IlyaBOT/LunarView3/Dumper-Lite/README.md

# Lunar Dumper

Отдельный минимальный проект **только для чтения NM27C512Q, 64 КиБ × 8, DIP-28**. Один лист A3 с обязательной обвязкой. Все цепи питаются от USB +5 В. Высокого напряжения и цепей программирования EPROM нет.

Откройте `NM27C512_Dumper_Lite.kicad_pro`, затем `NM27C512_Dumper_Lite.kicad_sch` или `NM27C512_Dumper_Lite.kicad_pcb`. Предпросмотр схемы — `NM27C512_Dumper_Lite.pdf`. Текущая сохранённая плата пользователя содержит 645 сегментов дорожек и 212 переходов. Проверка 12.10.2026 обнаруживает 2 неразведённые связи и 16 прежних предупреждений; переименование не изменило медные слои или геометрию. Подробный отчёт — `../validation/lunar-products-2026-10-12/dumper-drc.json`. Недостающие 3D-модели подключены непосредственно к основной плате. В 3D установлен квадратный SMD RGB 5050, альтернативный выводной RGB скрыт. [Предпросмотр](validation/Lite_With_3D.png). Для открытия проекта исходные файлы Stage 2 не нужны: локальные библиотеки и таблицы библиотек находятся в этой папке.

Новые материалы: [адаптер КР573РФ5](../Adapter-KR573RF5/README.md), [изготовление фоторезистом](../docs/PCB_Photoresist_RU.md), [источники 3D-моделей](../docs/3D_Models_RU.md). После пользовательских изменений актуальные диаметры и координаты переходов следует брать из текущей платы; перед домашним изготовлением проверяйте технологический образец. Координаты переходов и двухсторонних сквозных соединений — `validation/vias_for_hand_assembly.csv` и `validation/pth_two_sided_connections.csv`.

## Состав

| Обозначения | Назначение |
|---|---|
| U1 | ATmega328P-AU, TQFP-32 7×7 мм, шаг 0,8 мм |
| U2, U3 | Два 74HC595D, SOIC-16; адрес A0–A15 |
| U4 | CH340C, SOIC-16, внутренний генератор |
| U5 | Сокет NM27C512Q, DIP-28 600 mil, удлинённые площадки |
| J1 | MicroUSB-B, Molex 105017-0001 |
| J2 | AVR ISP, 2×3, шаг 2,54 мм |
| Y1, C11, C12 | Кварц 16 МГц, CL около 18 пФ; два конденсатора 22 пФ |
| R1, SW1, C13, D4 | RESET: 10 кОм, кнопка, 100 нФ от DTR#, BAT54WS ограничивает положительный выброс |
| R2, R3, R4 | 10 кОм: подтяжки CE#/OE# вверх и LATCH вниз |
| D1, R5–R7 | RGB: квадратный SMD KAAF-5050RGBS-13 или четырёхвыводной WP154A4SEJ3VBDZGW/CA; устанавливать один; по 1 кОм на цвет |
| D2, D3, Q1, Q2, R8–R11 | RX синий / TX оранжевый, буферы MMBT3906; база 10 кОм, LED 1 кОм |
| C1 | 10 мкФ / 10 В на USB +5 В |
| C2–C10 | По 100 нФ: CH340C VCC/V3, оба VCC и AVCC ATmega, AREF, два 595, EPROM |

Полный список с корпусами — `BOM.csv`. Резисторы и малые конденсаторы — 0603; C1 — 0805. USB VBUS подключён к +5 В напрямую, без отдельного предохранителя. Экран USB подключён к GND.

## GPIO ATmega328P-AU

| Сигнал | GPIO | Физический вывод TQFP-32 |
|---|---|---|
| ROM_D0…D5, только входы | PC0…PC5 | 23, 24, 25, 26, 27, 28 |
| ROM_D6 / D7, только входы | PD4 / PD5 | 2 / 9 |
| ROM_CE# / ROM_OE# | PD6 / PD7 | 10 / 11 |
| ADDR_LATCH | PB2 | 14 |
| ADDR_SER / MOSI | PB3 | 15 |
| ADDR_SCK / SCK | PB5 | 17 |
| ISP_MISO | PB4 | 16; используется только ISP |
| RGB: красный / зелёный / синий | PB0 / PB1 / PD2 | 12 / 13 / 32 |
| UART_RX / UART_TX | PD0 / PD1 | 30 / 31 |
| XTAL1 / XTAL2 | PB6 / PB7 | 7 / 8 |
| RESET | PC6 | 29 |
| VCC / AVCC | — | 4, 6 / 18; +5 В |
| GND / AREF | — | 3, 5, 21 / 20; AREF через C10 на GND |
| Не используются | PD3, ADC6, ADC7 | 1, 19, 22; явные NC |

## Адрес и данные

PB3 передаёт данные в SER U2; Q7S U2 подключён к SER U3. SRCLK обоих регистров подключён к PB5, RCLK — к PB2. SRCLR# подключён к +5 В, OE# — к GND. U2 Q0–Q7 формируют A0–A7; U3 Q0–Q7 — A8–A15. Сначала отправляется старший адресный байт U3, затем младший U2, в обоих случаях MSB first. После двух байтов нужен импульс LATCH.

RGB подключён к свободным выводам MCU, поэтому ему не нужен третий 595 и его состояние не зависит от обновления адреса. LOW включает цвет, HIGH выключает; при RESET выводы MCU высокоимпедансные, индикатор выключен. Предлагаемые значения для будущей прошивки: зелёный — чтение, жёлтый — ожидание, синий — ошибка. D1: логическая площадка 1 = R, 2 = общий анод +5 В, 3 = G, 4 = B. Комбинированный footprint содержит SMD 5050 и THT 5 мм места; **устанавливать только одно**. Физическая нумерация производителей отличается; подробности в [RGB_Mounting.md](../docs/RGB_Mounting.md).

RX/TX показывают фактические LOW-биты соответствующих UART-линий; при HIGH idle они выключены. Эмиттеры Q1/Q2 подключены к +5 В, базы — к UART через 10 кОм, коллекторы питают LED через 1 кОм. MMBT3906: B1/E2/C3. CH340C TXD, pin 2, подключён к MCU RX; CH340C RXD, pin 3, — к MCU TX.

Данные D0–D7 подключены к MCU напрямую, без буфера. Эта схема рассчитана на точный NM27C512: его даташит задаёт VOH не менее 3,5 В в режиме чтения. Для других 27xx нужно отдельно проверить распиновку, питание и логические уровни; совместимость по одному обозначению «27C512» не предполагается.

| DIP-28 | Сигнал | DIP-28 | Сигнал |
|---|---|---|---|
| 1 | A15 | 15 | D3 |
| 2 | A12 | 16 | D4 |
| 3 | A7 | 17 | D5 |
| 4 | A6 | 18 | D6 |
| 5 | A5 | 19 | D7 |
| 6 | A4 | 20 | CE/PGM# → ROM_CE# |
| 7 | A3 | 21 | A10 |
| 8 | A2 | 22 | OE/VPP → ROM_OE#, только логический OE |
| 9 | A1 | 23 | A11 |
| 10 | A0 | 24 | A9 |
| 11 | D0 | 25 | A8 |
| 12 | D1 | 26 | A13 |
| 13 | D2 | 27 | A14 |
| 14 | GND | 28 | +5 В |

CE# и OE# подтянуты к +5 В, поэтому в RESET/ISP EPROM не управляет шиной данных. LATCH подтянут к GND, чтобы тактирование SPI во время ISP не защёлкивало случайный адрес. При чтении прошивка должна держать D0–D7 входами, сначала выставить адрес, затем активировать CE#/OE#, дождаться доступа, считать байт и вернуть управляющие сигналы HIGH.

## ISP, RESET и питание

J2: **1 MISO / 2 +5 В / 3 SCK / 4 MOSI / 5 RESET / 6 GND**. Не подключайте два конкурирующих источника питания через USB и ISP. Для смены EPROM отключайте питание.

RESET подтянут к +5 В через 10 кОм, кнопка замыкает его на GND. CH340C DTR#, вывод 13, подключён через C13 100 нФ. D4: катод, площадка 1, на +5 В; анод, площадка 2, на RESET. AVCC обязательно подключён к +5 В, хотя ADC здесь не используется. CH340C не требует кварца 12 МГц; V3 подключён только к C3 100 нФ на GND.

Локальный символ `ProjectSymbols:CH340C_WCH` сохраняет подтверждённую нумерацию CH340C и исправляет обозначение функции pin 8 относительно установленной библиотеки KiCad. Pin 8 и другие неиспользуемые handshake-пины имеют NC. RGB D1 использует локальные символ `ProjectSymbols:RGB_CA_DualMount` и footprint `ProjectFootprints:RGB_CA_5050_or_THT5`; остальные посадочные места — из установленного KiCad.

## Проверка и воспроизводимость

KiCad **10.0.6**: ERC — **0 ошибок, 0 предупреждений**. Проверка экспортированного нетлиста и корпусов — **504 проверки пройдены**; всем 39 компонентам назначены существующие посадочные места с соответствующими номерами площадок. Одностраничный PDF просмотрен после окончательного экспорта.

Результаты ERC и проверки экспортированного нетлиста находятся в `validation/`. Команда `./validate.ps1` из этой папки автоматически находит установленный KiCad, выполняет ERC без пользовательских подавлений, экспортирует XML/PDF и проверяет соединения и соответствие выводов площадкам корпусов. Для повторной генерации из корня рабочего каталога: `python tools/generate_lite.py`; это перезапишет генерируемые файлы `Dumper-Lite/`, включая ручные правки схемы. Для текущей замены RGB регенерация не использовалась: остальные объекты сохранены.

Схема не испытывалась на собранной плате; чтение реального EPROM не проверялось. Для Lite теперь создана отдельная прошивка [firmware/lite](../firmware/lite/README.md), 115200 бод, `READ:<размер>`, и [WinForms-программа](../app-win_forms/README.md). Прежние файлы в корне `firmware/` относятся к Stage 2 и не подходят для Lite. Чтение реальной EPROM пока не проверено.

Первичные источники: [NM27C512 National, TL/D/10834](https://deramp.com/downloads/mfe_archive/050-Component%20Specifications/National%20Semiconductor/Memory%20Components/National%20NM27C512.pdf), [ATmega328P](https://ww1.microchip.com/downloads/aemDocuments/documents/MCU08/ProductDocuments/DataSheets/Atmel-7810-Automotive-Microcontrollers-ATmega328P_Datasheet.pdf), [CH340 WCH](https://cdn.sparkfun.com/assets/5/0/a/8/5/CH340DS1.PDF), [74HC595 Nexperia](https://assets.nexperia.com/documents/data-sheet/74HC_HCT595.pdf). Источники и монтаж двух новых RGB-корпусов: [RGB_Mounting.md](../docs/RGB_Mounting.md). Полная запись проверки источников сохранена в `../docs/sources.md`.

История размещения, 06.10.2026: на плате `NM27C512_Dumper_Lite.kicad_pcb` было выполнено размещение по предоставленному примеру: USB/CH340C и RX/TX слева, ATmega в центре, регистры перед сокетом справа, кварц/RESET и RGB снизу. Добавлены контур 90×60 мм со скруглением 2,5 мм и четыре отверстия 3,2 мм под M3. Все 39 электрических компонентов и идентификаторы/сети их площадок сохранены; добавлены только четыре механических footprint-объекта. У D1 по-прежнему два монтажных места с пометкой `ONE ONLY`. Пользователь затем изменил размещение и развёл плату.

Исторический DRC размещения: 0 нарушений / 0 расхождений и 134 неразведённые связи. [Вид размещения](validation/Placement_Top.png), [отчёт размещения](validation/PLACEMENT.md), `validation/drc_placement.json` и `validation/placement_audit.json`. Резервная копия платы перед размещением — в `validation/placement_backup/`; более ранние копии перед заменой RGB — в `../validation/rgb_upgrade_backup/`.

Текущая проверка 07.10.2026: **0 неразведённых связей**, 2 исключённых предупреждения (C3 отличается от библиотечной посадки, высота текста RGB) и 3 предупреждения сравнения со схемой из-за двух графических посадок без reference. Результат — `validation/drc_routed_2026-10-07.json`. После добавления 3D непосредственно к основной плате результаты DRC и геометрия сохранены; `../validation/3d_update_2026-10-07.json` подтверждает изменение только узлов моделей. Промежуточная копия до добавления моделей удалена при очистке 12.10.2026; две последние автоматические ZIP-копии KiCad сохранены. Собранное устройство не испытывалось.

Обновление 12.10.2026: текущая плата по проверке содержит 645 сегментов и 212 переходов, внешний габарит Edge.Cuts около 77,30×48,05 мм. Актуальные файлы для ЧПУ, расчёт K4-3W и координаты переходов — [docs/cnc-k4](../docs/cnc-k4/README.md). Числа выше с датой 07.10 относятся к предыдущему снимку.

DRC 12.10.2026: 2 незамкнутые связи между участками GND-полигона, 16 предупреждений; перед изготовлением нужна проверка этих участков. Отчёт `../validation/lite-software-2026-10-12/drc.json`. Исходный PCB при создании ПО/файлов ЧПУ не изменялся.
