IlyaBOT/LunarView3/docs/3D_Models_RU.md

# 3D-модели дампера — 07.10.2026

Добавлены модели недостающих физических деталей полной версии и Lite. В Lite остальные модели уже встроены в PCB как `kicad-embed://…`; их данные сохранены. Голые тестовые площадки, монтажные отверстия и графические логотипы не являются отдельными корпусными деталями и не требуют 3D-компонентов.

| Деталь | Файл | Источник / точность |
|---|---|---|
| MicroUSB Molex 105017-0001, J1 | `USB_Micro-B_Molex-105017-0001.step` | Модель именно этого номера из вклада lukh в [KiCad packages3D MR 566](https://gitlab.com/kicad/libraries/kicad-packages3D/-/merge_requests/566), commit `f7ff353b07291f4a78f9badf29abc5a1531e9952`. Вклад закрыт без включения в выпущенную библиотеку: модель не представляется штатной моделью текущего KiCad. Масштаб 1:1, исходное смещение/поворот нулевые; совмещение с площадками просмотрено. |
| Квадратный RGB 5050, Lite D1 / Stage 2 D2 | `LED_RGB_5050-6.step` | Модель шестиконтактного 5050 из установленного KiCad 10. Поворот модели 180° соответствует физическому расположению pin 1 у локальной посадки. Это типовой визуальный корпус, не точная заводская CAD-модель Kingbright KAAF. У модели ряд контактов ±1,7 мм, у выбранных производителем земель ±1,6 мм; модель не используется для проверки медных площадок. |
| Альтернативный RGB 5 мм, четыре вывода | `LED_D5.0mm-4_RGB.step` | KiCad 10, типовой выводной RGB. Смещение X = 6,595 мм совмещает первую ножку модели с первой физической THT-площадкой локального footprint. Модель отключена в текущем 3D-виде; монтажное место и его электрические соединения сохранены. |
| F1 в полной Stage 2 версии | `PPTC_1812_approx.wrl` | Созданный условный габаритный образ 1812, 4,5×3,2 мм, высота около 1,1 мм. Точная марка предохранителя в проекте не задана; высоту и другие механические размеры надо сверить после выбора детали. Не заводская модель. В Lite предохранителя нет. |

Новые файлы располагаются в `3DModels/` соответствующего проекта и подключены через `${KIPRJMOD}`, поэтому не зависят от отсутствовавшего USB-файла в системной библиотеке. Модели RGB и USB перенесены без изменения их исходной геометрии. Лицензия ветки-источника USB и стандартных моделей KiCad — **CC BY-SA 4.0 с исключением KiCad Libraries для электронных проектов**, текст сохранён рядом как `KiCad-LIBRARY-LICENSE.txt`. Для условных моделей указана их отдельная природа; они создаются локальными скриптами проекта.

## Переключение RGB

В 3D сейчас установлен **квадратный SMD 5050**, как выбрал пользователь. Чтобы посмотреть выводной вариант, откройте свойства D1 (Lite) или D2 (полная версия) → **3D Models**: выключите показ `LED_RGB_5050-6.step`, включите `LED_D5.0mm-4_RGB.step`. Установить на реальную плату нужно один LED из двух. Модели отображают сборку; электрическая нумерация и маркировка производителя описаны в `RGB_Mounting.md` каждого проекта.

## Сохранность платы

Изменения выполняются только в узлах `(model …)` сохранённых плат и локальной RGB-посадки. Дорожки, переходы, площадки, координаты компонентов, контур и пользовательская графика сравниваются как дерево KiCad до/после удаления узлов моделей. Отчёт — `validation/3d_update_2026-10-07.json`; промежуточные резервные копии до добавления моделей удалены при очистке 12.10.2026. В проектах оставлены две последние автоматические ZIP-копии KiCad.

Основной Lite обновлён после закрытия редактора: изменены только ссылки и параметры моделей, пользовательская разводка сохранена. [Предпросмотр Lite](../Dumper-Lite/validation/Lite_With_3D.png). Для продолжения работы используйте исходный проект в `Dumper-Lite/`.

Для адаптера RF5 стандартные DIP-24/TSSOP/0603 модели берутся из установленного KiCad. Его нижние круглые штыри показаны отдельной созданной габаритной моделью; размеры и конкретные контакты описаны в README адаптера.
