IlyaBOT/LunarView3/docs/RGB_Mounting.md

# RGB: два варианта монтажа на одной плате

В Stage 2 это узел **D2**, в `Dumper-Lite/` — **D1**. Один комбинированный footprint `ProjectFootprints:RGB_CA_5050_or_THT5` содержит оба набора площадок. **Устанавливать ровно один светодиод: SMD или выводной.**

| Вариант | Точный компонент | Корпус | Физическая распиновка производителя |
|---|---|---|---|
| SMD | Kingbright KAAF-5050RGBS-13 | Квадратный аналоговый RGB 5×5 мм, 6 площадок | 1=R катод, 2=G катод, 3=B катод; 4/5/6=аноды, все подключены к +5 В |
| Выводной | Kingbright WP154A4SEJ3VBDZGW/CA | RGB 5 мм, 4 вывода, общий анод | 1=R катод, 2=общий анод, 3=B катод, 4=G катод |

SMD выбран по [даташиту KAAF-5050RGBS-13, Rev.3B](https://www.kingbright.com/attachments/file/psearch/000/00/20160808bak/KAAF-5050RGBS-13%28Ver.3B%29.pdf): распиновка на стр.1, рекомендуемые площадки на стр.7. Выводной вариант проверен по [WP154A4SEJ3VBDZGW/CA, Rev.7A](https://www.kingbrightusa.com/images/catalog/SPEC/WP154A4SEJ3VBDZGW-CA.pdf), стр.1. Схемы соединений на этих страницах подтверждают полярность; порядок G/B у выводного компонента учтён отдельно.

## Как устроено посадочное место

Логические номера площадок KiCad сохраняют прежнюю распиновку RGB-узла: **1=R, 2=+5 В, 3=G, 4=B**. Номера физических ножек двух корпусов отличаются от этих логических номеров. На `F.Fab` нанесены метки `S1…S6` и `T1…T4` — это номера из даташитов. Точка на шелкографии отмечает SMD S1 справа внизу; скошенный угол самого SMD-корпуса должен быть слева внизу, у S6. Прямоугольная THT-площадка — T1, красный катод.

| Физическая площадка | Логическая площадка KiCad | Сеть |
|---|---|---|
| SMD S1 / THT T1 | 1 | RGB_R_K |
| SMD S2 / THT T4 | 3 | RGB_G_K |
| SMD S3 / THT T3 | 4 | RGB_B_K |
| SMD S4/S5/S6 / THT T2 | 2 | +5V |

SMD-площадки имеют размер 2,2×1,1 мм, межрядный шаг 1,6 мм и внутренний горизонтальный зазор 2,6 мм, по рекомендованному рисунку производителя. Для выводного варианта сделаны четыре отверстия 0,9 мм с шагом 1,27 мм. THT-площадки — 1,11×1,8 мм: минимальное кольцо меди 0,105 мм, зазор между соседними площадками 0,16 мм. Для этих четырёх площадок установлен локальный clearance 0,15 мм; изготовитель должен поддерживать такой зазор и кольцо. Размер сверления не уменьшался. Центры двух мест разнесены на 8,5 мм; площадки не перекрываются. На шелкографии указаны `SMD 5050`, `THT 5mm`, цвета выводов и `ONE ONLY`.

Общие резисторы по 1 кОм сохранены: Stage 2 R20–R22, Lite R5–R7. Аноды подключены к +5 В, LOW включает цвет. Выводы MCU, цепочка регистров, RGB-биты и прошивка управления цветами не меняются.

Нужно использовать именно аналоговые RGB с указанной полярностью и распиновкой. Светодиоды со встроенным контроллером, например WS2812/SK6812, к этим цепям не относятся. Суффикс **/CA** у выводного Kingbright важен: это выбранный вариант с общим анодом.

## Платы и проверка

При первоначальной замене RGB оба существующих файла `.kicad_pcb` были обновлены: D2/D1 заменён на комбинированное место, остальные footprints и их позиции сохранены. Более крупный RGB-узел смещён в ближайшее свободное место. Копии того этапа находятся в `../validation/rgb_upgrade_backup/`; отчёт `rgb_mount_audit.json` относится к состоянию до размещения Lite.

Затем на Lite выполнено размещение всех компонентов, добавлены контур 90×60 мм и четыре отверстия M3. Расположение полной платы Stage 2 сохранено. В обоих проектах исправлена ширина THT-площадок RGB и размер их шелкографических надписей. Проверка основной платы Lite: 0 нарушений DRC / 0 расхождений со схемой, 134 неразведённые связи. [Отчёт размещения](../Dumper-Lite/validation/PLACEMENT.md); копии до этих изменений — в `../Dumper-Lite/validation/placement_backup/`.

Платы до этого изменения не имели дорожек или контура, и полной разводки в этой задаче не выполнялось. **При разводке нужно физически подключить оба набора площадок ко всем четырём сетям, включая три SMD-анода +5 В.** Совпадающие логические номера площадок не заменяют медные дорожки между альтернативными местами. Соединения назначены всем десяти площадкам в обоих файлах платы.

KiCad 10.0.6 загрузил новую библиотеку и платы; ERC обеих схем — 0 ошибок / 0 предупреждений. Отдельная проверка `tools/audit_rgb_dual_mount.py` сверяет геометрию, полярность, сети площадок и сохранность всех остальных схемных/платных объектов. Проверки нетлистов и корпусов сохранены в соответствующих папках `validation/`.

Проектный символ `ProjectSymbols:RGB_CA_DualMount` использует тот же рисунок RGB и те же четыре логических вывода, что прежний индикатор. Сам footprint хранится в `ProjectFootprints.pretty/` каждого проекта и подключён через его `fp-lib-table`; глобальные библиотеки KiCad не изменялись.
