IlyaBOT/LunarView3/docs/cnc-k4/README.md

# Carverall K4-3W: подготовка Dumper Lite

Проверено 12.10.2026. Это расчёт и набор файлов для **пробной фотозасветки**, а не подтверждённый режим изготовления. Станок не подключался, фоторезист на 455 нм не испытывался.

## Характеристики и пределы достоверности

Пользователь указал K4-3W и 455 нм, [карточка Ozon](https://www.ozon.ru/product/carverall-k4-3w-mini-lazernyy-graver-dlya-dereva-kozhi-bumagi-tkan-dlya-podarkov-i-diy-3559348654/). Карточку станка получить не удалось: сайт возвращает цикл перенаправлений. Поэтому её параметры не выданы за проверенные.

В [официальной таблице Carverall](https://www.carverall.com/pages/machine-comparison) для K4Pro указаны диод 3 Вт / 450 нм, рабочее поле 80×80 мм и скорость 40 мм/с (2400 мм/мин). Официальная [страница продукта](https://www.carverall.com/products/carverall-k4pro-mini-laser-engraver) использует названия K4 и K4Pro. Это справочные данные близкой модели: точное совпадение ревизии с K4-3W из вашей покупки не доказано. Не переносите на неё автоматически максимальную скорость и параметры контроллера.

Для K4 производитель предлагает [CutLabX](https://www.carverall.com/pages/software). Размер оптического пятна, минимальная регулируемая мощность, частота/разрядность PWM, ускорение и прошивка именно вашего экземпляра не установлены. Рекламная «точность» не равна размеру пятна или воспроизводимому зазору после травления. Пятно надо измерять на проявленном пробнике в двух направлениях.

МФП-ВЩ негативный. [«Диазоний»](https://www.diazoniy.ru/fotorezist/) указывает для справочного материала МПФ-ВЩ диапазон 320–420 нм и энергию 150–180 мДж/см². **455 нм вне этого диапазона.** Энергия ниже рассчитана как падающая на поверхность, без неизвестного коэффициента фотохимической эффективности на 455 нм. Ни одна строка расчёта не доказывает отверждение вашего резиста. Сначала нужен успешный пробник после проявления и травления.

## Файлы именно текущей платы

Снимок `Dumper-Lite/NM27C512_Dumper_Lite.kicad_pcb`: SHA256 `1147f42970dd9abc639e3f89a14d58c3dbc842d9de7f9c65819ef65f327bd571`. Размер по внешней границе Edge.Cuts с учётом толщины линии: **77,30×48,05 мм**; 645 сегментов дорожек, 212 переходов. Минимальная дорожка 0,20 мм; 203 перехода имеют отверстие 0,30 мм и площадку 0,60 мм. Плата изменена пользователем после предыдущей проверки от 07.10, поэтому старые количества и координаты переходов применять нельзя.

- `Lite_F_Cu.svg`: верхний слой, чёрное = будущая медь.
- `Lite_B_Cu_mirrored.svg`: нижний слой, **уже отражён по горизонтали** для взгляда снизу после переворота вокруг вертикальной оси рисунка. Повторно отражать его не надо.
- `Lite_F_Cu_2540dpi.png` и `Lite_B_Cu_mirrored_2540dpi.png`: двуцветные растры 7730×4805 пикселей. Полотно обоих файлов одинаковое, 77,30×48,05 мм; 100 пикселей/мм. Все 255 проверенных центров электрических площадок на соответствующих слоях попали в чёрную медь. Это геометрическая проверка экспорта, не испытание станка.
- `Calibration_25x25.svg` / `Calibration_25x25_2540dpi.png`: пробник 25×25 мм. Сверху вниз четыре группы линий и зазоров: 0,20 / 0,25 / 0,30 / 0,40 мм. Слева горизонтальные, рядом вертикальные, справа площадка 0,60 мм и сплошной квадрат. Снизу ряд площадок с шагом 0,80 мм и ещё площадки 0,60 мм. Белый фон должен смыться, чёрные фигуры — остаться.
- `vias_for_hand_assembly.csv` и `pth_two_sided_connections.csv`: обновлённые координаты для этого снимка платы. Они абсолютные, как в KiCad, а не относительно угла PNG. Список контактов обеих сторон основан на концах дорожек и не заменяет проверку полигонов/доступа паяльником.
- `Preview_Top.png`: только просмотр, **не файл для записи рисунка**.

В SVG есть линии со stroke-width, которые некоторые CAM-программы превращают в тонкие осевые линии. Для заполнения через такую программу используйте готовые бинарные PNG. Не записывайте только контуры SVG: это не защитит площадь дорожек и полигонов.

В поле 80×80 мм рисунок 77,30×48,05 мм помещается с очень небольшим запасом по длинной стороне. Если реальное поле 80×75 мм, он тоже помещается в исходной ориентации. Для установки платы и фиксирующих штифтов проверьте физический доступ отдельно. Не уменьшайте изображение ради поля. При подтверждённом поле 80×80 мм можно повернуть **оба слоя одинаково на 90°**, чтобы растровые проходы шли вдоль короткой стороны и было больше места для разгона/выбега.

## DRC перед изготовлением

Проверка сохранённой платы 12.10.2026: **2 ошибки незамкнутого соединения между участками одного GND-полигона**, 16 предупреждений (15 изолированных заливок и один свободный конец GND-дорожки у X=71,425 / Y=84,750 мм). Соединений, отмеченных как незавершённые сигнальные дорожки, в этом отчёте нет. Полный результат: `validation/lite-software-2026-10-12/drc.json`.

Экспорт передаёт существующую геометрию, включая эти островки, и **не является утверждением «плата прошла DRC»**. До записи целой платы проверьте, какие островки должны соединяться с GND: соедините необходимые или исключите ненужные из заливки, выполните заполнение и DRC, затем заново экспортируйте слои. Наличие всей меди в PNG не доказывает связность. В этой задаче исходный PCB не изменён (контроль SHA256 совпал); файлы здесь — снимок для анализа и калибровки. Не используйте их после изменения разводки без повторного экспорта.

## Расчёт падающей энергии

Для равномерного заполнения с шагом строк `h`, скоростью `v` и средней оптической мощностью `P`:

`D [мДж/см²] ≈ 100 × P [мВт] / (v [мм/с] × h [мм])`.

Мощность условно считается линейной: `P = 3000 × процент / 100` мВт. Это допущение, пока мощность не измерена. На малом проценте лазер может вообще не включаться либо давать нелинейные импульсы. Поглощённая резистом энергия отличается от падающей.

При шаге **0,05 мм**, одном проходе:

| Скорость | Установленная мощность | Условная средняя мощность | Падающая доза |
|---|---:|---:|---:|
| 1000 мм/мин (16,67 мм/с) | 0,10% | 3 мВт | 360 мДж/см² |
| 1000 мм/мин | 0,25% | 7,5 мВт | 900 мДж/см² |
| 1000 мм/мин | 0,50% | 15 мВт | 1800 мДж/см² |
| 1000 мм/мин | 1,00% | 30 мВт | 3600 мДж/см² |
| 600 мм/мин (10 мм/с) | 0,10% | 3 мВт | 600 мДж/см² |
| 600 мм/мин | 0,25% | 7,5 мВт | 1500 мДж/см² |
| 600 мм/мин | 0,50% | 15 мВт | 3000 мДж/см² |
| 600 мм/мин | 1,00% | 30 мВт | 6000 мДж/см² |

Это **матрица эксперимента**, не восемь заведомо подходящих режимов. Для сопоставления: при 1000 мм/мин / 0,05 мм справочная УФ-доза 150–180 мДж/см² соответствовала бы всего 0,042–0,050% от 3 Вт. На 455 нм эти числа не являются рецептом. Полная мощность дала бы около 360 Дж/см², то есть в тысячи раз больше справочной УФ-дозы. Начинать с 100% и замедлять станок не следует.

Если контроллер имеет только 8-битный PWM, один ненулевой шаг — около 0,392%: строки 0,10% и 0,25% тогда могут быть недоступны. Изменение шкалы `S` или `$30` не добавляет аппаратных уровней. Не считайте показатель «1%» измерением света.

Калькулятор: `python docs/cnc-k4/laser_dose.py --power-w 3 --percent 0.1 --feed 1000 --pitch 0.05`. Он вычисляет только номинальную падающую дозу. При нескольких проходах энергия суммируется, но фотохимический результат и тепловые повреждения не обязаны меняться линейно.

## Порядок калибровки

1. Сначала подтвердите нанесение и проявление материала контрольным купоном через шаблон под прожектором 395 нм. Незасвеченный купон должен полностью очиститься. Без этих контролей нельзя понять причину неудачи лазера.
2. Проверьте поле/масштаб на безопасном тестовом материале с выключенным рабочим лазером при позиционировании. Для лазерной обработки меди нужен закрытый тракт: поверхность даёт опасные отражения. Подберите защиту по 455 нм и мощности; очки из комплекта без подтверждённых характеристик не считайте достаточными.
3. Нанесите резист на маленькие одинаковые купоны. Импортируйте пробник в масштабе **25×25 мм**, режим чёрно-белого заполнения: чёрное включает лазер, белое выключает. Без дизеринга, градаций серого, резки/обвода и второго автоматического прохода.
4. Начните с 1000 мм/мин, шага строк 0,05 мм и самого малого **реально регулируемого** уровня света. Строки 0,10 / 0,25 / 0,50 / 1,00% предназначены для разных купонов, если драйвер умеет их воспроизводить. Остановитесь при размягчении, пузырях, запахе разложения или прожоге. Вторая серия при 600 мм/мин нужна только если первая не повредила материал и недостаточная доза остаётся правдоподобной причиной.
5. Снимите верхний носитель, проявите по основной инструкции и протравите. Для принятия режима нужны сохранность линий 0,20 мм, открытые зазоры, сцепление с медью и отсутствие отверстий в рисунке. Изменение цвета без этих проверок не считается результатом.
6. Если минимальная аппаратная мощность уже повреждает плёнку либо ни один неповреждающий режим не закрепляет рисунок, **режим для этой пары лазер/резист не найден**. Не переходите к целой плате. Практический выход — источник подходящего спектра или материал с документированной чувствительностью на 455 нм; простое увеличение мощности не заменяет эту совместимость.

В CutLabX не переводите неизвестный ползунок «глубина» в мм/мин по догадке. Если программа не показывает физическую скорость и шаг строк, воспроизводимый расчёт по ней пока невозможен: нужны документация её режима или измерение параметров. Версия контроллера вашей покупки не подтверждена. Для **подтверждённого GRBL 1.1** режим `$32=1`, динамическая мощность `M4`, выключение `M5` и отсутствие света на холостом ходе описаны в [официальном руководстве GRBL](https://github.com/gnea/grbl/wiki/Grbl-v1.1-Laser-Mode). Эти команды не отправлялись вашему станку; для другой прошивки они могут не подойти.

## Перенос принятого режима на плату

Импортируйте PNG слоя как **77,30×48,05 мм**. Не принимайте автоматически размер «один пиксель = одна строка»: 2540 dpi описывает исходное изображение; выбранный шаг записи 0,05 мм соответствует 20 строкам/мм (508 dpi). Размер пятна и шаг записи проверяются отдельно от плотности исходного файла.

Будущая медь чёрная, включая всю площадь GND. Экспонируйте её заполнением, оставляйте белые промежутки незасвеченными. Отверстия в электрических площадках специально не вырезаны в рисунке, чтобы сохранить площадки при сверлении. Контур платы не включён как отдельная медная дорожка.

Оба слоя имеют одинаковое полотно и положение платы. Нижний уже отражён: переворачивайте заготовку вокруг оси, соответствующей вертикали исходных изображений. Для совмещения сделайте жёсткий упор и две технологические точки, проверьте на бумаге/пробнике контакты DIP и монтажные отверстия. При одинаковом повороте обоих файлов на 90° соответственно поверните и ось переворота в приспособлении. Во время обработки одной стороны закройте другую от случайного света. Не досвечивайте непроявленный рисунок целиком прожектором.

Поле плотно заполнено полигонами. При 1000 мм/мин и шаге 0,05 мм непрерывный растр всего прямоугольника требует примерно **74,3 минуты на сторону** без разгона, выбега и перемещений; фактически дольше. Эквивалентное время включённого лазера по чёрной площади составляет около 56,1 минуты сверху и 58,3 снизу. Это оценка геометрии, а не измеренная длительность задания. Выбег с каждой стороны должен быть не меньше `v²/(2a)` при ускорении `a`; без значения ускорения нельзя назначить его точный размер. Не используйте уменьшение масштаба для решения нехватки места.

После изготовления переходы требуют пайки с обеих сторон. Актуальные 212 переходов делают домашнюю сборку заметно трудоёмкой. Основная инструкция: [PCB_Photoresist_RU.md](../PCB_Photoresist_RU.md). Плата, адаптер, станок и прошивка на реальном комплекте ещё не испытаны.
