IlyaBOT/LunarView3/validation/lite-update-2026-10-12/REPORT.md

# Обновление Lite, 12.10.2026

## Результат

Пример ACE удалён из исходного и опубликованного каталога. Добавлены NM27C256 32768 байт и NM27C128 16384 байт; их VPP/PGM учитываются новым режимом PINS, объём не используется для неявного изменения адреса. В каталоге четыре записи. Документация изготовителей и ограничения: [rom_compatibility_lite.md](../../docs/rom_compatibility_lite.md).

Окно 1160×690, отступы 8 пикселей, внутренний заголовок и запрошенные лишние подписи удалены. HEX/ASCII сохраняются; во время чтения управление блокируется. Статус подключения, идентификатор устройства и ход операции показываются отдельно. [preview.png](../../app-win_forms/preview.png) — изображение реальной формы с явно обозначенными демонстрационными данными.

CON:START возвращает идентификатор и возможности Lite 2. При штатном отключении CON:STOP подтверждается до закрытия порта; при закрытии во время чтения отправляется STOP без ожидания ответа. Прошивка обрабатывает STOP во время HEX/CRC-передачи, отключает CE#/OE# и ждёт нового соединения. Неполный дамп не получает CRC. Если чтение ROM уже закончено и STOP приходит во время CRC, завершённая CRC-строка может предшествовать подтверждению STOP.

RGB: красный после RESET и STOP; янтарный в подключённом ожидании; чтение — зелёный 500 мс включён / 500 мс выключен. Для вопроса о цвете после STOP выбран красный, согласно состоянию «не подключено». Полный Stage 2 использует ту же логику: READ/VERIFY зелёный, WRITE фиолетовый. Изменения защёлки RGB выполняются с неактивными CE/OE/PGM и выключенным VPP; программирование и аппаратные защиты не включались. Полный протокол Stage 2 57600 сохранён, Windows Forms работает с Lite 2.

## Сборки и проверки

- dotnet Release и публикация приложения: успешно, без ошибок/предупреждений при сборке.
- MSBuild из Visual Studio 2022: EpromDumper.sln Release собран успешно.
- C# Core: 41 проверка — фрагментация CON/INFO, возврат полученного идентификатора, STOP, PINS, каталоги, ACK/HEX/CRC и имитированное чтение 1/2048/32768/65536 байт.
- UI: шесть элементов управления блокируются на операции; таблица доступна, неподтверждённый дамп сохранять нельзя.
- Нативный C: общий код размера, CRC, масок выводов и RGB, включая границы 499/500/999/1000 мс и переполнение счётчика времени.
- MSVC C++ /W4 /WX: 114719 проверок настоящего firmware/lite/main.c на имитации регистров. Проверены CON, запрет READ без соединения, actual GPIO RGB, все байты дампов 16/32/64 КиБ с CRC и адресными масками, STOP посреди HEX и CRC, отказ WRITE на Lite. Большая часть числа — отдельные проверки байтов дампа; это не физический тест.
- AVR-GCC 7.3.0 -Wall -Wextra -Werror: Lite Flash 2396 байт, статическая SRAM 93 байта (включает строковый буфер, не включает стек). Полный safe: Flash 4544 байта, SRAM 241 байт, HARDWARE_COMMISSIONED=0.
- Отдельная сборка с Rev. 7, Firmware 2.3.4, BuildId a8191hbz1 успешна. В ELF обеих сборок идентификатор найден в .text и отсутствует в .data; [identity.json](identity.json).
- SHA-256 Lite PCB остался прежним; трассировка не изменена. Хеши артефактов: [hashes.json](hashes.json).

Идентификатор итоговой Lite-сборки:

```text
CON:Lunar Dumper LITE (Rev. 1) | Firmware: v.1.0.0 (build 9e5241b8ac) 12.10.2026
```

## Повторение программных проверок

```powershell
dotnet run --project app-win_forms/Tests/EpromDumper.Tests.csproj -c Release
dotnet run --project app-win_forms/TestsUI/TestsUI.csproj -c Release
powershell -ExecutionPolicy Bypass -File firmware/lite/build.ps1
powershell -ExecutionPolicy Bypass -File firmware/build.ps1
```

Нативные исходники: tests/lite_protocol_native.c и tests/lite_firmware_host.cpp. Для C++ нужен include tests/avr_host, компиляция /EHsc /std:c++17. Заголовки tests/avr_host и объекты fake GPIO/UART предназначены только для теста на ПК, в AVR-сборку не входят.

## Граница проверки

COM-порт устройства не открывался, ISP/fuses не записывались. Тесты не моделируют электрические уровни, реальные времена UART/SPI/CPU и поведение физической EPROM/адаптера. CRC и программная модель не заменяют испытание собранной платы на известном содержимом ROM.
