IlyaBOT/LunarView3/validation/lunarview3-status-2026-10-12/REPORT.md

# LunarView 3 — версия 1.2, 12.10.2026

Нижняя панель заменена одной строкой высотой 22 пикселя: информация об устройстве, разделитель, статус. После отключения информация очищается. Полный текст устройства и ошибки доступен в подсказке. Ошибки чтения и CRC остаются видимыми после завершения операции и закрытия соединения. Статусы записи и стирания подготовлены для будущей версии программатора; эти операции не реализованы в LITE.

Размеры ROM и открытого файла отображаются как `65 536 байт (64КиБ/512КБит)`. Метаданные версии приложения обновлены до 1.2 (AssemblyVersion/FileVersion 1.2.0.0), окно «О программе» использует те же метаданные.

Проверки:

- VS2022 MSBuild Release с восстановлением зависимостей: успешно.
- Core tests: 62 проверки прошли, включая размер 64/32/2 КиБ и дробный размер.
- WinForms tests: 113 проверок прошли, включая чтение, сравнение, CRC, обрыв соединения, сохранение ошибки после разблокировки управления, статусы записи/стирания и состав нижней панели.
- Реальная форма отрисована размером 890×690; верхняя строка инструментов, 16 HEX-столбцов и ASCII помещаются без горизонтальной прокрутки. Скриншот: `../../app-win_forms/preview.png`, проверен визуально.
- Готовая сборка опубликована в `../../app-win_forms/release/`; пользовательский `rom-chips.list` сохранён без изменения байтов.

Поток устройства имитирован в тестах. Физический дампер и COM-порт в этом обновлении не проверялись. Прошивка и KiCad-платы не изменялись.
