IlyaBOT/LunarView3/docs/PCB_Photoresist_RU.md

# Изготовление платы Dumper Lite методом фоторезиста

Обновлено 12.10.2026 для текущей платы `Dumper-Lite/NM27C512_Dumper_Lite.kicad_pcb`, проверенной 12.10.2026. В ней два слоя меди, 645 сегментов дорожек и **212 переходных отверстий**. Минимальная ширина дорожки — 0,20 мм. **203 из 212 переходов** имеют отверстие 0,30 мм с площадкой 0,60 мм; остальные — 2 отверстия 0,65 мм, одно 0,80 мм и 6 отверстий 0,85 мм. Габарит по Edge.Cuts с толщиной линии — 77,30×48,05 мм. Перед домашним изготовлением нужен пробник с такой же геометрией. Числа и координаты от 07.10 относятся к прежней версии платы.

Ваш материал — **негативный плёночный МФП-ВЩ 200×1000 мм** из [указанной карточки Ozon](https://www.ozon.ru/product/fotorezist-plenochnyy-mfp-vshch-200h1000mm-negativnyy-m-2069010370/). Источники света: светодиодный УФ-прожектор **395 нм** и рассматриваемый для прямой записи лазер ЧПУ **455 нм**. Вы выбрали прямую запись лазером Carverall K4-3W. Расчёт, пробник и готовые слои текущей платы находятся в [cnc-k4/README.md](cnc-k4/README.md); совместимость резиста с 455 нм пока требует испытания. Контактная засветка 395 нм остаётся способом проверить нанесение/проявление на контрольном купоне.

В карточке диапазон указан неодинаково: 320–400 нм в таблице и 320–420 нм в описании процесса. Производитель «Диазоний» для материала МПФ-ВЩ указывает 320–420 нм; на его странице встречается также написание МФП-ВЩ. **395 нм входит во все эти диапазоны, 455 нм — за их пределами.** Производитель конкретно вашего рулона карточкой не установлен: данные «Диазония» используются как справочные, а не как подтверждение происхождения покупки. См. [первичный источник](https://www.diazoniy.ru/fotorezist/).

Облучённость платы, расстояние до прожектора и марка зелёной маски пока неизвестны. Поэтому точное время засветки и отверждения маски не назначено. Паяльная маска наносится после травления и проверки меди; она не заменяет фоторезист.

## 1. Что подготовить

- Двусторонний фольгированный стеклотекстолит, желательно с медью 35 мкм, толщиной, указанной в проекте платы. Одностороннюю заготовку нельзя использовать без переработки разводки.
- Фоторезист, подходящий проявитель и средство снятия фоторезиста. Не подменяйте проявитель произвольной щёлочью: кальцинированная сода и каустическая сода — разные вещества.
- Прозрачную плёнку **для конкретного типа принтера**, обезжириватель, безворсовые салфетки, мелкий неабразивный/слабоабразивный материал для очистки меди.
- Ламинатор либо способ нанесения, разрешённый изготовителем резиста, ровное прозрачное прижимное стекло, зажимы и плоскую подложку.
- Готовый травитель с инструкцией, отдельную неметаллическую ванночку, воду для промывки, отдельные ёмкости для отработанных растворов.
- Мини-дрель/сверлильную стойку, подходящие свёрла, лупу, мультиметр, паяльник, флюс и тонкую медную проволоку.
- Перчатки и защиту глаз; закрытый УФ-экспонирователь или непрозрачный экран. Не смотрите непосредственно на УФ-источник. Стеклотекстолит режьте и сверлите с удалением пыли. Ёмкости для химии не используйте для еды; медьсодержащий травитель собирайте отдельно, не сливайте в канализацию.

## 2. Проверить проект и распечатать фотошаблоны

Работайте с сохранённым файлом из `Dumper-Lite`, а не с полной Stage 2 платой в корне: у полной версии ещё нет законченного контура и разводки. Перед экспортом запустите DRC и проверьте неразведённые цепи. Проверка 12.10.2026 нашла 2 незамкнутые связи между участками GND-полигона и 16 предупреждений (изолированные заливки и свободный конец GND-дорожки). До изготовления проверьте эти участки, заполните зоны и повторите DRC. Отчёт: `validation/lite-software-2026-10-12/drc.json`; описание в [cnc-k4](cnc-k4/README.md).

В KiCad откройте **File → Plot**. Выведите `F.Cu` и `B.Cu` отдельными файлами SVG или PDF, с масштабом **1:1**, без рамки/основной надписи и без шелкографии. Контур `Edge.Cuts` можно добавить как ориентир, но он не должен превращаться в замкнутое медное кольцо на рабочем фотошаблоне. Для ручного сверления удобны небольшие метки центров отверстий; большой белый круг сверления на шаблоне уменьшает медную площадку. Отдельно выведите карту сверления и `F.Mask` / `B.Mask`, если ваша маска поддерживает проявление через шаблон.

В редакторе печати отключите «вписать в страницу», поля, колонтитулы, автоматическое масштабирование и экономию тонера. SVG сначала откройте в программе, сохраняющей физические миллиметры. PNG/JPEG или снимок экрана не являются точным фотошаблоном. Напечатайте калибровочный отрезок 50 мм и проверьте линейкой. Между рядами контактов EPROM должно быть 15,24 мм, шаг вдоль ряда — 2,54 мм. Проверьте масштаб по обеим осям после полного высыхания плёнки.

### Полярность

| Материал | Что происходит после засветки | Изображение для сохранения дорожек |
|---|---|---|
| Негативный плёночный резист | Засвеченное остаётся после проявления | Дорожки и площадки **прозрачные**, вытравливаемые области **чёрные** |
| Позитивный резист | Засвеченное удаляется проявителем | Дорожки и площадки **чёрные**, вытравливаемые области **прозрачные** |

Для **печатного фотошаблона** обычный чёрный рисунок дорожек из KiCad нужно инвертировать для негативной плёнки. Инвертируйте только рабочую область шаблона, сохраняя понятные метки совмещения вне контура. Проверьте полярность на пробном кусочке: после проявления защитный рисунок должен покрывать именно будущую медь.

### Зеркальность и совмещение двух сторон

Краска/тонер должны находиться **ближе всего к фоторезисту**, чтобы толщина прозрачной плёнки не размывала края. Это требование определяет зеркальность печати. Нельзя универсально поставить галочку «зеркально» на обоих слоях: она зависит от того, в каком виде экспортирована нижняя сторона и как вы переворачиваете плёнку.

1. Подпишите вне платы `TOP` и `BOTTOM`, отметьте положение первого вывода EPROM и USB-разъёма.
2. На бумажном пробнике приложите детали либо их посадки, повернув шаблон печатной стороной к предполагаемой меди. Сверьте положение pin 1 и асимметричных площадок. Нижний рисунок проверяйте, перевернув плату как реальный предмет.
3. Сложите два прозрачных шаблона в «конверт», печатными сторонами внутрь. Совместите **отверстия сквозных площадок**, все четыре монтажных отверстия и контур на просвет. Закрепите два края скотчем вне рабочей области.
4. Если нужна фиксация штифтами, сделайте два технологических отверстия вне конечного контура платы. Сначала проверьте их на бумаге; не используйте произвольные отверстия внутри схемы.

## 3. Какой принтер использовать

**Струйный:** используйте плёнку с покрытием для струйной печати, печатайте на её принимающей стороне. Выберите максимальное качество и режим материала, который даёт ровный непрозрачный чёрный слой; отключите экономичный режим. Высушите полностью. Обычная гладкая лазерная плёнка может не удерживать чернила.

**Лазерный:** используйте только термостойкую плёнку для лазерного принтера. Струйная плёнка может повредить печку. Отключите экономию тонера, выберите высокую плотность чёрного и разрешение. Проверьте, не изменил ли нагрев размеры изображения.

Для обоих вариантов посмотрите чёрные области на просвет через лупу: нужны плотность без точечных просветов и чёткие края 0,20 мм. Проверьте фактическое пропускание на УФ-пробнике, поскольку видимая чернота сама по себе этого не доказывает. Два совмещённых отпечатка допустимы только после проверки: они повышают плотность, но добавляют зазор и риск смещения мелких элементов. Сначала попробуйте один качественный отпечаток каждым принтером и выберите по результату проявления/травления.

## 4. Подготовить медь и нанести резист

1. Вырежьте заготовку с запасом по краям для совмещения. Уберите заусенцы: они мешают плотному прижиму и повреждают резист.
2. Очистите обе стороны до ровной поверхности без глубоких царапин. Обезжирьте, промойте и высушите. После этого берите за края, не касаясь меди пальцами.
3. Работайте при освещении, разрешённом для резиста, без солнца и УФ.
4. У МФП-ВЩ снимите нижнюю полиэтиленовую разделительную плёнку, приложите активный слой к меди без пузырей и прогрейте по инструкции к рулону. Верхнюю полиэфирную плёнку оставьте для экспонирования и снимите перед проявлением. Для справочного материала «Диазония» толщины слоёв: резист 50 мкм, верхний полиэфир 20 мкм, нижний полиэтилен 35 мкм.
5. Нанесите резист на вторую сторону, удалите пузыри и дайте заготовке остыть до температуры шаблонов. Не продолжайте с пузырями над дорожками или площадками.

Продавец в карточке рекомендует после нанесения прогреть всю поверхность резиста до **110 °C**, но не задаёт длительность и скорость прокатки. Это температура поверхности, а не универсальная настройка любого ламинатора. Сначала проверьте нанесение на маленьком образце; время нагрева без инструкции не назначайте. Не пытайтесь получить эту температуру увеличением мощности лазера.

Для готового позитивного текстолита ламинирование пропускается; защитную плёнку снимают по его инструкции. Жидкий позитивный резист требует собственной процедуры нанесения и сушки.

## 5. Засветка вашим прожектором и проверка лазера

### 5.1. Выбор источника

| Источник | Что известно для этого материала | Практический выбор |
|---|---|---|
| Прожектор 395 нм | Длина волны внутри диапазонов, указанных продавцом и «Диазонием» | Контактная засветка через печатный шаблон после подбора дозы |
| Лазер ЧПУ 455 нм | Вне заявленных диапазонов; чувствительность на 455 нм не подтверждена | Только эксперимент на пробнике, до изготовления платы |

Отсутствие 455 нм в диапазоне не доказывает абсолютно нулевую чувствительность. Однако рассчитывать на такую запись нельзя без проверки: повышение мощности не меняет длину волны и может нагреть или повредить плёнку раньше, чем получится стойкий рисунок. УФ-источник для стирания EPROM около 254 нм также не заменяет подходящий экспонирователь.

### 5.2. Как определить время для 395 нм

На странице «Диазония» приведена энергия экспонирования **150–180 мДж/см²**. Указанные там и в карточке секунды относятся к условиям испытания источника; это **не готовое время для вашего прожектора**. Паспортная электрическая мощность лампы не сообщает, сколько света достигает каждого квадратного сантиметра платы.

Если есть подходящий радиометр, измерьте облучённость в плоскости платы с учётом стекла и прозрачных материалов. Оценка времени:

`t [с] = D [мДж/см²] / I [мВт/см²]`.

Например, для справочной дозы 150–180 мДж/см² при 1 мВт/см² получается 150–180 с, а при 5 мВт/см² — 30–36 с. Это примеры расчёта, **не измерение вашего источника и не гарантированный режим на 395 нм**: спектр и условия заводской оценки могут отличаться. Обычный люксметр для видимого света не заменяет УФ-радиометр.

Без измерителя подбирайте время ступенчатым пробником при постоянном расстоянии и одинаковом прижиме. Начальный диапазон возьмите из инструкции к рулону для сопоставимого источника, если она есть. Если нет, исследуйте времена в отношении 1 : 2 : 4 : 8 и сдвигайте диапазон по результату проявления. Абсолютное время без данных о прожекторе здесь не назначается. Запишите расстояние, время, стекло, тип печатной плёнки и режим проявления.

### 5.3. Пробник, который должен пройти до изготовления платы

1. Сделайте рисунок с дорожками **и зазорами** 0,20 / 0,25 / 0,30 / 0,40 мм, площадками SMD и площадками переходов диаметром 0,60 мм. Добавьте полностью прозрачный и полностью чёрный участки шаблона для проверки засветки и её блокировки.
2. Нанесите плёнку из того же рулона тем же способом, что на плату. Разные дозы задавайте на отдельных участках или купонах; сохраняйте расстояние, прижим и режим проявления.
3. Проявите **и протравите** пробник. Выберите режим, при котором дорожки держатся, зазоры полностью открыты, а площадки сохраняют размер. Цвет плёнки после засветки сам по себе ничего не подтверждает.
4. Проверьте выбранное время также в центре и у краёв освещаемой площади: прожектор может давать неравномерную засветку. В случае неудачи меняйте по одному параметру — сначала дозу, затем прижим/непрозрачность или проявление.

Продавец заявляет получение дорожек и зазоров **0,24 мм** при хорошем шаблоне и свете. Это не подтверждает воспроизведение ваших дорожек 0,20 мм. Заводской справочный параметр минимального расстояния 120 мкм также не гарантирует домашний результат. **Не переходите к целой плате, пока пробник 0,20 мм не выдержит проявление и травление.** Затем проверьте сверление площадки 0,60 мм сверлом 0,30 мм.

При недодержке негативные дорожки смываются. При лишней дозе, засветке через неплотный чёрный слой или плохом контакте зазоры могут зарасти. Если ни одно время не даёт чистого рисунка, сначала исправьте контакт/шаблон и нанесение; увеличение времени не исправляет все дефекты.

### 5.4. Если испытывать прямую запись лазером 455 нм

Сначала получите рабочий контрольный образец с прожектором 395 нм. Сравнивайте лазерные купоны с ним и с незасвеченным купоном, используя один рулон и одинаковый проявитель: так можно отличить неподходящую длину волны от проблем нанесения или химии.

- Сделайте небольшую матрицу режимов мощности и скорости. Записывайте параметры; проценты мощности без модели лазера и фактической оптической мощности не переводятся в дозу. Начинайте с режима без заметного нагрева/повреждения; не повышайте мощность вслепую ради изменения цвета.
- У негативного резиста лазер должен засветить **всю будущую медь**: дорожки, площадки и всю площадь GND-полигонов. Простого обвода контуров недостаточно. На вытравливаемых промежутках и холостых перемещениях лазер должен быть выключен. Полярность цвета в программе задайте по этому правилу; инверсия печатного шаблона не является универсальной командой для ЧПУ.
- Используйте геометрию 1:1 из векторных файлов слоёв, без скриншотов, фотографического растра и дизеринга. Проверьте реальные 2,54 мм между контактами и обе оси масштаба. Сплошные полигоны требуют заполнения площади и могут сильно увеличить время записи.
- Проверьте фактическую ширину экспонированной линии, фокус в плоскости резиста под верхней плёнкой, люфт станка и шаг заполнения. Размер светового пятна не равен автоматически ширине получившейся дорожки. Подберите перекрытие проходов на пробнике, не допуская пропусков и зарастания зазоров.
- Критерий успеха — устойчивый рисунок после **проявления и травления**, с открытыми зазорами и без отслоения. Прожжённая, вспененная или потемневшая плёнка не считается успешной фотозасветкой.
- Для второй стороны нужны повторяемый переворот, две метки/технологические штифты и проверка pin 1. Сначала проверьте совмещение на бумажном макете и пробнике.

**Не досвечивайте всю ещё не проявленную плату прожектором после лазера:** у негативного материала это закрепит фон, который должен смыться. Любое окончательное отверждение после проявления выполняется только по инструкции к материалу.

Медь отражает лазерный свет. Работайте с закрытым оптическим трактом; защита глаз должна соответствовать 455 нм и мощности лазера, обычные затемнённые очки не подходят. Принципы защиты от прямого и отражённого луча приведены в [материале OSHA по лазерной безопасности](https://www.osha.gov/enforcement/directives/std-01-05-001).

### 5.5. Засветка двух сторон

После успешного пробника экспонируйте стороны платы в закреплённом конверте либо по проверенной системе фиксации ЧПУ. При засветке одной стороны закрывайте другую непрозрачным материалом от света и отражений. При перевороте сохраняйте совмещение. Для контактного способа плотно прижимайте печатную сторону шаблона к верхней плёнке резиста.

## 6. Проявить, проверить и протравить

1. Перед проявлением МФП-ВЩ снимите верхнюю полиэфирную плёнку. Для купленного материала продавец указывает **1% раствор кальцинированной соды, Na₂CO₃**. Для безводного порошка практический ориентир — 10 г на 1 л готового раствора (приблизительно 1%); не переносите эту массу на кристаллогидрат без пересчёта. Пищевая сода NaHCO₃ и каустическая сода NaOH не являются заменами. «Крот» и другие средства для труб не используйте как проявитель. Температура и длительность в карточке не заданы — проверяйте их по инструкции к рулону и на пробнике.
2. Проявляйте с мягким движением раствора. Остановитесь, когда открытые участки меди полностью очищены, а защищённые дорожки сохраняются. Тонкая невидимая плёнка в зазорах мешает травлению.
3. Промойте обе стороны, осмотрите через лупу. Исправляйте только локальные дефекты совместимым травостойким средством. При неверной полярности, широких смещениях или массовых дефектах снимите резист и повторите нанесение.
4. Для этого материала продавец рекомендует хлорное железо; для первого опыта используйте готовый травитель на его основе по инструкции к раствору. Не подменяйте этот режим случайной смесью перекиси и кислоты. Травите обе стороны по инструкции к травителю. Поддерживайте разрешённую температуру и мягкое перемешивание. Следите за узкими зазорами и не оставляйте плату в растворе после удаления ненужной меди: боковой подтрав съедает тонкие дорожки.
5. Промойте, снимите резист предназначенным для него средством, снова промойте и высушите. Не переносите режим снятия одной марки на другую.

## 7. Сверление и проволочные переходы

**Да, тонкую медную проволоку можно использовать вместо металлизации переходных отверстий.** Каждое такое соединение нужно припаять **к верхней и нижней площадке**. Проволока должна быть голой либо лужёной. У эмалированной проволоки предварительно снимите изоляцию в местах пайки и проверьте лужение; одной надежды на обгорание эмали недостаточно.

| Отверстие в проекте | Практический ориентир |
|---|---|
| 0,30 мм, площадка 0,60 мм | Проволока около 0,15–0,20 мм, точное сверление 0,30 мм. Это наиболее трудные переходы; сначала проверьте пробник. |
| 0,65 / 0,80 / 0,85 мм | Часто удобна проволока 0,30–0,50 мм, свободно проходящая через отверстие. Выбирайте по измеренному диаметру и доступу для пайки. |

**Не рассверливайте отверстие 0,30 мм до 0,60–0,80 мм на исходной площадке 0,60 мм:** медного кольца не останется. Для увеличения отверстия надо увеличить площадку, проверить соседние дорожки и заново выполнить DRC в отдельной копии платы. Сохранённая разводка в этом задании не изменялась.

Сверлите после травления, до маски и монтажа. Центруйте сверло по меткам, используйте стойку и ровную подложку. Проверьте совмещение слоёв по сохранности колец с обеих сторон. Припаяйте проволоку с первой стороны, затем со второй, обрежьте выступы и оставьте низкие гладкие швы. Не вытягивайте уже припаянную проволоку: можно оторвать площадку. Прозвоните каждый переход.

Переходы под микросхемами и другими корпусами выполняйте **до установки этих деталей**, с минимальными выступами. Толстая капля припоя может поднять SMD-корпус или замкнуть его выводы. Список координат переходов находится рядом с платой: `docs/cnc-k4/vias_for_hand_assembly.csv`. Координаты абсолютные, в миллиметрах, как в KiCad; столбец возможных пересечений с посадками служит подсказкой для ручной проверки по Fab-слоям.

### Сквозные выводы деталей тоже могут соединять слои

Без заводской металлизации вывод DIP-панельки, ISP, кнопки или кварца соединяет слои только после пайки к обоим кольцам. Пайка снизу не соединяет верхнюю дорожку автоматически. Проверьте такие места по `docs/cnc-k4/pth_two_sided_connections.csv` и непосредственно в KiCad.

Под тесно прилегающей панелькой верхнее кольцо часто недоступно паяльнику. Продумайте это **до монтажа**: примените подходящие металлизационные заклёпки, панельку с доступом к верхним контактам/небольшим подъёмом либо заранее предусмотренные проволочные соединения соответствующих цепей. Простой провод в отверстии, которое затем занято выводом панельки, не всегда помещается и мешает посадке. Проверяйте реальную сборку на образце.

Для RGB выбран SMD 5050. Неиспользованные четыре THT-площадки можно оставить без LED, но если ваша разводка использует их как переходы между слоями, эти электрические переходы всё равно надо выполнить. Не сверлите/не удаляйте их автоматически. У THT RGB отверстия 0,90 мм и очень узкое медное кольцо по короткой стороне площадки — около 0,105 мм; точность сверления здесь особенно важна.

## 8. Проверка меди до маски

Осмотрите все дорожки и площадки под лупой. Мультиметром проверьте целостность цепей по схеме, каждый проволочный переход и отсутствие соединений между соседними дорожками. Уберите медные иголки, мостики и металлическую стружку. Маска скроет дефекты и усложнит ремонт, поэтому наносите её только после этой проверки.

## 9. Зелёная жидкая паяльная маска

Сначала определите её тип по этикетке. УФ-отверждаемая ремонтная маска, фотопроявляемая LPI-маска и термоотверждаемая маска имеют разные процессы. Нельзя считать любую зелёную жидкость материалом для фотошаблона.

- **Маска для локального УФ-отверждения без проявления:** наносите тонко на промежутки/дорожки, оставляя паяемые площадки открытыми. Остатки до засветки убирайте средством, указанным производителем. Не покрывайте всю плату в надежде затем проявить площадки.
- **Фотопроявляемая маска:** следуйте её порядку нанесения, предварительной сушки, экспонирования, проявления и окончательного отверждения. Используйте отдельные шаблоны по `F.Mask` и `B.Mask`, с правильной полярностью для этой марки. Медь и паяльная маска требуют разных шаблонов.

Не покрывайте контакты USB, ISP, DIP-панельки, SMD-площадки и точки будущего ремонта. Для самодельных переходов оставьте доступ до завершения прозвонки; затем их можно закрыть совместимой маской. Если изготовитель разрешает прижимную плёнку для выравнивания, применяйте подходящую прозрачную плёнку и прокладку, не сдвигая отверстия шаблона. Полностью отверждённый пробный слой должен сохраняться при пайке и очистке разрешённым средством. Дозу/время отверждения нельзя назначить без марки маски и параметров лампы.

## 10. Монтаж и первое включение

Сначала выполните переходы и труднодоступные двухсторонние соединения, затем SMD, проверьте питание и только после этого ставьте панельки/крупные детали. Для двухслойной домашней платы этот порядок важнее обычного правила «сначала низкие детали».

Без EPROM проверьте отсутствие замыкания +5V–GND, полярность питания, RESET и правильность ориентации корпусов. Первое питание подайте от источника с ограничением тока, соблюдая имеющуюся в схеме развязку USB-питания; не соединяйте параллельно два независимых источника. Проверьте 5 В и отсутствие нагрева. Прошейте ATmega через ISP, затем проверьте USB/UART. EPROM вставляйте при выключенном питании. Адаптер КР573РФ5 использует только чтение на 5 В.

## Источники и границы инструкции

Параметры конкретной покупки взяты из [карточки продавца МФП-ВЩ, артикул 2069010370](https://www.ozon.ru/product/fotorezist-plenochnyy-mfp-vshch-200h1000mm-negativnyy-m-2069010370/), прочитанной 08.10.2026. Справочные характеристики материала МПФ-ВЩ: [«Диазоний», производитель сухого плёночного фоторезиста](https://www.diazoniy.ru/fotorezist/). Написания МФП/МПФ и диапазоны в источниках отличаются; состав и производитель вашего рулона отдельно не подтверждены. Чувствительность на 455 нм источниками не установлена.

Процедура адаптирована к проверенной геометрии проекта от 12.10.2026. Общие принципы качества контакта фотошаблона, соответствия УФ-источника материалу и подбора экспозиции описаны в [DuPont Riston General Processing Guide](https://www.dupont.com/content/dam/electronics/amer/us/en/electronics/public/documents/en/DEC-Riston_GeneralProcessingGuide.pdf). Это промышленный материал; его численные режимы не перенесены на ваш рулон МФП-ВЩ. Отличия позитивного процесса показаны в [MG Chemicals PCB Prototyping](https://mgchemicals.com/downloads/pdf/proto-letter-v4.pdf). Настройки вывода слоёв и масштаба: [руководство KiCad 10, PCB Editor](https://docs.kicad.org/10.0/en/pcbnew/pcbnew.html).

Это технологическая инструкция, а не подтверждение изготовления: пробник, ручная металлизация и собранный дампер ещё не испытаны. Если ваш пробник не воспроизводит дорожки/зазоры 0,20 мм и отверстия 0,30 мм, исходную плату нужно заказать с металлизацией либо подготовить отдельный вариант под более грубый домашний процесс.
