IlyaBOT/LunarView3/Adapter-KR573RF5/validation/Schematic.png

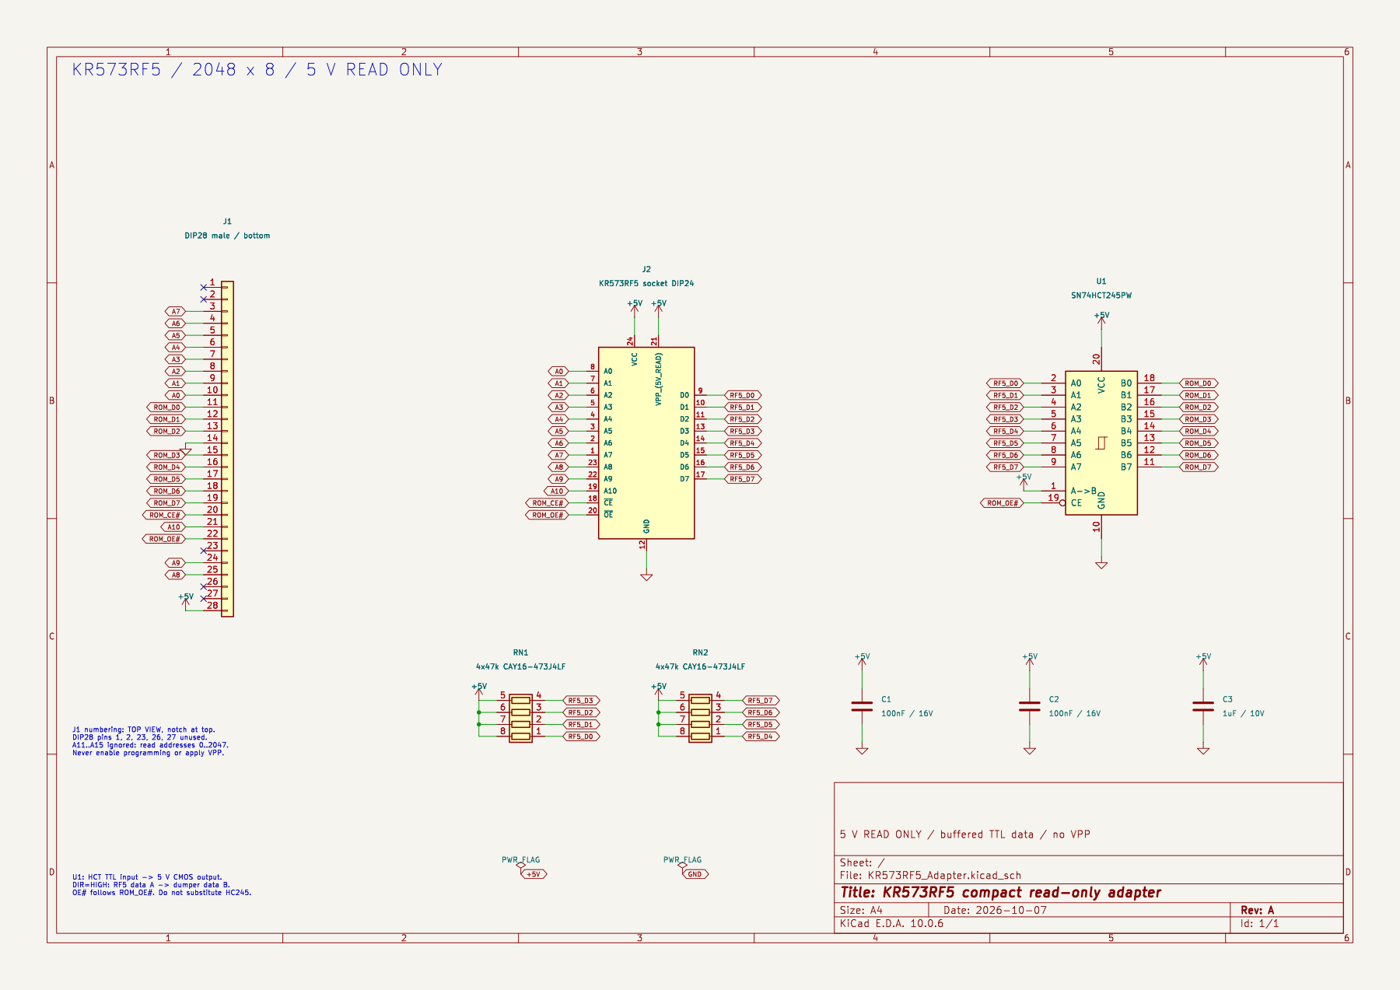
Adapter-KR573RF5/validation/Schematic.png
