IlyaBOT/LunarView3/app-win_forms/about-preview.png

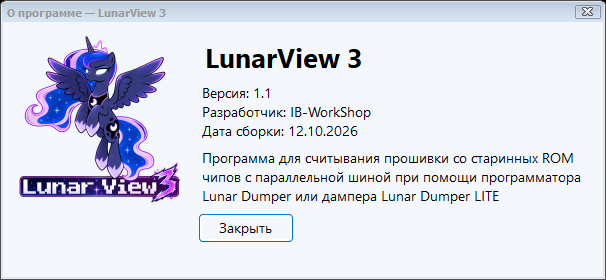
app-win_forms/about-preview.png
