IlyaBOT/LunarView3/app-win_forms/preview.png

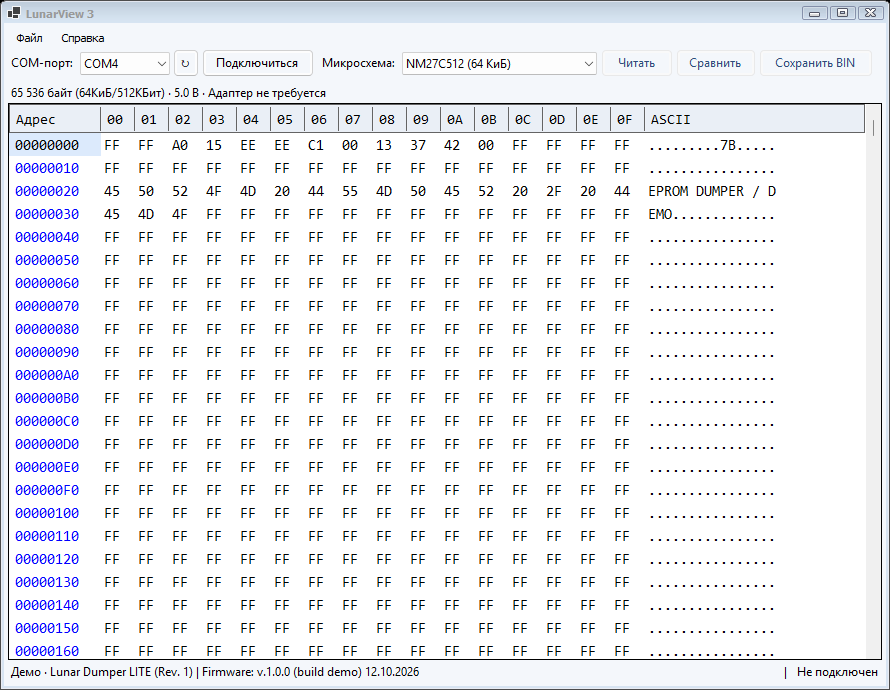
app-win_forms/preview.png
