IlyaBOT/LunarView3/docs/cnc-k4/Lite_B_Cu_mirrored_2540dpi.png

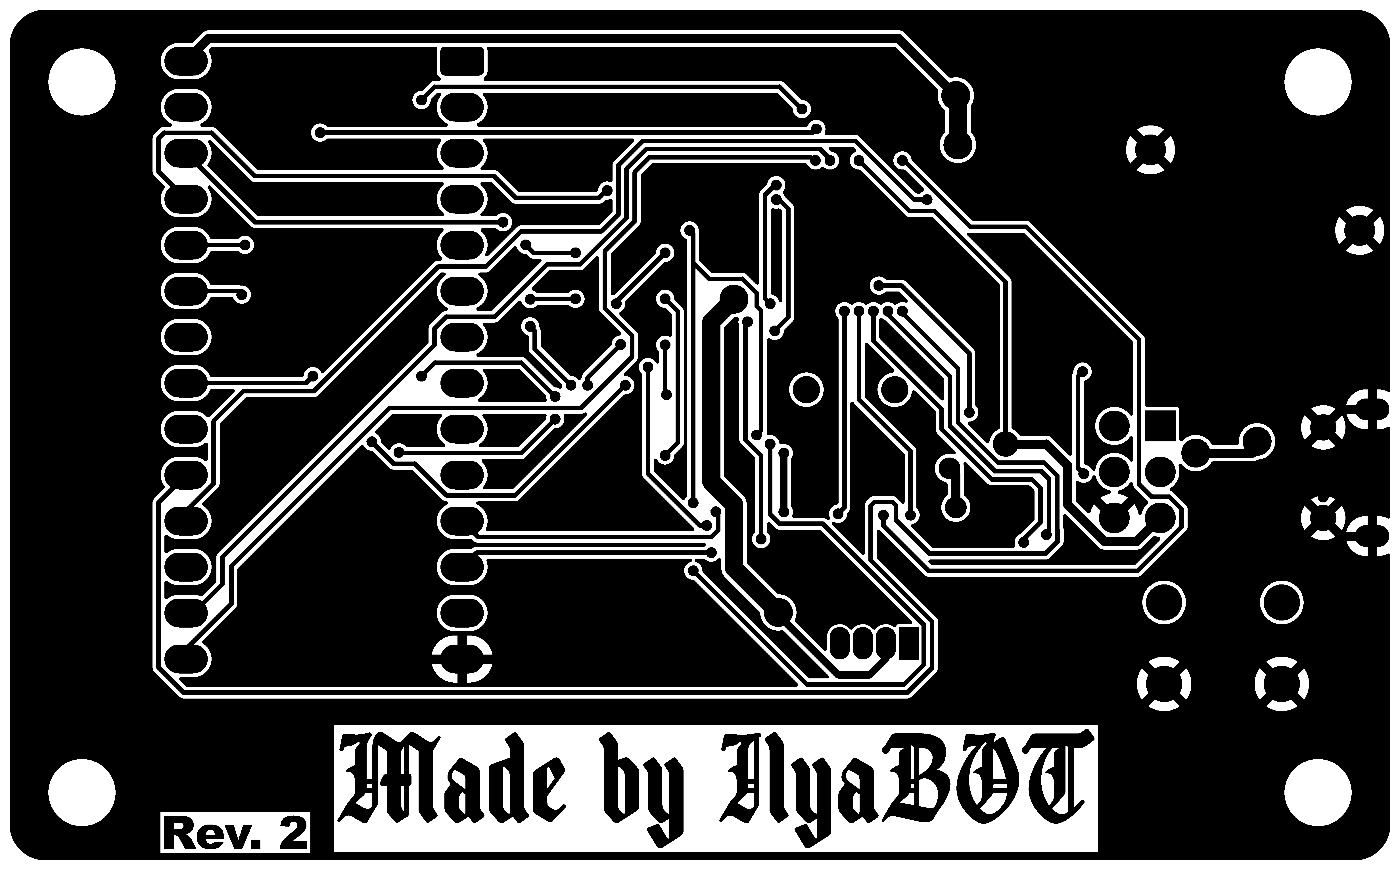
docs/cnc-k4/Lite_B_Cu_mirrored_2540dpi.png
