IlyaBOT/LunarView3/docs/cnc-k4/Lite_F_Cu_2540dpi.png

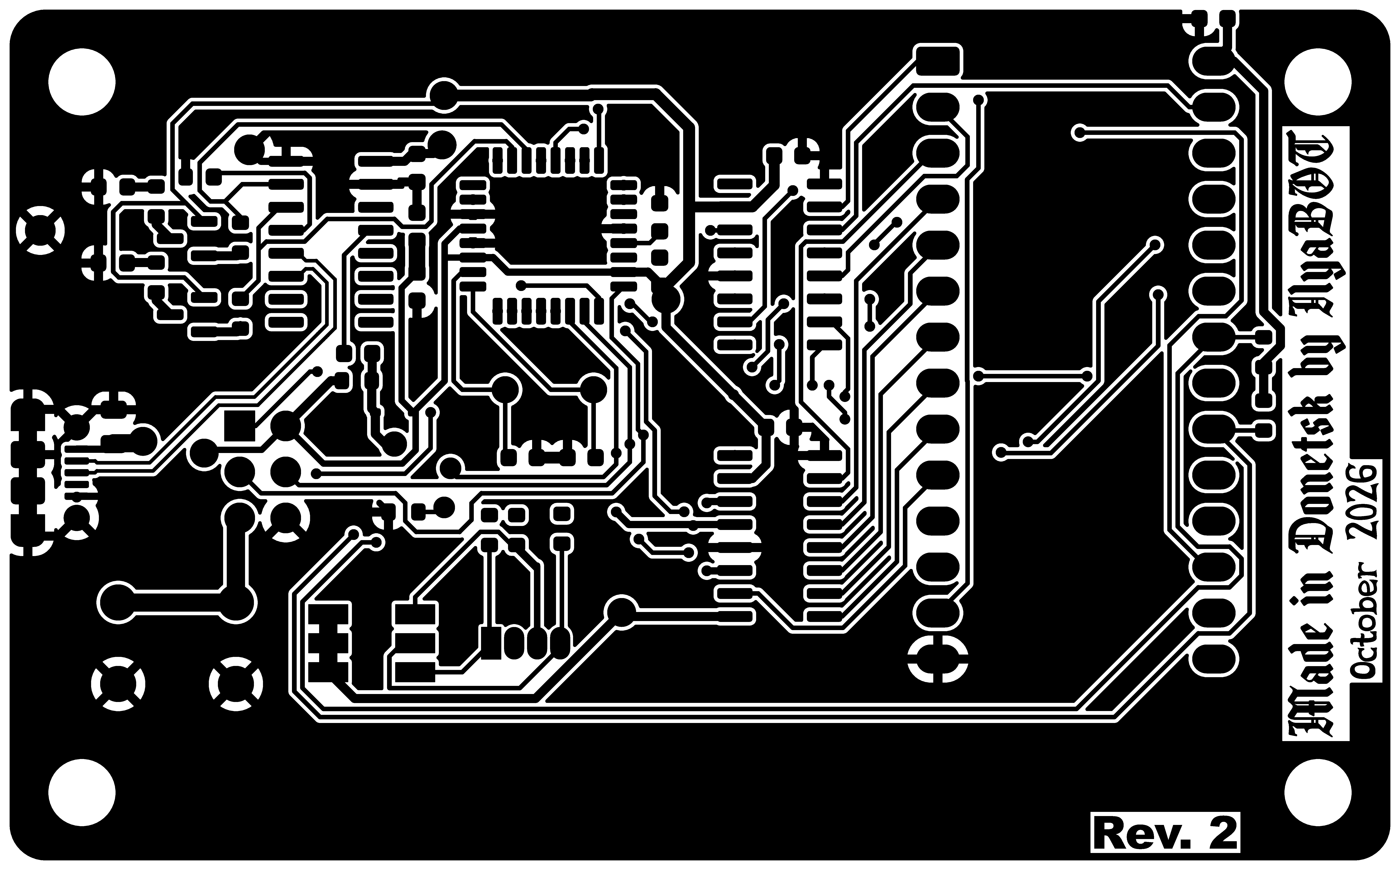
docs/cnc-k4/Lite_F_Cu_2540dpi.png
