IlyaBOT/LunarView3/Lunar-Writer/validation/schematic-overview.png

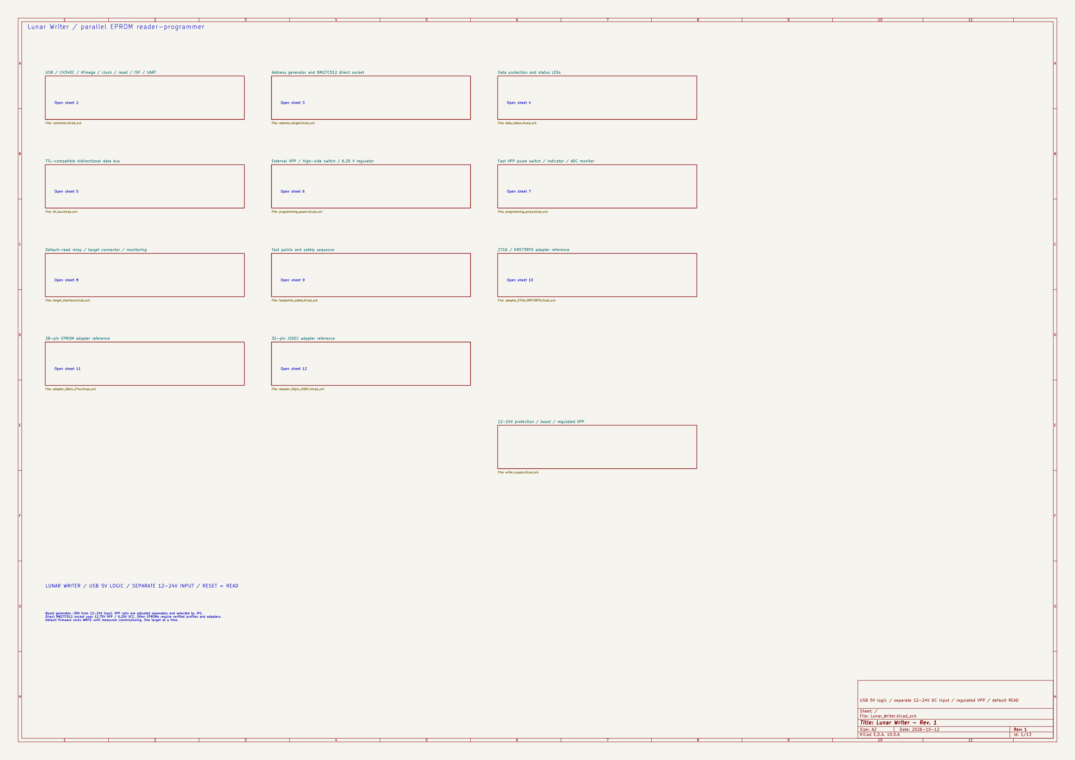
Lunar-Writer/validation/schematic-overview.png
