IlyaBOT/LunarView3/Lunar-Writer/validation/schematic-supply.png

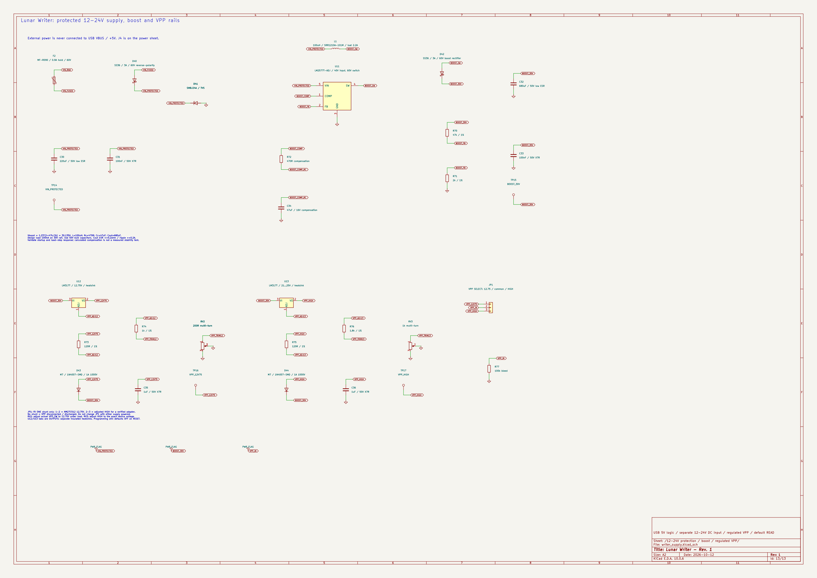
Lunar-Writer/validation/schematic-supply.png
