IlyaBOT/LunarView3/Lunar-Writer/Writer_3D.png

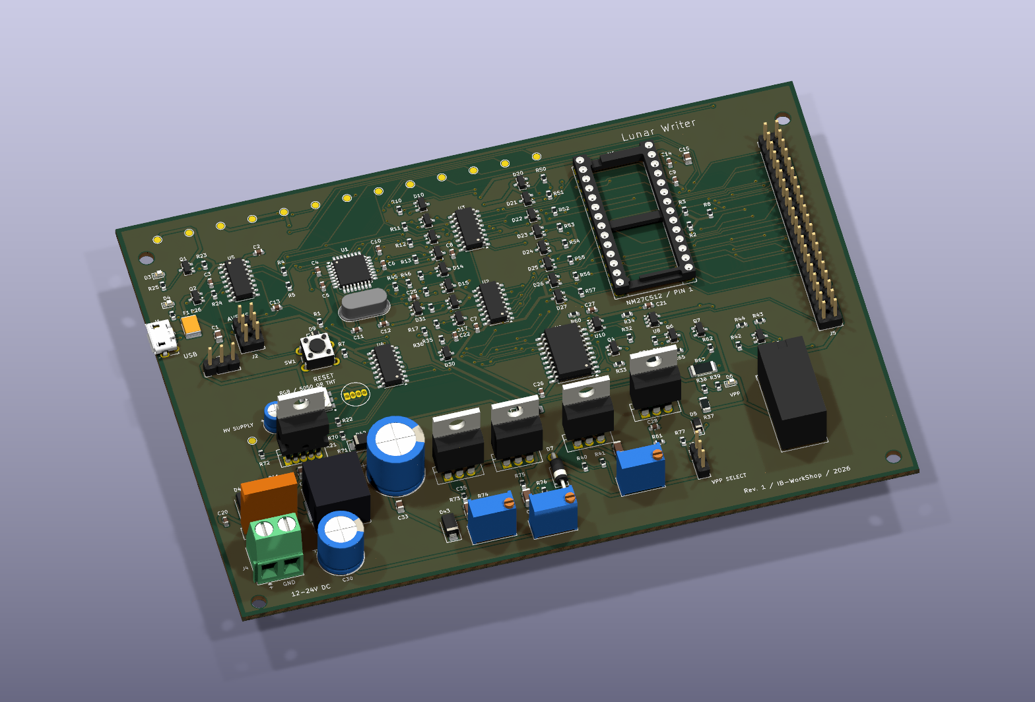
Lunar-Writer/Writer_3D.png
