IlyaBOT/LunarView3/Lunar-Writer/Writer_Top.png

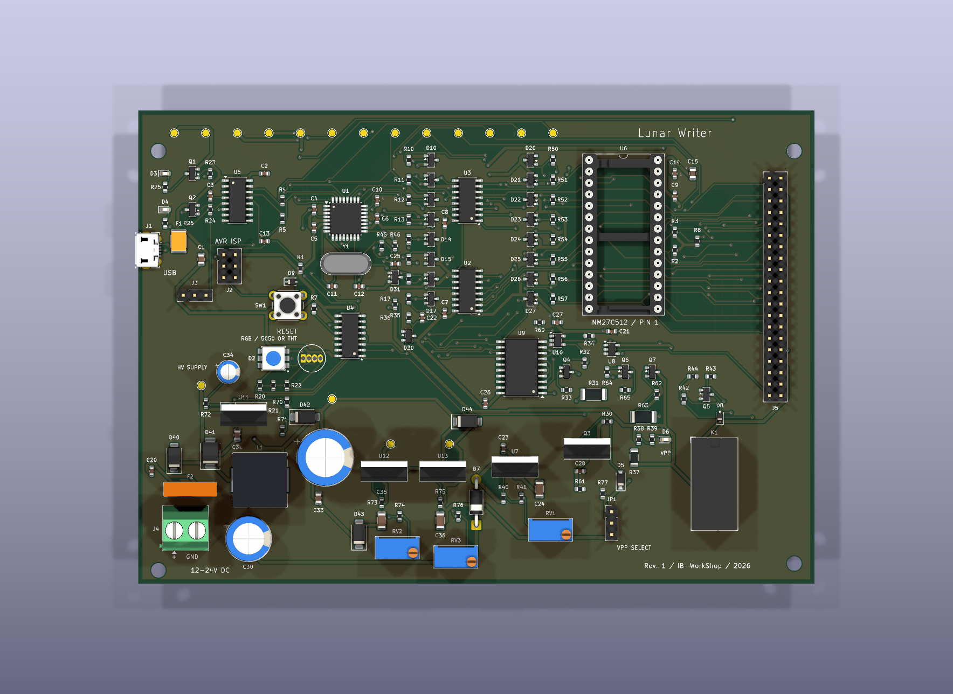
Lunar-Writer/Writer_Top.png
