IlyaBOT/LunarView3/docs/cnc-k4/vias_for_hand_assembly.csv

Index | Net | X_mm | Y_mm | Pad_diameter_mm | Drill_mm | Footprint_bbox_candidates
1 | GND | 90.8 | 57.6 | 0.6 | 0.3
2 | GND | 91.6 | 57.6 | 0.6 | 0.3
3 | GND | 92.4 | 57.6 | 0.6 | 0.3
4 | GND | 93.2 | 57.6 | 0.6 | 0.3
5 | GND | 94.0 | 57.6 | 0.6 | 0.3
6 | GND | 94.8 | 57.6 | 0.6 | 0.3
7 | GND | 108.8 | 60.0 | 0.6 | 0.3 | U5
8 | GND | 90.8 | 60.6 | 0.6 | 0.3
9 | GND | 91.6 | 60.6 | 0.6 | 0.3
10 | GND | 92.4 | 60.6 | 0.6 | 0.3
11 | GND | 93.2 | 60.6 | 0.6 | 0.3
12 | GND | 94.0 | 60.6 | 0.6 | 0.3
13 | GND | 94.8 | 60.6 | 0.6 | 0.3
14 | GND | 67.0 | 61.2 | 0.6 | 0.3
15 | GND | 67.8 | 61.2 | 0.6 | 0.3
16 | GND | 68.6 | 61.2 | 0.6 | 0.3
17 | GND | 69.4 | 61.2 | 0.6 | 0.3
18 | GND | 70.2 | 61.2 | 0.6 | 0.3
19 | +5V | 74.5 | 61.75 | 1.6 | 0.85
20 | ROM_D2 | 104.0 | 62.0 | 0.6 | 0.3 | U5
21 | GND | 109.0 | 62.4 | 0.6 | 0.3 | U5
22 | ROM_D2 | 83.0 | 62.5 | 0.6 | 0.3
23 | GND | 90.8 | 62.6 | 0.6 | 0.3
24 | GND | 91.6 | 62.6 | 0.6 | 0.3
25 | GND | 92.4 | 62.6 | 0.6 | 0.3
26 | GND | 93.2 | 62.6 | 0.6 | 0.3
27 | GND | 94.0 | 62.6 | 0.6 | 0.3
28 | GND | 94.8 | 62.6 | 0.6 | 0.3
29 | GND | 84.2 | 62.8 | 0.6 | 0.3
30 | GND | 85.0 | 62.8 | 0.6 | 0.3
31 | GND | 85.8 | 62.8 | 0.6 | 0.3
32 | GND | 99.6 | 63.0 | 0.6 | 0.3
33 | ROM_D5 | 82.2 | 63.6 | 0.6 | 0.3
34 | ROM_D5 | 109.6 | 63.8 | 0.6 | 0.3 | U5
35 | GND | 67.0 | 64.2 | 0.6 | 0.3
36 | GND | 67.8 | 64.2 | 0.6 | 0.3
37 | GND | 68.6 | 64.2 | 0.6 | 0.3
38 | GND | 69.4 | 64.2 | 0.6 | 0.3
39 | GND | 70.2 | 64.2 | 0.6 | 0.3
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
205 | GND | 87.4 | 93.2 | 0.6 | 0.3
206 | GND | 89.4 | 93.2 | 0.6 | 0.3
207 | GND | 91.4 | 93.2 | 0.6 | 0.3
208 | GND | 93.6 | 93.2 | 0.6 | 0.3
209 | GND | 95.8 | 93.2 | 0.6 | 0.3
210 | GND | 97.8 | 93.2 | 0.6 | 0.3
211 | GND | 51.6 | 94.4 | 0.6 | 0.3
212 | GND | 53.8 | 94.4 | 0.6 | 0.3
