IlyaBOT/LunarView3/Dumper-Lite/validation/vias_for_hand_assembly.csv

Index | Net | X_mm | Y_mm | Pad_diameter_mm | Drill_mm | Footprint_bbox_candidates
1 | +5V | 74.5 | 61.75 | 1.6 | 0.85
2 | ROM_D2 | 104.0 | 62.0 | 0.6 | 0.3 | U5
3 | ROM_D2 | 83.0 | 62.5 | 0.6 | 0.3
4 | +5V | 74.382937 | 64.479067 | 1.6 | 0.85
5 | STATUS_BLUE | 77.45 | 65.3375 | 0.6 | 0.3 | U1
6 | RESET | 79.85 | 65.3375 | 0.6 | 0.3 | U1
7 | ROM_D4 | 81.45 | 65.3375 | 0.6 | 0.3 | U1
8 | ROM_D3 | 82.25 | 65.3375 | 0.6 | 0.3 | U1
9 | ROM_D1 | 84.4125 | 66.7 | 0.6 | 0.3 | U1
10 | A8 | 93.75 | 67.0 | 0.6 | 0.3 | U3
11 | GND | 73.0 | 67.5 | 0.6 | 0.3 | C4
12 | ROM_D6 | 76.0875 | 67.5 | 0.6 | 0.3 | U1
13 | ROM_D0 | 84.4125 | 67.5 | 0.6 | 0.3 | U1
14 | GND | 75.25 | 68.25 | 0.6 | 0.3 | U1
15 | GND | 87.15 | 68.35 | 0.6 | 0.3 | C10
16 | A13 | 99.5 | 68.75 | 0.6 | 0.3
17 | ADDR_SCK | 88.75 | 69.0 | 0.6 | 0.3
18 | ADDR_SCK | 90.55 | 69.17 | 0.6 | 0.3 | U3
19 | A13 | 98.25 | 70.0 | 0.6 | 0.3
20 | A9 | 113.75 | 70.0 | 0.6 | 0.3 | U5
21 | ADDR_LATCH | 90.55 | 70.44 | 0.6 | 0.3 | U3
22 | A13 | 95.5 | 70.44 | 0.6 | 0.3 | U3
23 | GND | 90.169092 | 71.71 | 0.6 | 0.3 | U3
24 | ISP_MISO | 78.75 | 72.25 | 0.6 | 0.3 | U1
25 | ADDR_SCK | 88.5 | 72.25 | 0.6 | 0.3
26 | A11 | 113.925 | 72.75 | 0.6 | 0.3 | U5
27 | ADDR_CASCADE | 90.55 | 72.98 | 0.6 | 0.3 | U3
28 | A11 | 95.5 | 72.98 | 0.6 | 0.3 | U3
29 | +5V | 86.75 | 73.0 | 1.6 | 0.85
30 | A11 | 98.0 | 73.0 | 0.6 | 0.3
31 | ROM_D1 | 84.75 | 73.25 | 0.6 | 0.3 | U1
32 | ADDR_LATCH | 93.25 | 73.25 | 0.6 | 0.3 | U3
33 | ROM_D7 | 77.45 | 73.6625 | 0.6 | 0.3 | U1
34 | ROM_CE# | 78.25 | 73.6625 | 0.6 | 0.3 | U1
35 | ROM_OE# | 79.05 | 73.6625 | 0.6 | 0.3 | U1
36 | STATUS_RED | 79.85 | 73.6625 | 0.6 | 0.3 | U1
37 | STATUS_GREEN | 80.65 | 73.6625 | 0.6 | 0.3 | U1
38 | ROM_D1 | 86.0 | 74.25 | 0.6 | 0.3
39 | A11 | 98.0 | 74.5 | 0.6 | 0.3
40 | ROM_D0 | 84.5 | 74.75 | 0.6 | 0.3
41 | A9 | 93.0 | 75.5 | 0.6 | 0.3 | U3
42 | +5V | 90.55 | 75.52 | 0.6 | 0.3 | U3
43 | ADDR_LATCH | 91.5 | 76.75 | 0.6 | 0.3
44 | ISP_MISO | 67.5 | 77.0 | 0.6 | 0.3
45 | A10 | 104.0 | 77.25 | 0.6 | 0.3 | U5
46 | A10 | 110.0 | 77.25 | 0.6 | 0.3 | U5
47 | A9 | 92.75 | 77.75 | 0.6 | 0.3
48 | A9 | 94.825 | 77.75 | 0.6 | 0.3
49 | A11 | 95.75 | 77.75 | 0.6 | 0.3
50 | +5V | 90.475 | 78.275 | 0.6 | 0.3
51 | A10 | 96.625 | 78.375 | 0.6 | 0.3
52 | ISP_MISO | 73.752298 | 79.252298 | 0.6 | 0.3
53 | A11 | 96.625 | 79.625 | 0.6 | 0.3
54 | ADDR_SCK | 85.5 | 80.5 | 0.6 | 0.3 | Y1
55 | +5V | 57.867063 | 80.850933 | 1.6 | 0.85
56 | A9 | 106.741117 | 80.875001 | 0.6 | 0.3 | U5
57 | RESET | 71.75 | 81.0 | 1.4 | 0.8
58 | ADDR_SER | 84.75 | 81.0 | 0.6 | 0.3
59 | A11 | 105.25 | 81.46099 | 0.6 | 0.3 | U5
60 | +5V | 61.25 | 81.5 | 1.6 | 0.85
61 | ADDR_LATCH | 84.0 | 81.5 | 0.6 | 0.3
62 | ADDR_CASCADE | 90.55 | 81.63 | 0.6 | 0.3 | U2
63 | GND | 80.5 | 81.69 | 1.6 | 0.85
64 | ADDR_LATCH | 74.85006 | 82.34 | 1.2 | 0.65
65 | ISP_MISO | 67.435406 | 82.64 | 0.6 | 0.3 | J2
66 | ADDR_SCK | 89.0 | 84.25 | 0.6 | 0.3
67 | ADDR_LATCH | 74.5 | 84.5 | 1.2 | 0.65
68 | ROM_D0 | 87.75 | 84.74 | 0.6 | 0.3
69 | ADDR_LATCH | 84.0 | 84.75 | 0.6 | 0.3
70 | GND | 70.75 | 84.84 | 1.2 | 0.65 | R4
71 | STATUS_GREEN | 81.0 | 84.85 | 0.6 | 0.3 | R6
72 | STATUS_RED | 77.0 | 84.925 | 0.6 | 0.3 | R5
73 | STATUS_BLUE | 78.5 | 84.925 | 0.6 | 0.3 | R7
74 | ADDR_LATCH | 88.25 | 85.5 | 0.6 | 0.3
75 | ROM_CE# | 69.5 | 86.0 | 0.6 | 0.3
76 | ROM_D1 | 85.25 | 86.25 | 0.6 | 0.3
77 | ROM_OE# | 70.75 | 86.429067 | 0.6 | 0.3
78 | ROM_D1 | 88.0 | 87.0 | 0.6 | 0.3
79 | ADDR_SER | 89.0 | 88.0 | 0.6 | 0.3
80 | +5V | 84.300287 | 90.300287 | 1.6 | 0.85
