IlyaBOT/LunarView3/Lunar-Writer/validation/vias_for_hand_assembly.csv

Number | X_from_board_left_mm | Y_from_board_top_mm | Net | Drill_mm | Diameter_mm
1 | 131.8982 | 2.0236 | PROG_MODE | 0.4 | 0.8
2 | 51.9745 | 4.6798 | ADDR_SCK | 0.4 | 0.8
3 | 34.6198 | 5.0129 | VPP_IN | 0.4 | 0.8
4 | 37.6333 | 6.0608 | RESET | 0.4 | 0.8
5 | 35.3194 | 6.5458 | +6V25_PROG | 0.4 | 0.8
6 | 116.5047 | 8.3362 | +5V | 0.4 | 0.8
7 | 59.0844 | 8.6524 | TARGET_CE_PGM# | 0.4 | 0.8
8 | 36.1589 | 8.6856 | VPP_SW | 0.4 | 0.8
9 | 58.1823 | 9.1957 | TARGET_OE# | 0.4 | 0.8
10 | 77.026 | 9.8906 | TARGET_CE_PGM# | 0.4 | 0.8
11 | 56.7436 | 10.1141 | TARGET_PGM# | 0.4 | 0.8
12 | 35.8713 | 10.404 | PROG_MODE | 0.4 | 0.8
13 | 76.8205 | 10.9146 | HCT_A0 | 0.4 | 0.8
14 | 61.0484 | 11.2105 | ROM_D0 | 0.4 | 0.8
15 | 117.988 | 11.3905 | +5V | 0.4 | 0.8
16 | 77.6035 | 12.1628 | +5V | 0.4 | 0.8
17 | 61.9999 | 12.2354 | +5V | 0.4 | 0.8
18 | 121.6501 | 12.6957 | GND | 0.4 | 0.8
19 | 95.5385 | 12.7645 | A6 | 0.4 | 0.8
20 | 56.741 | 12.9742 | GND | 0.4 | 0.8
21 | 92.7293 | 13.6074 | TARGET_D0 | 0.4 | 0.8
22 | 77.9494 | 14.1749 | +5V | 0.4 | 0.8
23 | 95.0617 | 14.218 | A6 | 0.4 | 0.8
24 | 120.3833 | 14.2235 | GND | 0.4 | 0.8
25 | 90.0868 | 14.4142 | HCT_B0 | 0.4 | 0.8
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
