IlyaBOT/LunarView3/Dumper-Lite/validation/PLACEMENT.md

# Размещение Lite — 2026-10-06

Основной файл: `../NM27C512_Dumper_Lite.kicad_pcb`. Размещение выполнено по предоставленной иллюстрации с учётом фактического состава схемы: MicroUSB/CH340C и RX/TX слева, ATmega328P в центре, U3 A8–A15 сверху и U2 A0–A7 снизу перед сокетом EPROM справа. Кварц и его конденсаторы находятся под MCU; ISP — снизу слева, RESET и альтернативные RGB-места — снизу. Развязка питания расположена рядом с соответствующими микросхемами.

Контур 90×60 мм, скругления 2,5 мм. Четыре неметаллизированных отверстия 3,2 мм под M3, центры в 4,5 мм от краёв. Отсчёт платы в KiCad начинается с (50,50) мм. Все компоненты на лицевой стороне. На шелкографии нанесены назначения узлов, контакты ISP, ориентация сокета и пометка RGB `ONE ONLY`.

Сохранены все 39 электрических footprint-объектов, их UUID, номера/UUID площадок и назначенные сети. Добавлены только четыре механических footprint-объекта. Значение Y1 уточнено до точного схемного `16MHz / CL ~18pF`, поле Datasheet D1 синхронизировано со схемой. Сама схема не менялась.

При проверке обнаружено слишком узкое кольцо THT RGB. В обоих PCB и локальных библиотеках площадки увеличены с 1,07×1,8 до 1,11×1,8 мм; сверление 0,9 мм и шаг 1,27 мм сохранены. Минимальное кольцо теперь 0,105 мм, медный зазор 0,16 мм; у этих четырёх площадок локальный clearance 0,15 мм. Размеры надписей RGB приведены к минимуму 0,8 мм. Расположение и остальные объекты полной платы Stage 2 сохранены. Изготовитель должен поддерживать указанный зазор и кольцо; подробнее в [RGB_Mounting.md](../../docs/RGB_Mounting.md).

| Проверка сохранённой платы | Результат |
|---|---|
| KiCad 10.0.6 DRC, все уровни | 0 нарушений |
| Соответствие схеме | 0 расхождений |
| Неразведённые связи | 134 |
| Дорожки / зоны меди | 0 / 0 |
| Повторная загрузка, UUID/сети/геометрия и сохранность полной платы | 182 проверки пройдены |

Настройки правил проекта и уровни подавления не менялись. **Размещение готово; разводка ещё не выполнена.** Перед изготовлением необходимо развести все связи, включая десять физических RGB-площадок, и повторить DRC уже для готовой разводки. Аппаратные испытания не проводились.

Свидетельства: `placement_audit.json`, `placement_verification.json`, `drc_placement.json`, [вид сверху](Placement_Top.png). Исходная плата перед размещением и полная плата перед коррекцией RGB находятся в `placement_backup/`; путь и SHA256 исходной Lite записаны в `placement_audit.json`. `placement_candidate.kicad_pcb` — промежуточный файл проверки, основной файл находится уровнем выше.

Повторная проверка сохранности из корня проекта в PowerShell: `& 'C:\Program Files\KiCad\10.0\bin\python.exe' tools/audit_lite_placement.py`. Генераторы размещения/публикации рассчитаны на исходную плату и защищены от повторного применения к уже изменённому файлу; для дальнейшей работы редактируйте основной PCB в KiCad.

## Очистка 12.10.2026

Это исторический отчёт о размещении, до пользовательской разводки. Промежуточные placement_candidate и placement_backup удалены; числовые отчёты проверки сохранены. Скрипт audit_lite_placement.py рассчитан на исторические снимки и после очистки не применяется к текущей разведённой плате.
