IlyaBOT/LunarView3/validation/NM27C512_Dumper.pdf

1 | 2 | 3 | 4 | 5 | 6 | 7 | 8

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
Size: A3 | Rev: A | F Date: 2026-10-06
KiCad E.D.A. 10.0.6 | Id: 1/12

# Title: NM27C512 Dumper - Stage 2 Rev A

## File: NM27C512_Dumper.kicad_sch

## Sheet: /

## 5 V logic / external VPP only / no PCB layout

Default-read relay / target connector / monitoring

File: target_interface.kicad_sch 28-pin EPROM adapter reference

File: adapter_28pin_27xx.kicad_sch

External VPP / high-side switch / 6.25 V regulator File: programming_power.kicad_sch Test points and safety sequence

File: testpoints_safety.kicad_sch

Address generator and NM27C512 direct socket File: address_target.kicad_sch 32-pin JEDEC adapter reference

File: adapter_32pin_JEDEC.kicad_sch

## USB / CH340C / ATmega / clock / reset / ISP / UART

File: controller.kicad_sch TTL-compatible bidirectional data bus

File: ttl_bus.kicad_sch | 2716 / KR573RF5 adapter reference

File: adapter_2716_KR573RF5.kicad_sch

Data protection and status LEDs

File: data_status.kicad_sch Fast VPP pulse switch / indicator / ADC monitor File: programming_pulse.kicad_sch 5 V LOGIC / EXTERNAL REGULATED VPP ONLY / DEFAULT READ ON RESET

Open sheet 11 | Open sheet 12

The original 5V-only dumper is preserved in baseline_readonly/. This project adds programming-voltage routing. No onboard VPP boost. Exact manufacturer profiles govern voltages, pin roles and algorithm. Hardware bring-up and pulse-waveform validation are required before commissioning WRITE. One target at a time.

## Open sheet 9

Open sheet 3 | Open sheet 4 Open sheet 6 Open sheet 8 Open sheet 5 Open sheet 2 NM27C512 Dumper / Stage 2 - multi-EPROM architecture

# Open sheet 7 Open sheet 10

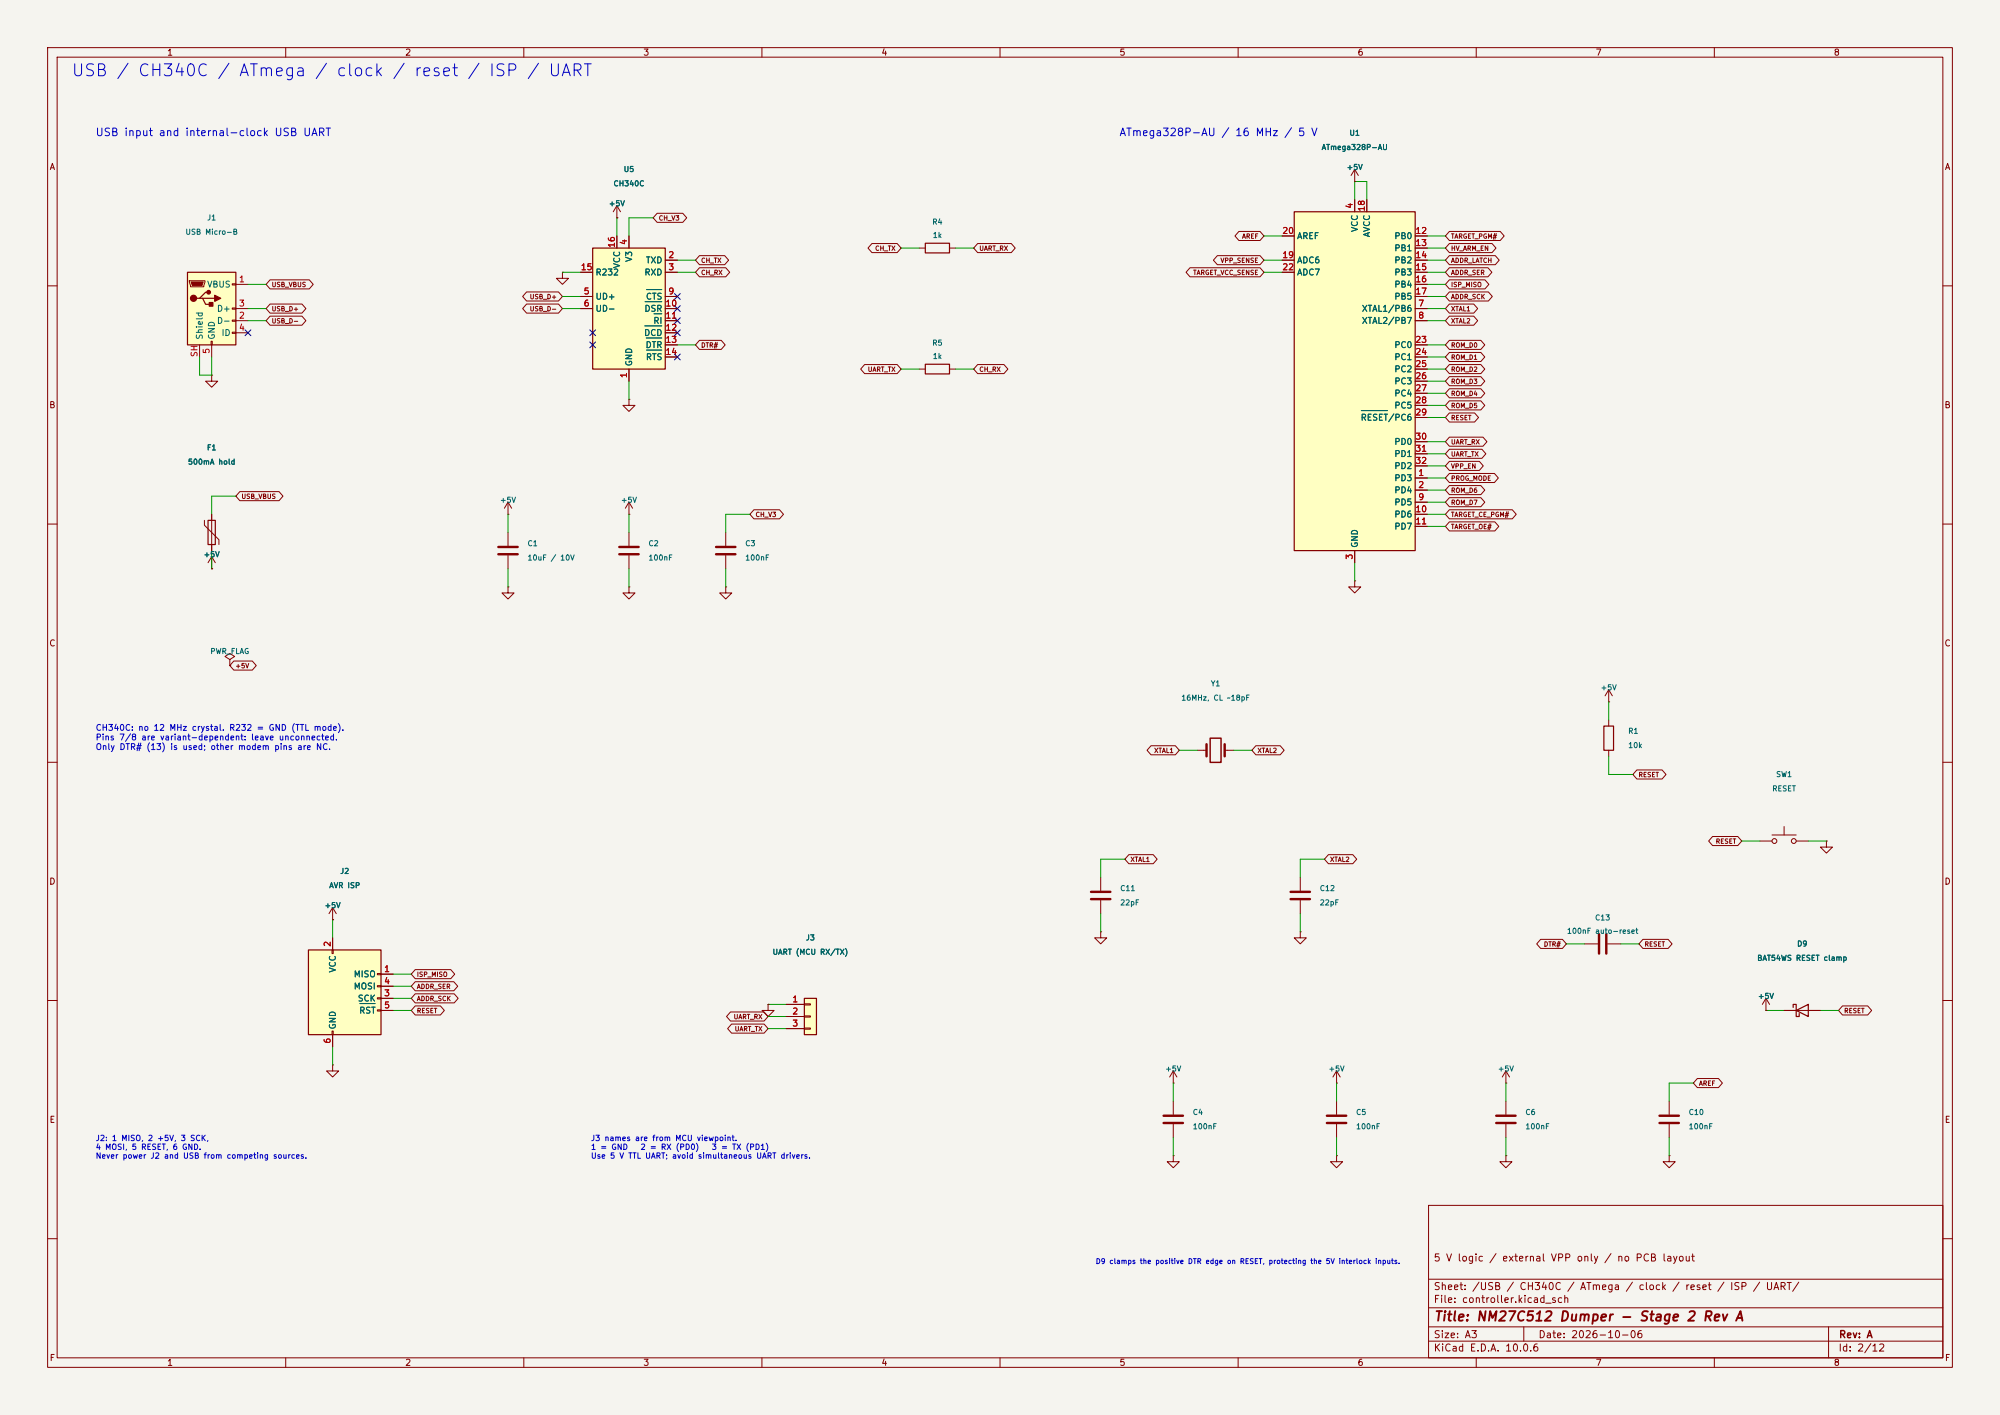
[picture p14: page 2]

USB / CH340C / ATmega / clock / reset / ISP / UART

4 UD+ 5 UD- 6 CTS 9 DSR 10 RI 11 DCD 12 DTR 13 RTS 14 R232 15 VCC 16 +5V

4 UD+ 5 UD- 6 CTS 9 DSR 10 RI 11 DCD 12 DTR 13 RTS 14 R232 15 VCC 16

J3 UART (MCU RX/TX)

J3 UART (MCU RX/TX) 1

5 V logic / external VPP only / no PCB layout

D9 clamps the positive DTR edge on RESET, protecting the 5V interlock inputs.

Sheet: /USB / CH340C / ATmega / clock / reset / ISP / UART/
File: controller.kicad_sch

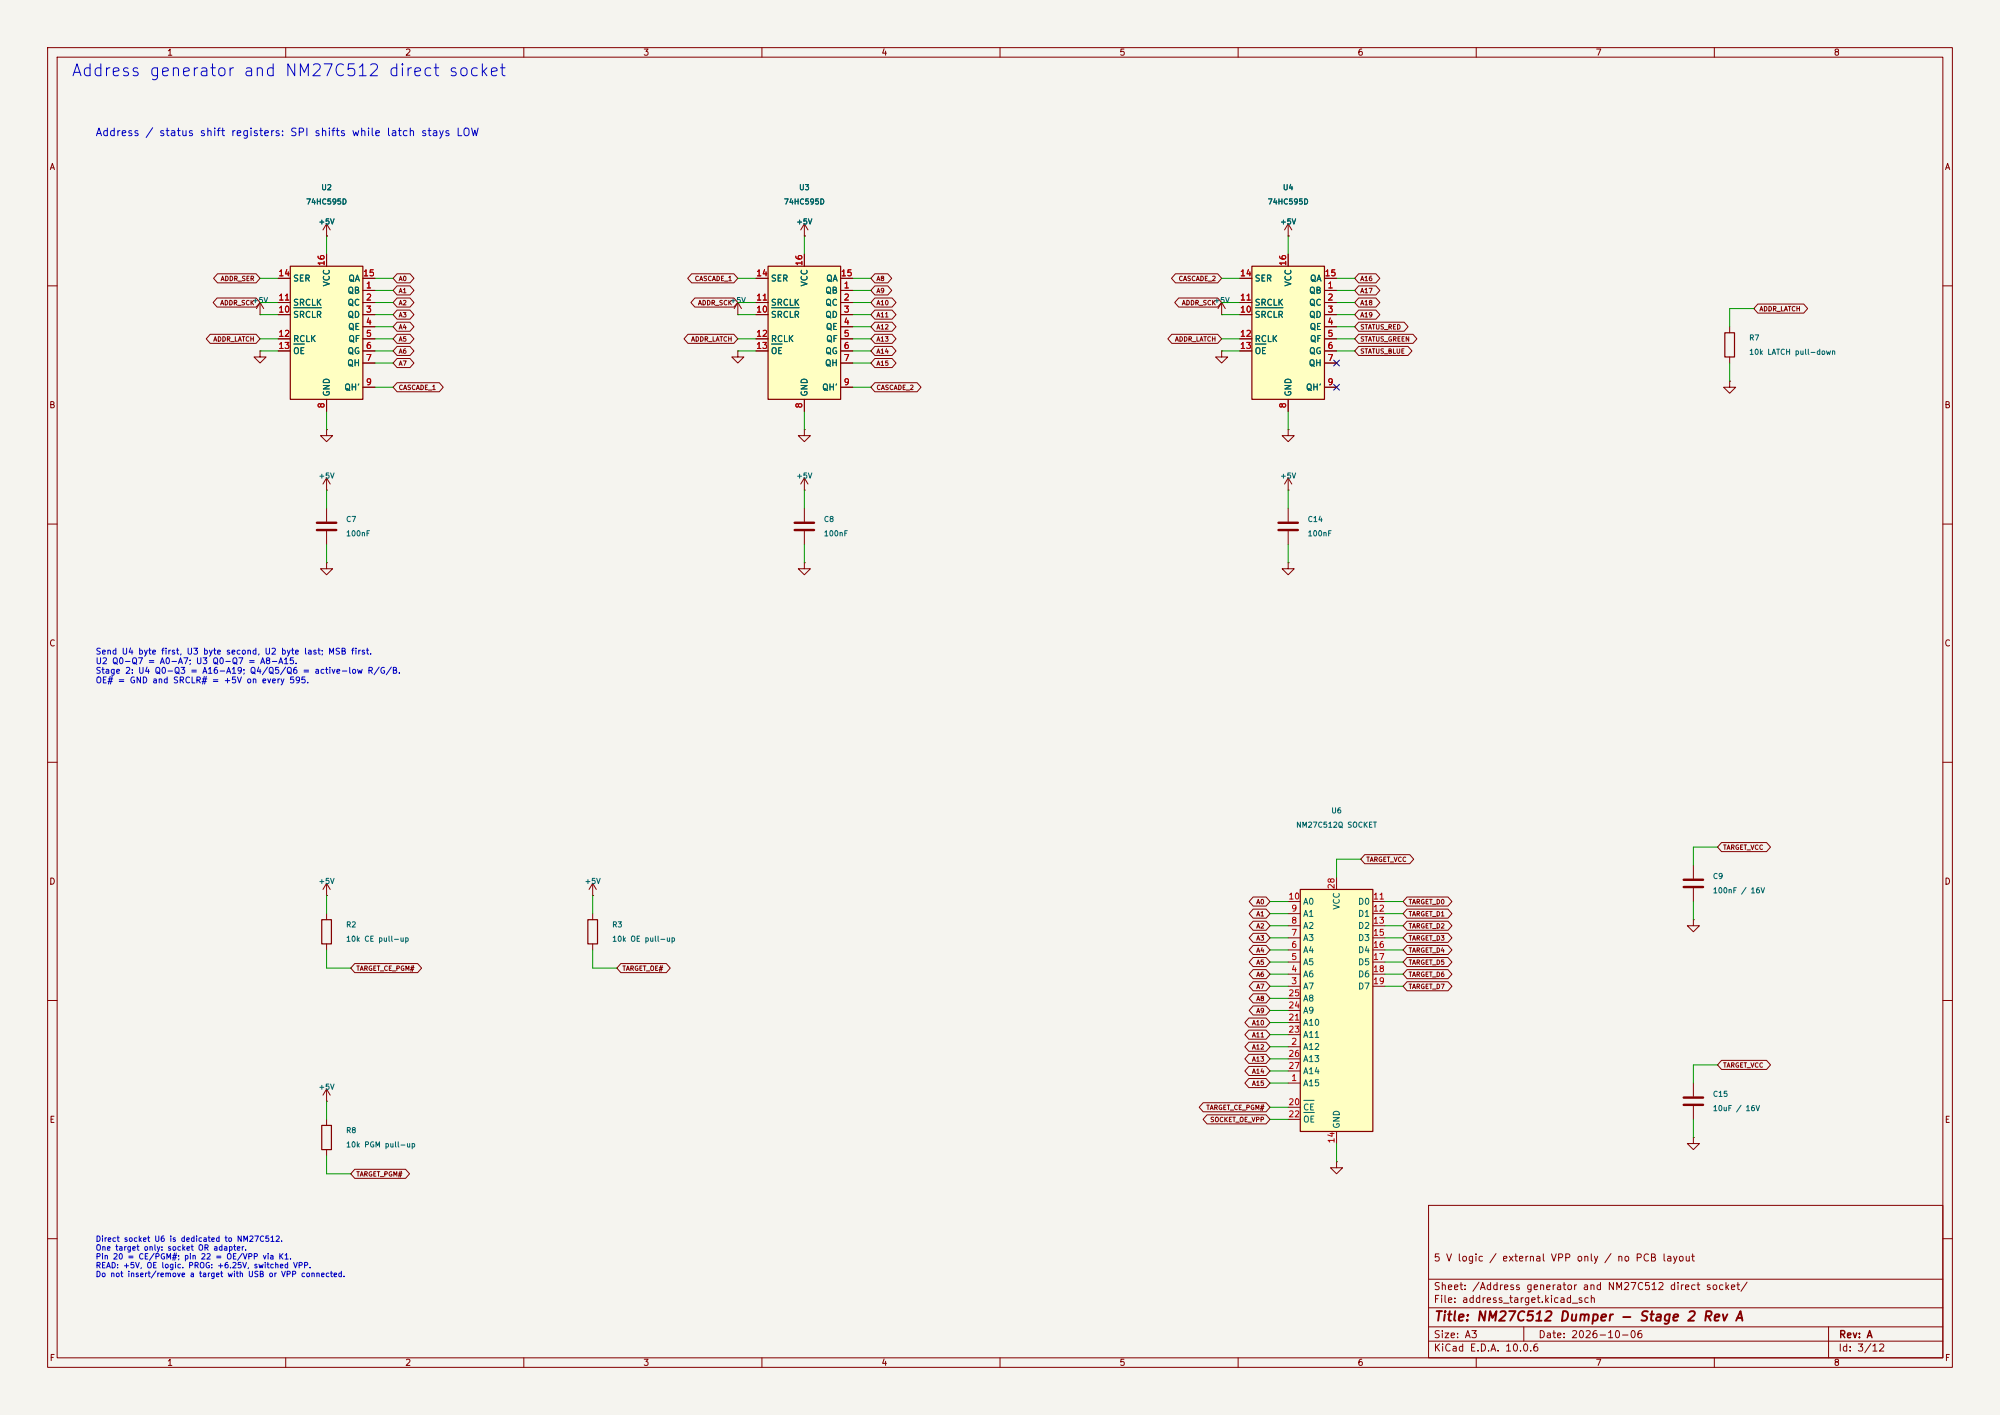
[picture p15: page 3]

Address generator and NM27C512 direct socket

Address / status shift registers: SPI shifts while latch stays LOW

OE# = GND and SRCLR# = +5V on every 595. Direct socket U6 is dedicated to NM27C512. One target only: socket OR adapter. Pin 20 = CE/PGM#; pin 22 = OE/VPP via K1. READ: +5V, OE logic. PROG: +6.25V, switched VPP. Do not insert/remove a target with USB or VPP connected.

SRCLR 10 SRCLK 11 RCLK 12 OE 13

ADDR_LATCH Send U4 byte first, U3 byte second, U2 byte last; MSB first. U2 Q0-Q7 = A0-A7; U3 Q0-Q7 = A8-A15. Stage 2: U4 Q0-Q3 = A16-A19; Q4/Q5/Q6 = active-low R/G/B.

5 V logic / external VPP only / no PCB layout R3

Sheet: /Address generator and NM27C512 direct socket/
File: address_target.kicad_sch

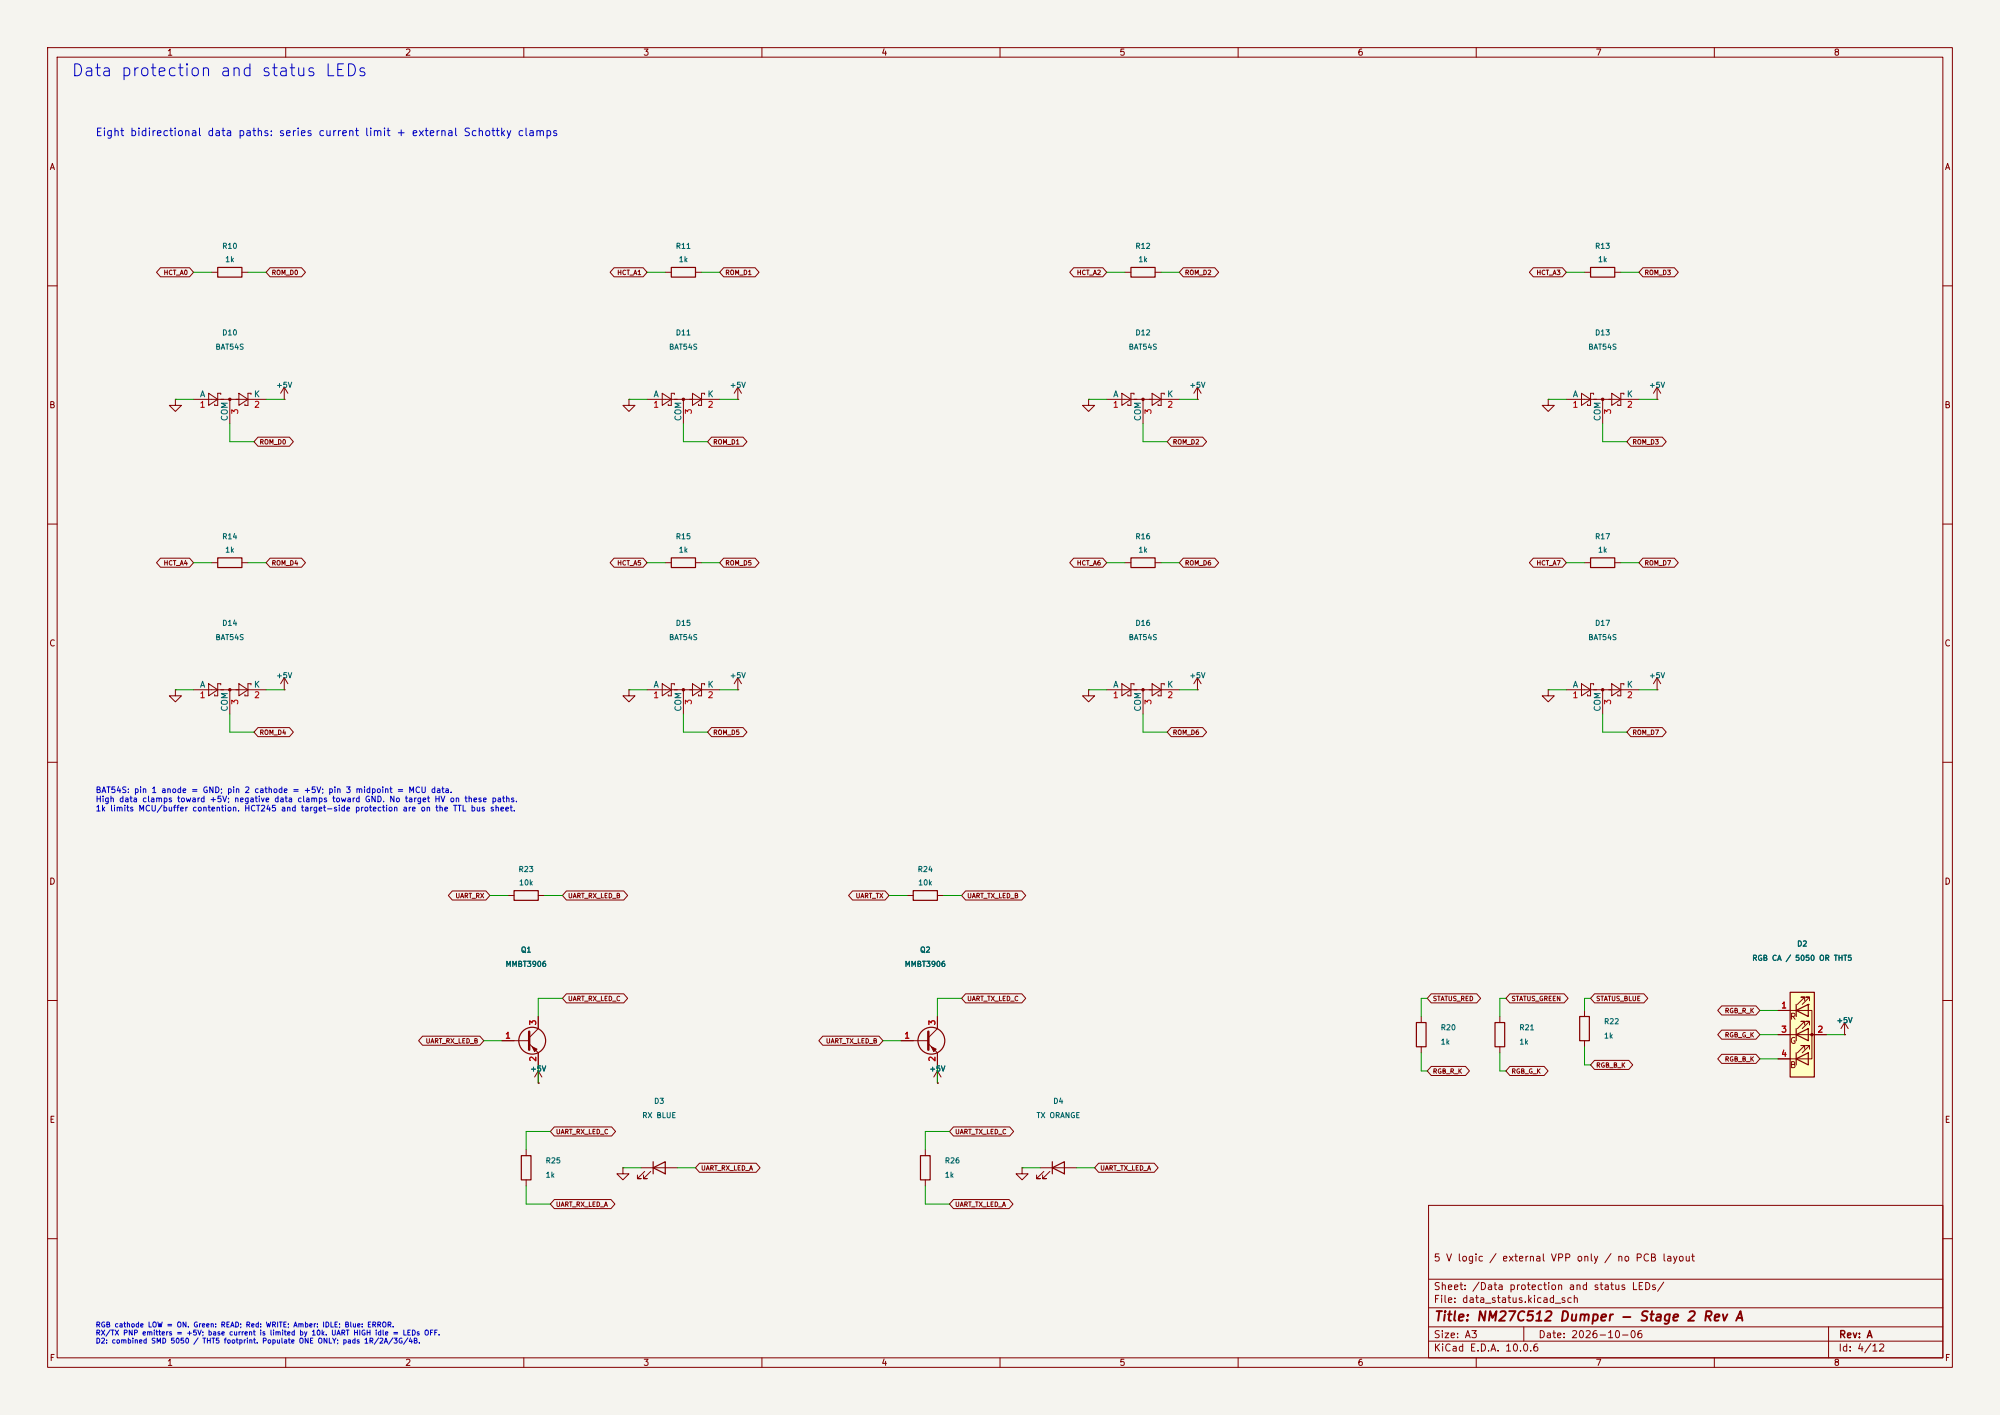
[picture p16: page 4]

HCT_A6 Data protection and status LEDs

Eight bidirectional data paths: series current limit + external Schottky clamps

5 V logic / external VPP only / no PCB layout

Sheet: /Data protection and status LEDs/
File: data_status.kicad_sch

RGB cathode LOW = ON. Green: READ; Red: WRITE; Amber: IDLE; Blue: ERROR. RX/TX PNP emitters = +5V; base current is limited by 10k. UART HIGH idle = LEDs OFF. D2: combined SMD 5050 / THT5 footprint. Populate ONE ONLY; pads 1R/2A/3G/4B.

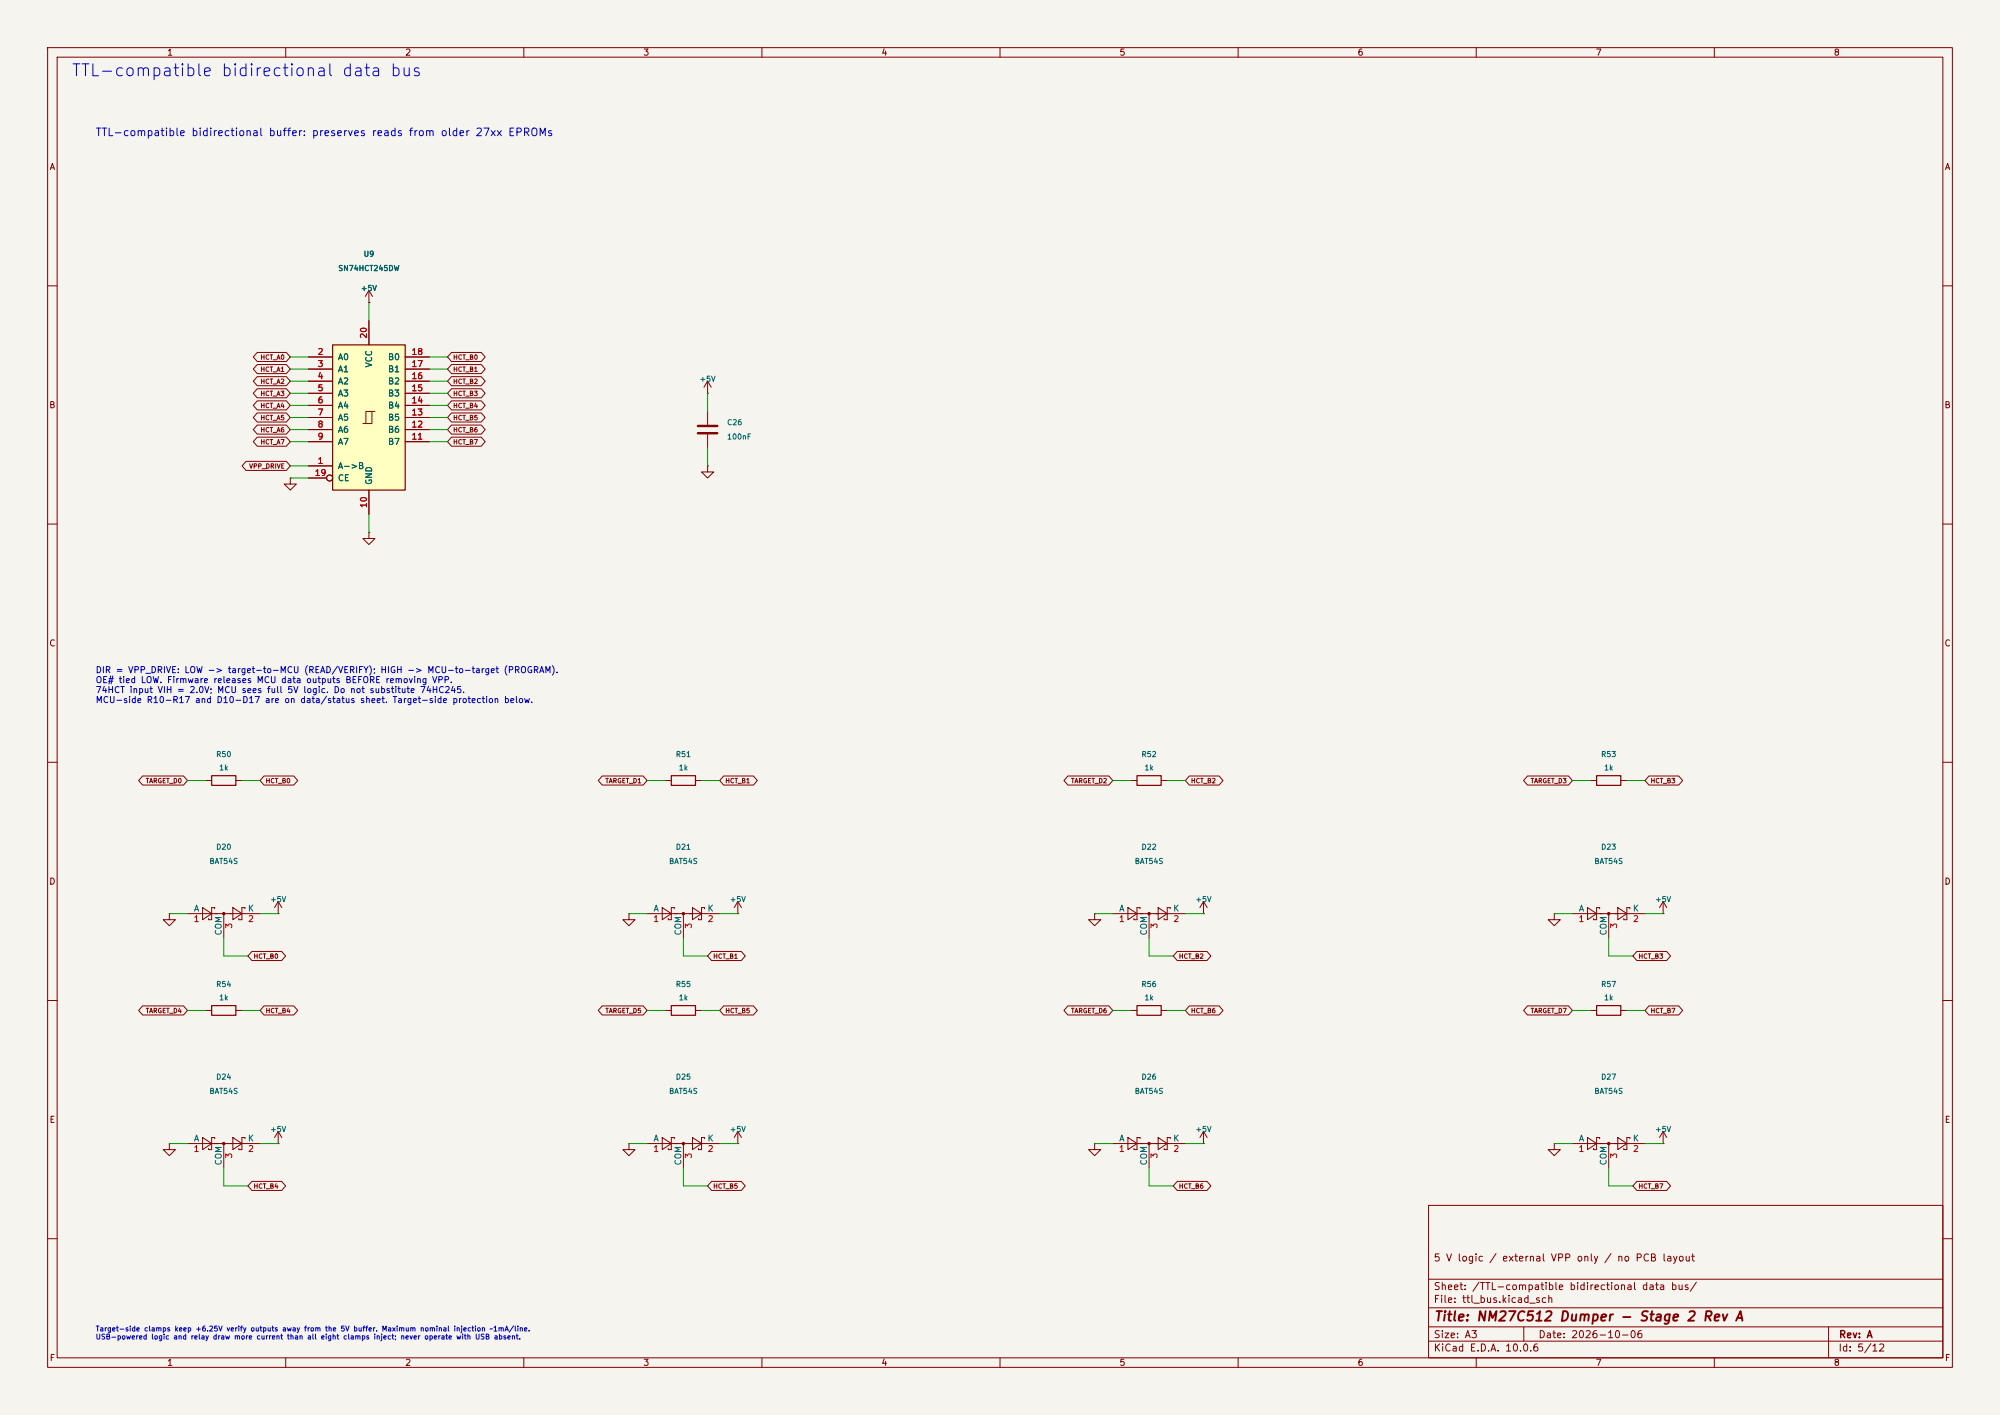
[picture p17: page 5]

TTL-compatible bidirectional data bus

HCT_A0 TTL-compatible bidirectional buffer: preserves reads from older 27xx EPROMs DIR = VPP_DRIVE: LOW -> target-to-MCU (READ/VERIFY); HIGH -> MCU-to-target (PROGRAM).

OE# tied LOW. Firmware releases MCU data outputs BEFORE removing VPP. 74HCT input VIH = 2.0V; MCU sees full 5V logic. Do not substitute 74HC245. MCU-side R10-R17 and D10-D17 are on data/status sheet. Target-side protection below.

Sheet: /TTL-compatible bidirectional data bus/
File: ttl_bus.kicad_sch

Target-side clamps keep +6.25V verify outputs away from the 5V buffer. Maximum nominal injection ~1mA/line. USB-powered logic and relay draw more current than all eight clamps inject; never operate with USB absent.

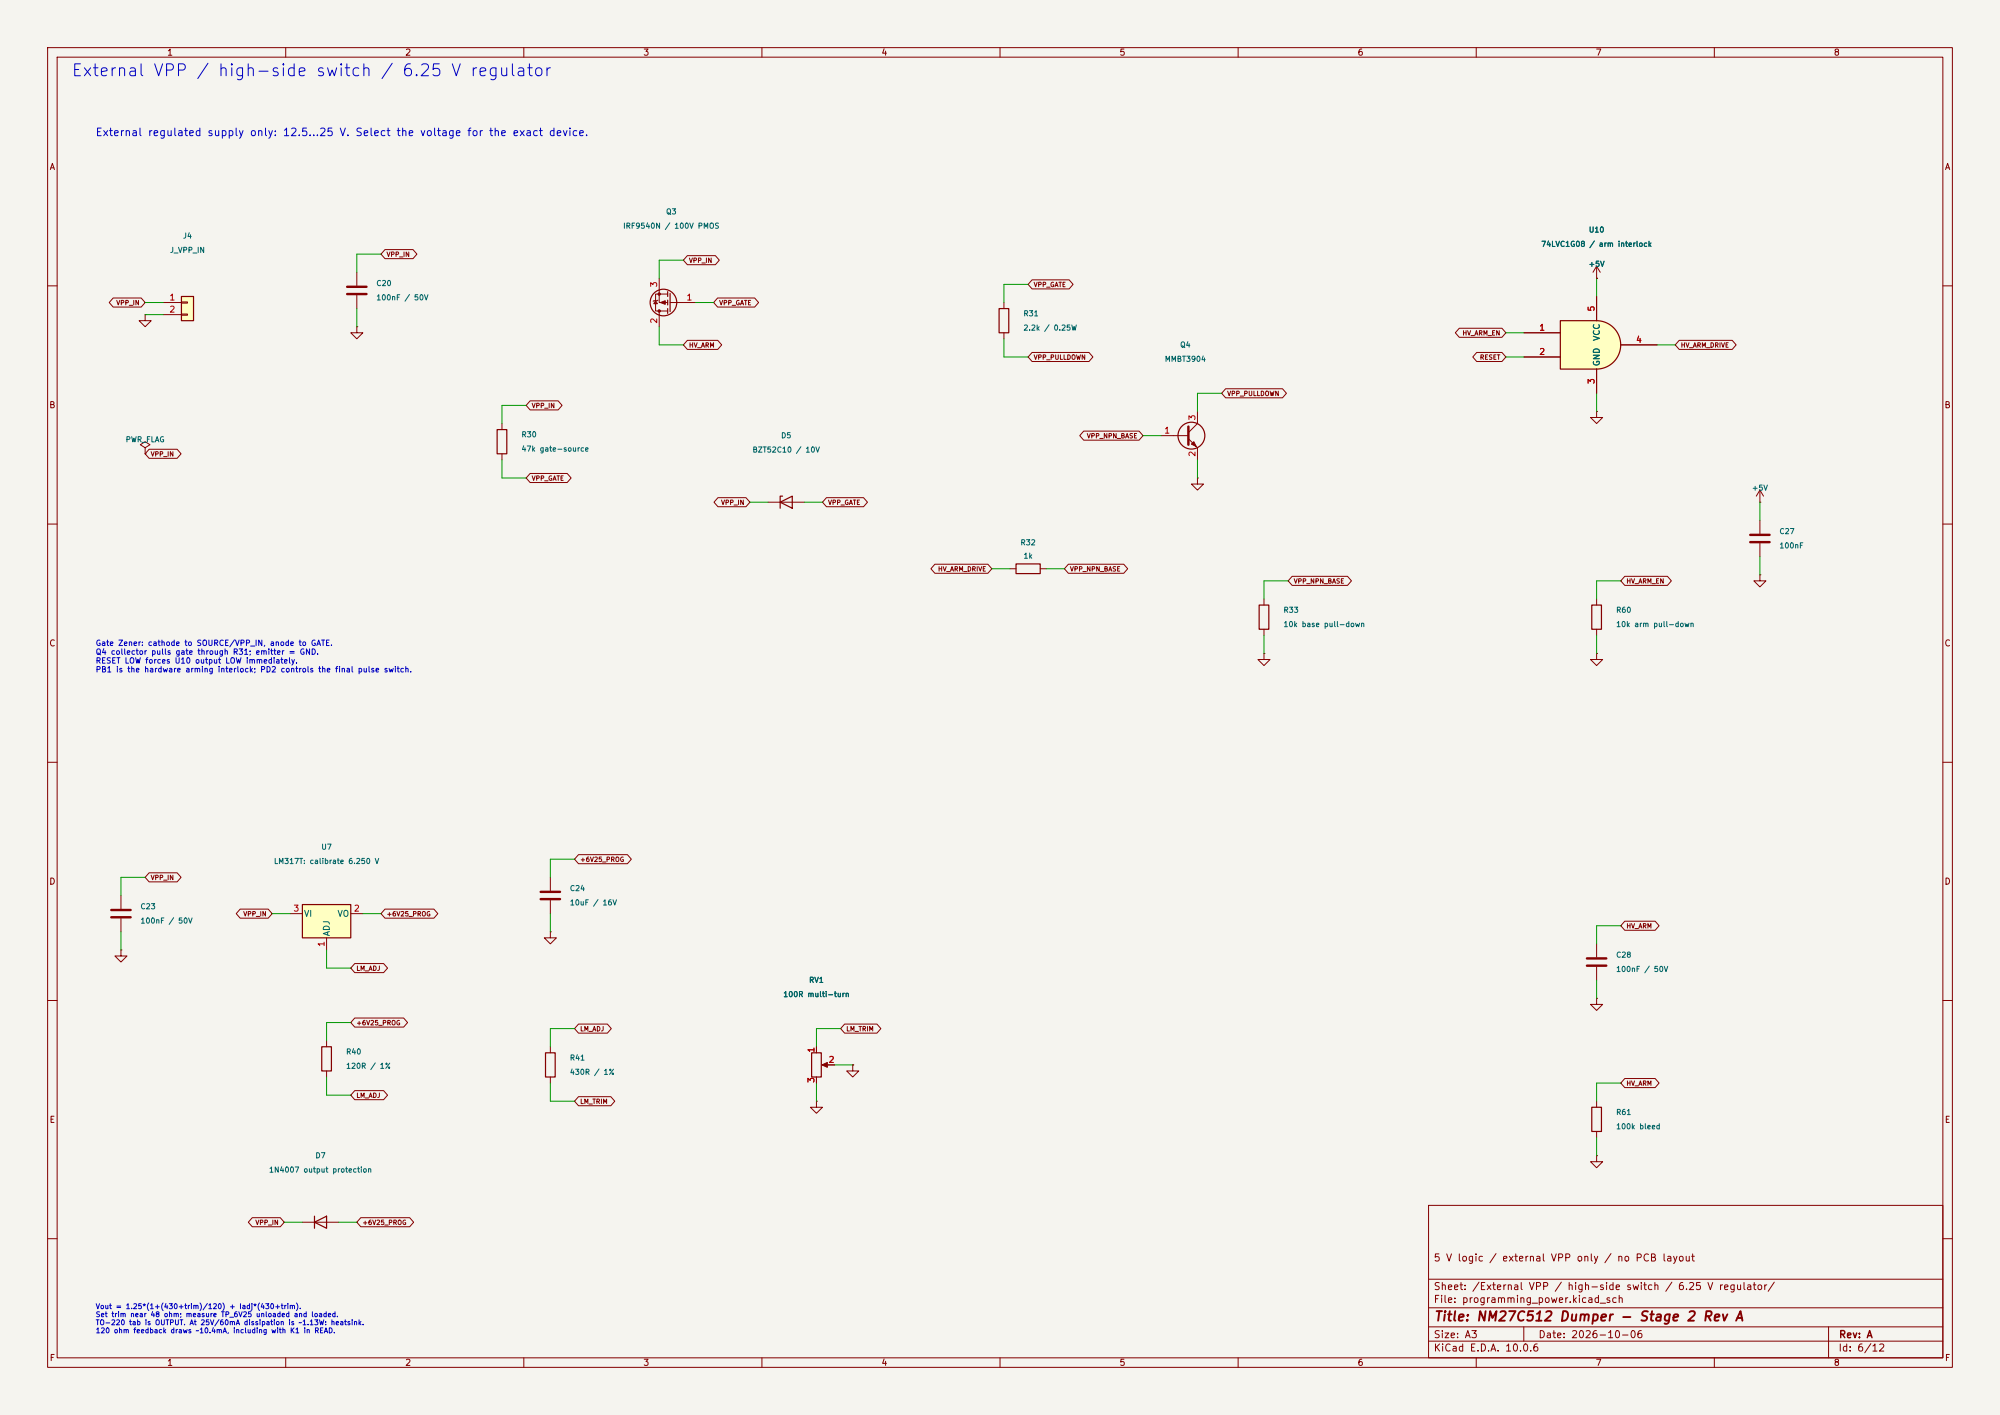
[picture p18: page 6]

External VPP / high-side switch / 6.25 V regulator

External regulated supply only: 12.5...25 V. Select the voltage for the exact device.

10k base pull-down ADJ 1

Gate Zener: cathode to SOURCE/VPP_IN, anode to GATE. Q4 collector pulls gate through R31; emitter = GND. RESET LOW forces U10 output LOW immediately. PB1 is the hardware arming interlock; PD2 controls the final pulse switch.

5 V logic / external VPP only / no PCB layout

Sheet: /External VPP / high-side switch / 6.25 V regulator/
File: programming_power.kicad_sch

Vout = 1.25*(1+(430+trim)/120) + Iadj*(430+trim). Set trim near 48 ohm; measure TP_6V25 unloaded and loaded. TO-220 tab is OUTPUT. At 25V/60mA dissipation is ~1.13W: heatsink. 120 ohm feedback draws ~10.4mA, including with K1 in READ.

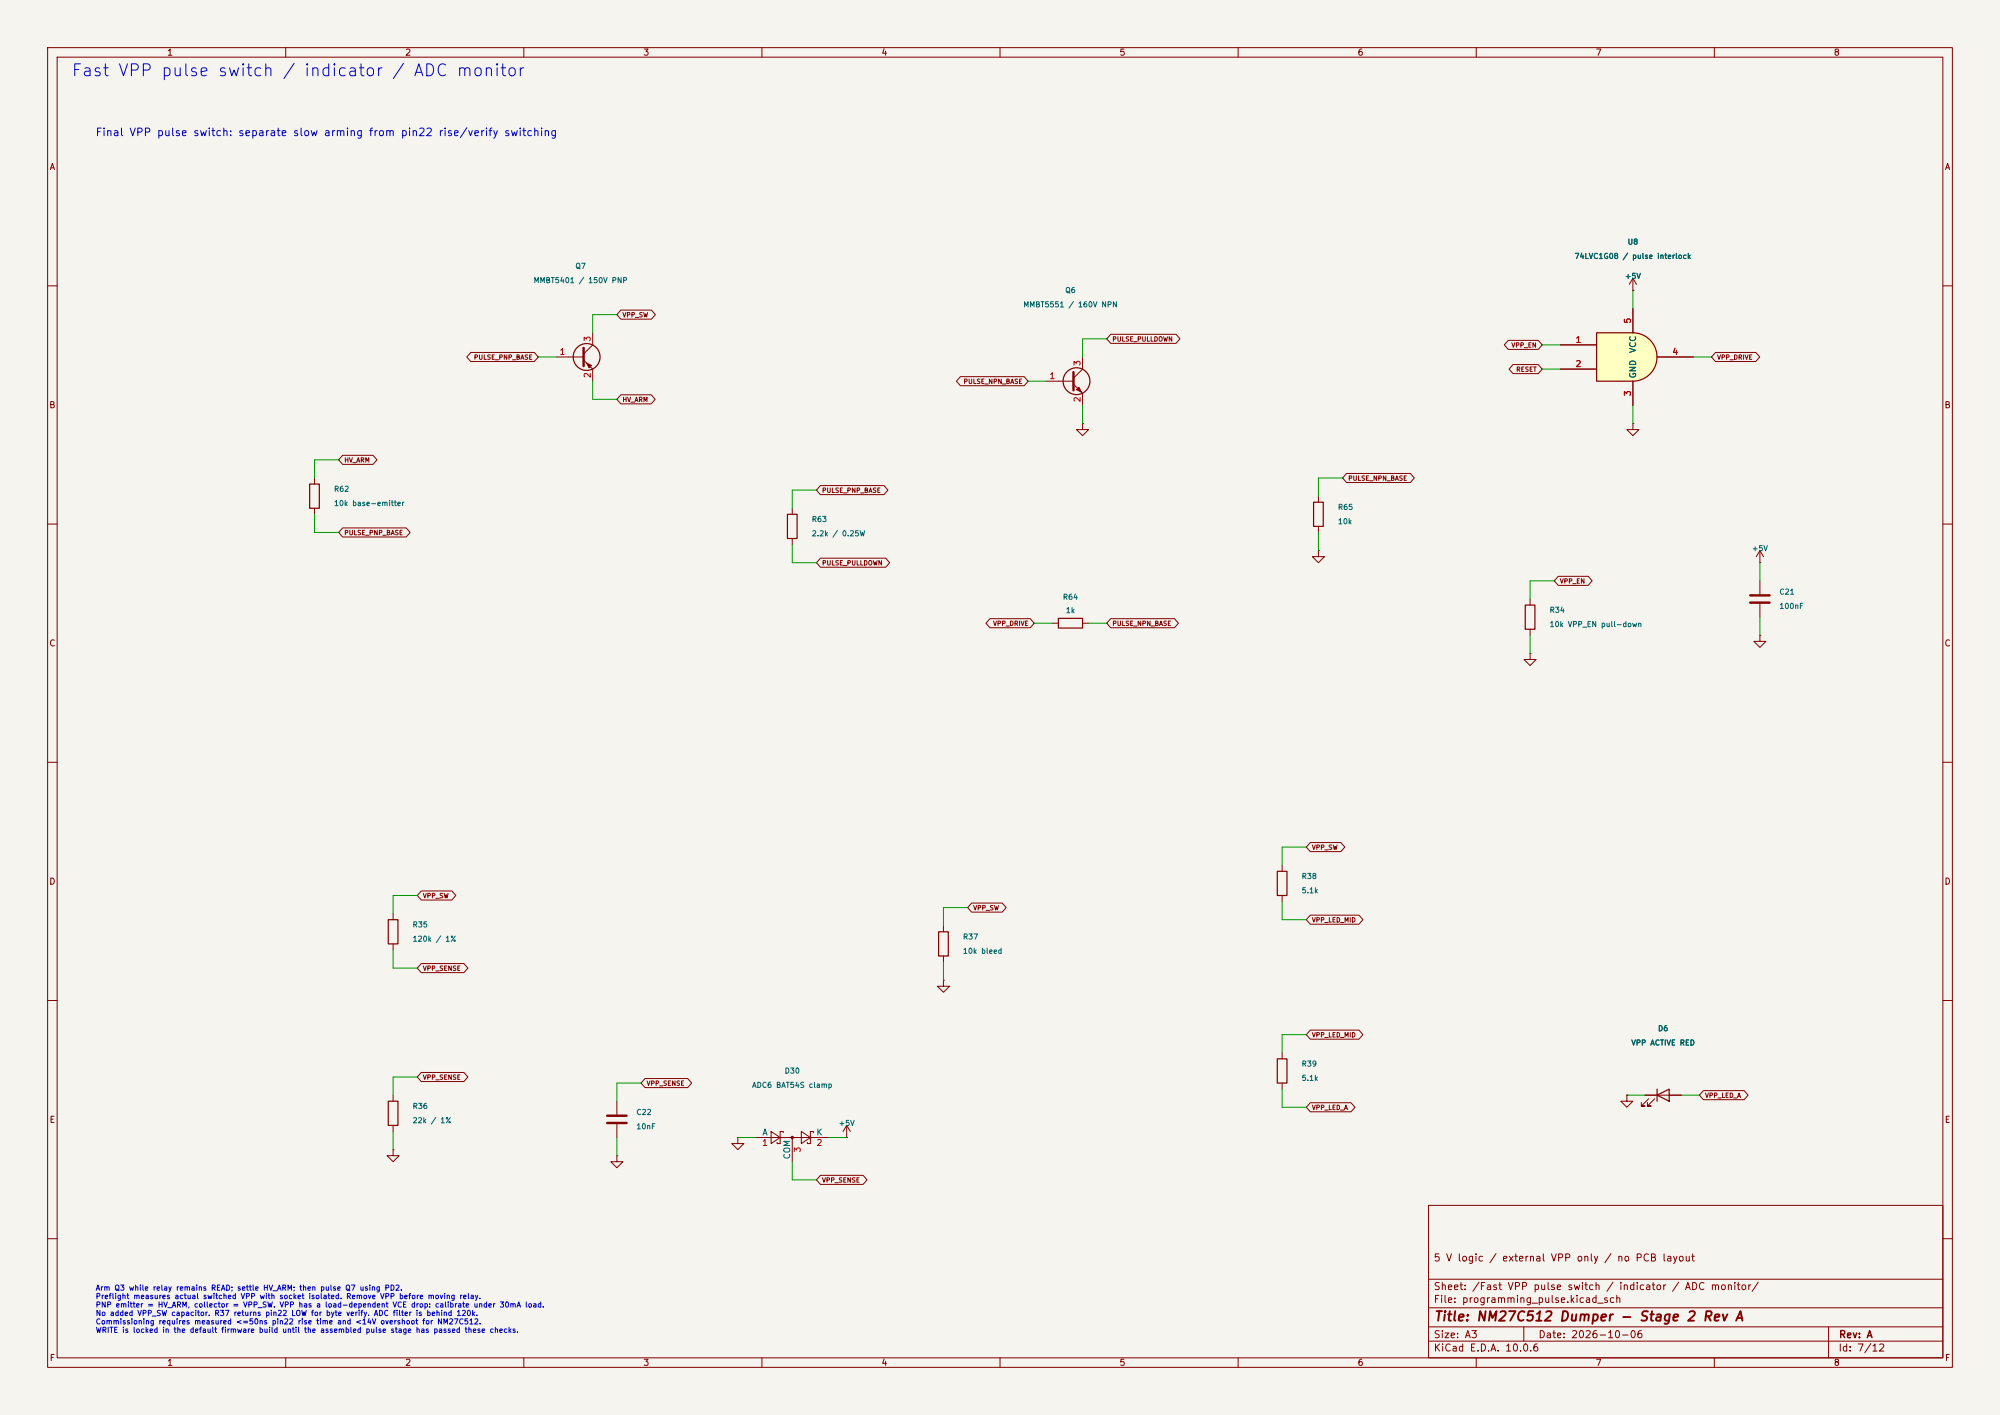
[picture p19: page 7]

Fast VPP pulse switch / indicator / ADC monitor

Final VPP pulse switch: separate slow arming from pin22 rise/verify switching

5 V logic / external VPP only / no PCB layout C22

Sheet: /Fast VPP pulse switch / indicator / ADC monitor/
File: programming_pulse.kicad_sch

Arm Q3 while relay remains READ; settle HV_ARM; then pulse Q7 using PD2. Preflight measures actual switched VPP with socket isolated. Remove VPP before moving relay. PNP emitter = HV_ARM, collector = VPP_SW. VPP has a load-dependent VCE drop: calibrate under 30mA load. No added VPP_SW capacitor. R37 returns pin22 LOW for byte verify. ADC filter is behind 120k. Commissioning requires measured <=50ns pin22 rise time and <14V overshoot for NM27C512. WRITE is locked in the default firmware build until the assembled pulse stage has passed these checks.

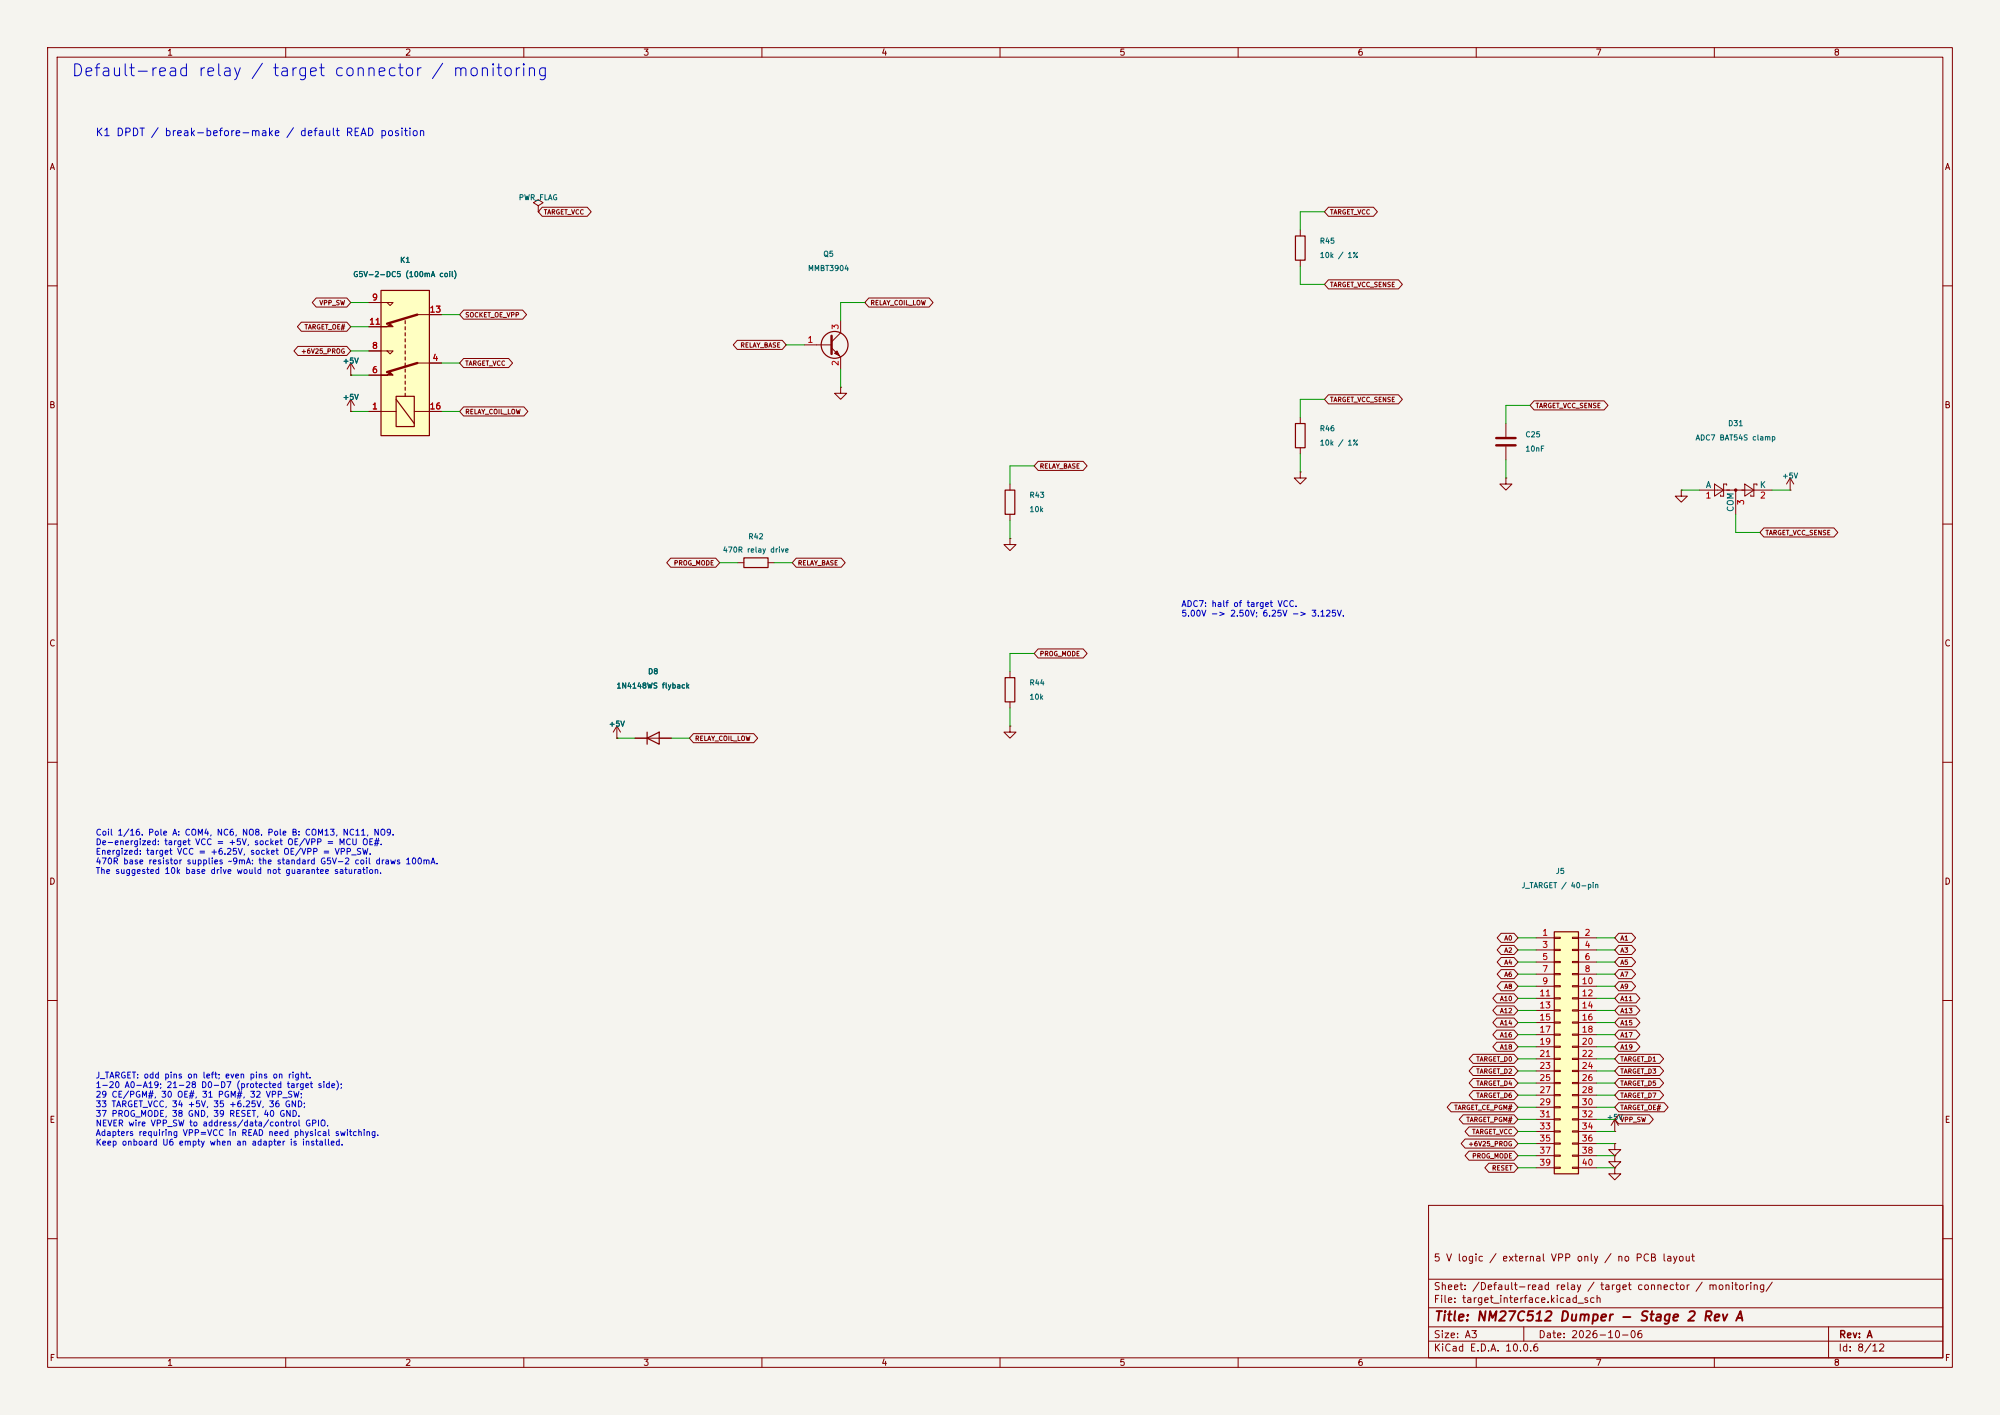
[picture p20: page 8]

Energized: target VCC = +6.25V, socket OE/VPP = VPP_SW. 470R base resistor supplies ~9mA: the standard G5V-2 coil draws 100mA. The suggested 10k base drive would not guarantee saturation. Default-read relay / target connector / monitoring
Q5 MMBT3904 D8

K1 DPDT / break-before-make / default READ position

ADC7: half of target VCC. 5.00V -> 2.50V; 6.25V -> 3.125V. Coil 1/16. Pole A: COM4, NC6, NO8. Pole B: COM13, NC11, NO9. De-energized: target VCC = +5V, socket OE/VPP = MCU OE#.

TARGET_OE# J_TARGET: odd pins on left; even pins on right. 1-20 A0-A19; 21-28 D0-D7 (protected target side); 29 CE/PGM#, 30 OE#, 31 PGM#, 32 VPP_SW; 33 TARGET_VCC, 34 +5V, 35 +6.25V, 36 GND; 37 PROG_MODE, 38 GND, 39 RESET, 40 GND. NEVER wire VPP_SW to address/data/control GPIO. Adapters requiring VPP=VCC in READ need physical switching.

Keep onboard U6 empty when an adapter is installed.

5 V logic / external VPP only / no PCB layout

Sheet: /Default-read relay / target connector / monitoring/
File: target_interface.kicad_sch

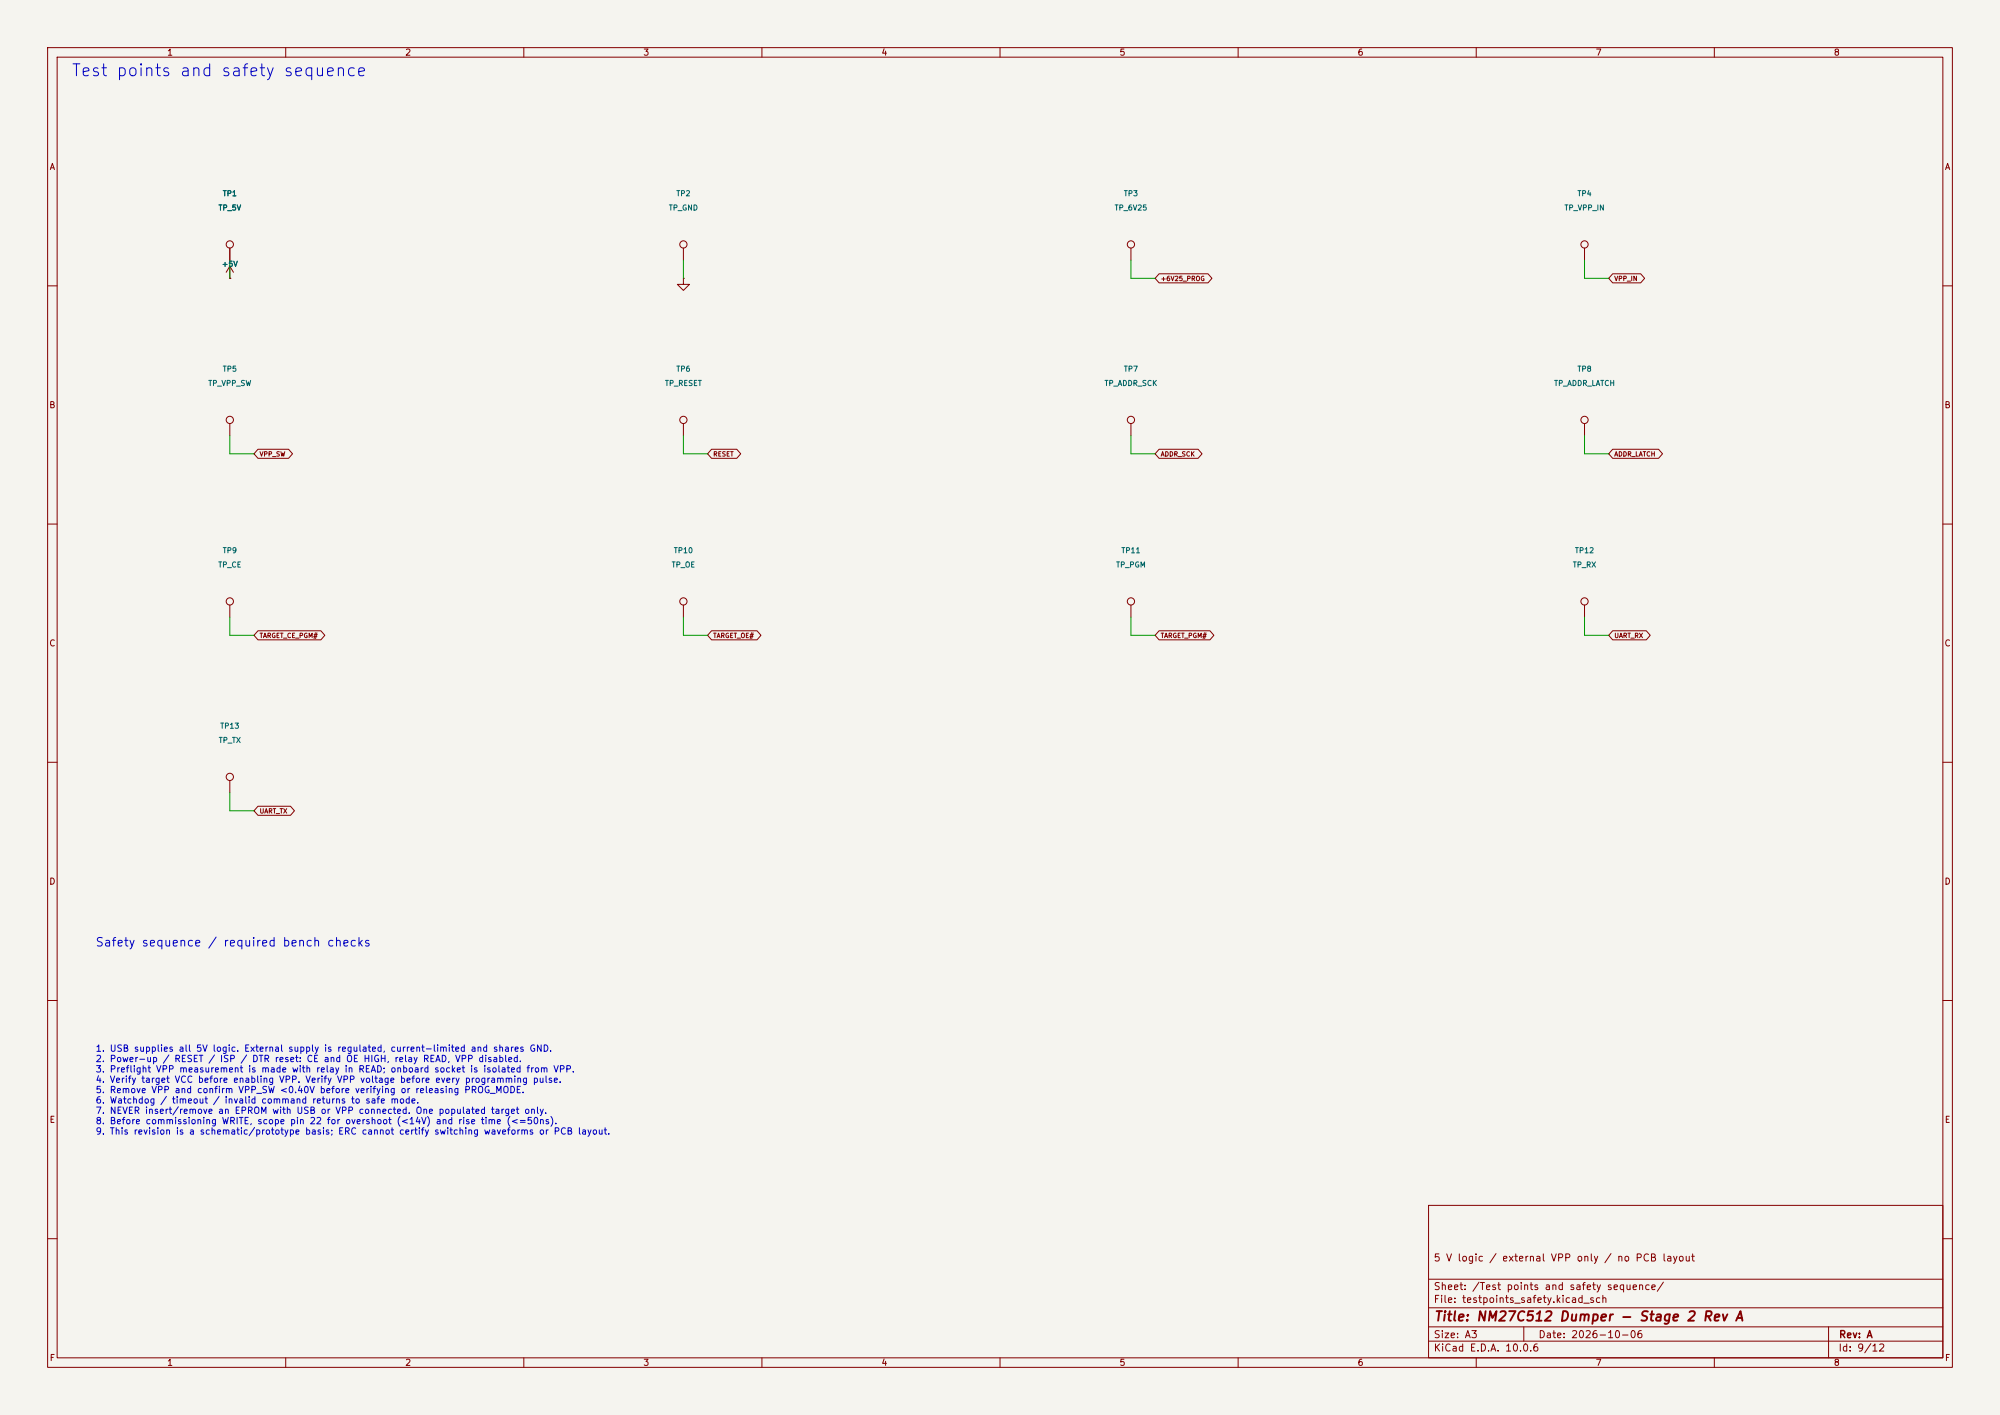
[picture p21: page 9]

Test points and safety sequence

Safety sequence / required bench checks

5 V logic / external VPP only / no PCB layout

Sheet: /Test points and safety sequence/
File: testpoints_safety.kicad_sch

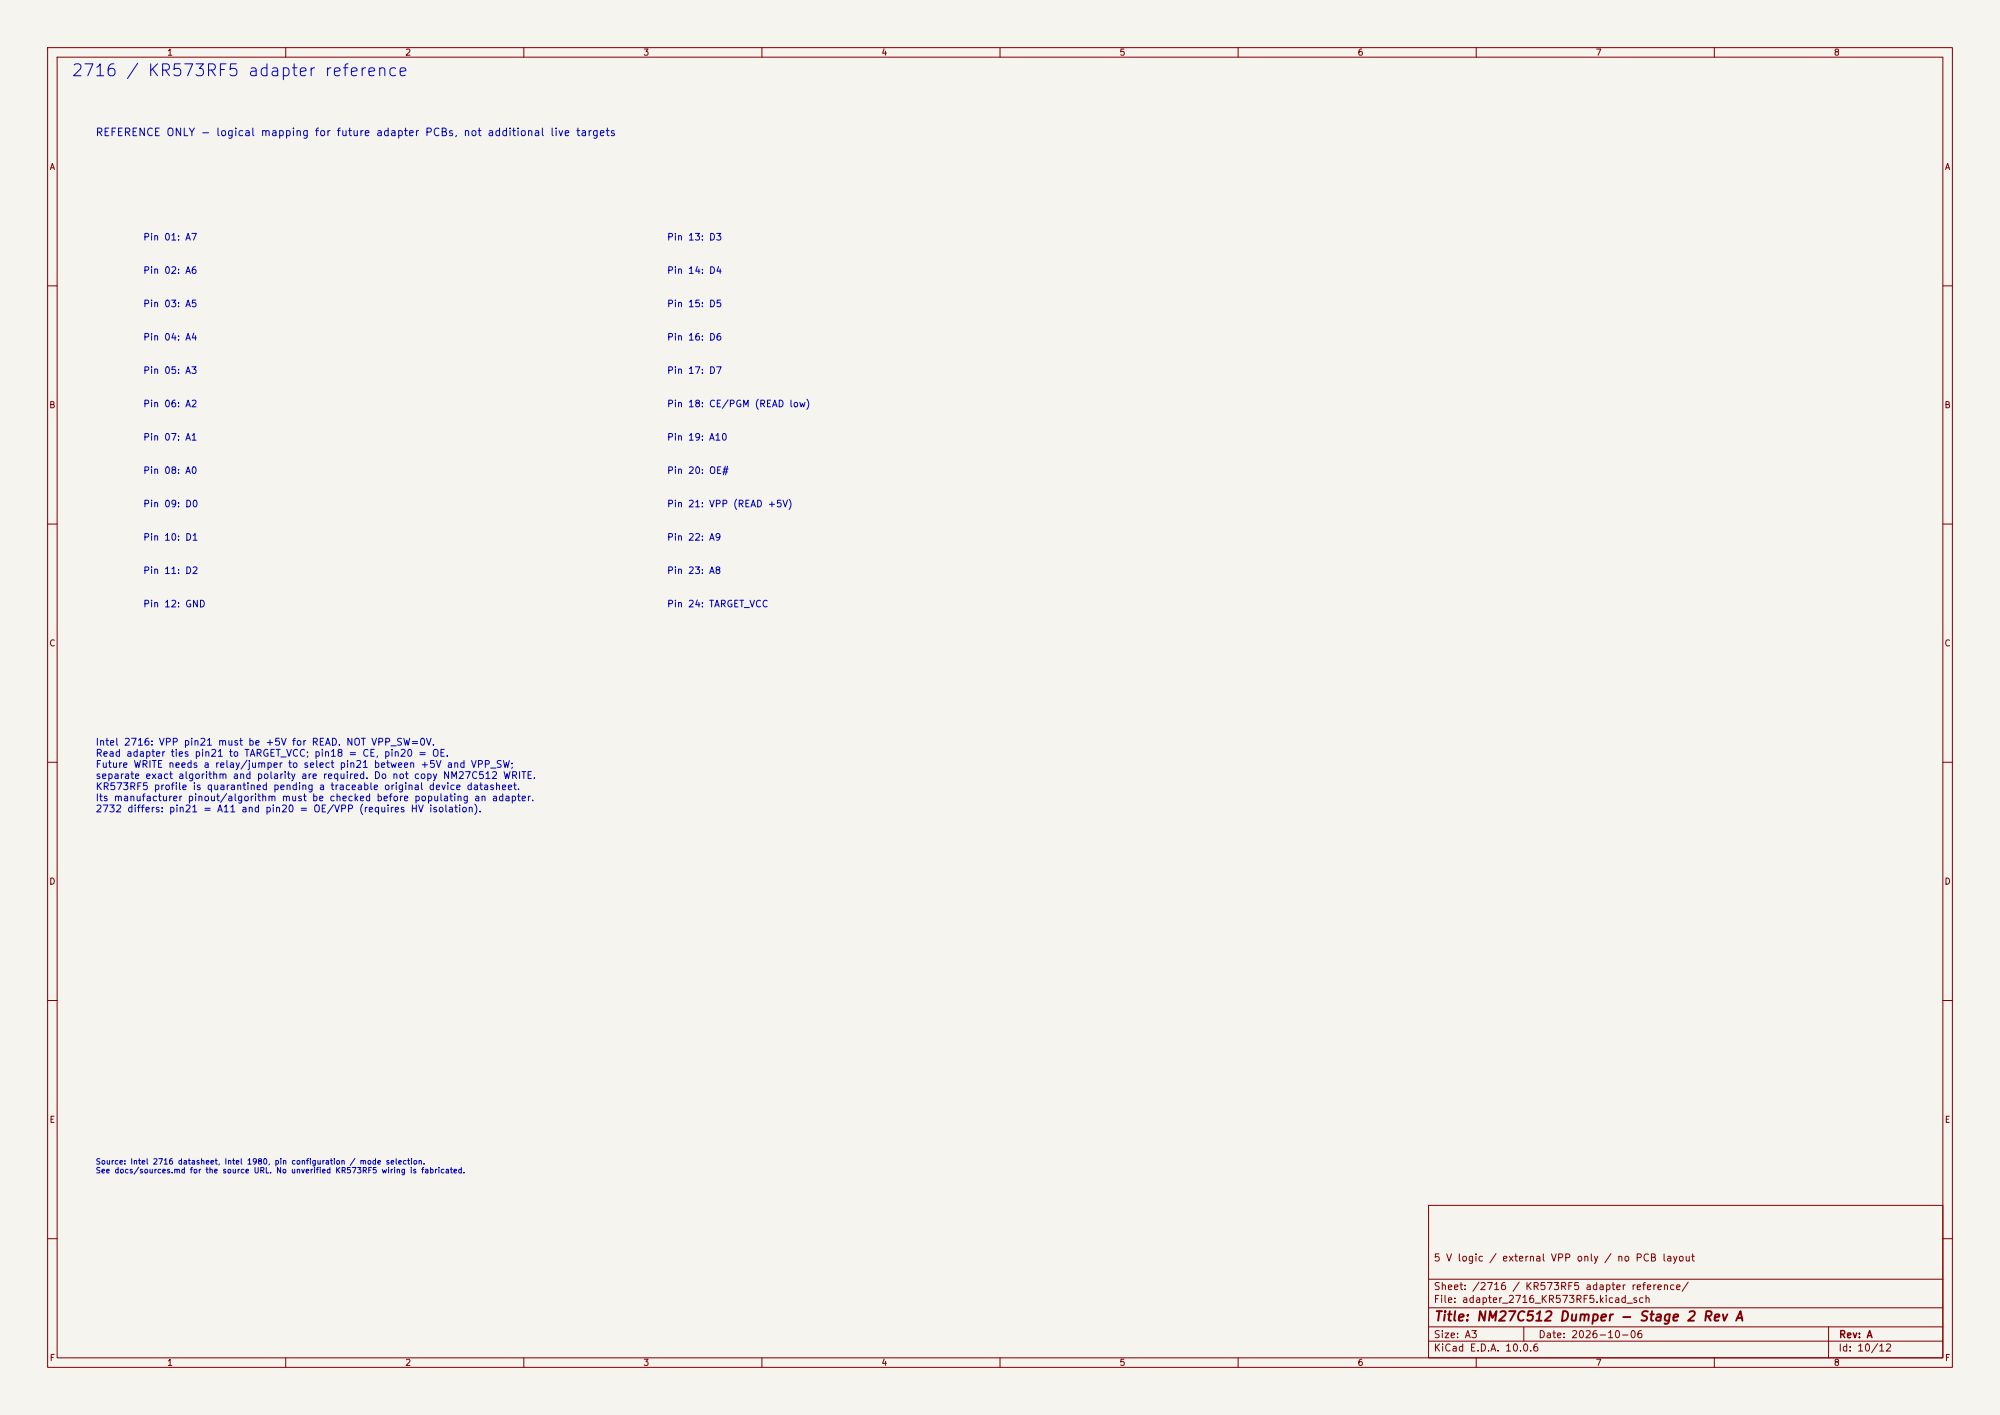
[picture p22: page 10]

2732 differs: pin21 = A11 and pin20 = OE/VPP (requires HV isolation). Pin 09: D0 Pin 01: A7 REFERENCE ONLY - logical mapping for future adapter PCBs, not additional live targets

Pin 23: A8 Pin 16: D6 Pin 14: D4 Pin 19: A10 Pin 13: D3 Pin 15: D5 Pin 17: D7 Pin 18: CE/PGM (READ low) Pin 10: D1

Pin 08: A0 Pin 11: D2 Pin 12: GND

Pin 21: VPP (READ +5V) Pin 22: A9 Pin 24: TARGET_VCC

Intel 2716: VPP pin21 must be +5V for READ. NOT VPP_SW=0V.
Read adapter ties pin21 to TARGET_VCC; pin18 = CE, pin20 = OE.
Future WRITE needs a relay/jumper to select pin21 between +5V and VPP_SW;
separate exact algorithm and polarity are required. Do not copy NM27C512 WRITE.
KR573RF5 profile is quarantined pending a traceable original device datasheet.
Its manufacturer pinout/algorithm must be checked before populating an adapter.

Source: Intel 2716 datasheet, Intel 1980, pin configuration / mode selection. See docs/sources.md for the source URL. No unverified KR573RF5 wiring is fabricated.

5 V logic / external VPP only / no PCB layout

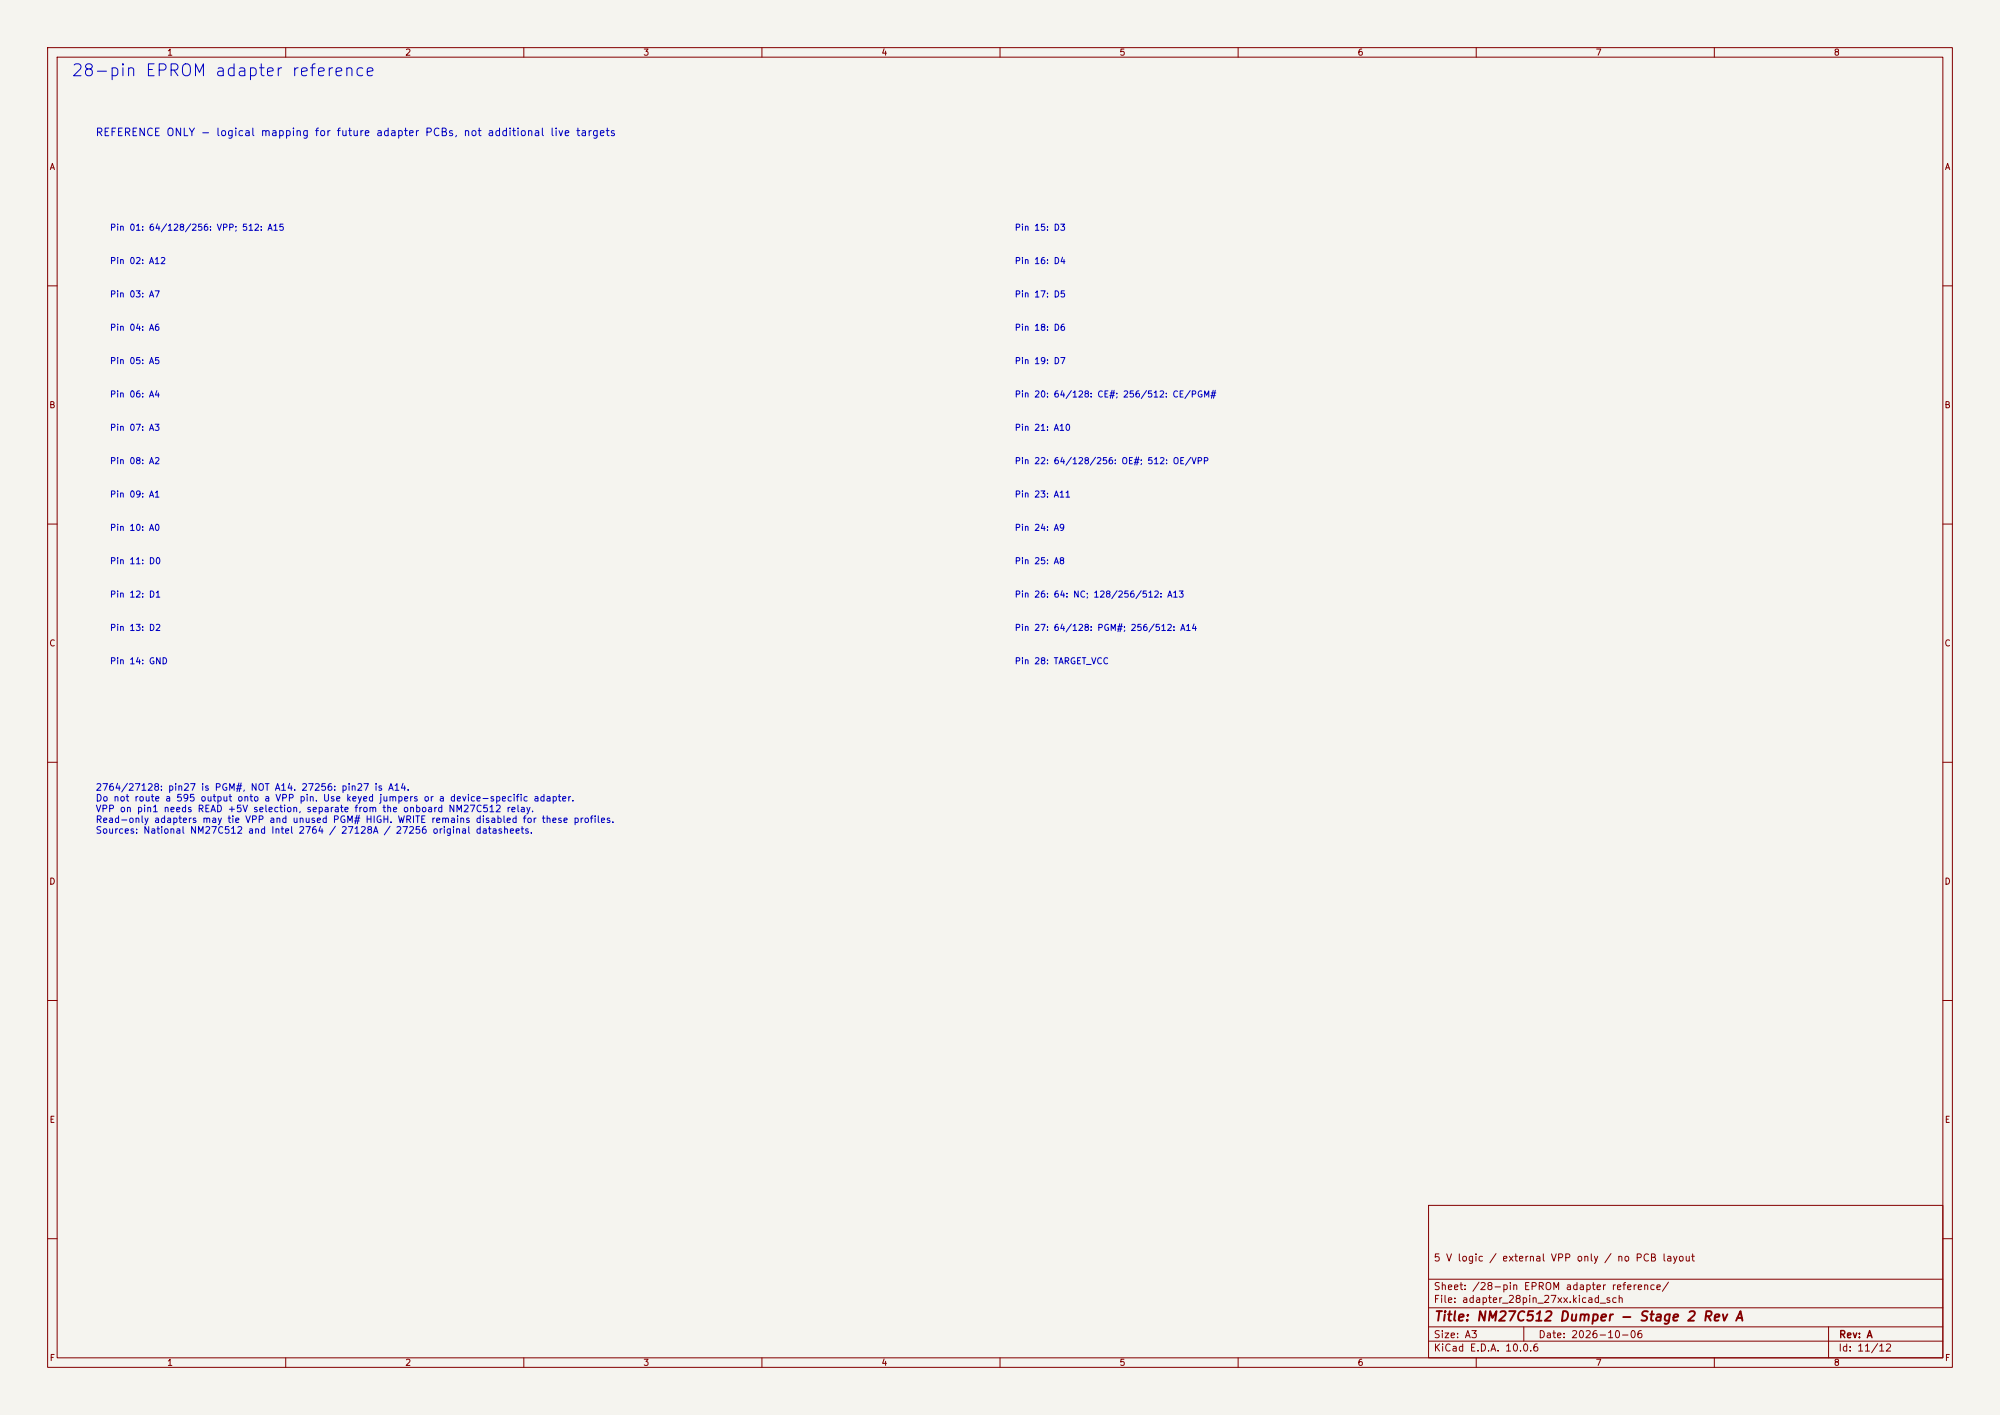
[picture p23: page 11]

Pin 01: 64/128/256: VPP; 512: A15 Pin 03: A7 28-pin EPROM adapter reference

Pin 22: 64/128/256: OE#; 512: OE/VPP

Pin 25: A8 Pin 23: A11 Pin 26: 64: NC; 128/256/512: A13 Pin 28: TARGET_VCC

Pin 13: D2 Pin 14: GND 2764/27128: pin27 is PGM#, NOT A14. 27256: pin27 is A14. Do not route a 595 output onto a VPP pin. Use keyed jumpers or a device-specific adapter. VPP on pin1 needs READ +5V selection, separate from the onboard NM27C512 relay.

5 V logic / external VPP only / no PCB layout

Sheet: /28-pin EPROM adapter reference/
File: adapter_28pin_27xx.kicad_sch

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
## File: adapter_32pin_JEDEC.kicad_sch

## Sheet: /32-pin JEDEC adapter reference/

## 5 V logic / external VPP only / no PCB layout

Pin 08: A4 Pin 09: A3 Pin 07: A5 Pin 05: A7 Pin 06: A6 Pin 04: A12 | Pin 23: A10 Pin 22: CE / CE-PGM# (family dependent) Pin 18: D4 Pin 19: D5 Pin 17: D3 Pin 20: D6 Pin 21: D7 Pin 24: 010/020/040: OE#; 080: OE/VPP

Pin 14: D1 Pin 10: A2 Pin 11: A1 National 27C010/020/040/080 package comparison is the source for these pin roles. Use a device-specific adapter; role changes require keyed selection or HV-rated switching. Pin1 must never receive VPP when it is A19. Pin24 changes from OE to OE/VPP on 080. 27C080 cannot use a generic 32-pin VPP-pin1 adapter. Program profiles remain disabled. Read VPP pins require +5V, not an unpowered VPP_SW. See device_profiles.json for verified status. Pin 15: D2 Pin 13: D0 Pin 12: A0 Pin 16: GND

# Pin 27: A8 Pin 25: A11 Pin 29: A14 Pin 32: TARGET_VCC

Pin 28: A13 Pin 31: 010/020: PGM#; 040/080: A18 Pin 26: A9 Pin 30: 010: NC; 020/040/080: A17 32-pin JEDEC adapter reference

Pin 02: A16 Pin 01: 010/020/040: VPP; 080: A19 Pin 03: A15 REFERENCE ONLY - logical mapping for future adapter PCBs, not additional live targets
