IlyaBOT/LunarView3/Dumper-Lite/validation/pth_two_sided_connections.csv

Ref | Pad | Net | X_mm | Y_mm | Drill_mm | Tracks_touching_pad
U5 | 28 | +5V | 117.0 | 59.85 | 0.8 | F.Cu+B.Cu
J2 | 5 | RESET | 63.21 | 85.08 | 1.0 | F.Cu+B.Cu
