IlyaBOT/LunarView3/Adapter-KR573RF5/validation/Adapter_Bottom.png

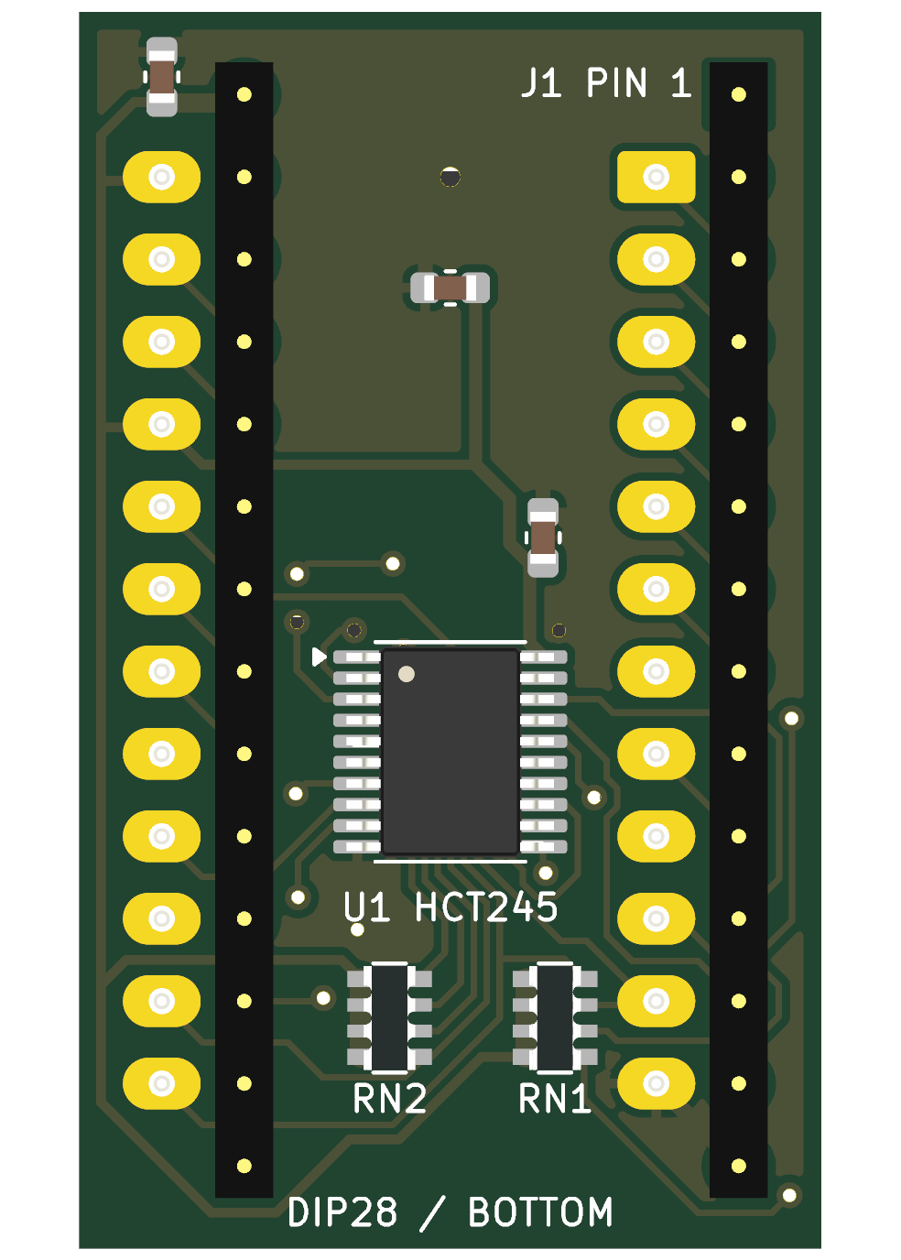
Adapter-KR573RF5/validation/Adapter_Bottom.png
