IlyaBOT/LunarView3/docs/cnc-k4/Calibration_25x25_2540dpi.png

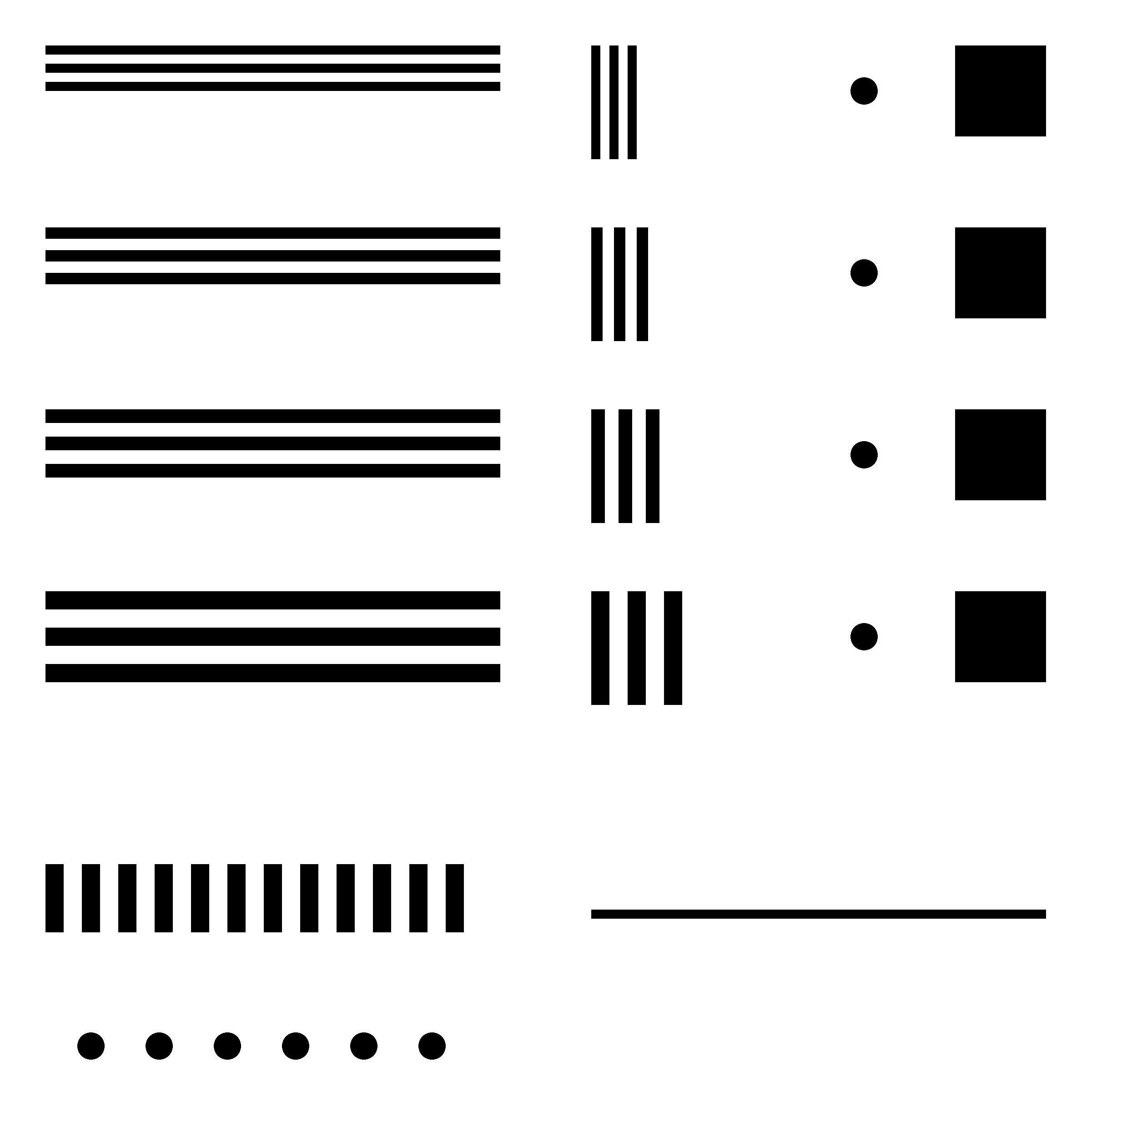
docs/cnc-k4/Calibration_25x25_2540dpi.png
