IlyaBOT/LunarView3/Dumper-Lite/validation/Lite_With_3D.png

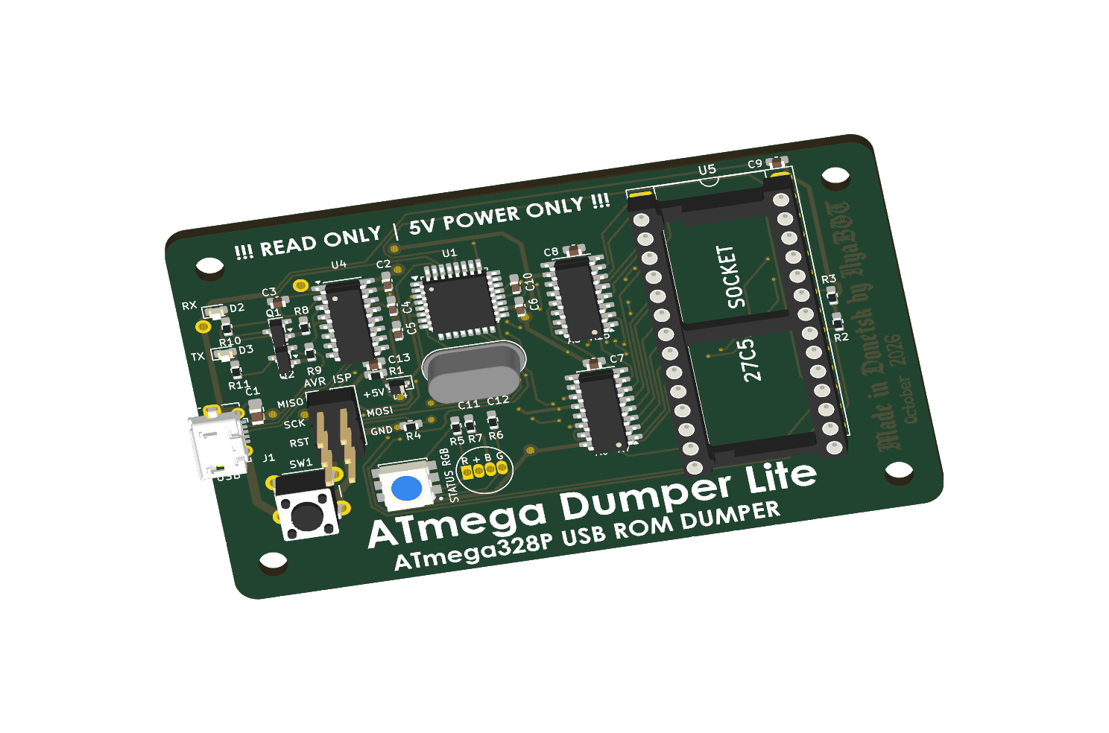
Dumper-Lite/validation/Lite_With_3D.png
