IlyaBOT/LunarView3/Dumper-Lite/validation/Placement_Top.png

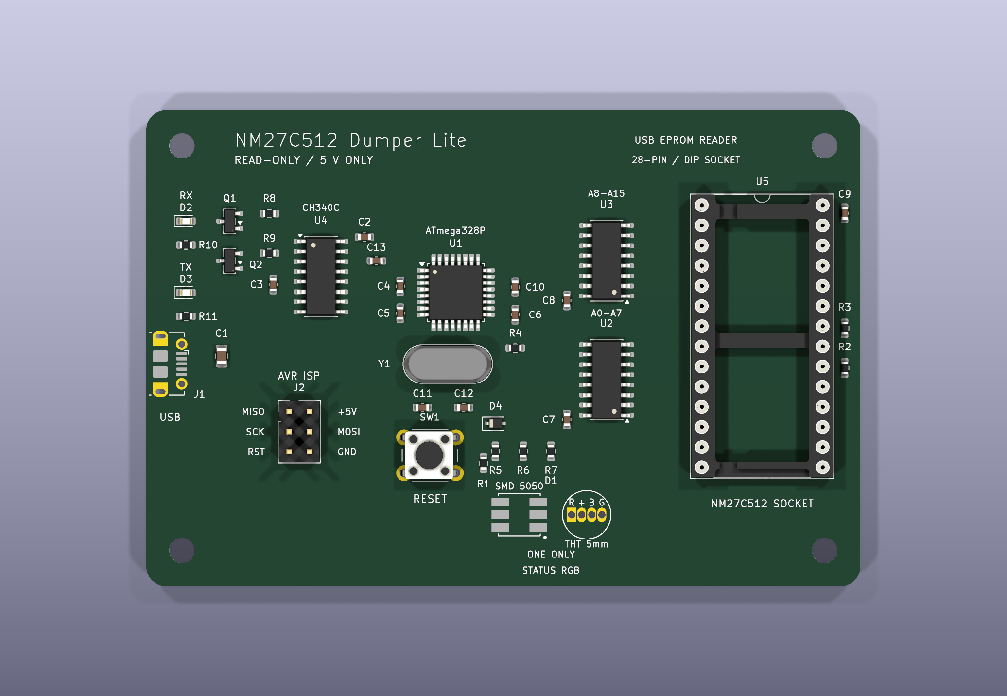
Dumper-Lite/validation/Placement_Top.png
