IlyaBOT/LunarView3/Dumper-Lite/validation/Routed_Before_3D.png

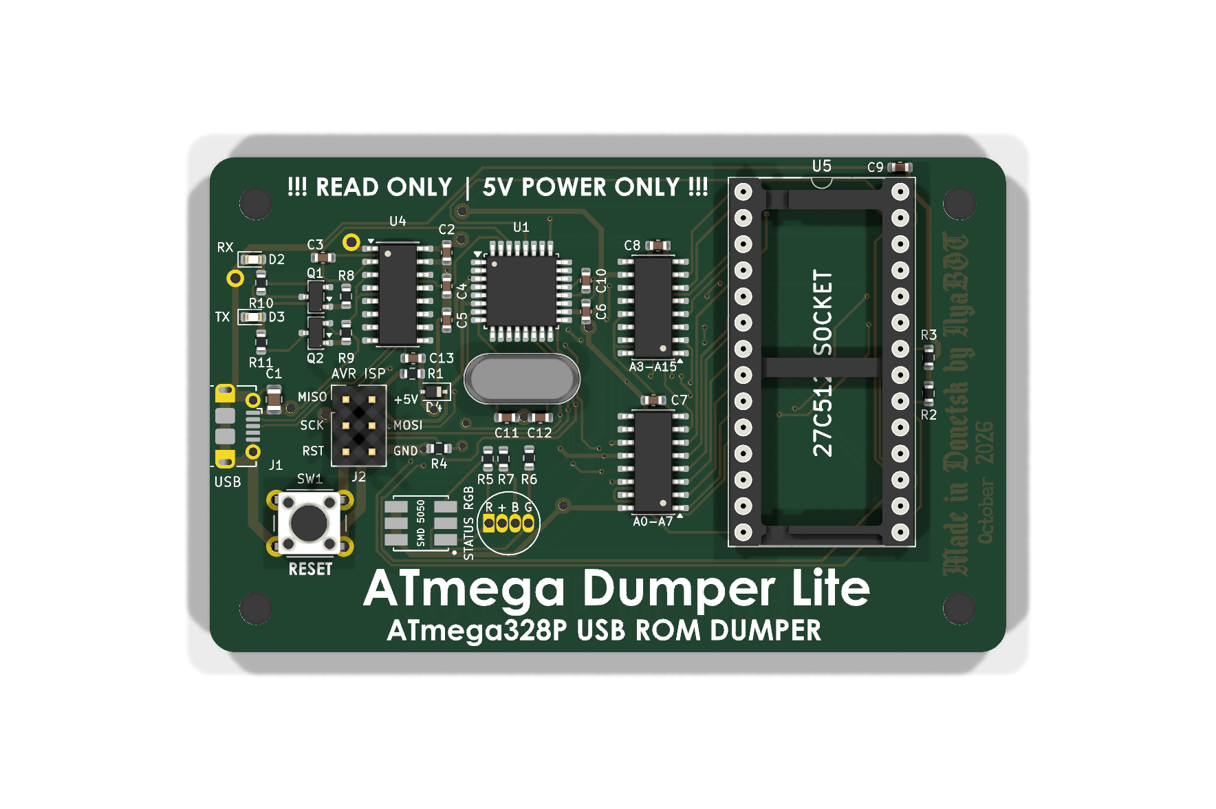
Dumper-Lite/validation/Routed_Before_3D.png
