IlyaBOT/LunarView3/Lunar-Writer/validation/copper-preview.png

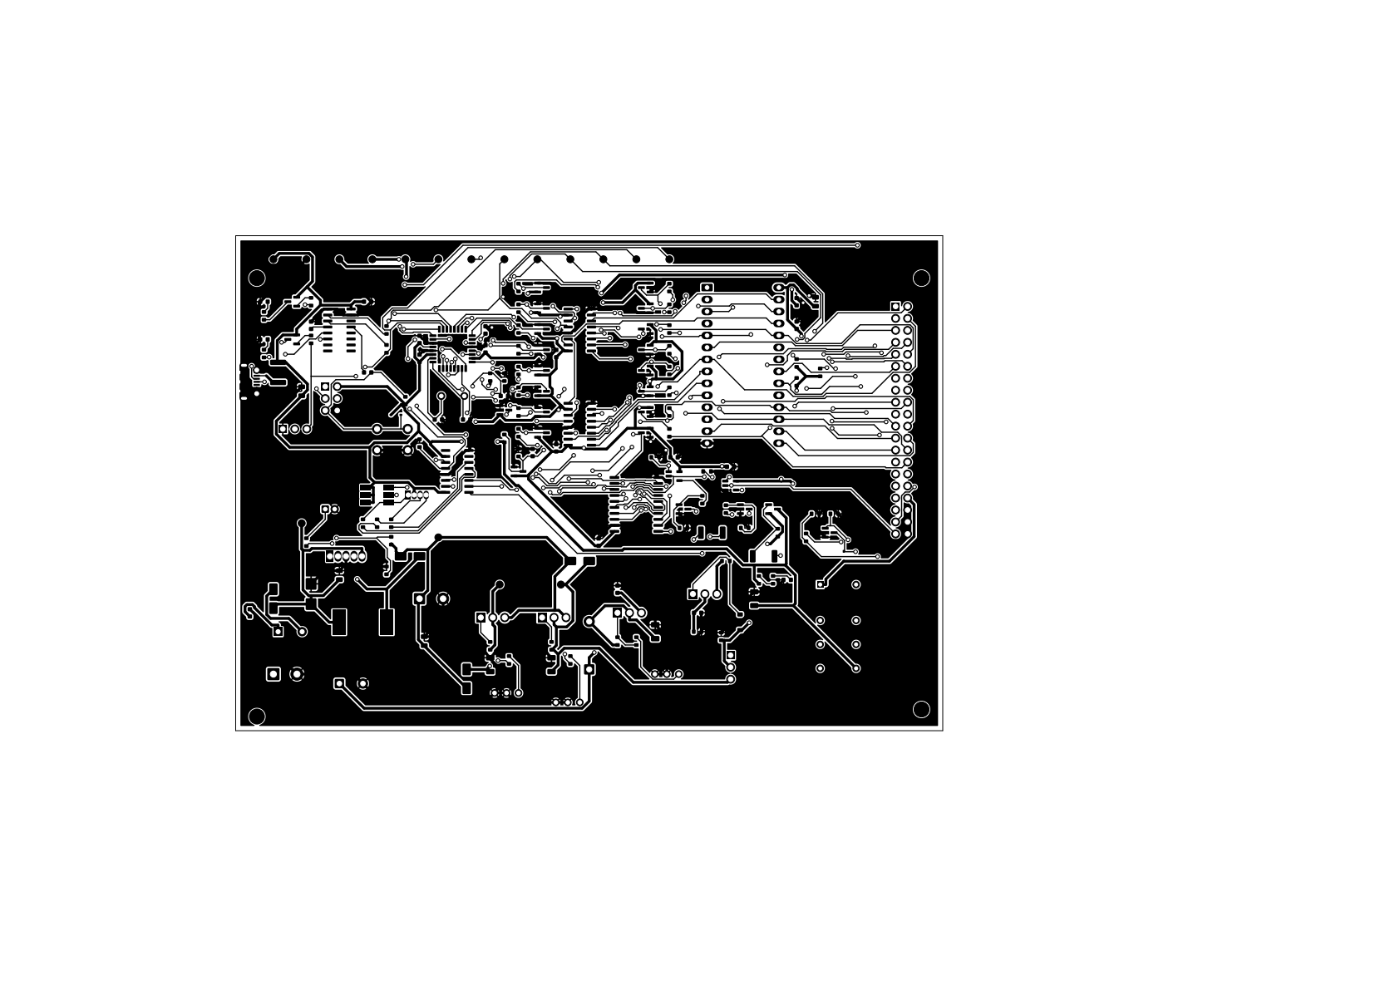
Lunar-Writer/validation/copper-preview.png
