IlyaBOT/LunarView3/validation/lunar-products-2026-10-12/comparison-ui.png

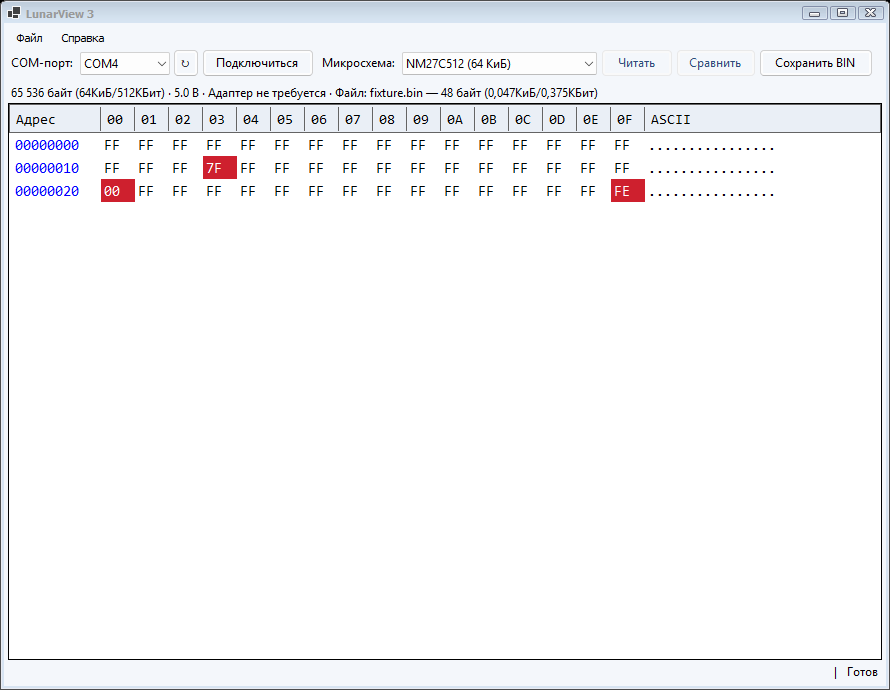
validation/lunar-products-2026-10-12/comparison-ui.png
