IlyaBOT/LunarView3/validation/RGB_Mounting.png

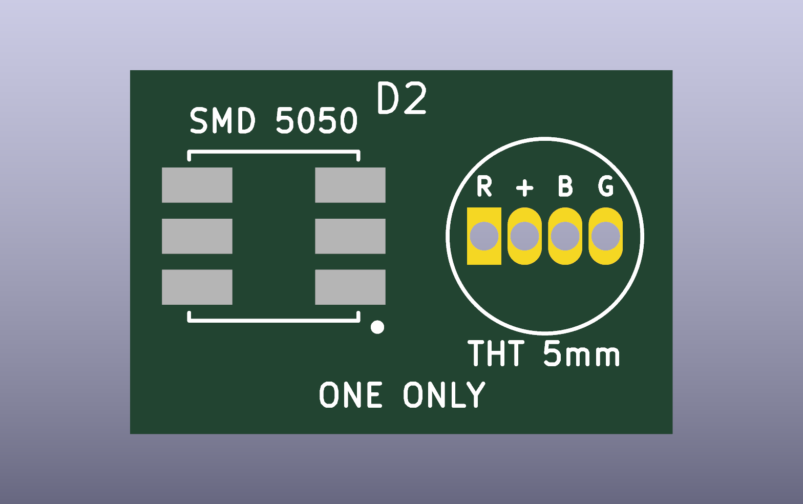
validation/RGB_Mounting.png
