IlyaBOT/LunarView3/Lunar-Writer/Lunar_Writer_Schematic.pdf

1 | 2 | 3 | 4 | 5 | 6 | 7 | 8 | 9 | 10 | 11
1 | 2 | 3 | 4 | 5 | 6 | 7 | 8 | 9 | 10 | 11

AB

C

D

E

## FGH

AB

C

D

E

## FGH Date: 2026-10-12

Size: A2 | Rev: 1
KiCad E.D.A. 10.0.6 | Id: 1/13

# Title: Lunar Writer - Rev. 1

## File: Lunar_Writer.kicad_sch

## Sheet: /

## USB 5V logic / separate 12-24V DC input / regulated VPP / default READ

28-pin EPROM adapter reference

File: adapter_28pin_27xx.kicad_sch

External VPP / high-side switch / 6.25 V regulator File: programming_power.kicad_sch Test points and safety sequence

File: testpoints_safety.kicad_sch

Address generator and NM27C512 direct socket File: address_target.kicad_sch 32-pin JEDEC adapter reference

File: adapter_32pin_JEDEC.kicad_sch | 2716 / KR573RF5 adapter reference

File: adapter_2716_KR573RF5.kicad_sch

Data protection and status LEDs
File: data_status.kicad_sch Fast VPP pulse switch / indicator / ADC monitor File: programming_pulse.kicad_sch 12-24V protection / boost / regulated VPP

File: writer_supply.kicad_sch

Default-read relay / target connector / monitoring

File: target_interface.kicad_sch

## USB / CH340C / ATmega / clock / reset / ISP / UART

File: controller.kicad_sch TTL-compatible bidirectional data bus

# File: ttl_bus.kicad_sch Open sheet 8

## LUNAR WRITER / USB 5V LOGIC / SEPARATE 12-24V INPUT / RESET = READ

## Open sheet 11

Boost generates ~30V from 12-24V input. VPP rails are adjusted separately and selected by JP1. Direct NM27C512 socket uses 12.75V VPP / 6.25V VCC. Other EPROMs require verified profiles and adapters. Default firmware locks WRITE until measured commissioning. One target at a time.

# Open sheet 12 Open sheet 9

Open sheet 3 Open sheet 6 | Open sheet 7 Open sheet 4 Open sheet 10 Open sheet 5 Open sheet 2 Lunar Writer / parallel EPROM reader-programmer

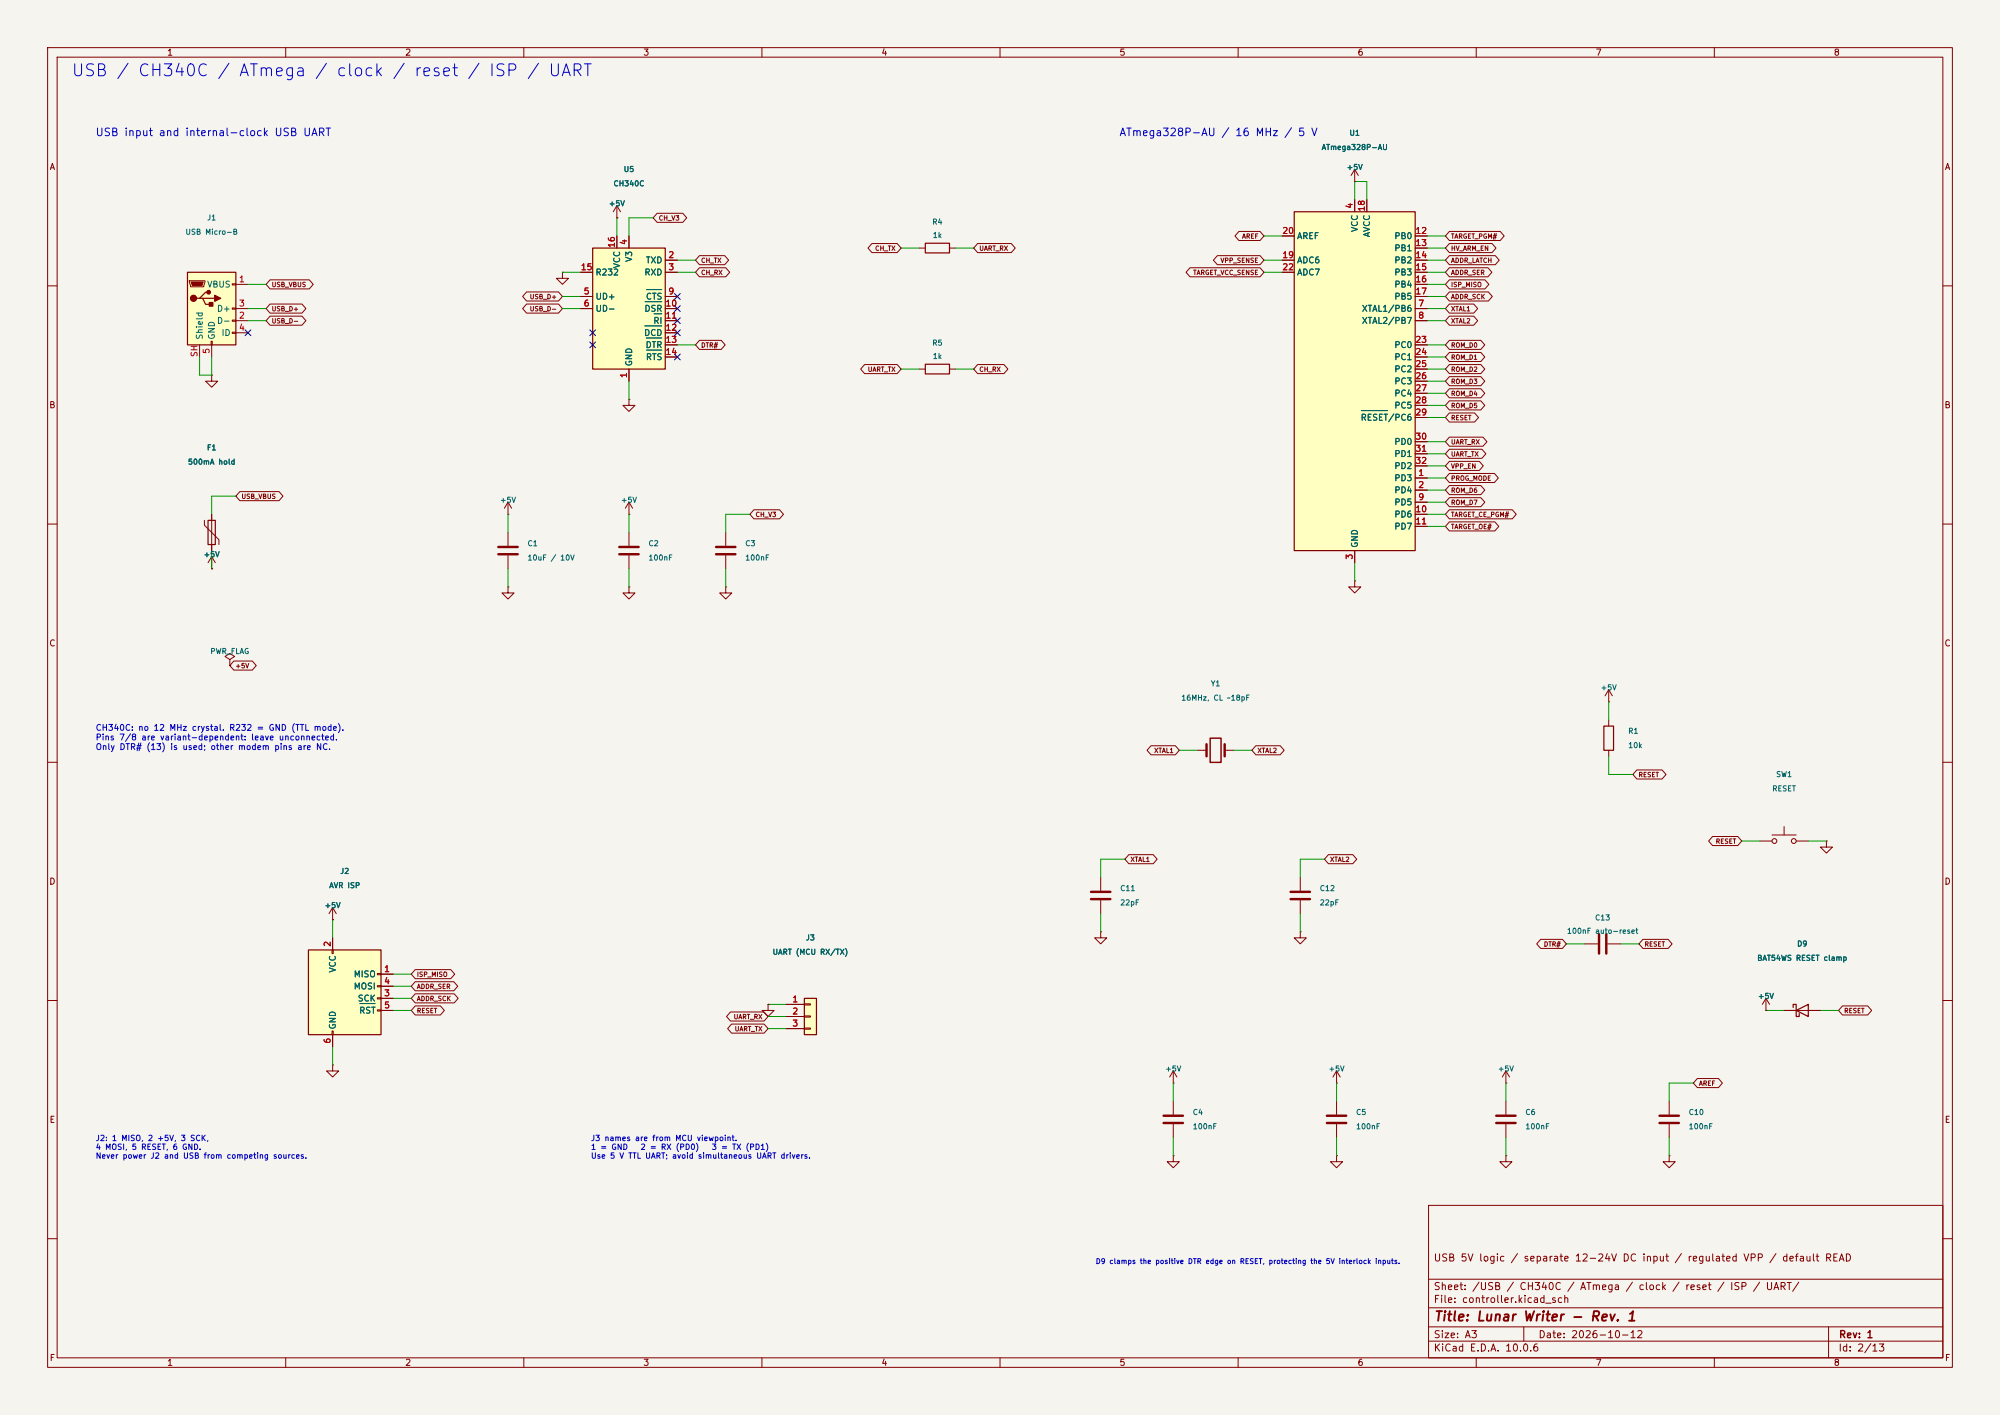
[picture p32: page 2]

USB / CH340C / ATmega / clock / reset / ISP / UART

USB input and internal-clock USB UART

J3 UART (MCU RX/TX) GND

4 UD+ 5 UD- 6 CTS 9 DSR 10 RI 11 DCD 12 DTR 13 RTS 14 R232 15 VCC 16 +5V

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

J3 UART (MCU RX/TX) 1

USB 5V logic / separate 12-24V DC input / regulated VPP / default READ

Sheet: /USB / CH340C / ATmega / clock / reset / ISP / UART/
File: controller.kicad_sch

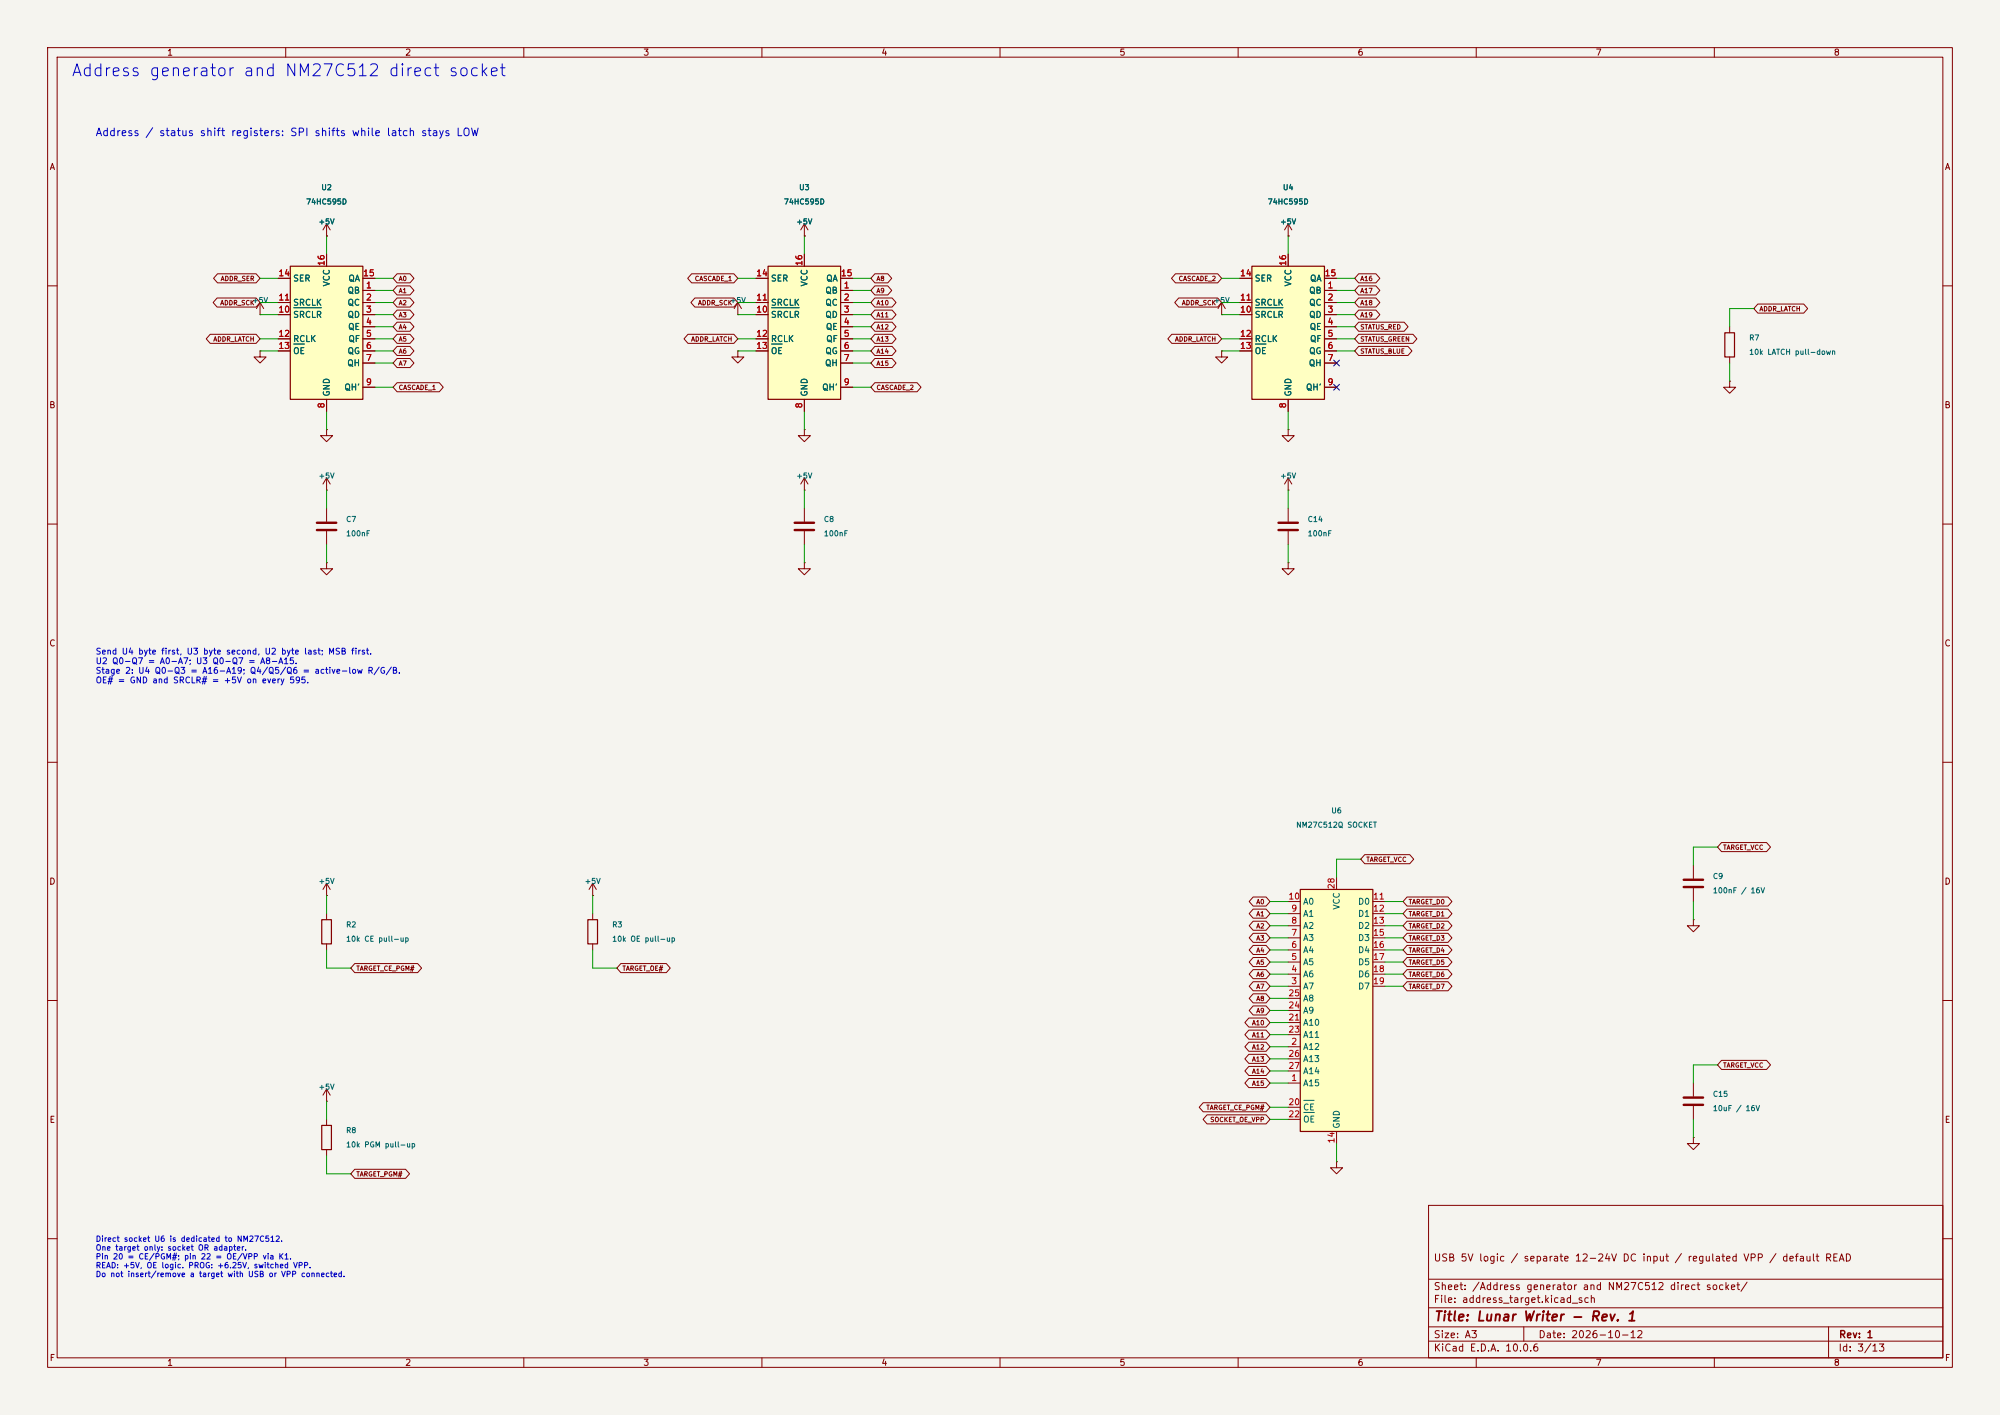
[picture p33: page 3]

Address generator and NM27C512 direct socket

Address / status shift registers: SPI shifts while latch stays LOW

OE# = GND and SRCLR# = +5V on every 595. Direct socket U6 is dedicated to NM27C512. One target only: socket OR adapter. Pin 20 = CE/PGM#; pin 22 = OE/VPP via K1. READ: +5V, OE logic. PROG: +6.25V, switched VPP. Do not insert/remove a target with USB or VPP connected.

SRCLR 10 SRCLK 11 RCLK 12 OE 13

ADDR_LATCH Send U4 byte first, U3 byte second, U2 byte last; MSB first. U2 Q0-Q7 = A0-A7; U3 Q0-Q7 = A8-A15. Stage 2: U4 Q0-Q3 = A16-A19; Q4/Q5/Q6 = active-low R/G/B.

USB 5V logic / separate 12-24V DC input / regulated VPP / default READ

Sheet: /Address generator and NM27C512 direct socket/
File: address_target.kicad_sch

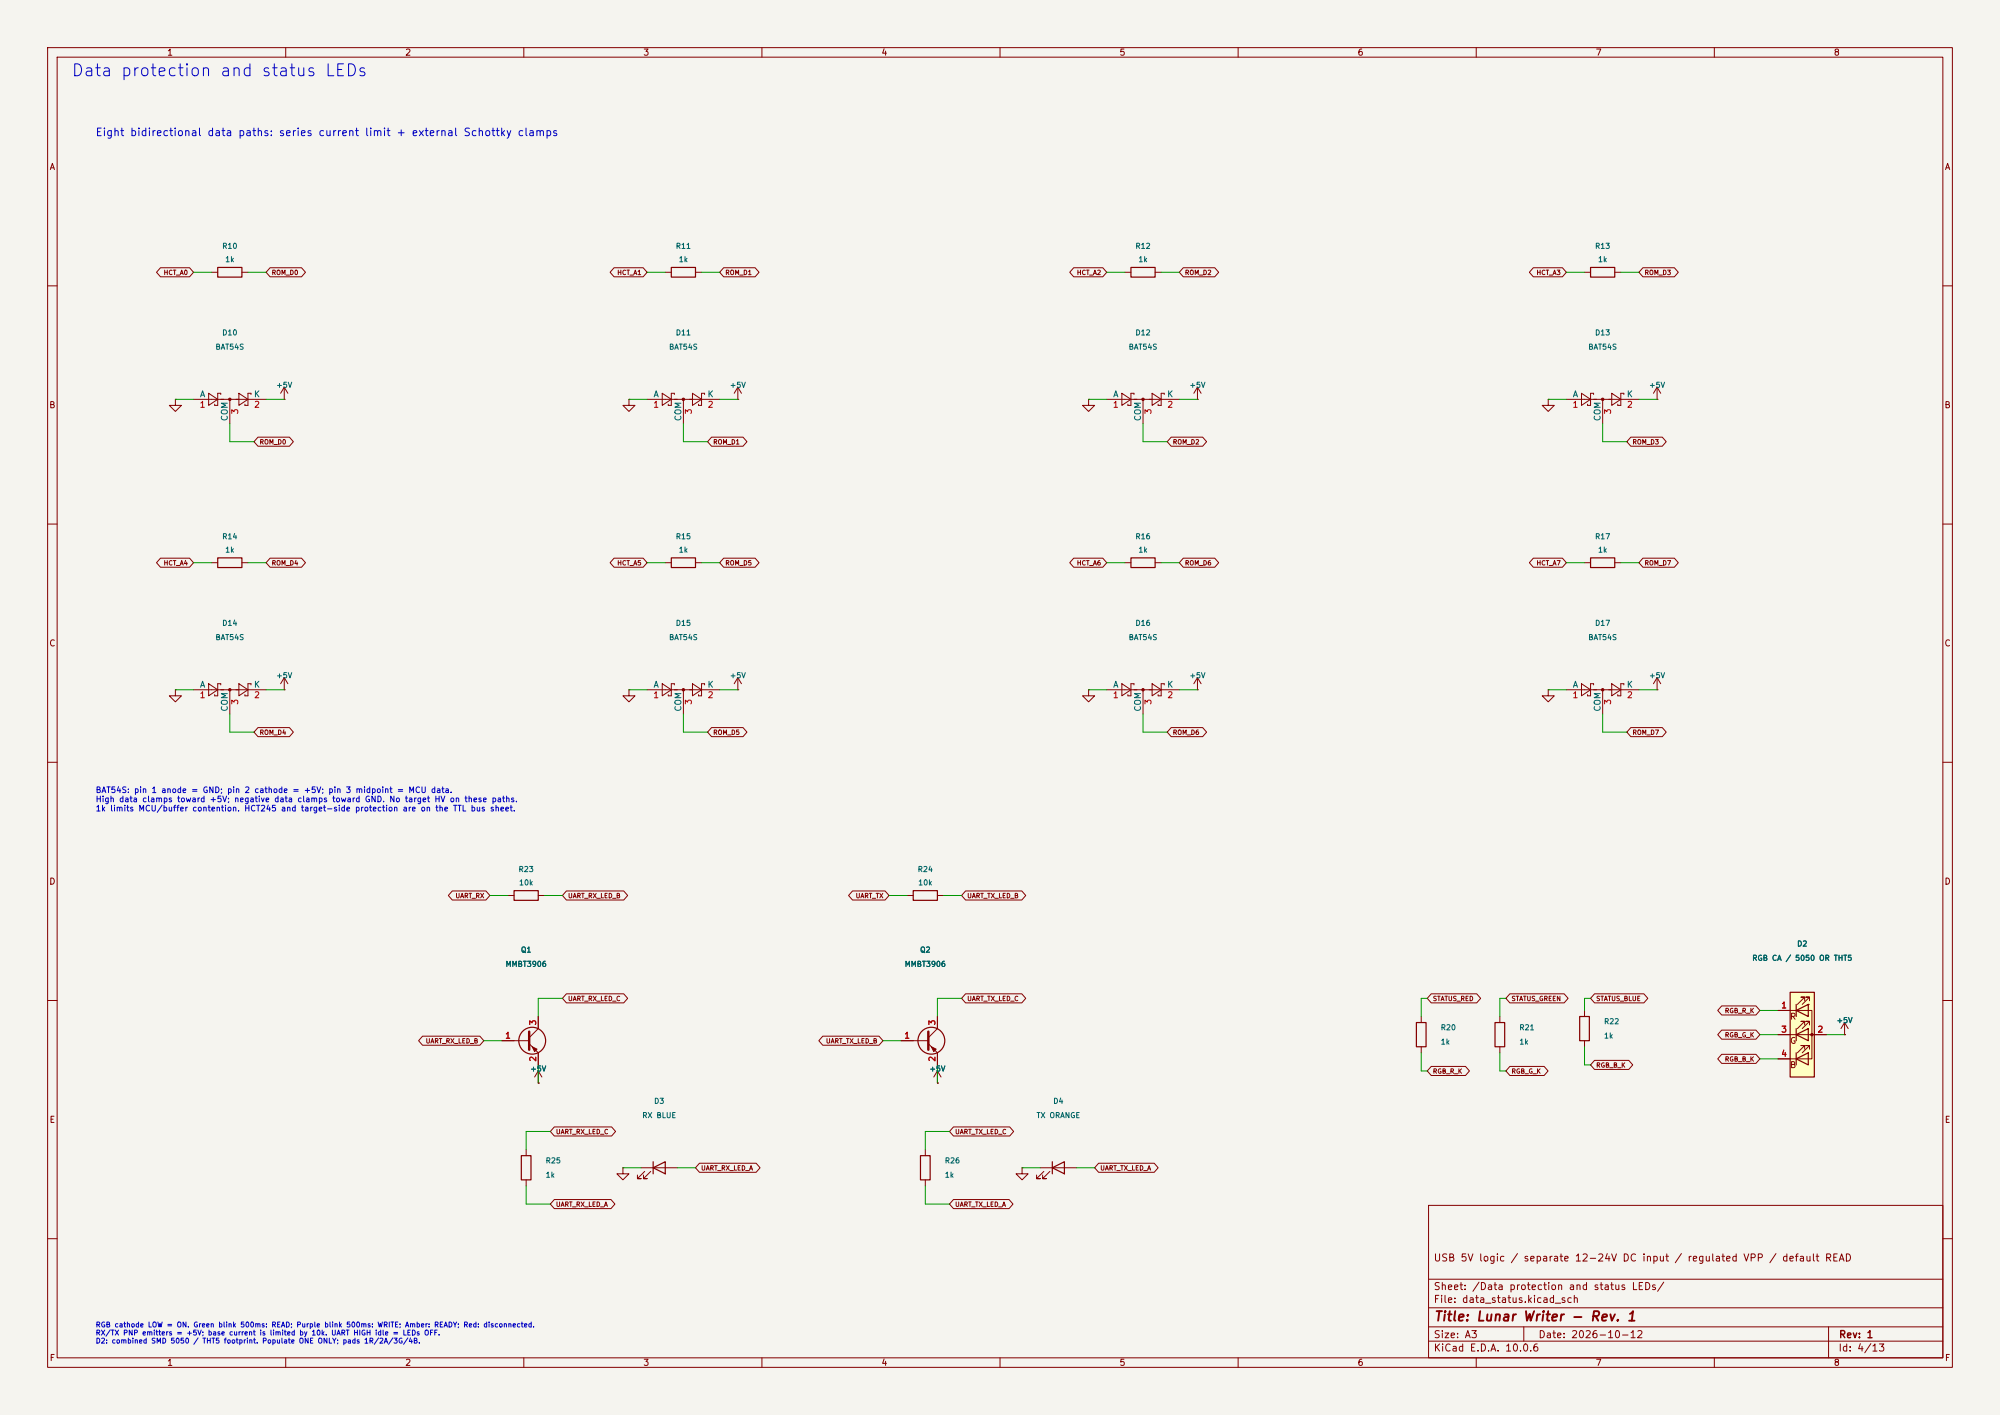
[picture p34: page 4]

Data protection and status LEDs

ROM_D3 Eight bidirectional data paths: series current limit + external Schottky clamps

USB 5V logic / separate 12-24V DC input / regulated VPP / default READ

Sheet: /Data protection and status LEDs/
File: data_status.kicad_sch

RGB cathode LOW = ON. Green blink 500ms: READ; Purple blink 500ms: WRITE; Amber: READY; Red: disconnected. RX/TX PNP emitters = +5V; base current is limited by 10k. UART HIGH idle = LEDs OFF. D2: combined SMD 5050 / THT5 footprint. Populate ONE ONLY; pads 1R/2A/3G/4B.

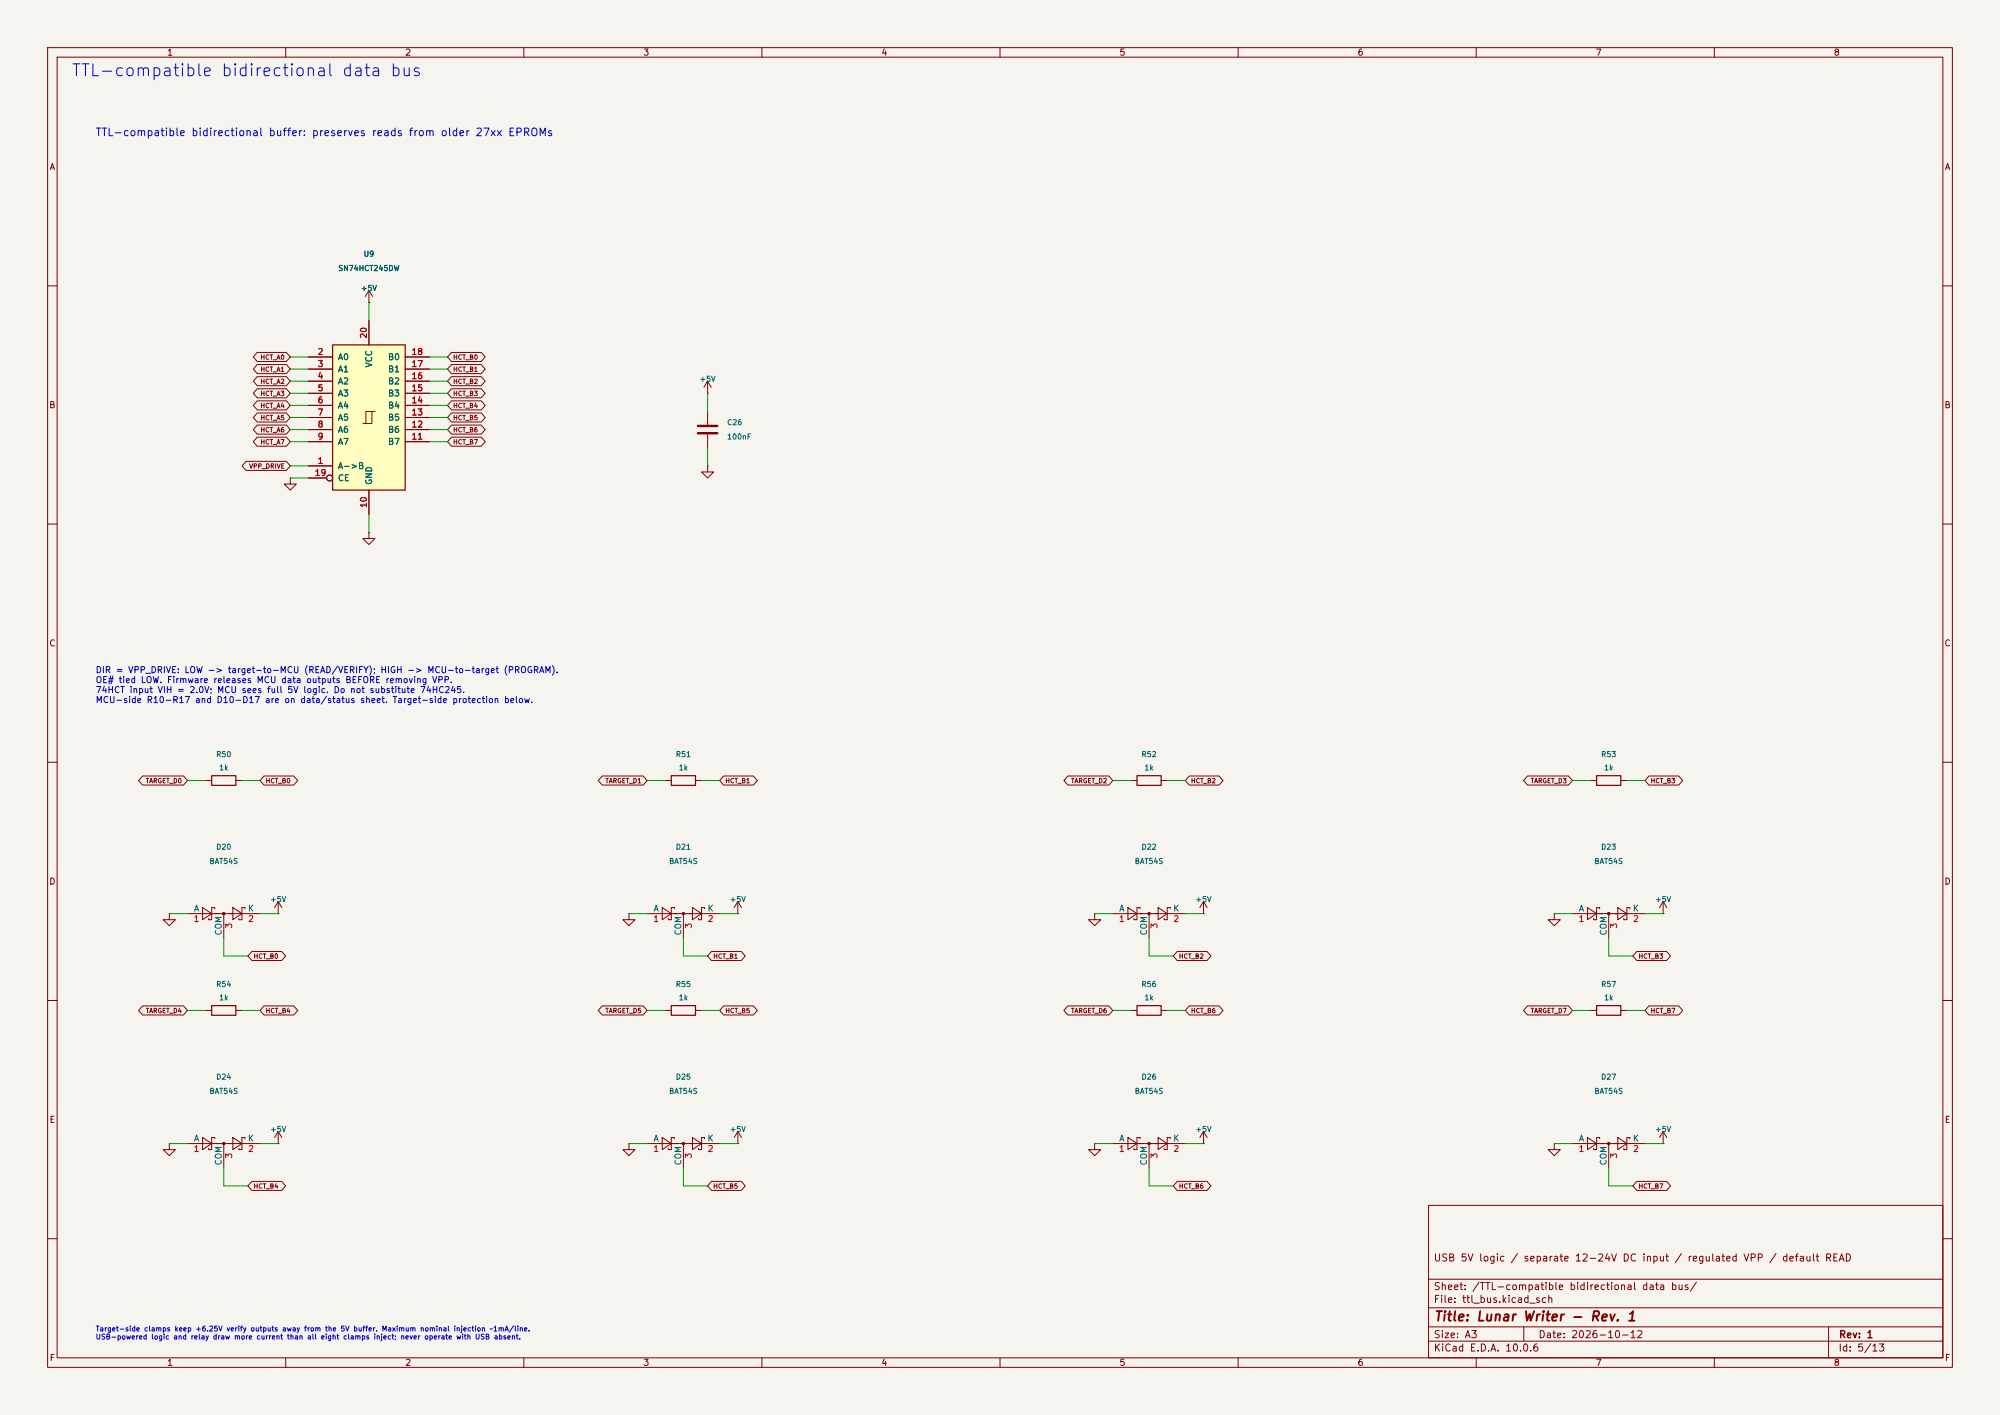
[picture p35: page 5]

OE# tied LOW. Firmware releases MCU data outputs BEFORE removing VPP. 74HCT input VIH = 2.0V; MCU sees full 5V logic. Do not substitute 74HC245. MCU-side R10-R17 and D10-D17 are on data/status sheet. Target-side protection below. TTL-compatible bidirectional data bus

TTL-compatible bidirectional buffer: preserves reads from older 27xx EPROMs DIR = VPP_DRIVE: LOW -> target-to-MCU (READ/VERIFY); HIGH -> MCU-to-target (PROGRAM).

USB 5V logic / separate 12-24V DC input / regulated VPP / default READ

Sheet: /TTL-compatible bidirectional data bus/
File: ttl_bus.kicad_sch

Target-side clamps keep +6.25V verify outputs away from the 5V buffer. Maximum nominal injection ~1mA/line. USB-powered logic and relay draw more current than all eight clamps inject; never operate with USB absent.

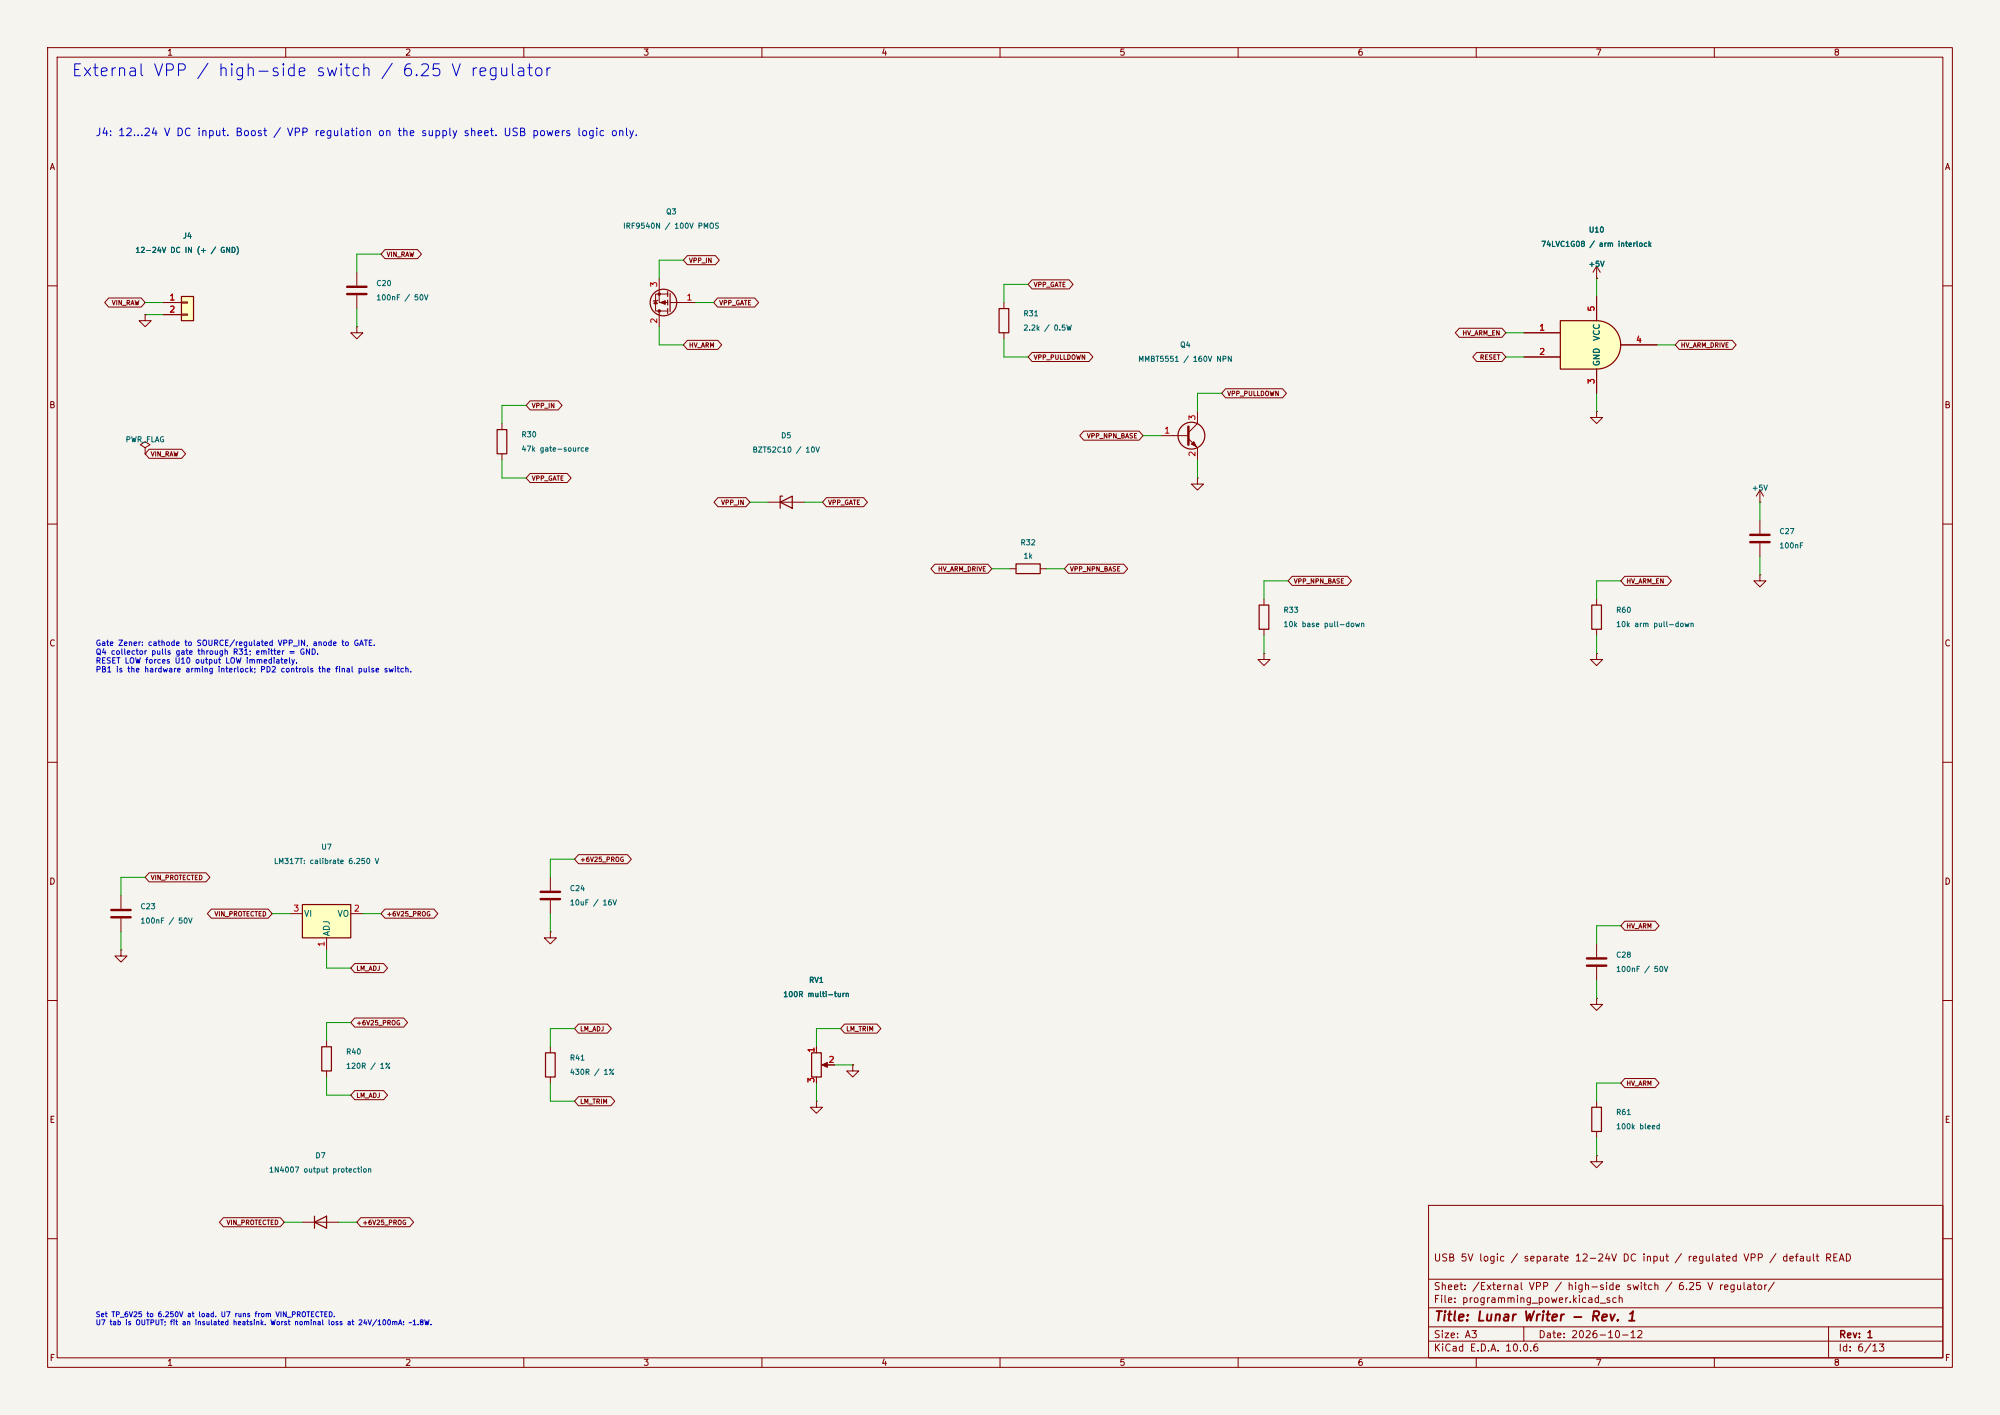
[picture p36: page 6]

External VPP / high-side switch / 6.25 V regulator

J4: 12...24 V DC input. Boost / VPP regulation on the supply sheet. USB powers logic only.

VPP_GATE Gate Zener: cathode to SOURCE/regulated VPP_IN, anode to GATE. Q4 collector pulls gate through R31; emitter = GND. RESET LOW forces U10 output LOW immediately. PB1 is the hardware arming interlock; PD2 controls the final pulse switch.

USB 5V logic / separate 12-24V DC input / regulated VPP / default READ

Sheet: /External VPP / high-side switch / 6.25 V regulator/
File: programming_power.kicad_sch

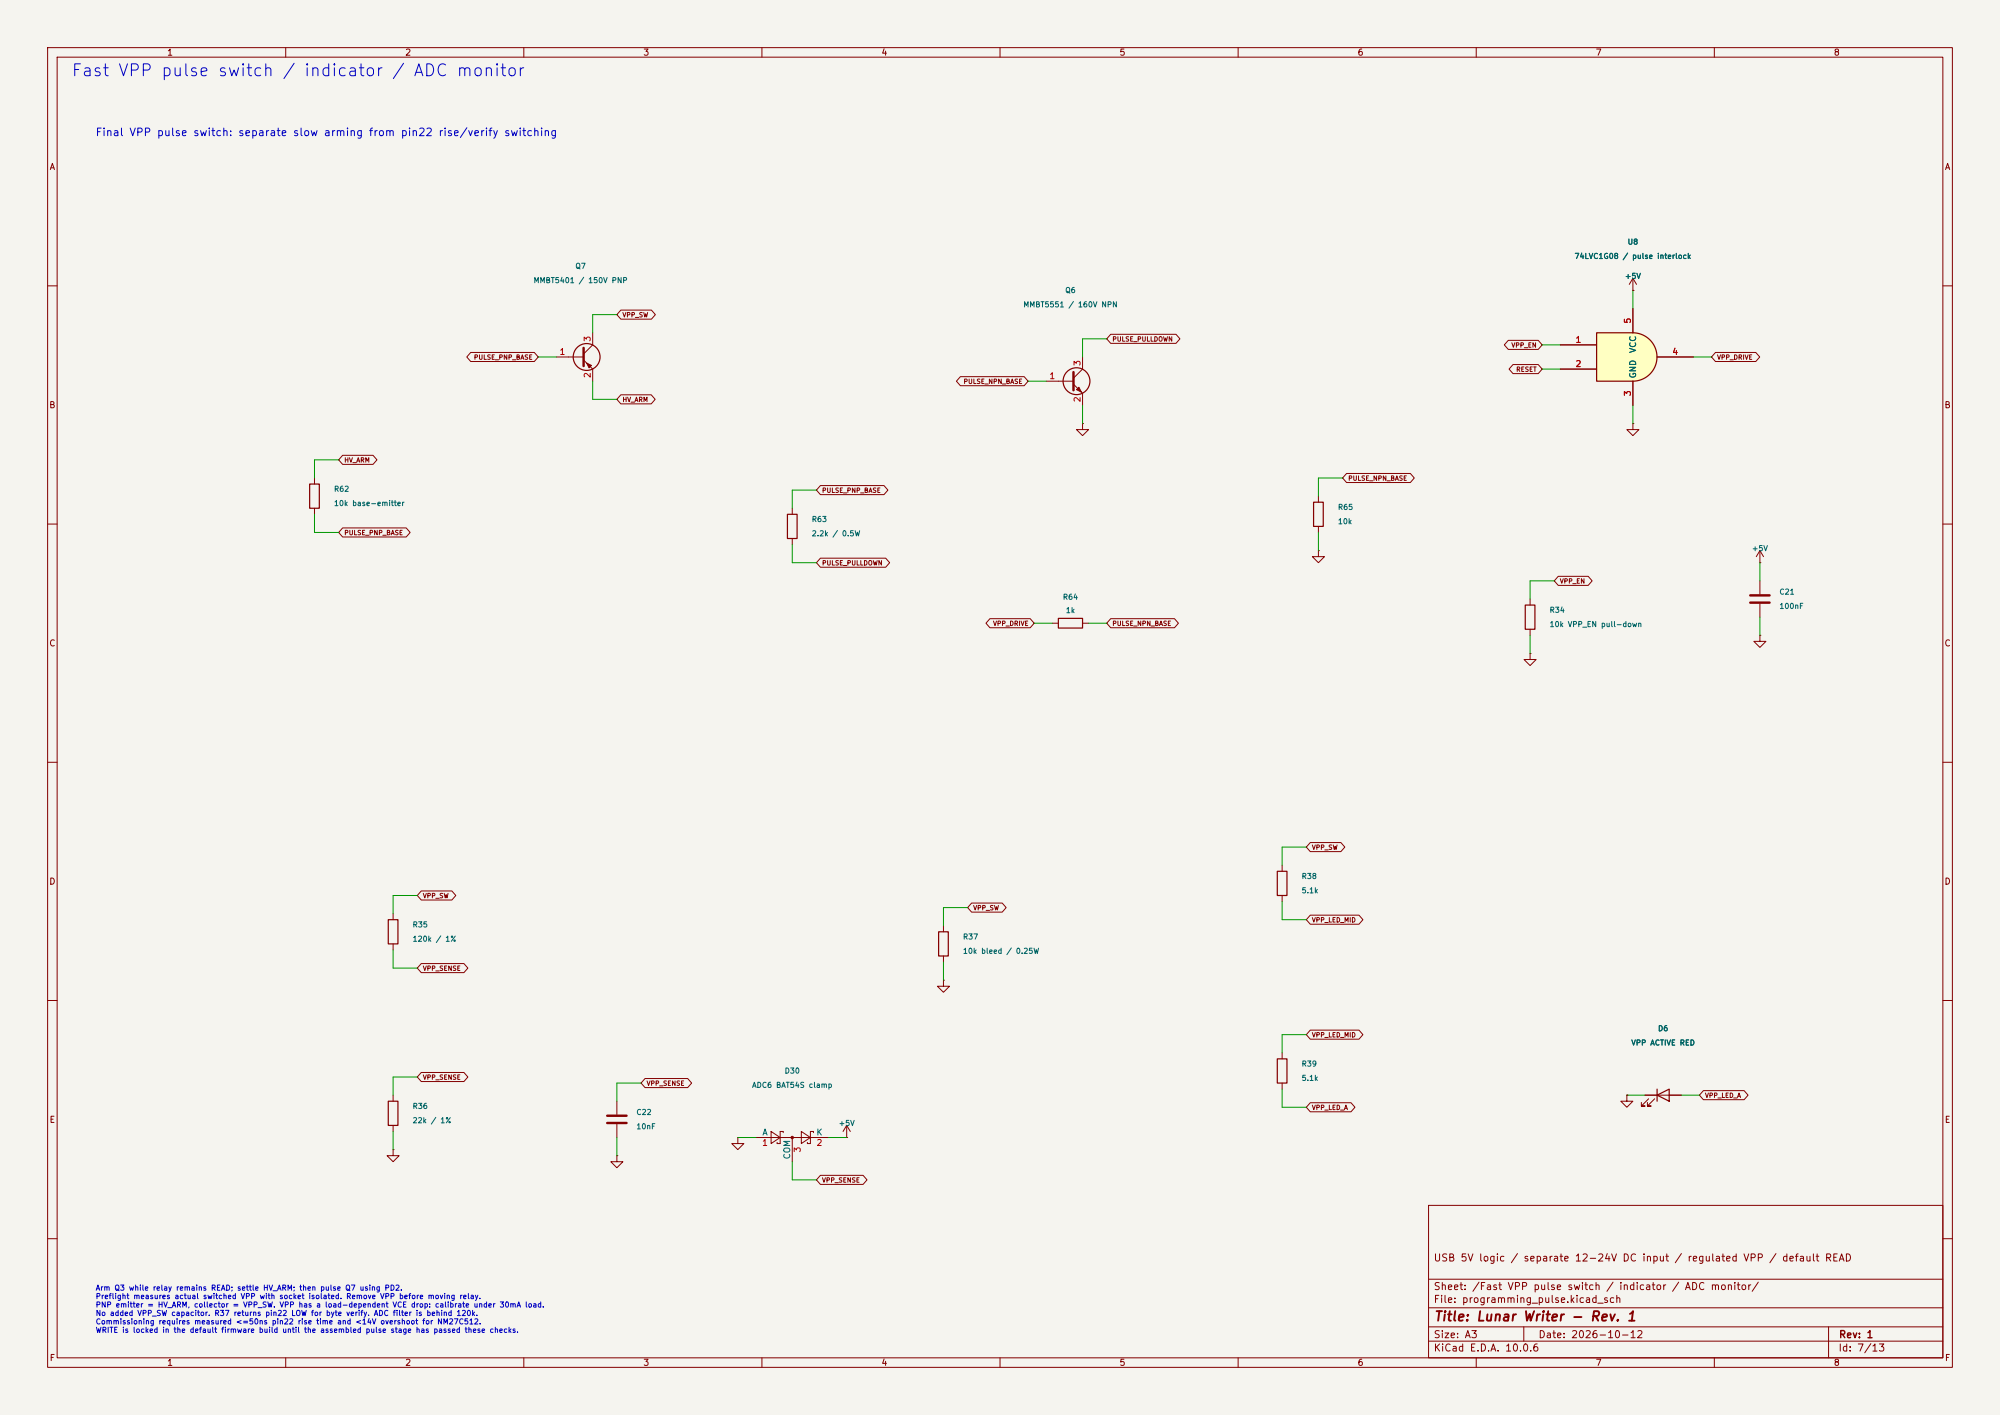
[picture p37: page 7]

Fast VPP pulse switch / indicator / ADC monitor

Final VPP pulse switch: separate slow arming from pin22 rise/verify switching

USB 5V logic / separate 12-24V DC input / regulated VPP / default READ

Sheet: /Fast VPP pulse switch / indicator / ADC monitor/
File: programming_pulse.kicad_sch

Arm Q3 while relay remains READ; settle HV_ARM; then pulse Q7 using PD2. Preflight measures actual switched VPP with socket isolated. Remove VPP before moving relay. PNP emitter = HV_ARM, collector = VPP_SW. VPP has a load-dependent VCE drop: calibrate under 30mA load. No added VPP_SW capacitor. R37 returns pin22 LOW for byte verify. ADC filter is behind 120k. Commissioning requires measured <=50ns pin22 rise time and <14V overshoot for NM27C512. WRITE is locked in the default firmware build until the assembled pulse stage has passed these checks.

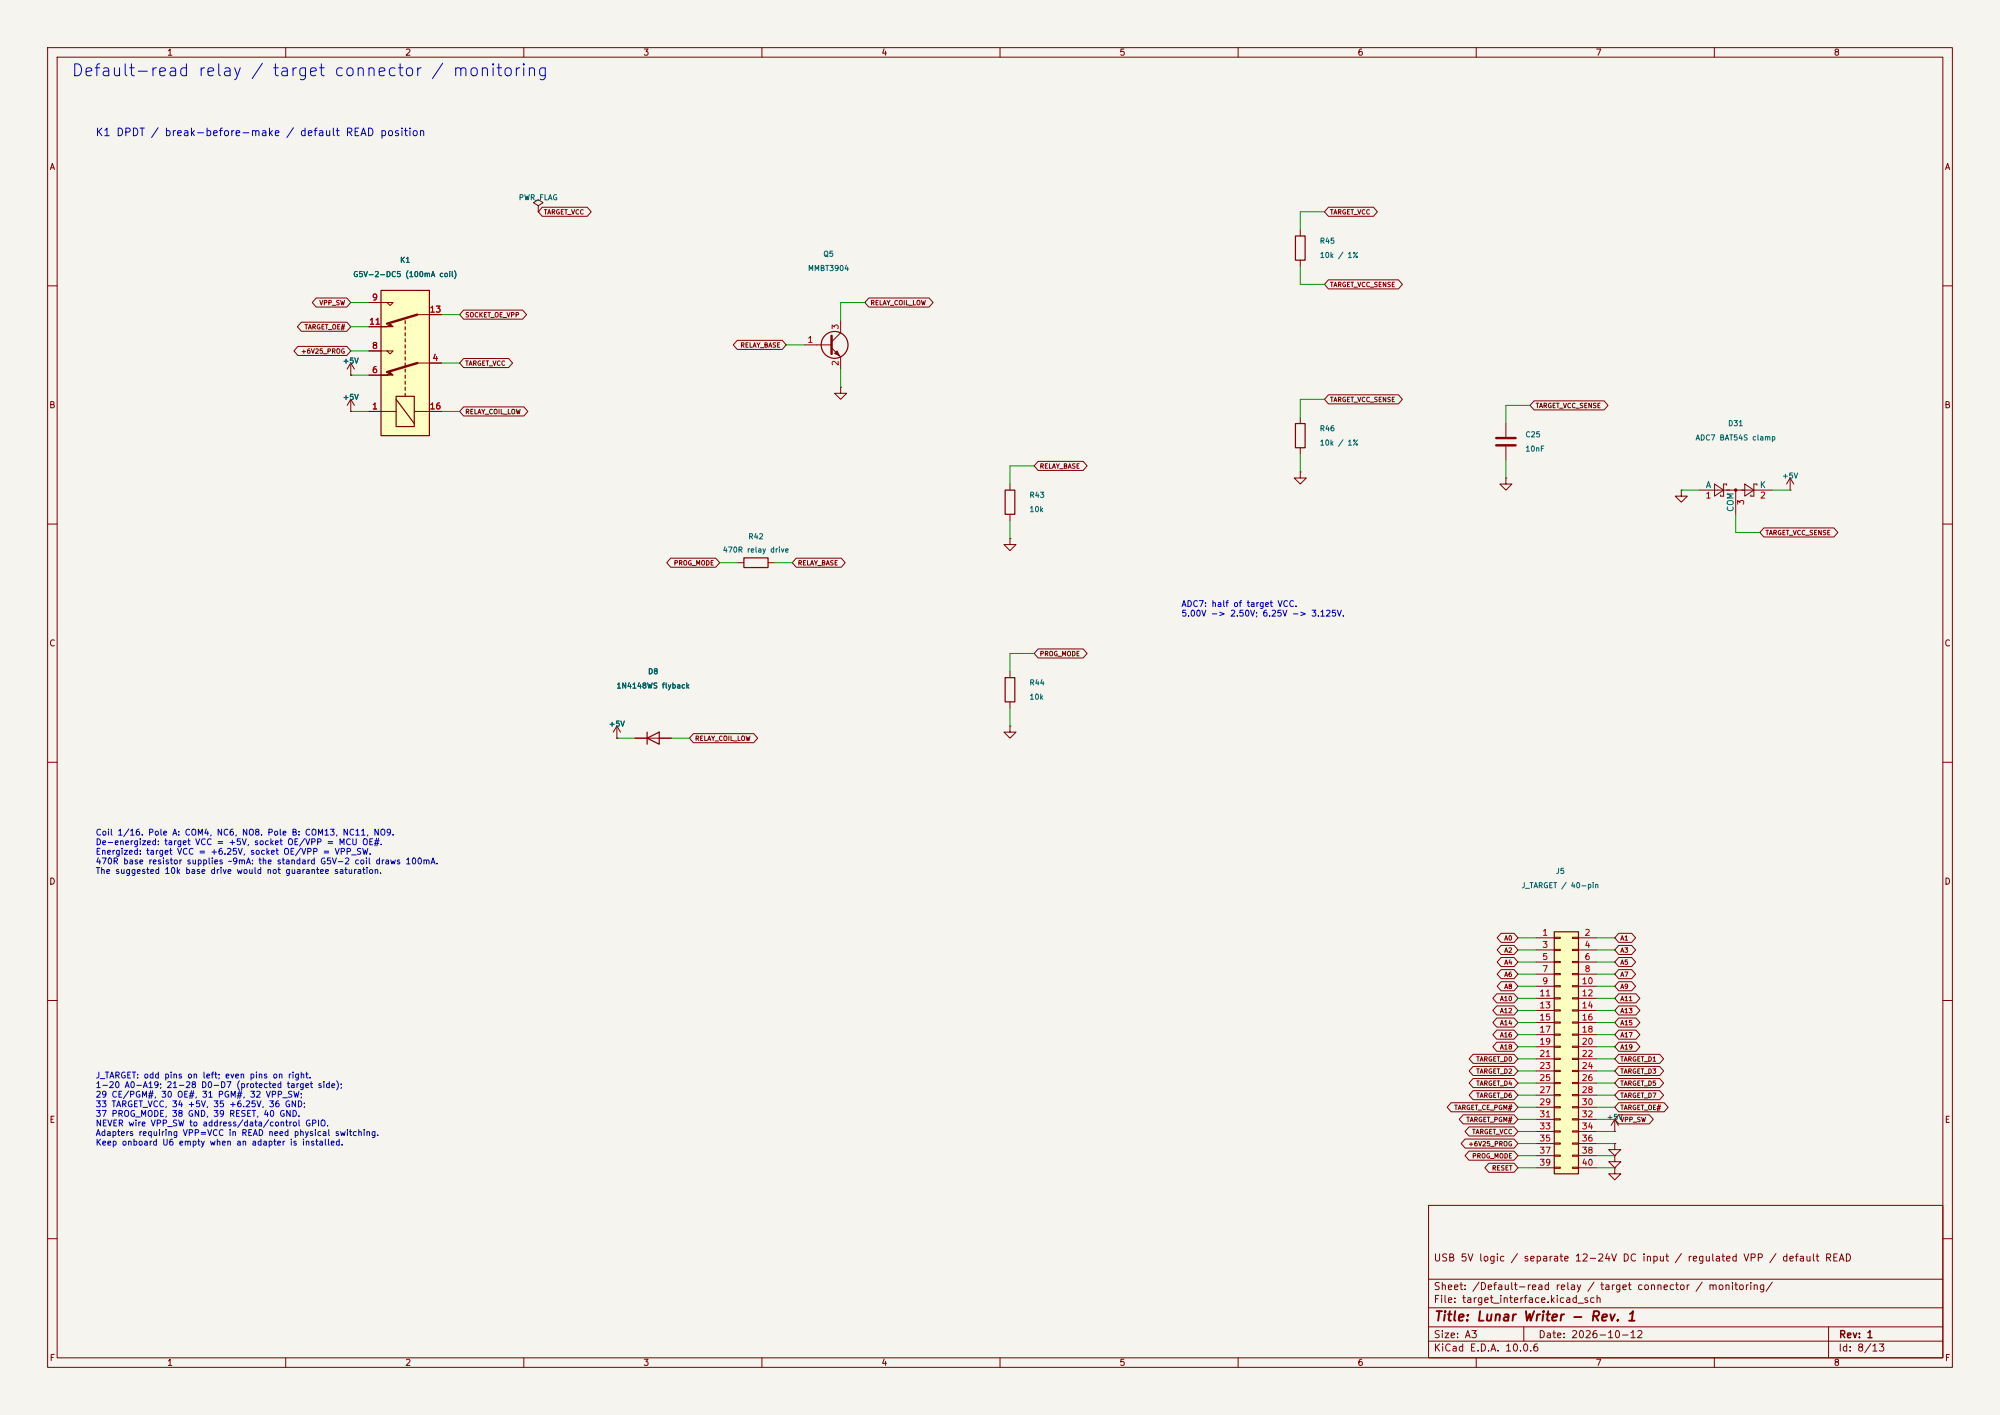
[picture p38: page 8]

Energized: target VCC = +6.25V, socket OE/VPP = VPP_SW. 470R base resistor supplies ~9mA: the standard G5V-2 coil draws 100mA. The suggested 10k base drive would not guarantee saturation. Default-read relay / target connector / monitoring

K1 DPDT / break-before-make / default READ position

ADC7: half of target VCC. 5.00V -> 2.50V; 6.25V -> 3.125V. Coil 1/16. Pole A: COM4, NC6, NO8. Pole B: COM13, NC11, NO9. De-energized: target VCC = +5V, socket OE/VPP = MCU OE#.

TARGET_OE# J_TARGET: odd pins on left; even pins on right. 1-20 A0-A19; 21-28 D0-D7 (protected target side); 29 CE/PGM#, 30 OE#, 31 PGM#, 32 VPP_SW; 33 TARGET_VCC, 34 +5V, 35 +6.25V, 36 GND; 37 PROG_MODE, 38 GND, 39 RESET, 40 GND. NEVER wire VPP_SW to address/data/control GPIO. Adapters requiring VPP=VCC in READ need physical switching.

Keep onboard U6 empty when an adapter is installed.

USB 5V logic / separate 12-24V DC input / regulated VPP / default READ

Sheet: /Default-read relay / target connector / monitoring/
File: target_interface.kicad_sch

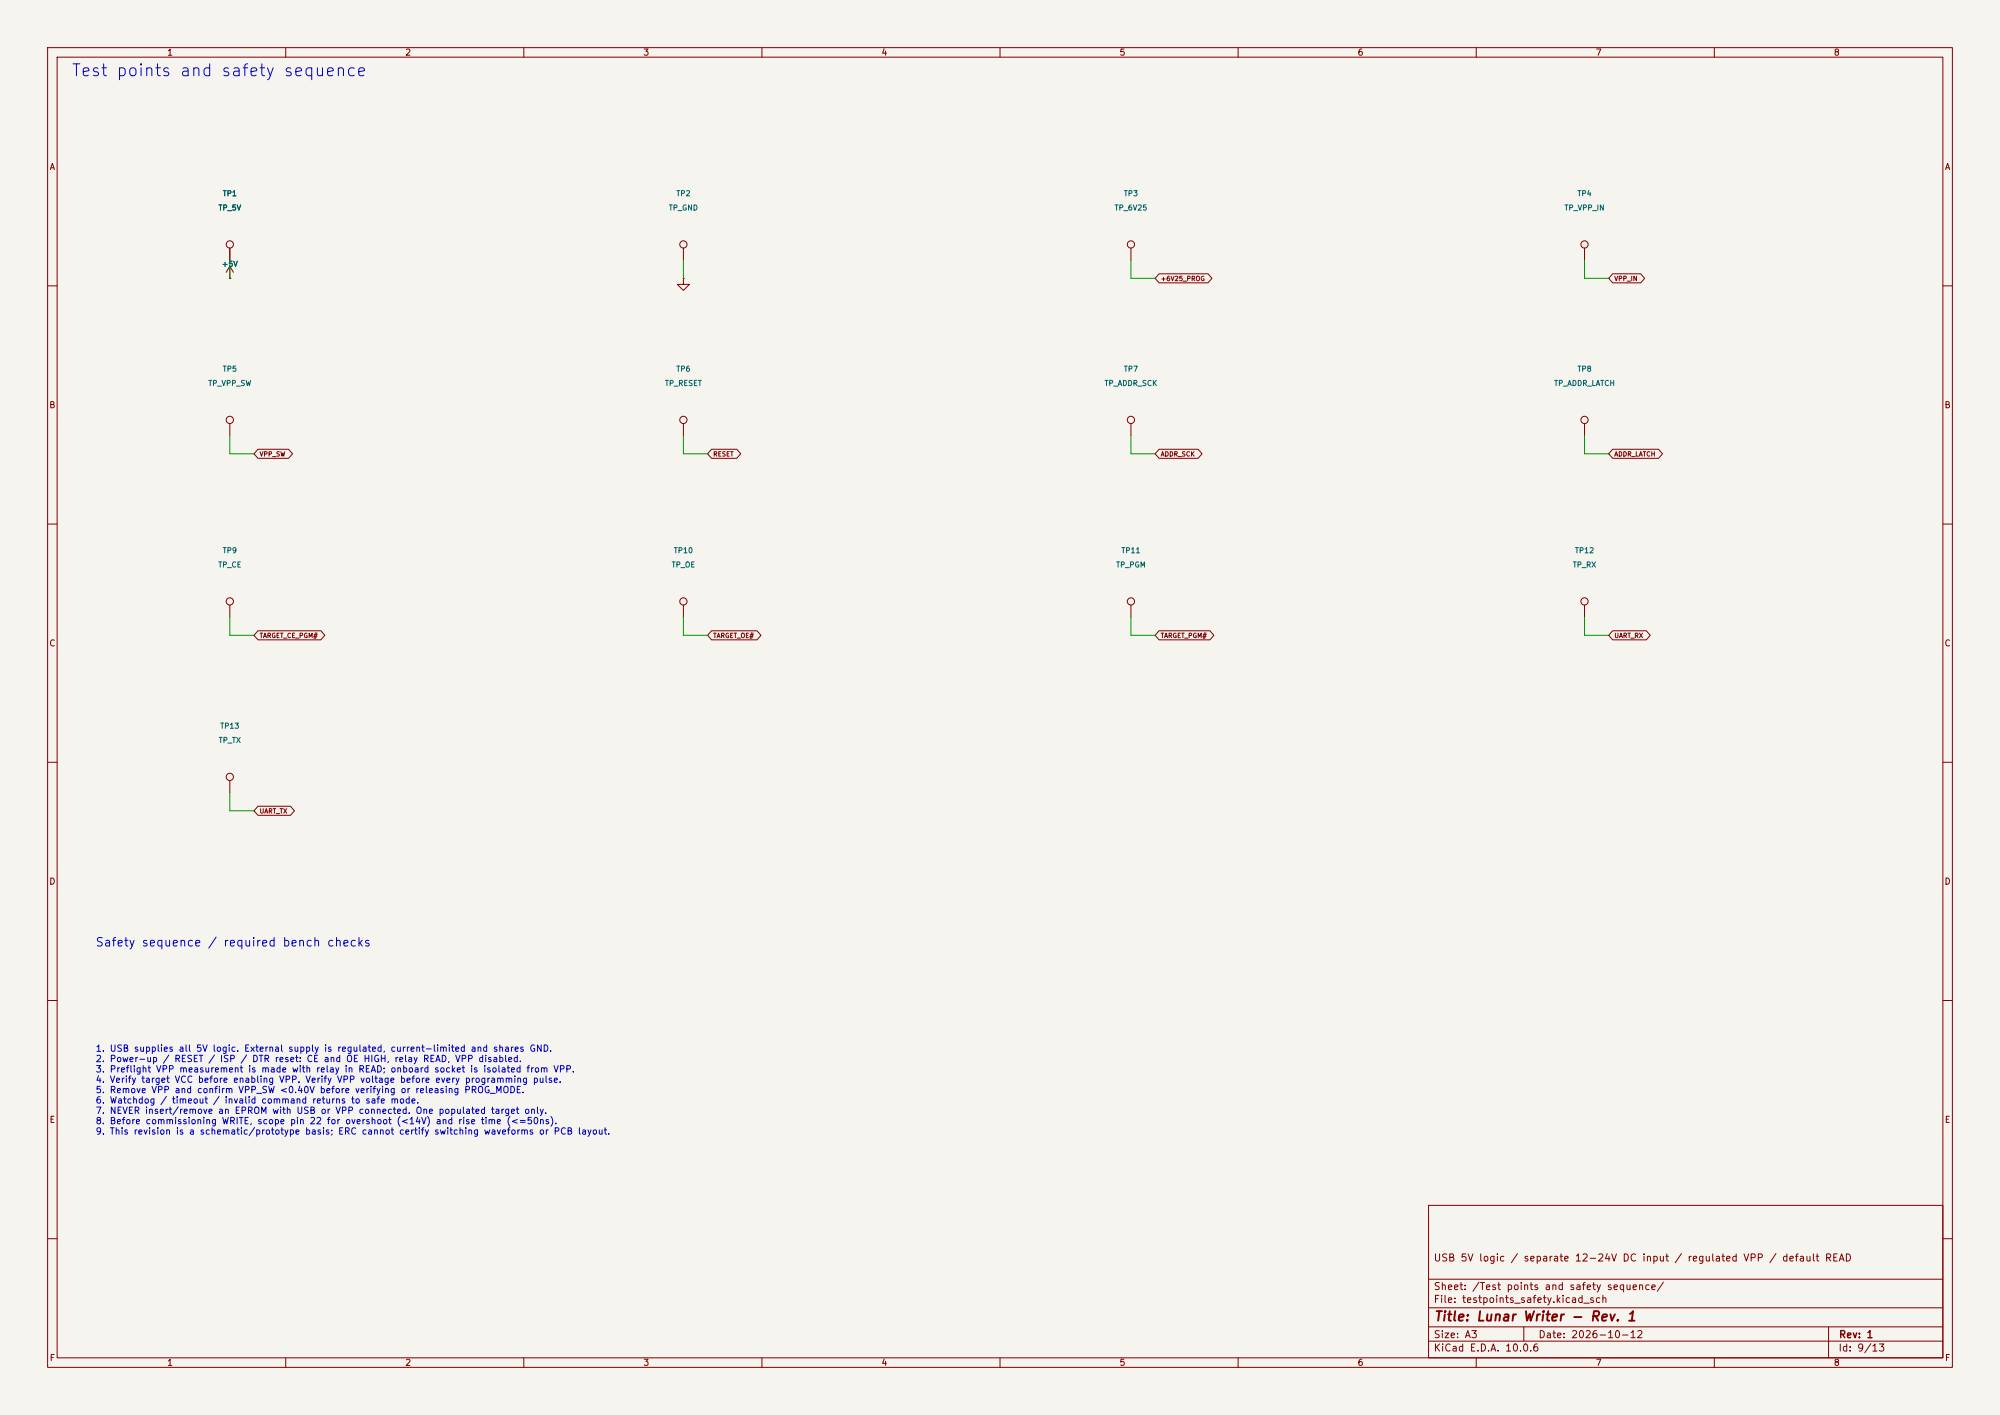
[picture p39: page 9]

Test points and safety sequence

Safety sequence / required bench checks

USB 5V logic / separate 12-24V DC input / regulated VPP / default READ

Sheet: /Test points and safety sequence/
File: testpoints_safety.kicad_sch

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
## File: adapter_2716_KR573RF5.kicad_sch

## Sheet: /2716 / KR573RF5 adapter reference/

## USB 5V logic / separate 12-24V DC input / regulated VPP / default READ

Pin 06: A2 Pin 07: A1 Pin 04: A4 Pin 03: A5 Pin 05: A3 | Pin 20: OE#

## Pin 21: VPP (READ +5V) Pin 22: A9 Pin 24: TARGET_VCC

Pin 23: A8 Pin 16: D6 Pin 14: D4 Pin 19: A10 Pin 13: D3 Pin 15: D5 Pin 17: D7 Pin 18: CE/PGM (READ low) Pin 10: D1

Source: Intel 2716 datasheet, Intel 1980, pin configuration / mode selection. See docs/sources.md for the source URL. No unverified KR573RF5 wiring is fabricated.

# Pin 08: A0 Pin 11: D2 Pin 12: GND

Intel 2716: VPP pin21 must be +5V for READ. NOT VPP_SW=0V.
Read adapter ties pin21 to TARGET_VCC; pin18 = CE, pin20 = OE.
Future WRITE needs a relay/jumper to select pin21 between +5V and VPP_SW; separate exact algorithm and polarity are required. Do not copy NM27C512 WRITE. KR573RF5 profile is quarantined pending a traceable original device datasheet. Its manufacturer pinout/algorithm must be checked before populating an adapter.

2732 differs: pin21 = A11 and pin20 = OE/VPP (requires HV isolation). Pin 09: D0 Pin 01: A7 REFERENCE ONLY - logical mapping for future adapter PCBs, not additional live targets

# 2716 / KR573RF5 adapter reference

## Pin 02: A6

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
## File: adapter_28pin_27xx.kicad_sch

## Sheet: /28-pin EPROM adapter reference/

## USB 5V logic / separate 12-24V DC input / regulated VPP / default READ

## Pin 01: 64/128/256: VPP; 512: A15 Pin 03: A7 28-pin EPROM adapter reference

Pin 15: D3 Pin 04: A6 Pin 02: A12 REFERENCE ONLY - logical mapping for future adapter PCBs, not additional live targets Pin 08: A2 Pin 05: A5 Pin 07: A3 Pin 09: A1 Pin 06: A4 Pin 10: A0 | Pin 27: 64/128: PGM#; 256/512: A14 Pin 24: A9 Pin 20: 64/128: CE#; 256/512: CE/PGM#

## Pin 22: 64/128/256: OE#; 512: OE/VPP

## Pin 25: A8 Pin 23: A11 Pin 26: 64: NC; 128/256/512: A13 Pin 28: TARGET_VCC

Pin 13: D2 Pin 14: GND 2764/27128: pin27 is PGM#, NOT A14. 27256: pin27 is A14. Do not route a 595 output onto a VPP pin. Use keyed jumpers or a device-specific adapter. VPP on pin1 needs READ +5V selection, separate from the onboard NM27C512 relay.

Read-only adapters may tie VPP and unused PGM# HIGH. WRITE remains disabled for these profiles. Sources: National NM27C512 and Intel 2764 / 27128A / 27256 original datasheets. Pin 11: D0 Pin 12: D1 | Pin 17: D5 Pin 21: A10 Pin 18: D6 Pin 16: D4 Pin 19: D7

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
## File: adapter_32pin_JEDEC.kicad_sch

## Sheet: /32-pin JEDEC adapter reference/

## USB 5V logic / separate 12-24V DC input / regulated VPP / default READ

Pin 08: A4 Pin 09: A3 Pin 07: A5 Pin 05: A7 Pin 06: A6 Pin 04: A12 | Pin 23: A10 Pin 22: CE / CE-PGM# (family dependent) Pin 18: D4 Pin 19: D5 Pin 17: D3 Pin 20: D6 Pin 21: D7 Pin 24: 010/020/040: OE#; 080: OE/VPP

Pin 14: D1 Pin 10: A2 Pin 11: A1 National 27C010/020/040/080 package comparison is the source for these pin roles. Use a device-specific adapter; role changes require keyed selection or HV-rated switching. Pin1 must never receive VPP when it is A19. Pin24 changes from OE to OE/VPP on 080. 27C080 cannot use a generic 32-pin VPP-pin1 adapter. Program profiles remain disabled. Read VPP pins require +5V, not an unpowered VPP_SW. See device_profiles.json for verified status. Pin 15: D2 Pin 13: D0 Pin 12: A0 Pin 16: GND

# Pin 27: A8 Pin 25: A11 Pin 29: A14 Pin 32: TARGET_VCC

Pin 28: A13 Pin 31: 010/020: PGM#; 040/080: A18 Pin 26: A9 Pin 30: 010: NC; 020/040/080: A17 32-pin JEDEC adapter reference

Pin 02: A16 Pin 01: 010/020/040: VPP; 080: A19 Pin 03: A15 REFERENCE ONLY - logical mapping for future adapter PCBs, not additional live targets

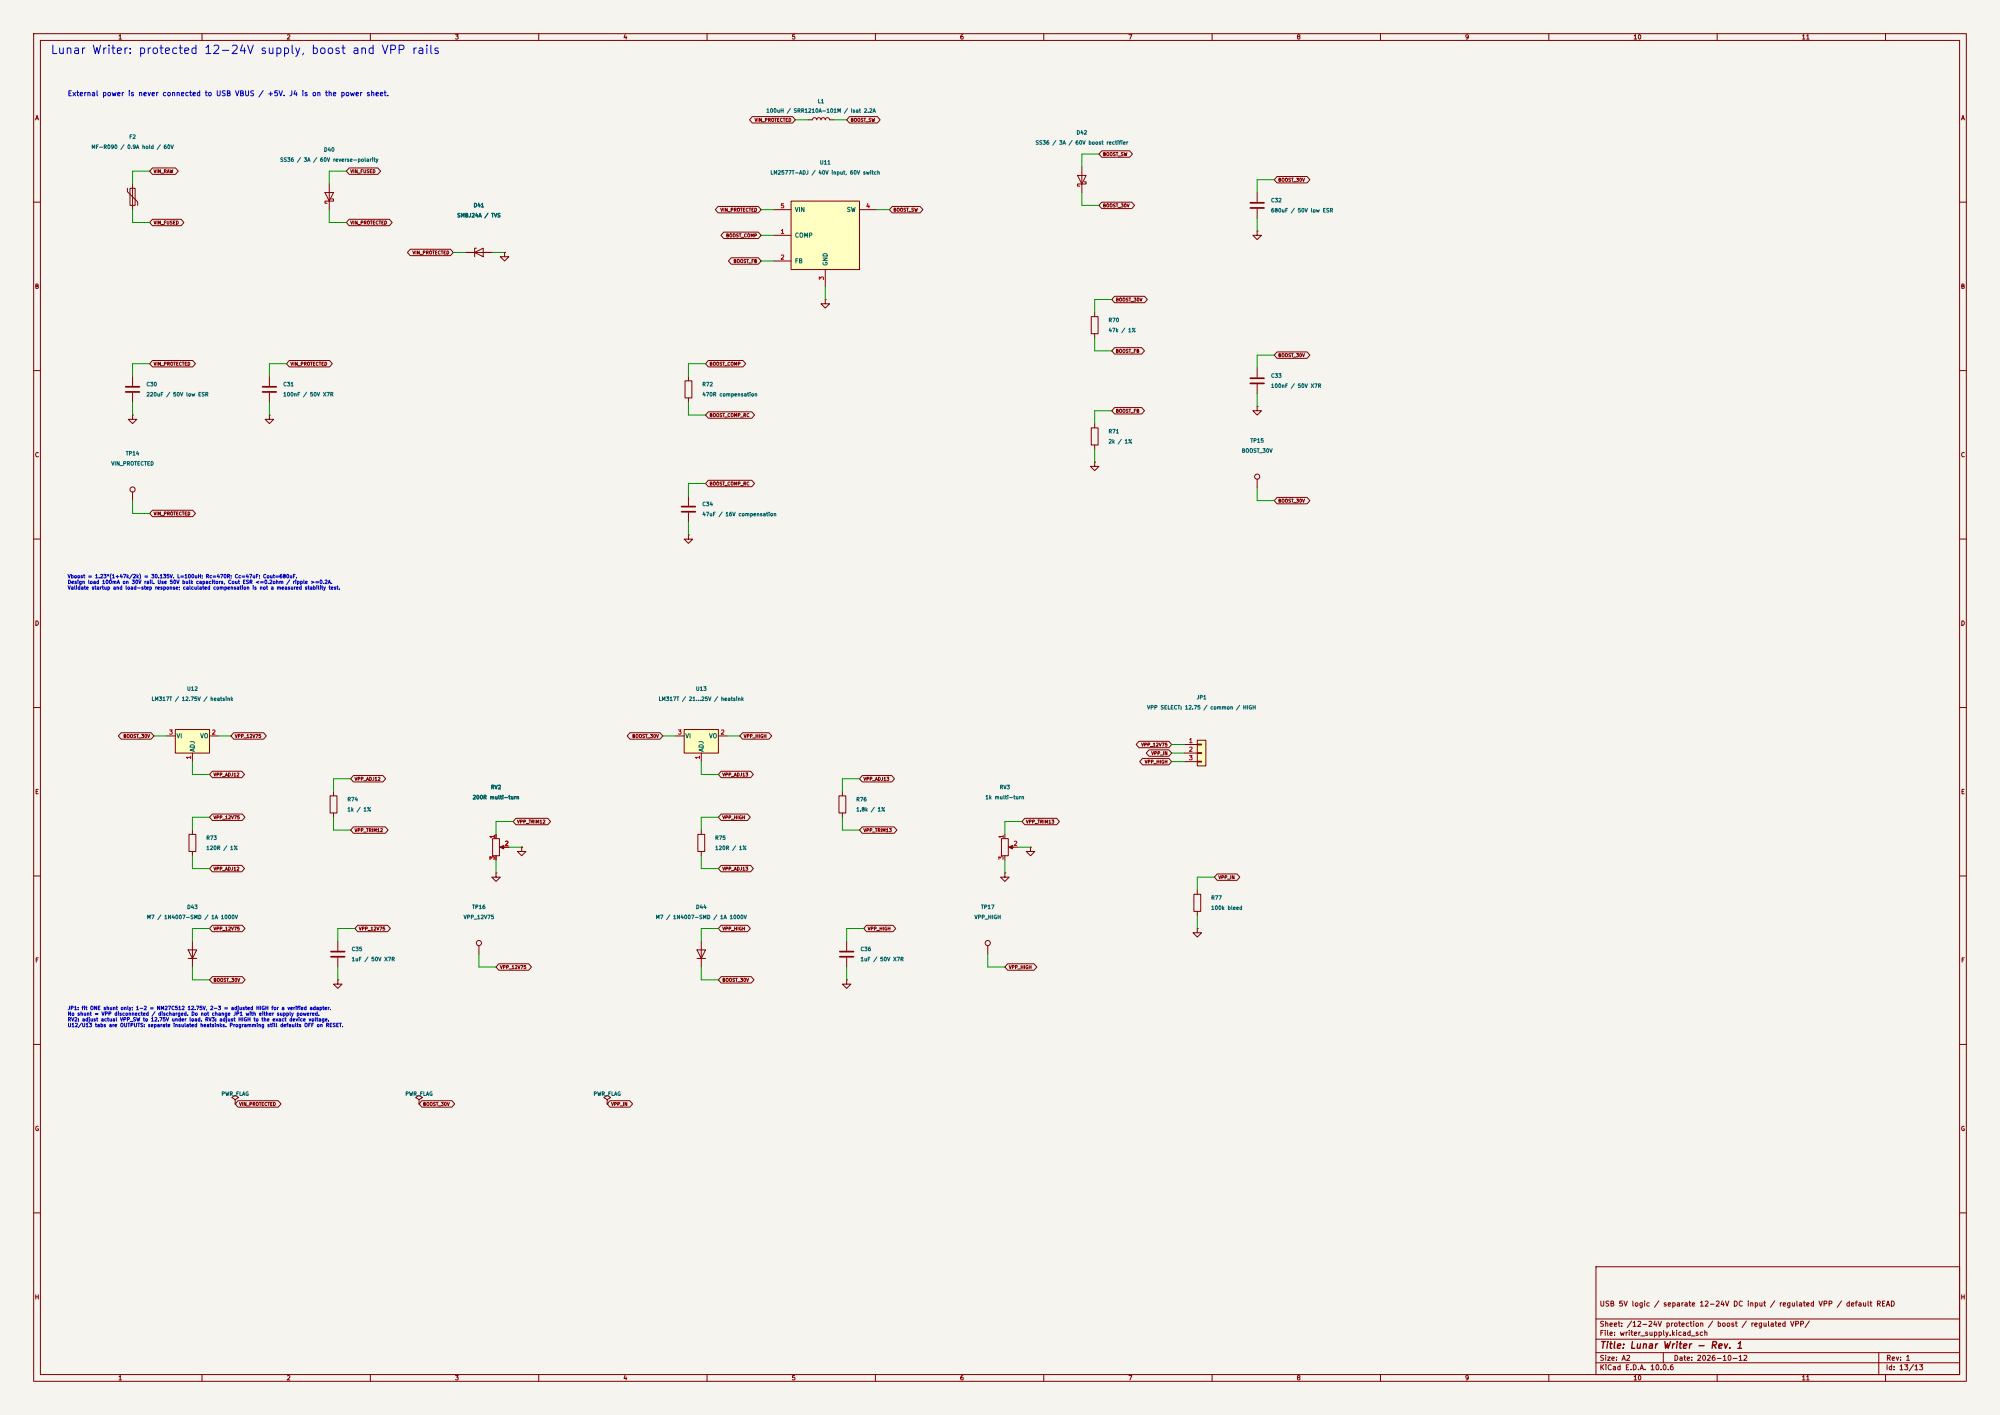
[picture p40: page 13]

Lunar Writer: protected 12-24V supply, boost and VPP rails

Vboost = 1.23*(1+47k/2k) = 30.135V. L=100uH; Rc=470R; Cc=47uF; Cout=680uF. Design load 100mA on 30V rail. Use 50V bulk capacitors, Cout ESR <=0.2ohm / ripple >=0.2A. Validate startup and load-step response; calculated compensation is not a measured stability test.

VPP SELECT: 12.75 / common / HIGH

JP1: fit ONE shunt only; 1-2 = NM27C512 12.75V, 2-3 = adjusted HIGH for a verified adapter. No shunt = VPP disconnected / discharged. Do not change JP1 with either supply powered. RV2: adjust actual VPP_SW to 12.75V under load. RV3: adjust HIGH to the exact device voltage. U12/U13 tabs are OUTPUTS: separate insulated heatsinks. Programming still defaults OFF on RESET.

USB 5V logic / separate 12-24V DC input / regulated VPP / default READ

Sheet: /12-24V protection / boost / regulated VPP/
File: writer_supply.kicad_sch
