IlyaBOT/LunarView3/validation/NM27C512_ReadOnly.pdf

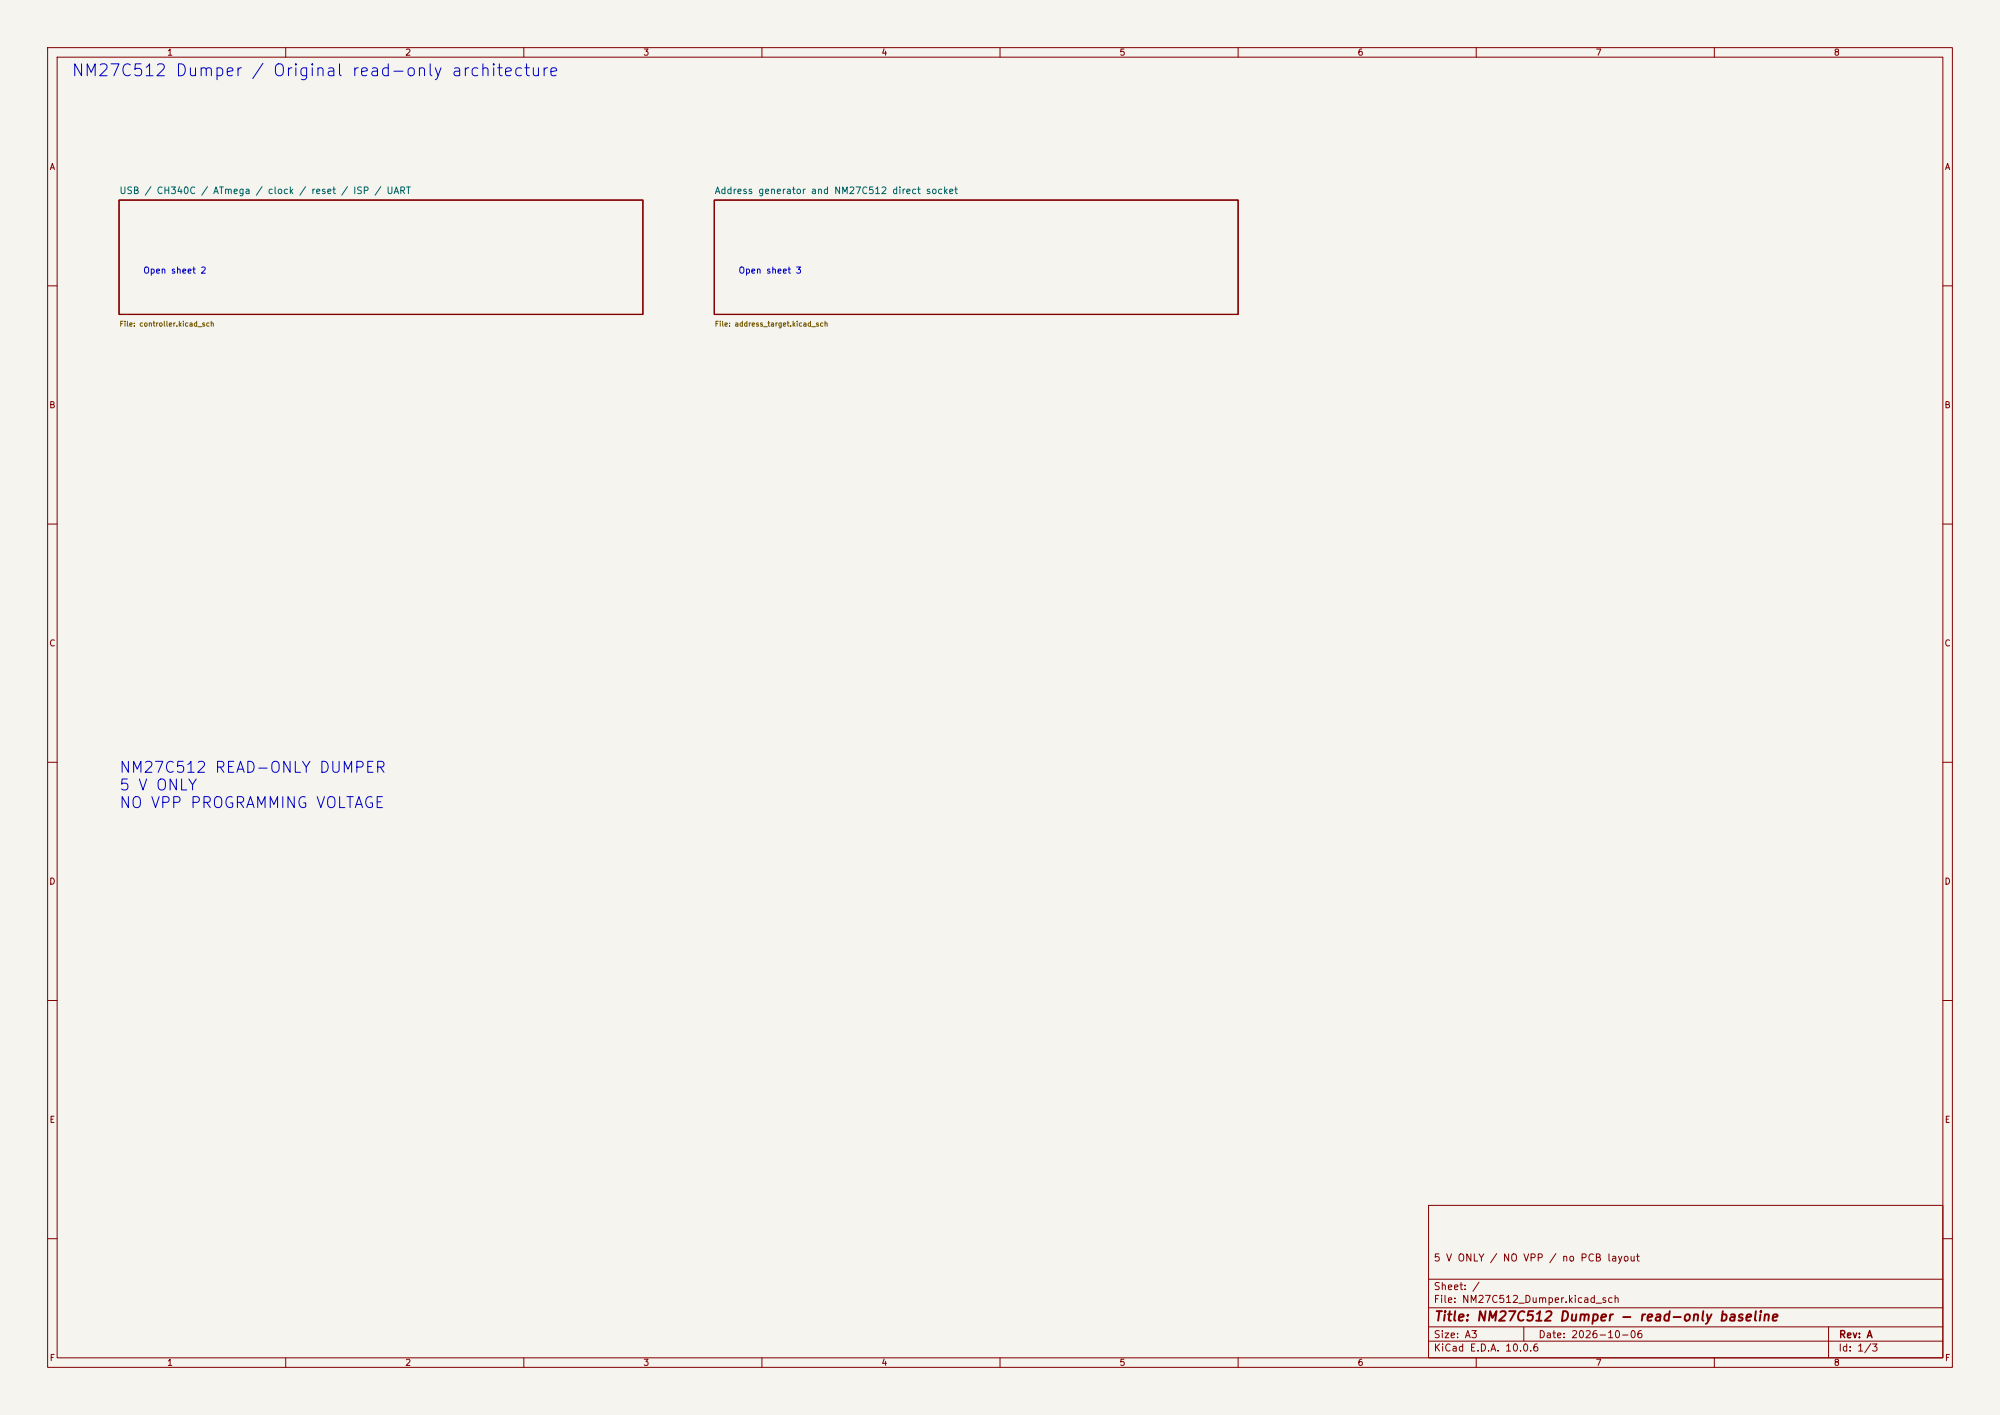
[picture p41: page 1]

USB / CH340C / ATmega / clock / reset / ISP / UART

5 V ONLY
NO VPP PROGRAMMING VOLTAGE

5 V ONLY / NO VPP / no PCB layout

Sheet: /
File: NM27C512_Dumper.kicad_sch
Title: NM27C512 Dumper - read-only baseline

Size: A3 | Rev: A | F Date: 2026-10-06
KiCad E.D.A. 10.0.6 | Id: 1/3

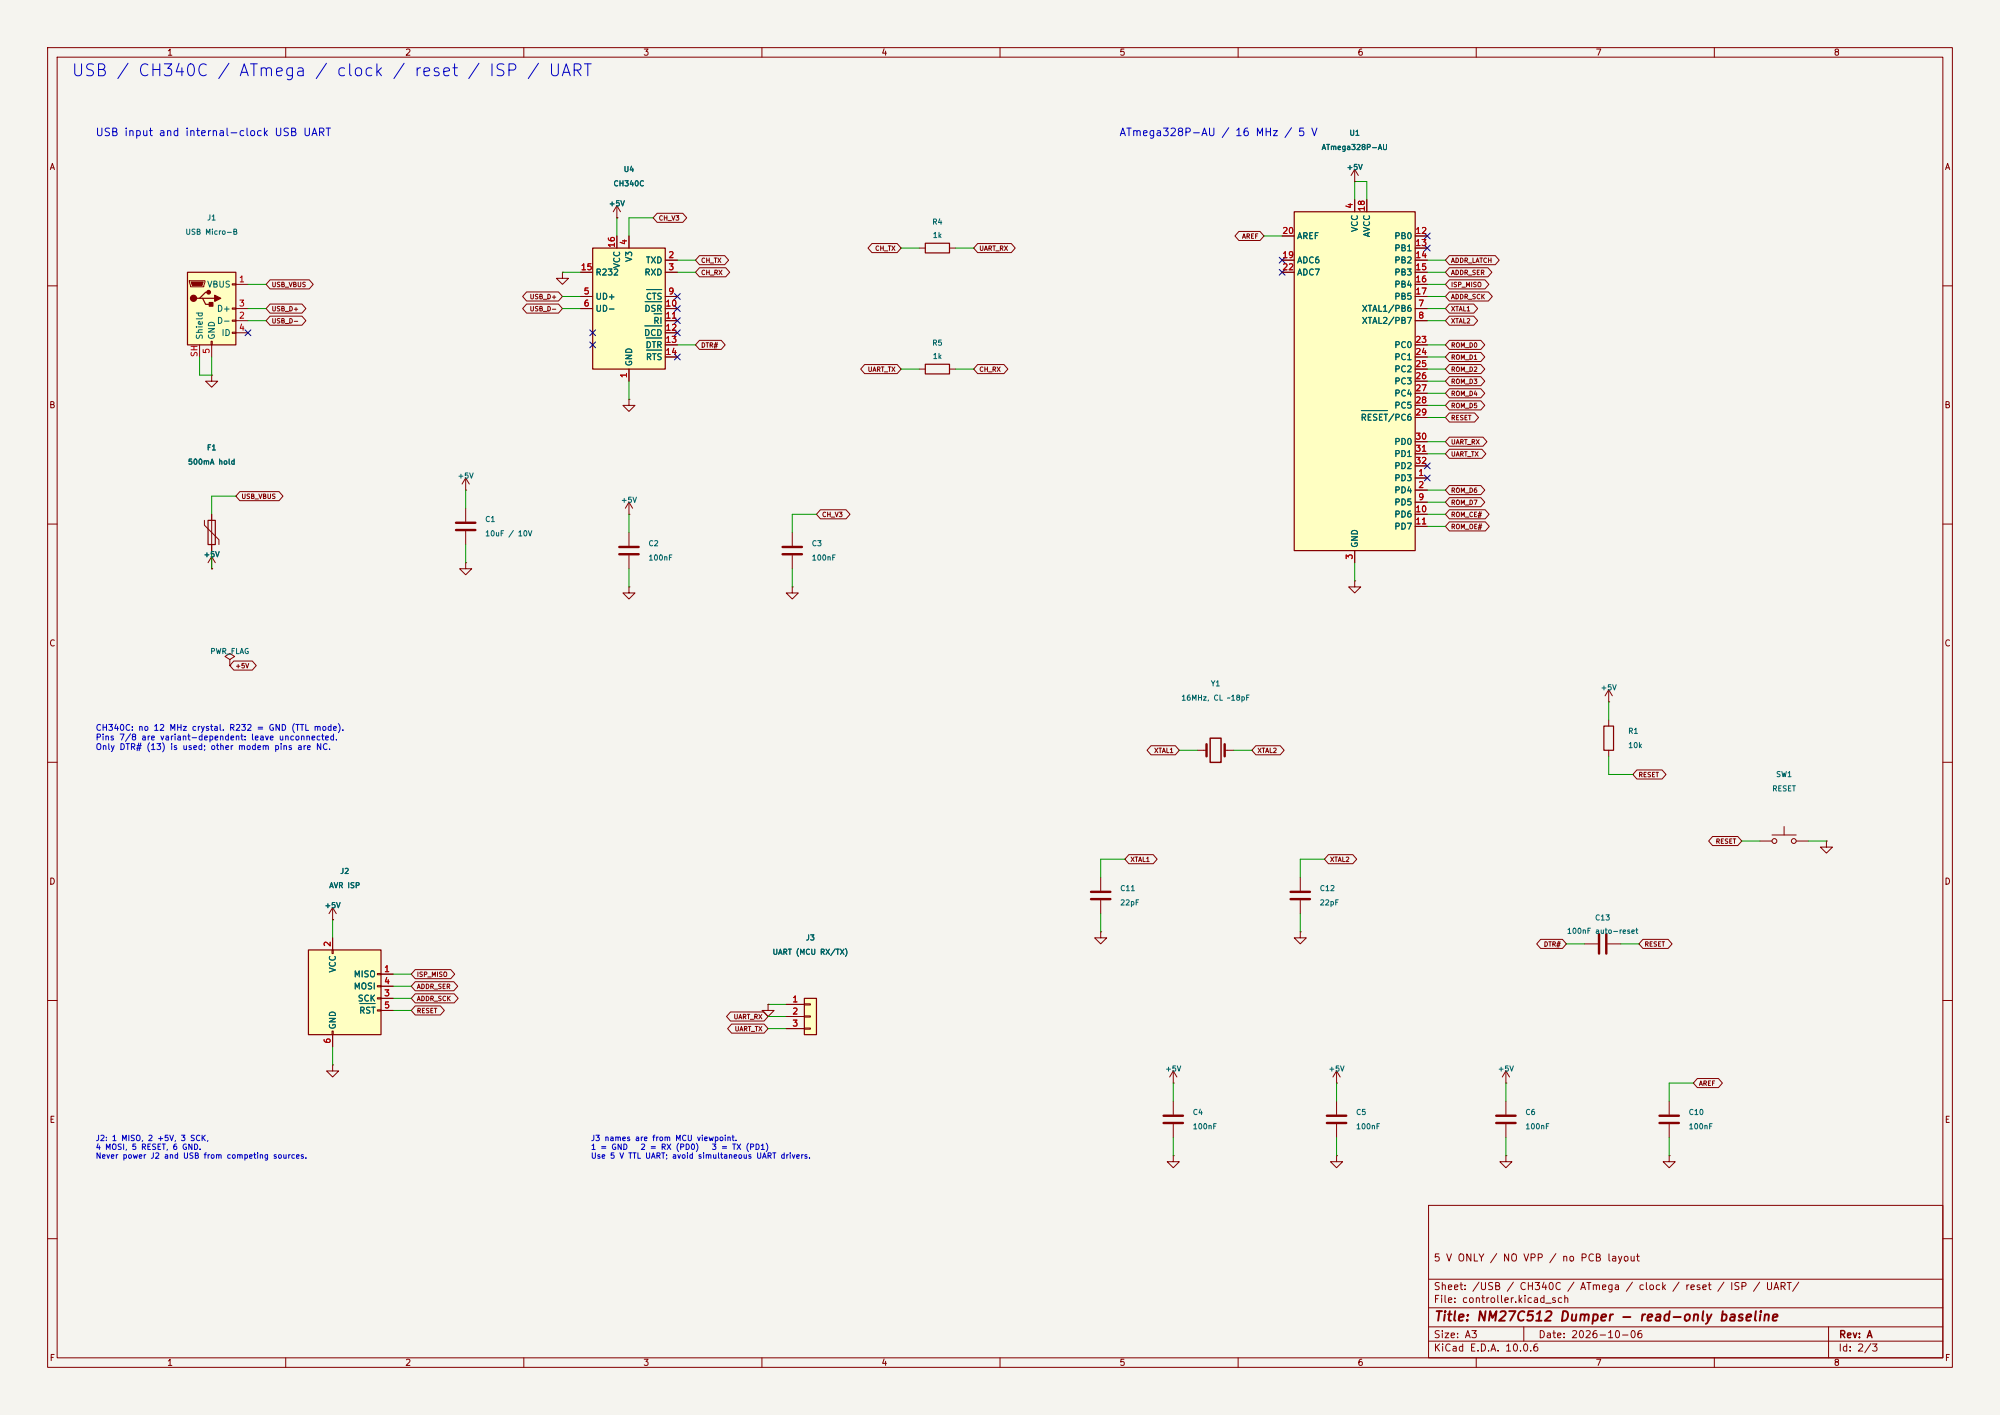
[picture p42: page 2]

ROM_D0 ROM_D1 ROM_D2 CH340C: no 12 MHz crystal. R232 = GND (TTL mode). Pins 7/8 are variant-dependent: leave unconnected. Only DTR# (13) is used; other modem pins are NC. USB / CH340C / ATmega / clock / reset / ISP / UART

USB input and internal-clock USB UART

4 UD+ 5 UD- 6 CTS 9 DSR 10 RI 11 DCD 12 DTR 13 RTS 14 R232 15 VCC 16

J3 UART (MCU RX/TX) +5VPWR_FLAG

J3 UART (MCU RX/TX) 1

J2: 1 MISO, 2 +5V, 3 SCK, 4 MOSI, 5 RESET, 6 GND. Never power J2 and USB from competing sources.

5 V ONLY / NO VPP / no PCB layout

Sheet: /USB / CH340C / ATmega / clock / reset / ISP / UART/
File: controller.kicad_sch

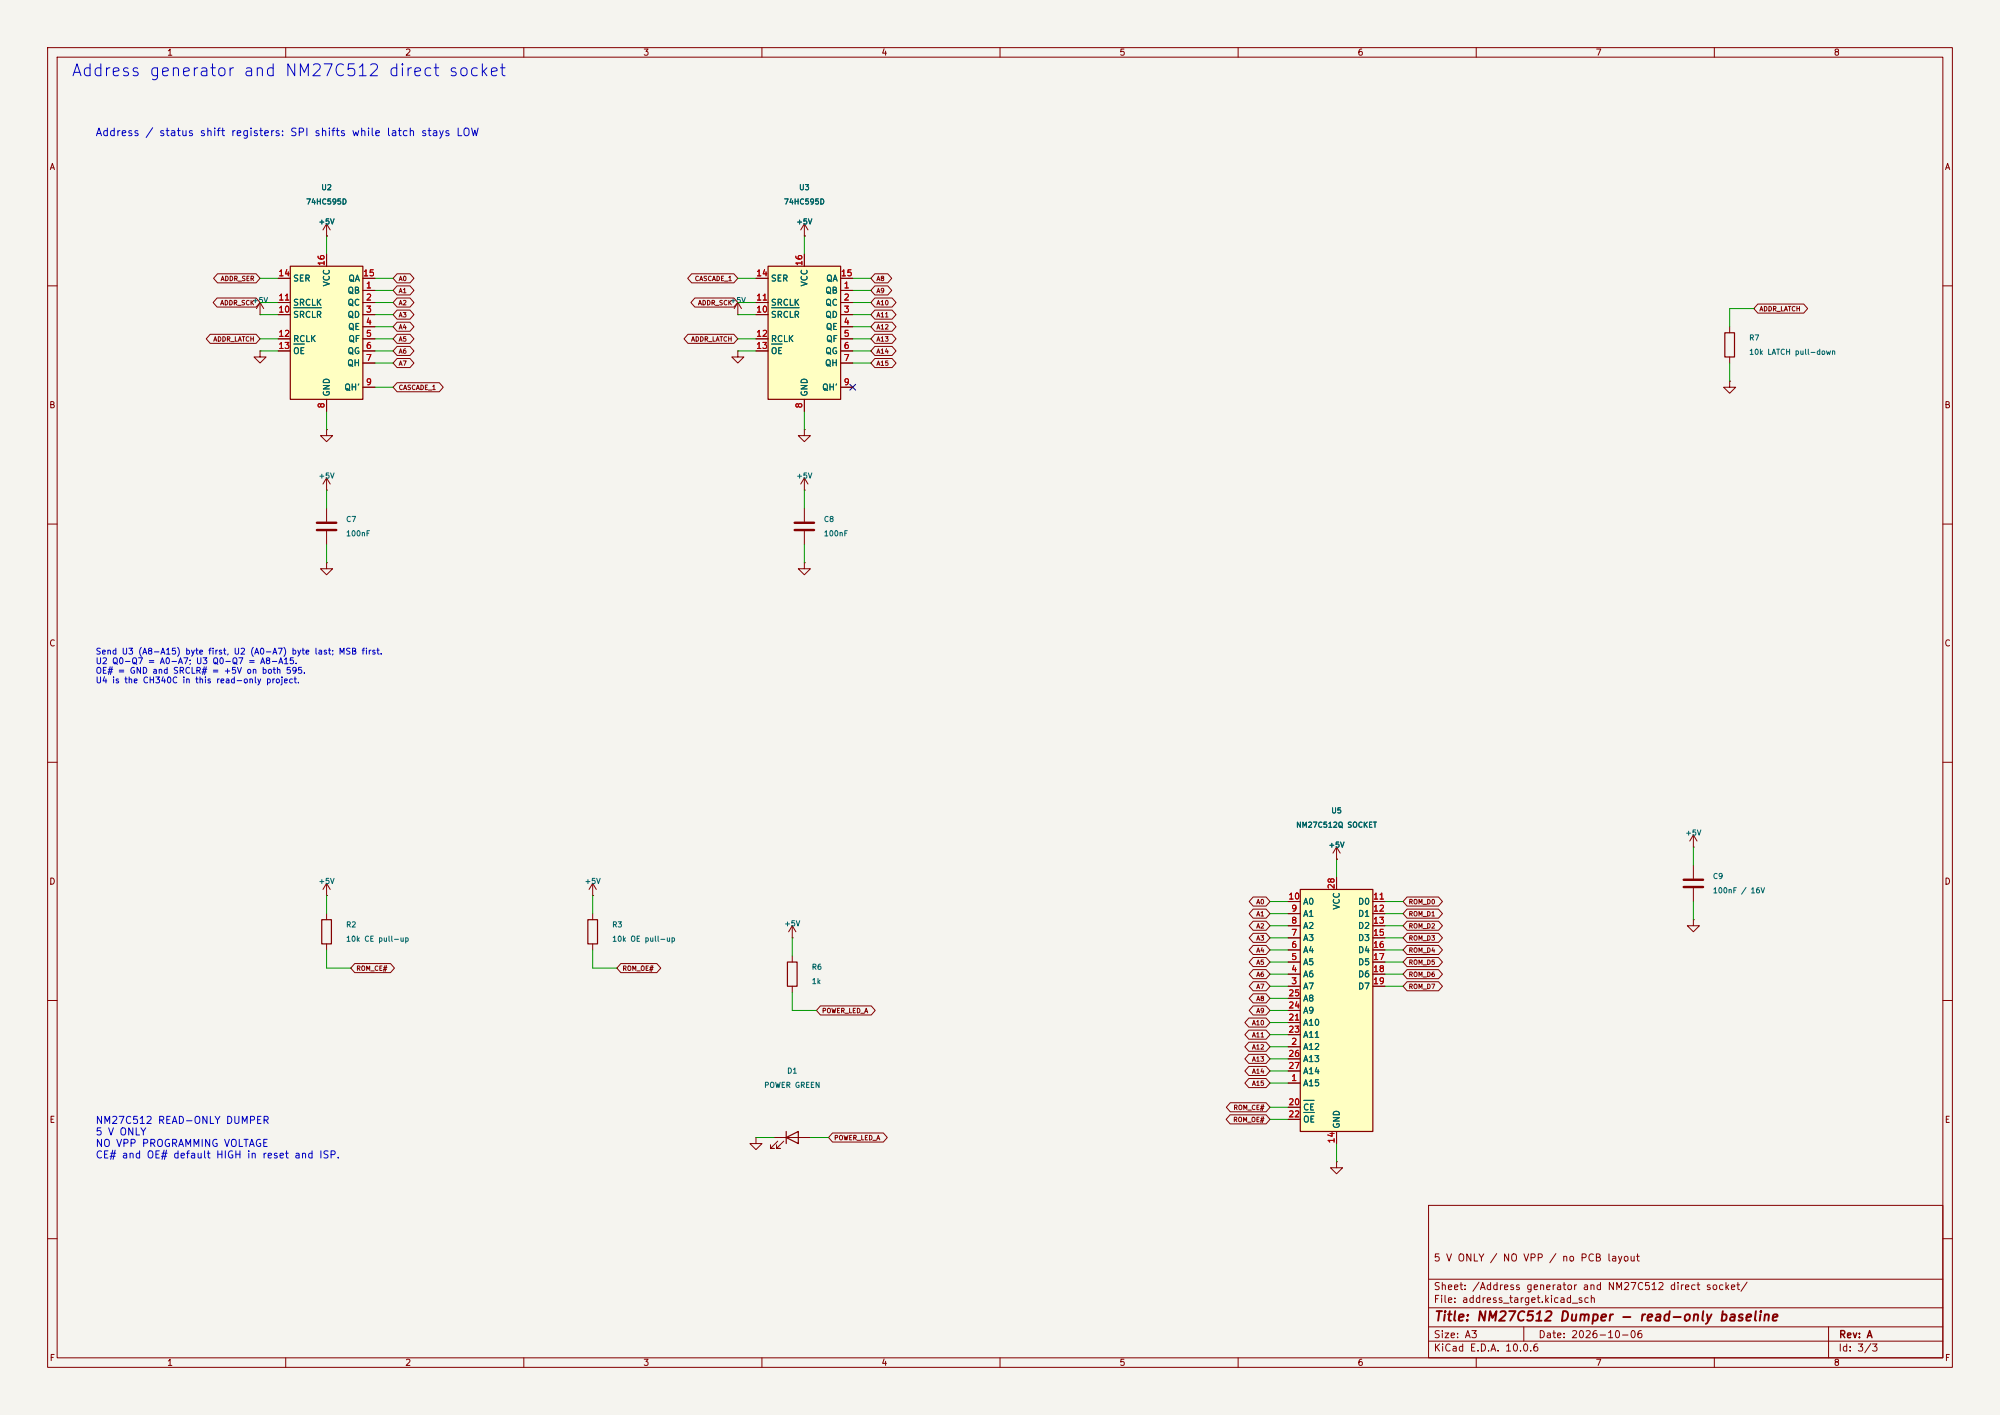
[picture p43: page 3]

Address generator and NM27C512 direct socket

Address / status shift registers: SPI shifts while latch stays LOW

SRCLR 10 SRCLK 11 RCLK 12 OE 13

A0 Send U3 (A8-A15) byte first, U2 (A0-A7) byte last; MSB first. U2 Q0-Q7 = A0-A7; U3 Q0-Q7 = A8-A15. OE# = GND and SRCLR# = +5V on both 595. U4 is the CH340C in this read-only project.

NM27C512 READ-ONLY DUMPER
5 V ONLY
NO VPP PROGRAMMING VOLTAGE
CE# and OE# default HIGH in reset and ISP.

5 V ONLY / NO VPP / no PCB layout

Sheet: /Address generator and NM27C512 direct socket/
File: address_target.kicad_sch
