IlyaBOT/LunarView3/Dumper-Lite/NM27C512_Dumper_Lite.pdf

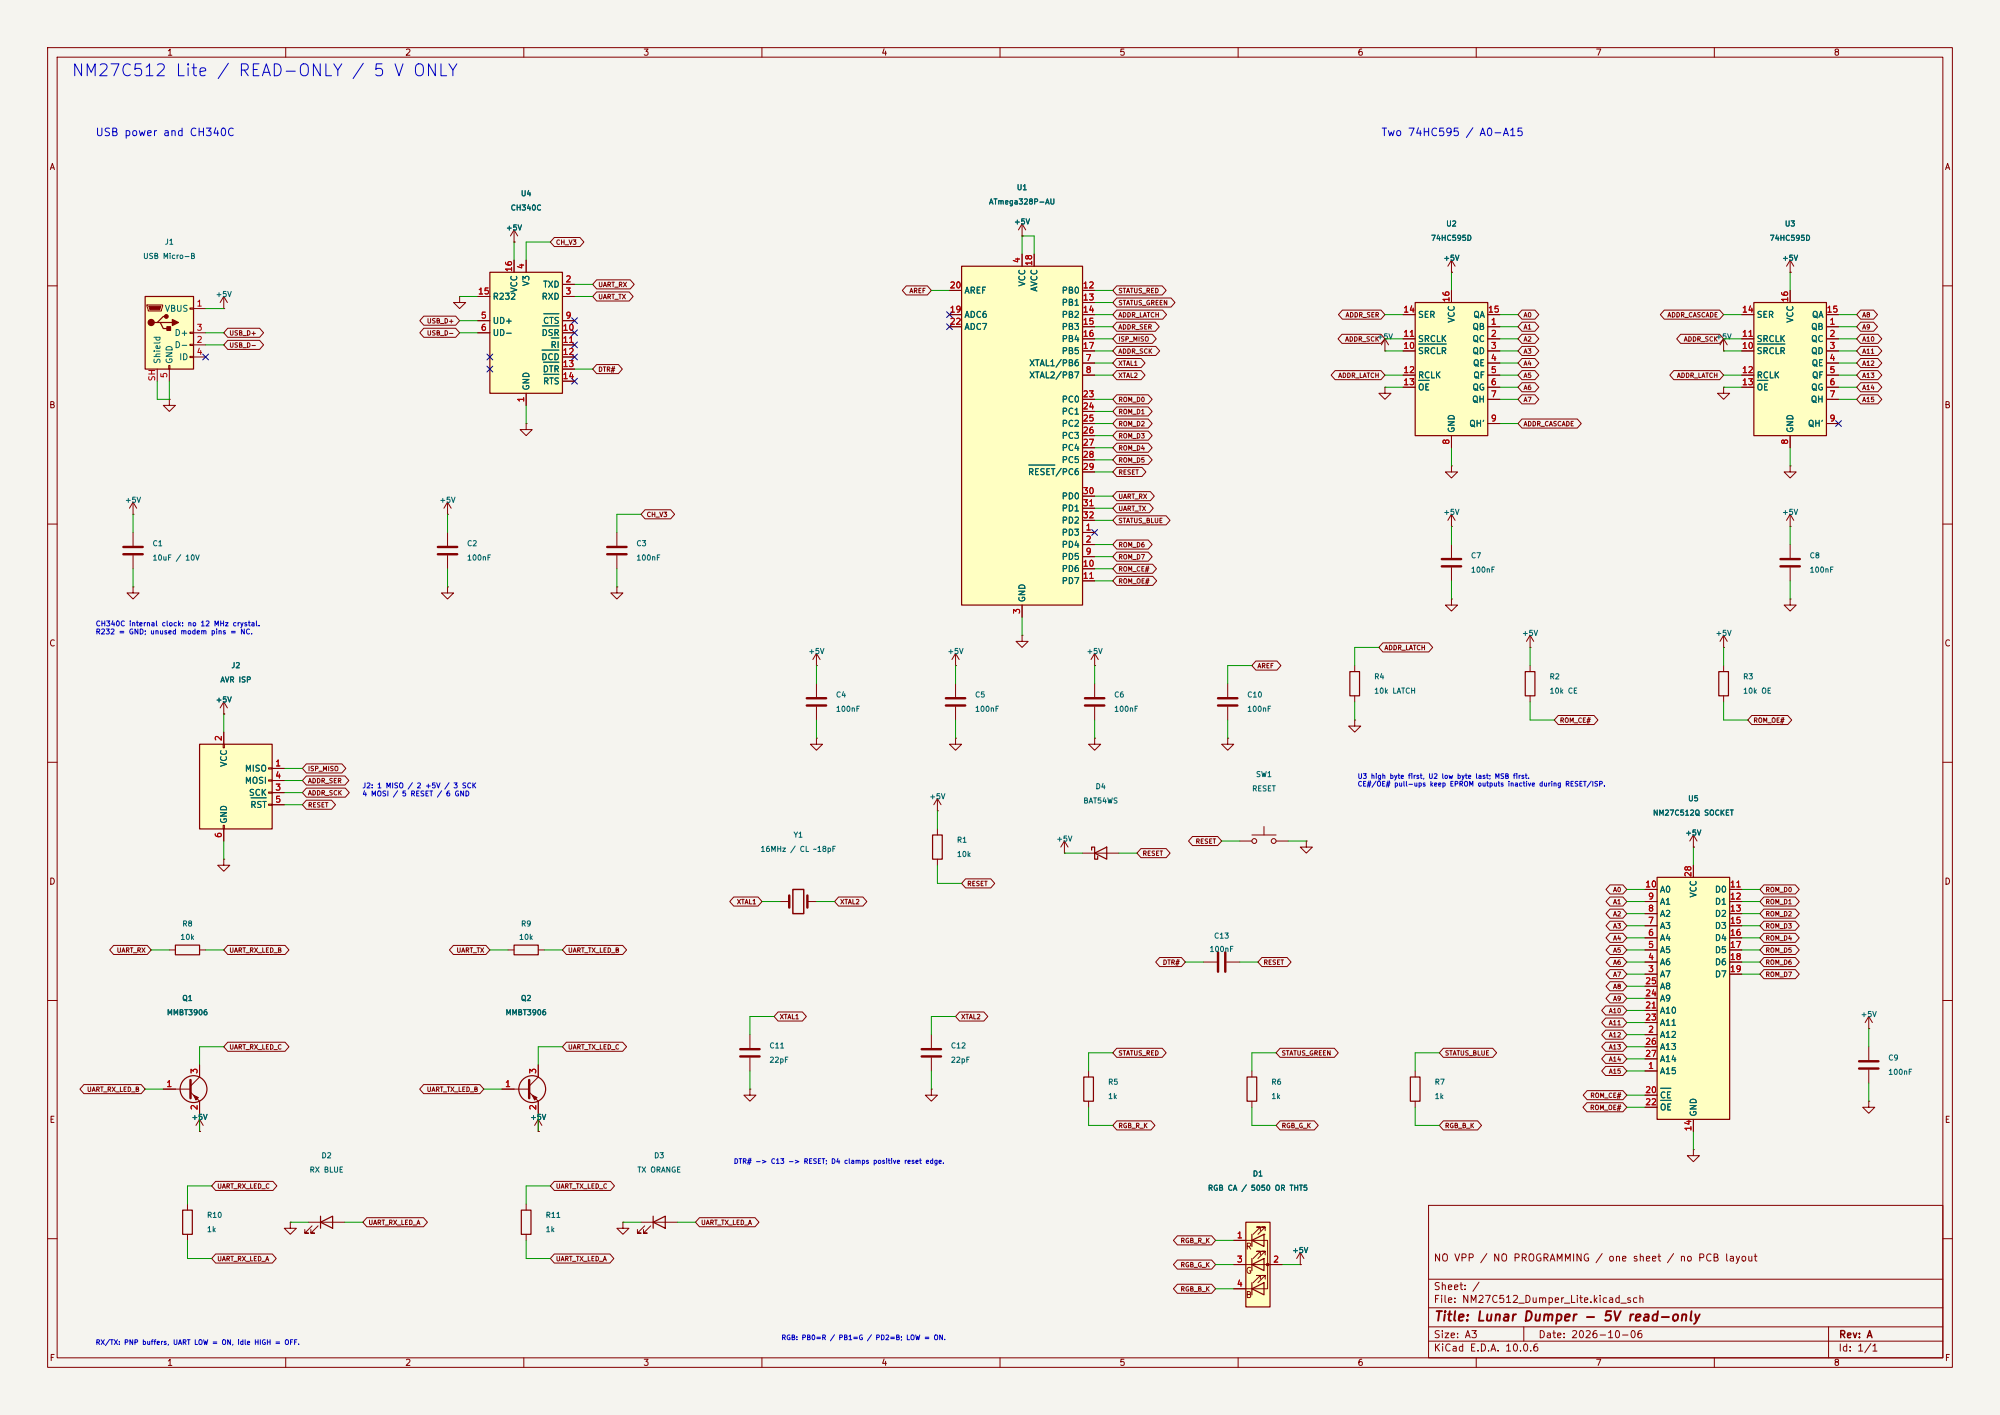
[picture p44: page 1]

CH340C internal clock: no 12 MHz crystal. R232 = GND; unused modem pins = NC. NM27C512 Lite / READ-ONLY / 5 V ONLY

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

SRCLR 10 SRCLK 11 RCLK 12 OE 13

U3 high byte first, U2 low byte last; MSB first. CE#/OE# pull-ups keep EPROM outputs inactive during RESET/ISP.

DTR# -> C13 -> RESET; D4 clamps positive reset edge.

NO VPP / NO PROGRAMMING / one sheet / no PCB layout

Sheet: /
File: NM27C512_Dumper_Lite.kicad_sch
Title: Lunar Dumper - 5V read-only

Size: A3 | Rev: A | F Date: 2026-10-06
KiCad E.D.A. 10.0.6 | Id: 1/1

RX/TX: PNP buffers, UART LOW = ON, idle HIGH = OFF.
