IlyaBOT/LunarView3/Adapter-KR573RF5/photomasks/KR573RF5_Adapter-B_Cu.pdf

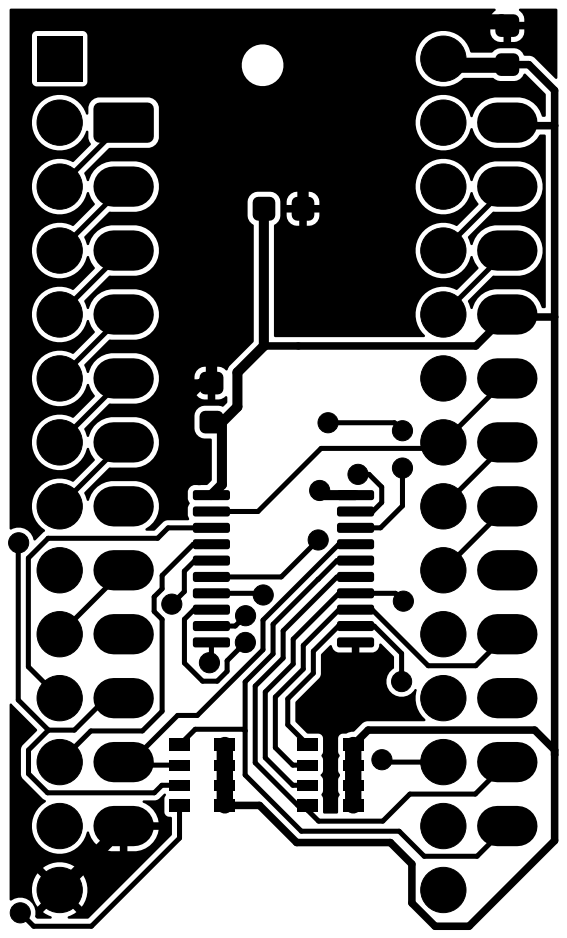
[picture p45: page 1]
