IlyaBOT/LunarView3/Adapter-KR573RF5/photomasks/KR573RF5_Adapter-B_Mask.pdf

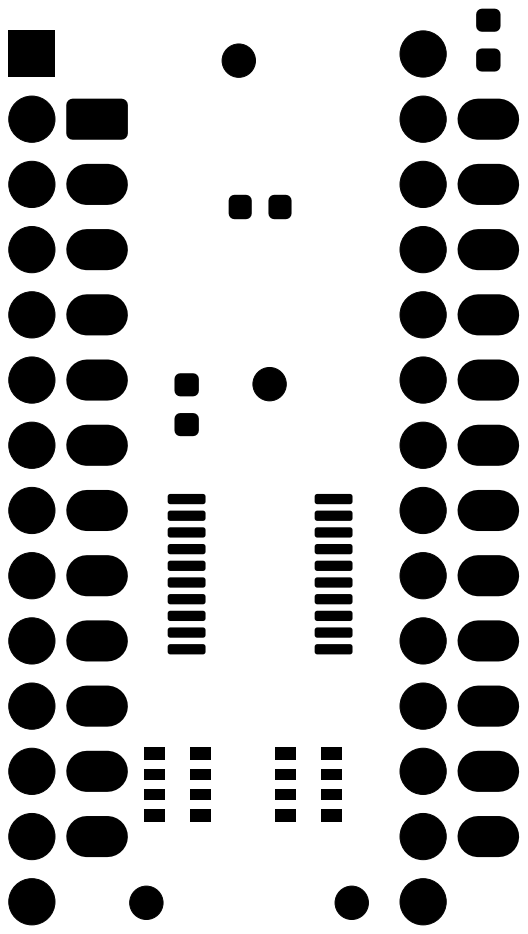
[picture p46: page 1]
