IlyaBOT/LunarView3/Adapter-KR573RF5/photomasks/KR573RF5_Adapter-F_Cu.pdf

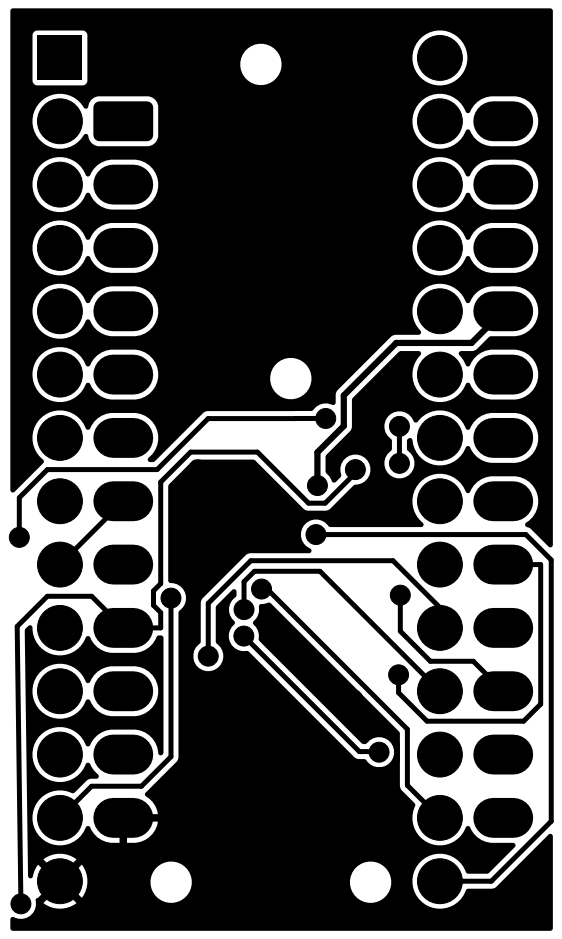
[picture p47: page 1]
