IlyaBOT/LunarView3/Adapter-KR573RF5/photomasks/KR573RF5_Adapter-F_Mask.pdf

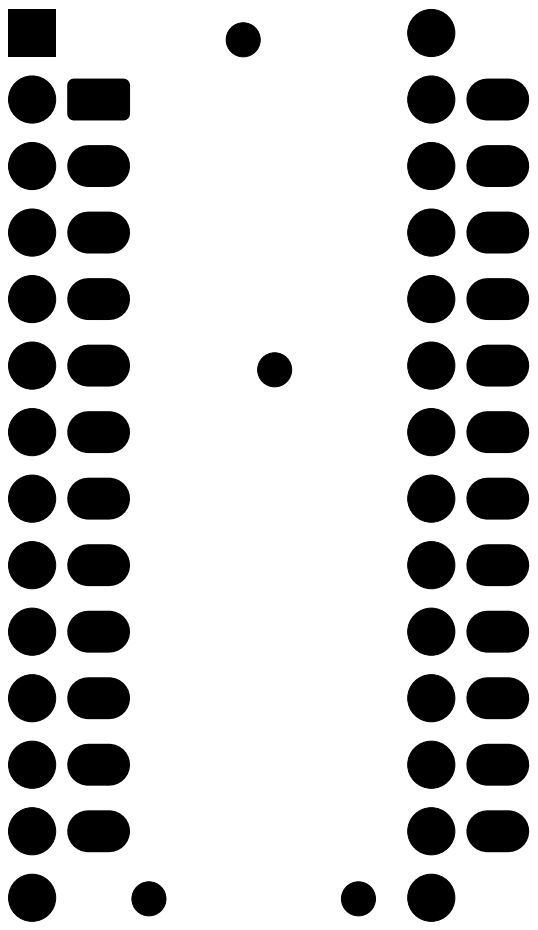
[picture p48: page 1]
