IlyaBOT/LunarView3/Dumper-Lite/ШаблоныПечать/NM27C512_Dumper_Lite-B_Cu.pdf

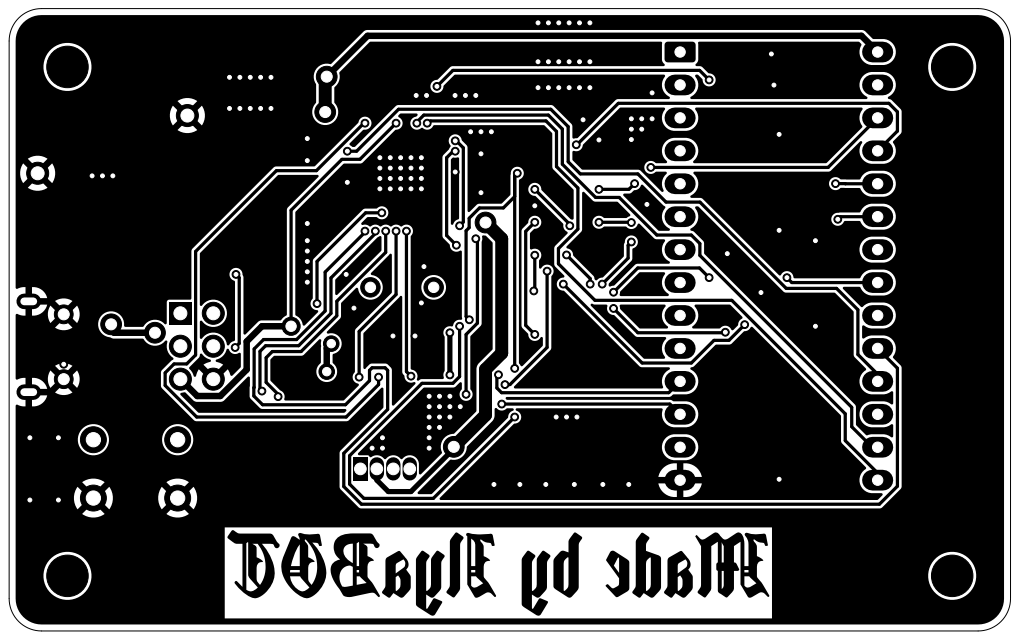
[picture p49: page 1]
