IlyaBOT/LunarView3/Dumper-Lite/ШаблоныПечать/NM27C512_Dumper_Lite-B_Mask.pdf

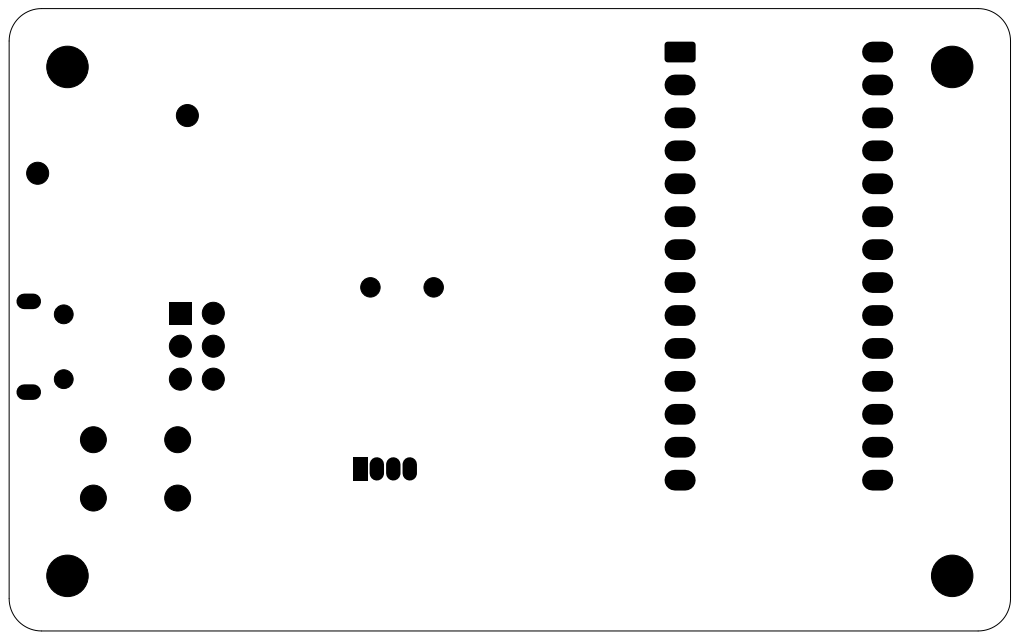
[picture p50: page 1]
