IlyaBOT/LunarView3/Dumper-Lite/ШаблоныПечать/NM27C512_Dumper_Lite-F_Cu.pdf

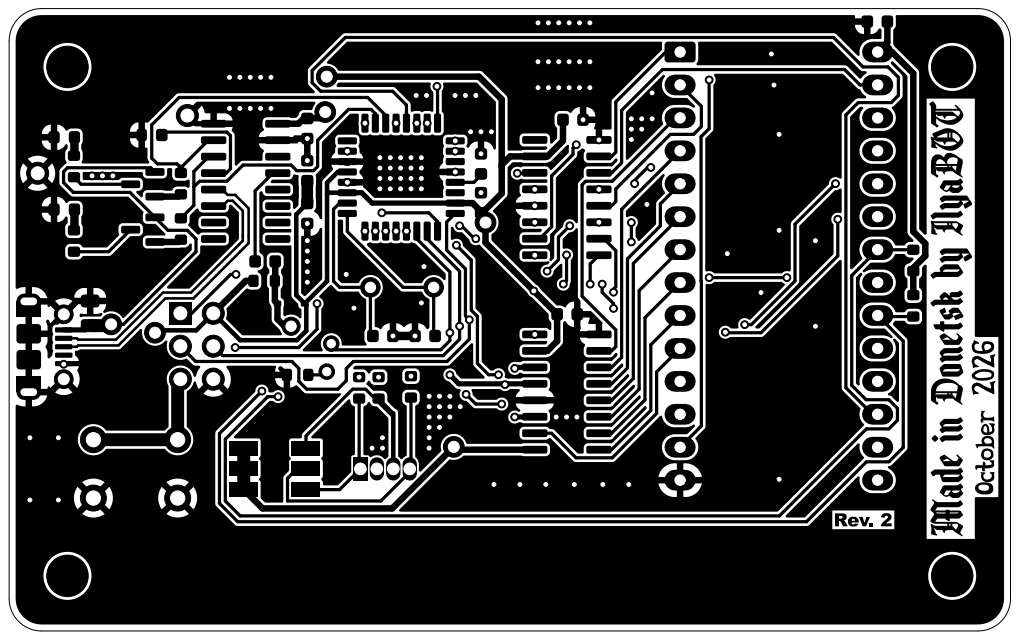
[picture p51: page 1]
