IlyaBOT/LunarView3/Dumper-Lite/ШаблоныПечать/NM27C512_Dumper_Lite-F_Mask.pdf

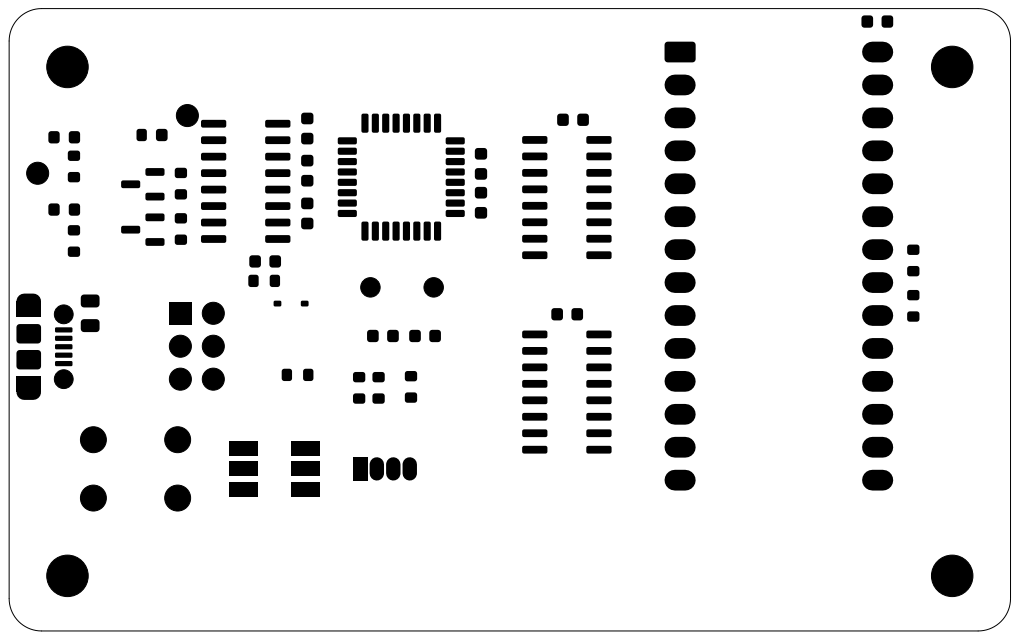
[picture p52: page 1]
