IlyaBOT/LunarView3/Lunar-Writer/production/Lunar_Writer_PCB.pdf

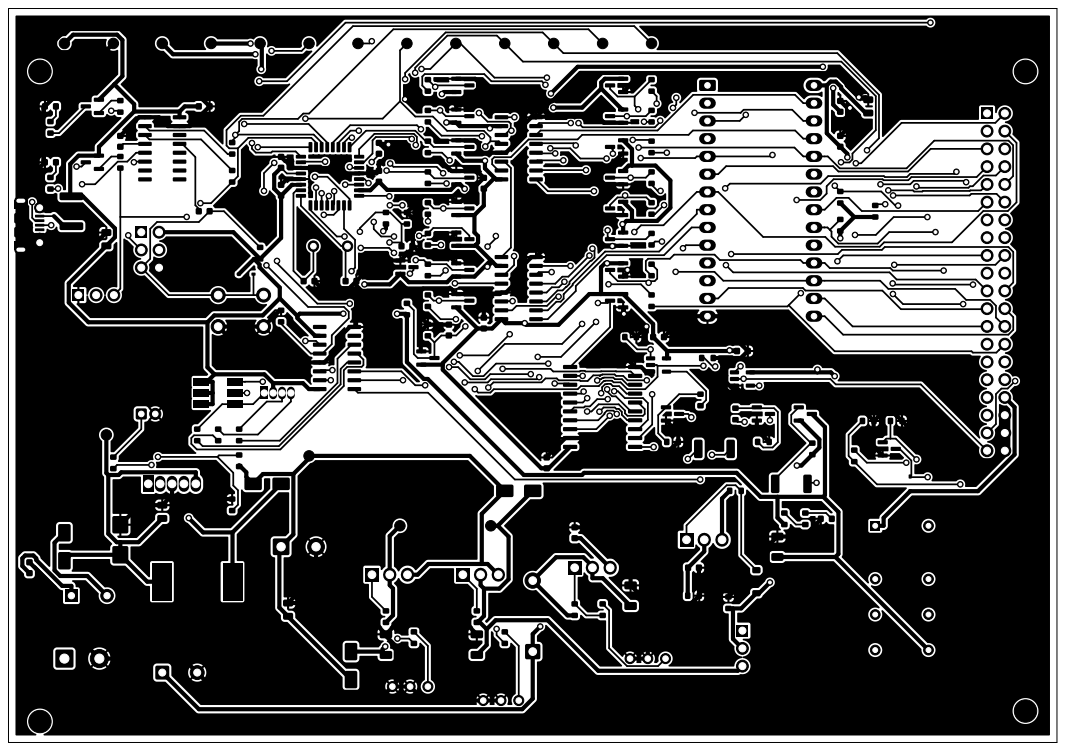
[picture p53: page 1]

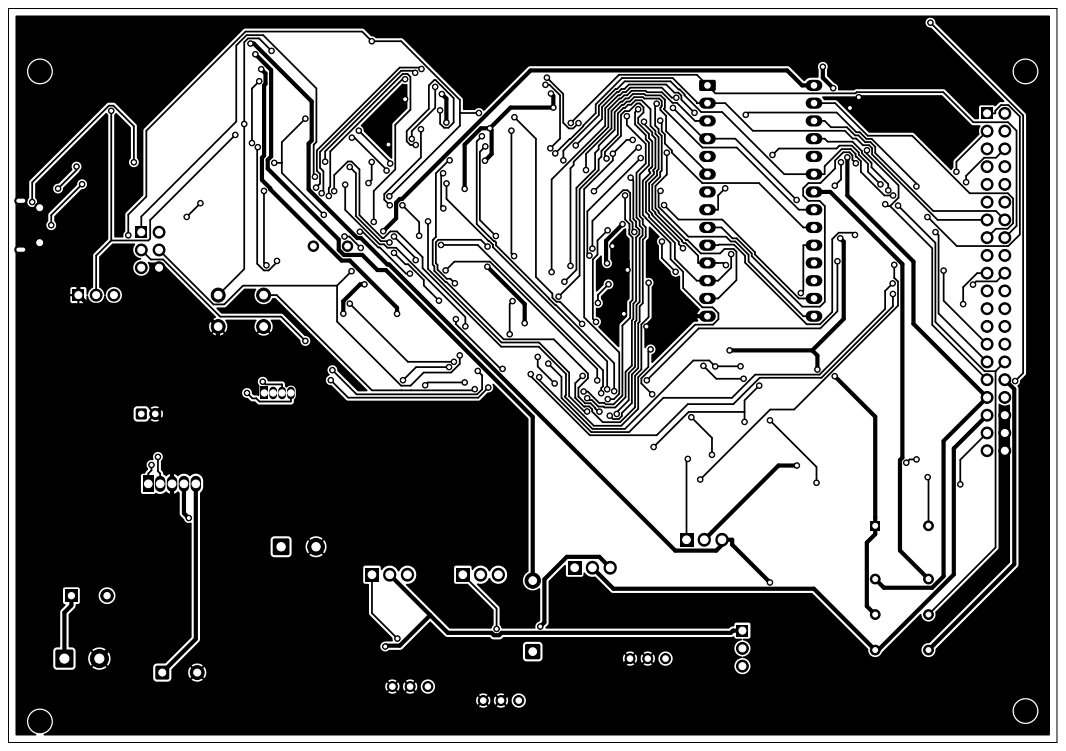
[picture p54: page 2]

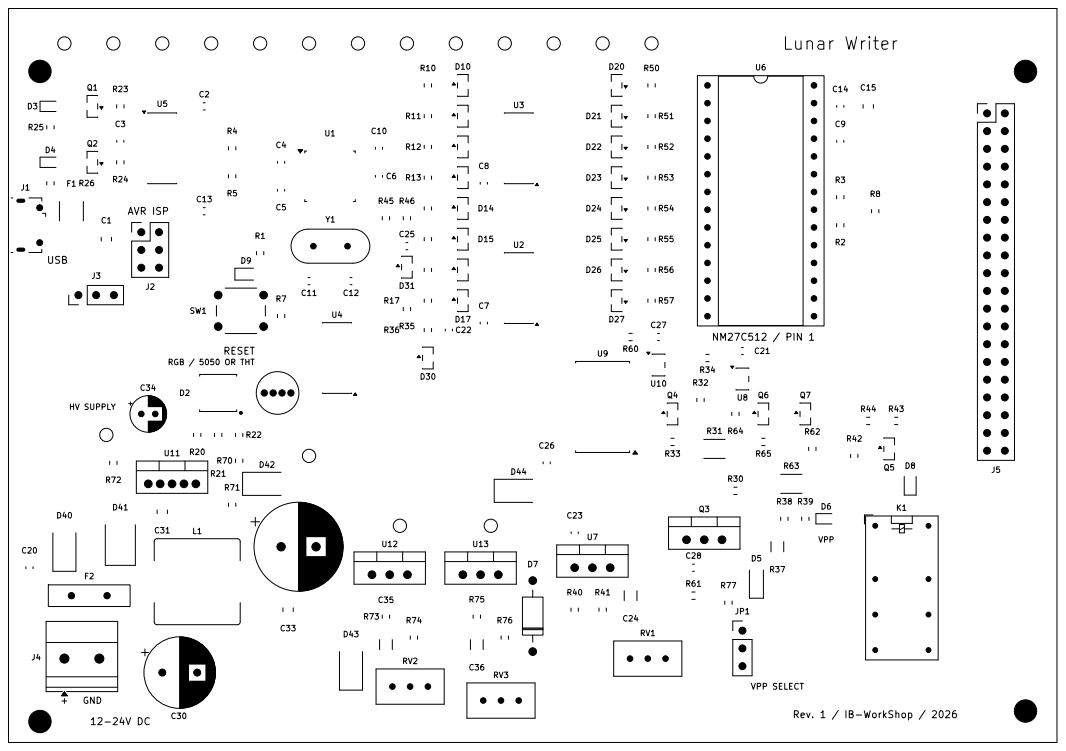
[picture p55: page 3]

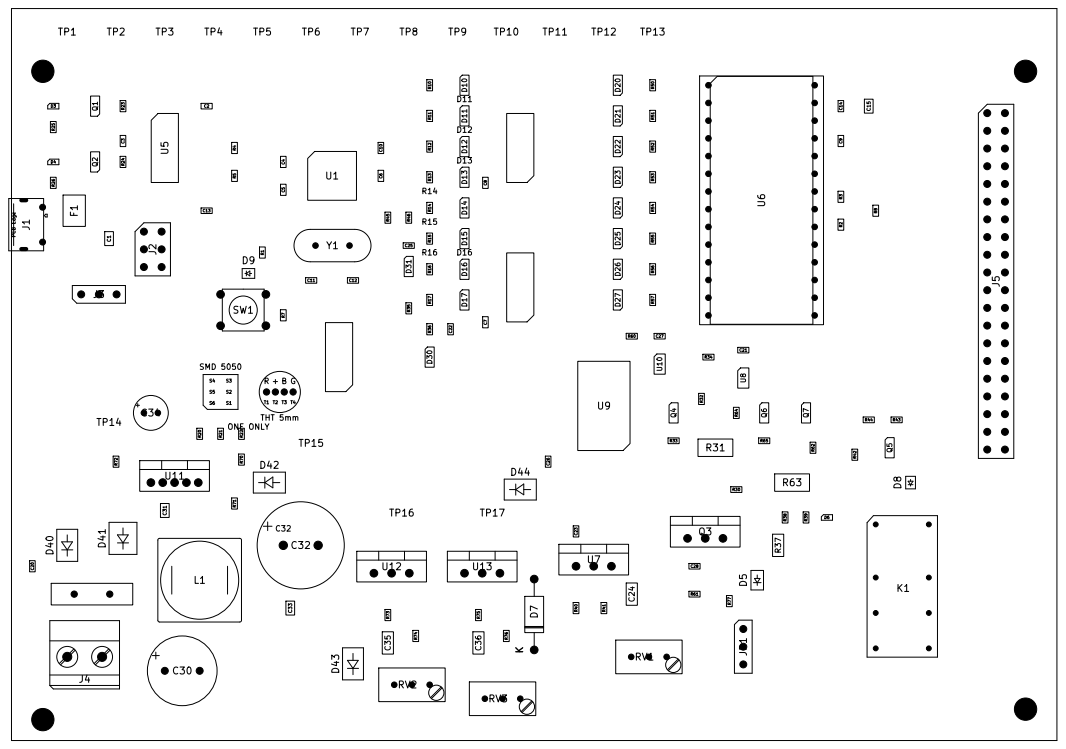
[picture p56: page 4]
