IlyaBOT/LunarView3/validation/lunar-products-2026-10-12/before-renaming/NM27C512_Dumper_Lite.kicad_pcb

## KiCad design validation/lunar-products-2026-10-12/before-renaming/NM27C512_Dumper_Lite.kicad_pcb (2026-10-16)

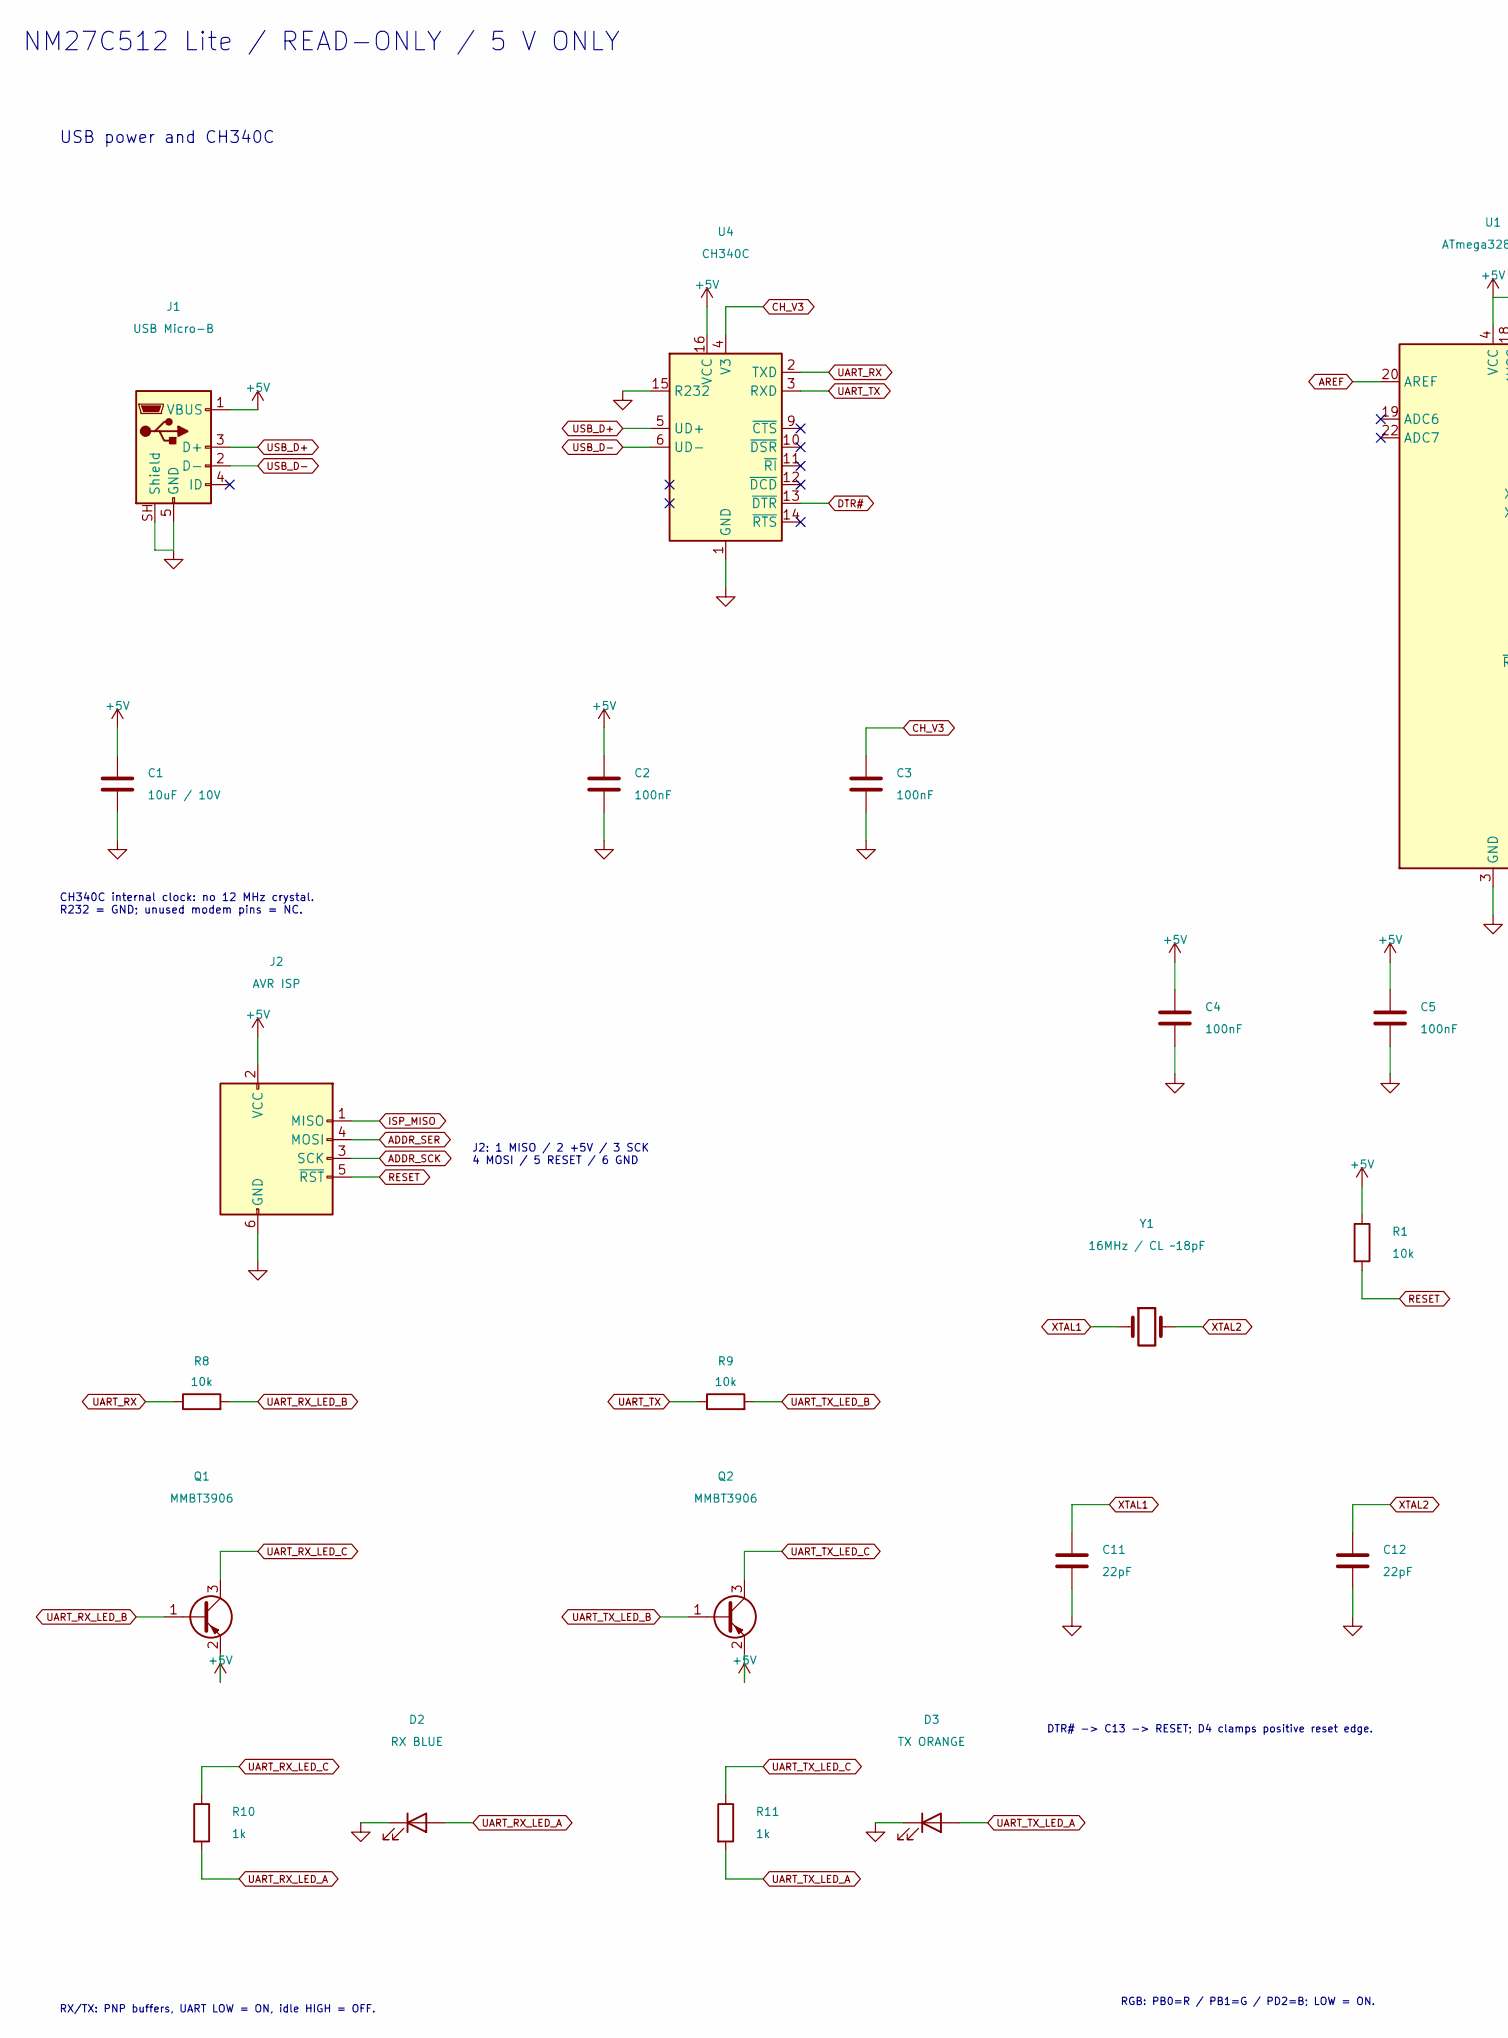
[picture p57: schematic NM27C512_Dumper_Lite.kicad_sch, NM27C512 Dumper Lite - read-only 5 V, part in row 1, column 1]

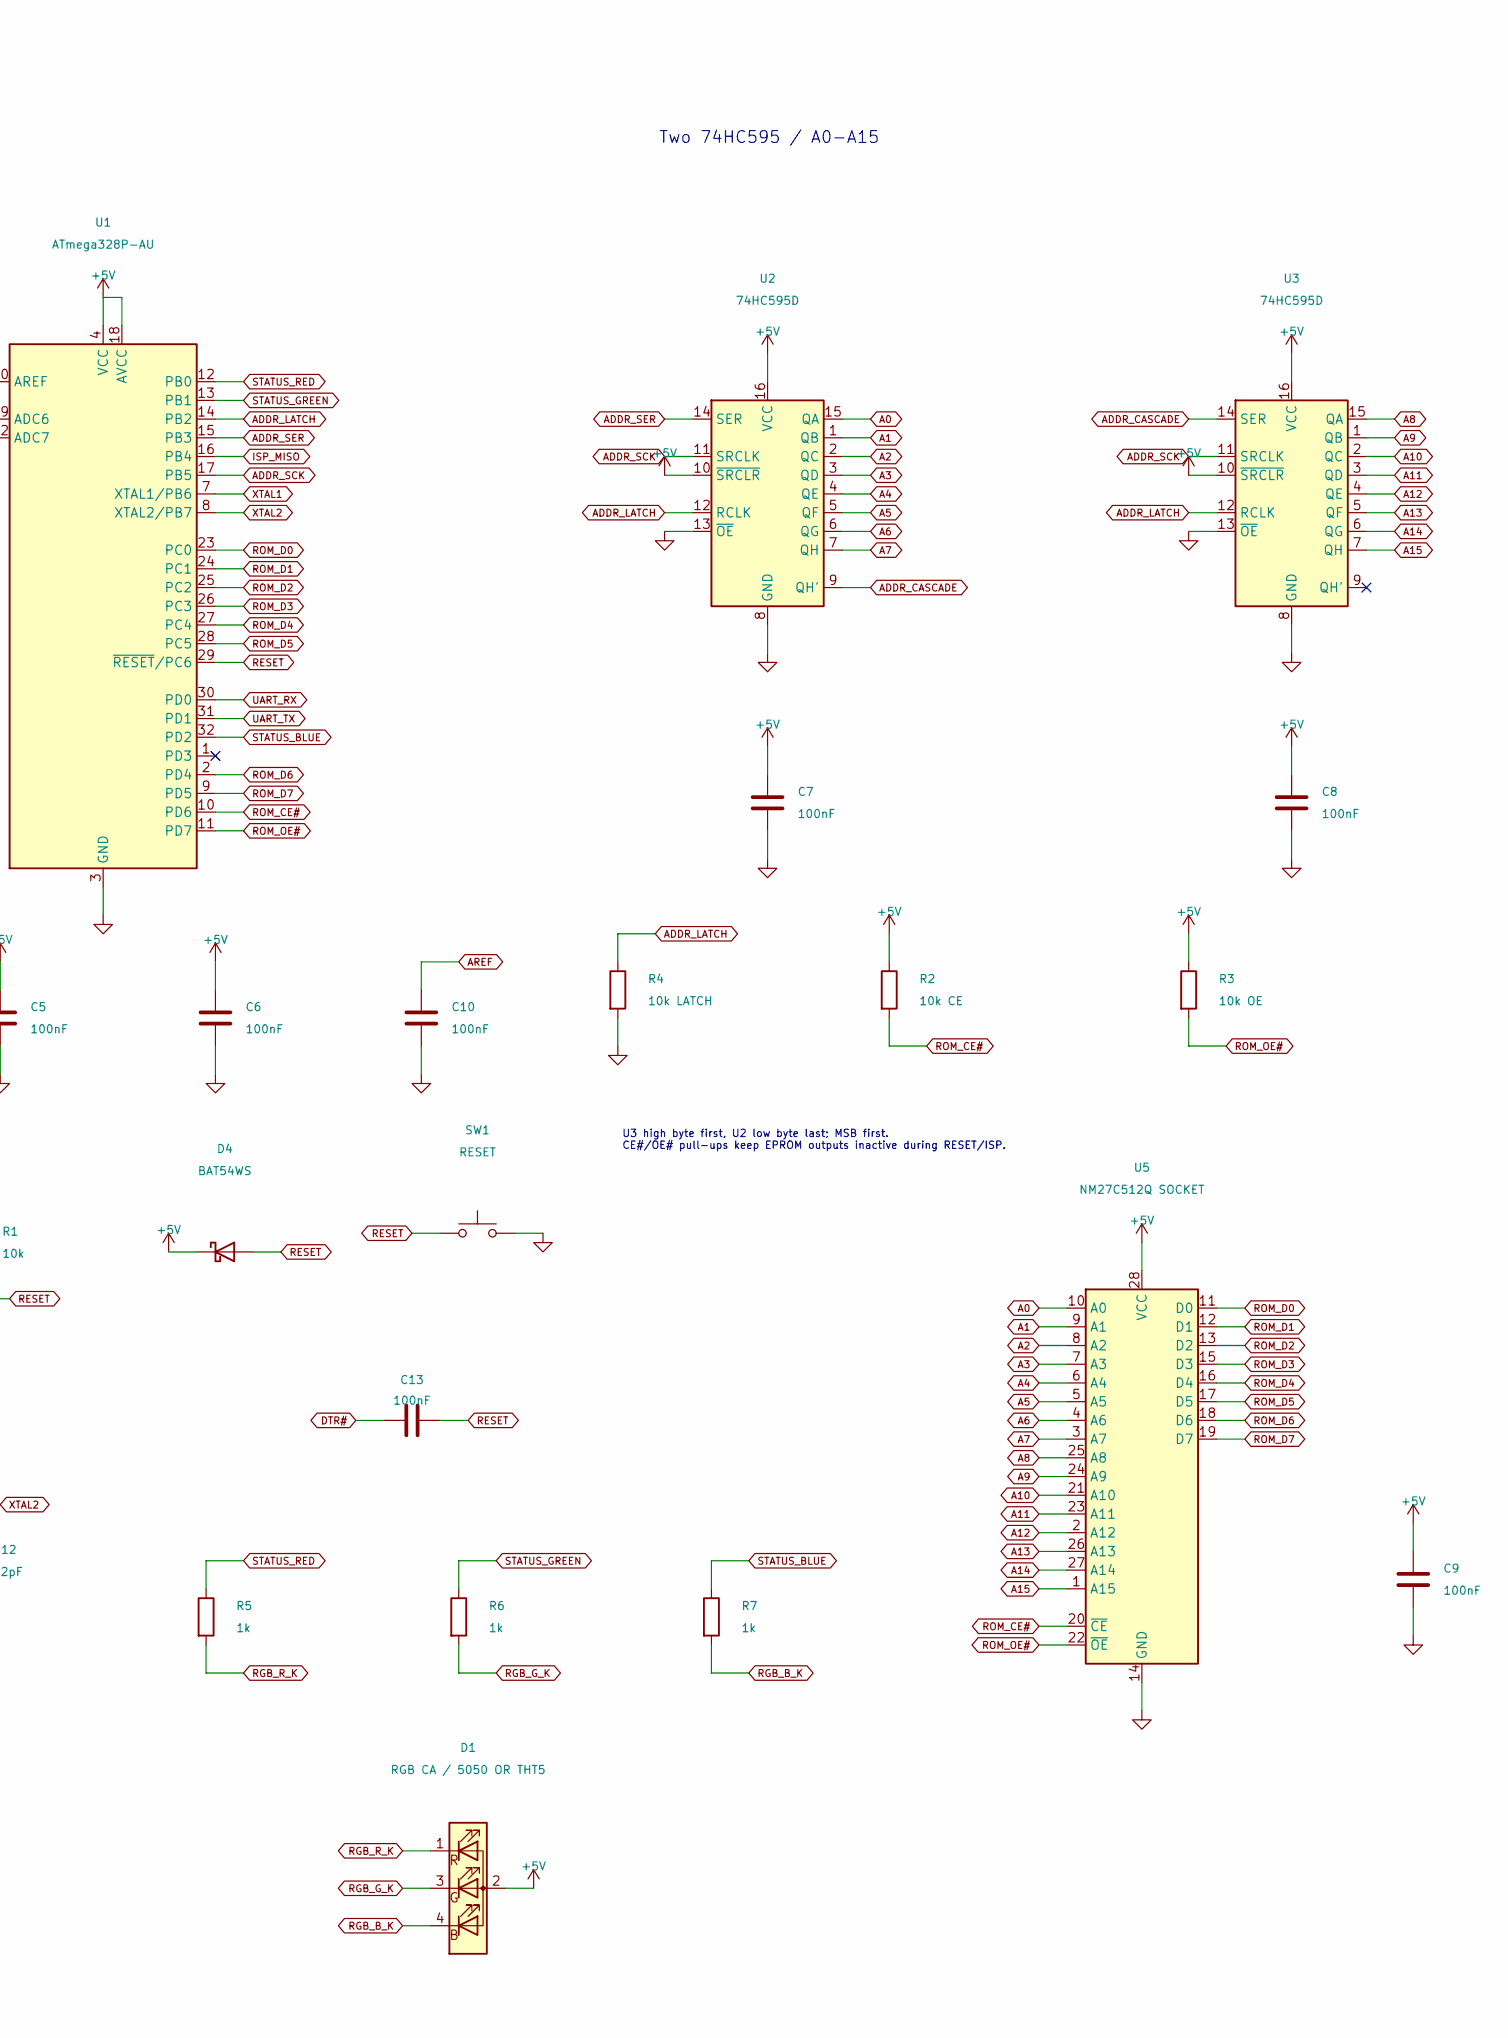
[picture p58: schematic NM27C512_Dumper_Lite.kicad_sch, NM27C512 Dumper Lite - read-only 5 V, part in row 1, column 2]

Parts:
C1: 10uF / 10V; C_0805_2012Metric
C2, C3, C4, C5, C6, C7, C8, C9, C10, C13: 100nF; C_0603_1608Metric
C11, C12: 22pF; C_0603_1608Metric
D1: RGB CA / 5050 OR THT5; RGB_CA_5050_or_THT5
D2: RX BLUE; LED_0603_1608Metric
D3: TX ORANGE; LED_0603_1608Metric
D4: BAT54WS; D_SOD-323
J1: USB Micro-B; USB_Micro-B_Molex-105017-0001
J2: AVR ISP; PinHeader_2x03_P2.54mm_Vertical
Q1, Q2: MMBT3906; SOT-23
R1, R8, R9: 10k; R_0603_1608Metric
R2: 10k CE; R_0603_1608Metric
R3: 10k OE; R_0603_1608Metric
R4: 10k LATCH; R_0603_1608Metric
R5, R6, R7, R10, R11: 1k; R_0603_1608Metric
SW1: RESET; SW_PUSH_6mm
U1: ATmega328P-AU; TQFP-32_7x7mm_P0.8mm
U2, U3: 74HC595D; SOIC-16_3.9x9.9mm_P1.27mm
U4: CH340C; SOIC-16_3.9x9.9mm_P1.27mm
U5: NM27C512Q SOCKET; DIP-28_W15.24mm_Socket_LongPads
Y1: 16MHz / CL ~18pF; Crystal_HC49-4H_Vertical

Connections:
+5V: C1.1, C2.1, C4.1, C5.1, C6.1, C7.1, C8.1, C9.1, D1.2 (A), D4.1 (K), J1.1 (VBUS), J2.2 (VCC), Q1.2 (E), Q2.2 (E), R1.1, R2.1, R3.1, U1.4 (VCC), U1.6 (VCC), U1.18 (AVCC), U2.10 (~SRCLR), U2.16 (VCC), U3.10 (~SRCLR), U3.16 (VCC), U4.16 (VCC), U5.28 (VCC)
A0: U2.15 (QA), U5.10 (A0)
A1: U2.1 (QB), U5.9 (A1)
A2: U2.2 (QC), U5.8 (A2)
A3: U2.3 (QD), U5.7 (A3)
A4: U2.4 (QE), U5.6 (A4)
A5: U2.5 (QF), U5.5 (A5)
A6: U2.6 (QG), U5.4 (A6)
A7: U2.7 (QH), U5.3 (A7)
A8: U3.15 (QA), U5.25 (A8)
A9: U3.1 (QB), U5.24 (A9)
A10: U3.2 (QC), U5.21 (A10)
A11: U3.3 (QD), U5.23 (A11)
A12: U3.4 (QE), U5.2 (A12)
A13: U3.5 (QF), U5.26 (A13)
A14: U3.6 (QG), U5.27 (A14)
A15: U3.7 (QH), U5.1 (A15)
ADDR_CASCADE: U2.9 (QH'), U3.14 (SER)
ADDR_LATCH: R4.1, U1.14 (PB2), U2.12 (RCLK), U3.12 (RCLK)
ADDR_SCK: J2.3 (SCK), U1.17 (PB5), U2.11 (SRCLK), U3.11 (SRCLK)
ADDR_SER: J2.4 (MOSI), U1.15 (PB3), U2.14 (SER)
AREF: C10.1, U1.20 (AREF)
CH_V3: C3.1, U4.4 (V3)
DTR#: C13.1, U4.13 (~DTR)
GND: C1.2, C2.2, C3.2, C4.2, C5.2, C6.2, C7.2, C8.2, C9.2, C10.2, C11.2, C12.2, D2.1 (K), D3.1 (K), J1.5 (GND), J1.SH (Shield), J2.6 (GND), R4.2, SW1.2, U1.3 (GND), U1.5 (GND), U1.21 (GND), U2.8 (GND), U2.13 (~OE), U3.8 (GND), U3.13 (~OE), U4.1 (GND), U4.15 (R232), U5.14 (GND)
ISP_MISO: J2.1 (MISO), U1.16 (PB4)
RESET: C13.2, D4.2 (A), J2.5 (~RST), R1.2, SW1.1, U1.29 (~RESET/PC6)
RGB_B_K: D1.4 (B), R7.2
RGB_G_K: D1.3 (G), R6.2
RGB_R_K: D1.1 (R), R5.2
ROM_CE#: R2.2, U1.10 (PD6), U5.20 (~CE)
ROM_D0: U1.23 (PC0), U5.11 (D0)
ROM_D1: U1.24 (PC1), U5.12 (D1)
ROM_D2: U1.25 (PC2), U5.13 (D2)
ROM_D3: U1.26 (PC3), U5.15 (D3)
ROM_D4: U1.27 (PC4), U5.16 (D4)
ROM_D5: U1.28 (PC5), U5.17 (D5)
ROM_D6: U1.2 (PD4), U5.18 (D6)
ROM_D7: U1.9 (PD5), U5.19 (D7)
ROM_OE#: R3.2, U1.11 (PD7), U5.22 (~OE)
STATUS_BLUE: R7.1, U1.32 (PD2)
STATUS_GREEN: R6.1, U1.13 (PB1)
STATUS_RED: R5.1, U1.12 (PB0)
UART_RX: R8.1, U1.30 (PD0), U4.2 (TXD)
UART_RX_LED_A: D2.2 (A), R10.2
UART_RX_LED_B: Q1.1 (B), R8.2
UART_RX_LED_C: Q1.3 (C), R10.1
UART_TX: R9.1, U1.31 (PD1), U4.3 (RXD)
UART_TX_LED_A: D3.2 (A), R11.2
UART_TX_LED_B: Q2.1 (B), R9.2
UART_TX_LED_C: Q2.3 (C), R11.1
USB_D+: J1.3 (D+), U4.5 (UD+)
USB_D-: J1.2 (D-), U4.6 (UD-)
XTAL1: C11.1, U1.7 (XTAL1/PB6), Y1.1
XTAL2: C12.1, U1.8 (XTAL2/PB7), Y1.2

Notes on the sheet:
RX/TX: PNP buffers, UART LOW = ON, idle HIGH = OFF.
RGB: PB0=R / PB1=G / PD2=B; LOW = ON.
U3 high byte first, U2 low byte last; MSB first. CE#/OE# pull-ups keep EPROM outputs inactive during RESET/ISP.
USB power and CH340C
NM27C512 Lite / READ-ONLY / 5 V ONLY
CH340C internal clock: no 12 MHz crystal. R232 = GND; unused modem pins = NC.
Two 74HC595 / A0-A15
DTR# -> C13 -> RESET; D4 clamps positive reset edge.
J2: 1 MISO / 2 +5V / 3 SCK 4 MOSI / 5 RESET / 6 GND

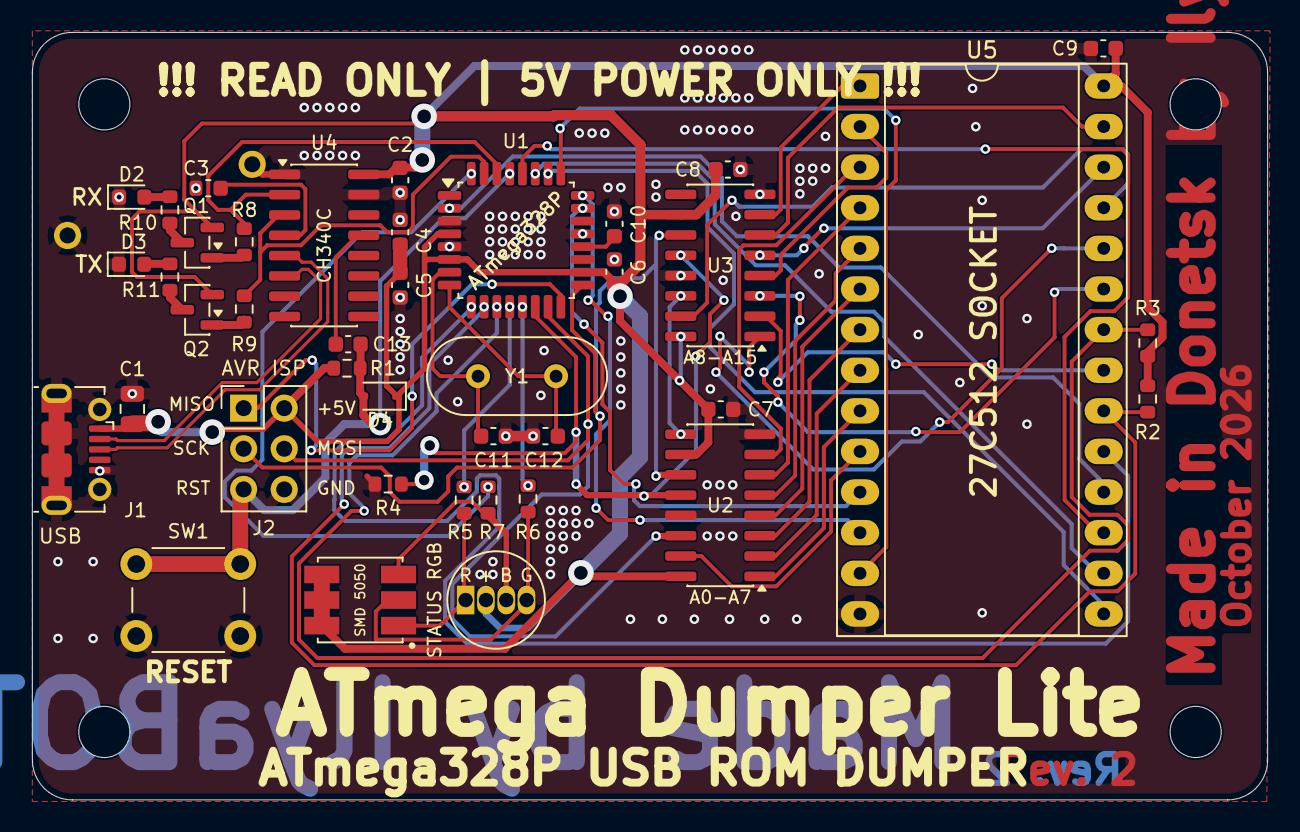
[picture p59: board NM27C512_Dumper_Lite.kicad_pcb from above]

Board: 2 copper layers, 77.2 x 48.0 mm, 43 parts (0 on the bottom side), 55 nets.

Other parts of the board:
H1, H2, H3, H4: M3 mounting hole; MountingHole_3.2mm_M3
