IlyaBOT/LunarView3/Adapter-KR573RF5/KR573RF5_Adapter.kicad_pcb

## KiCad design Adapter-KR573RF5/KR573RF5_Adapter.kicad_pcb (2026-10-16)

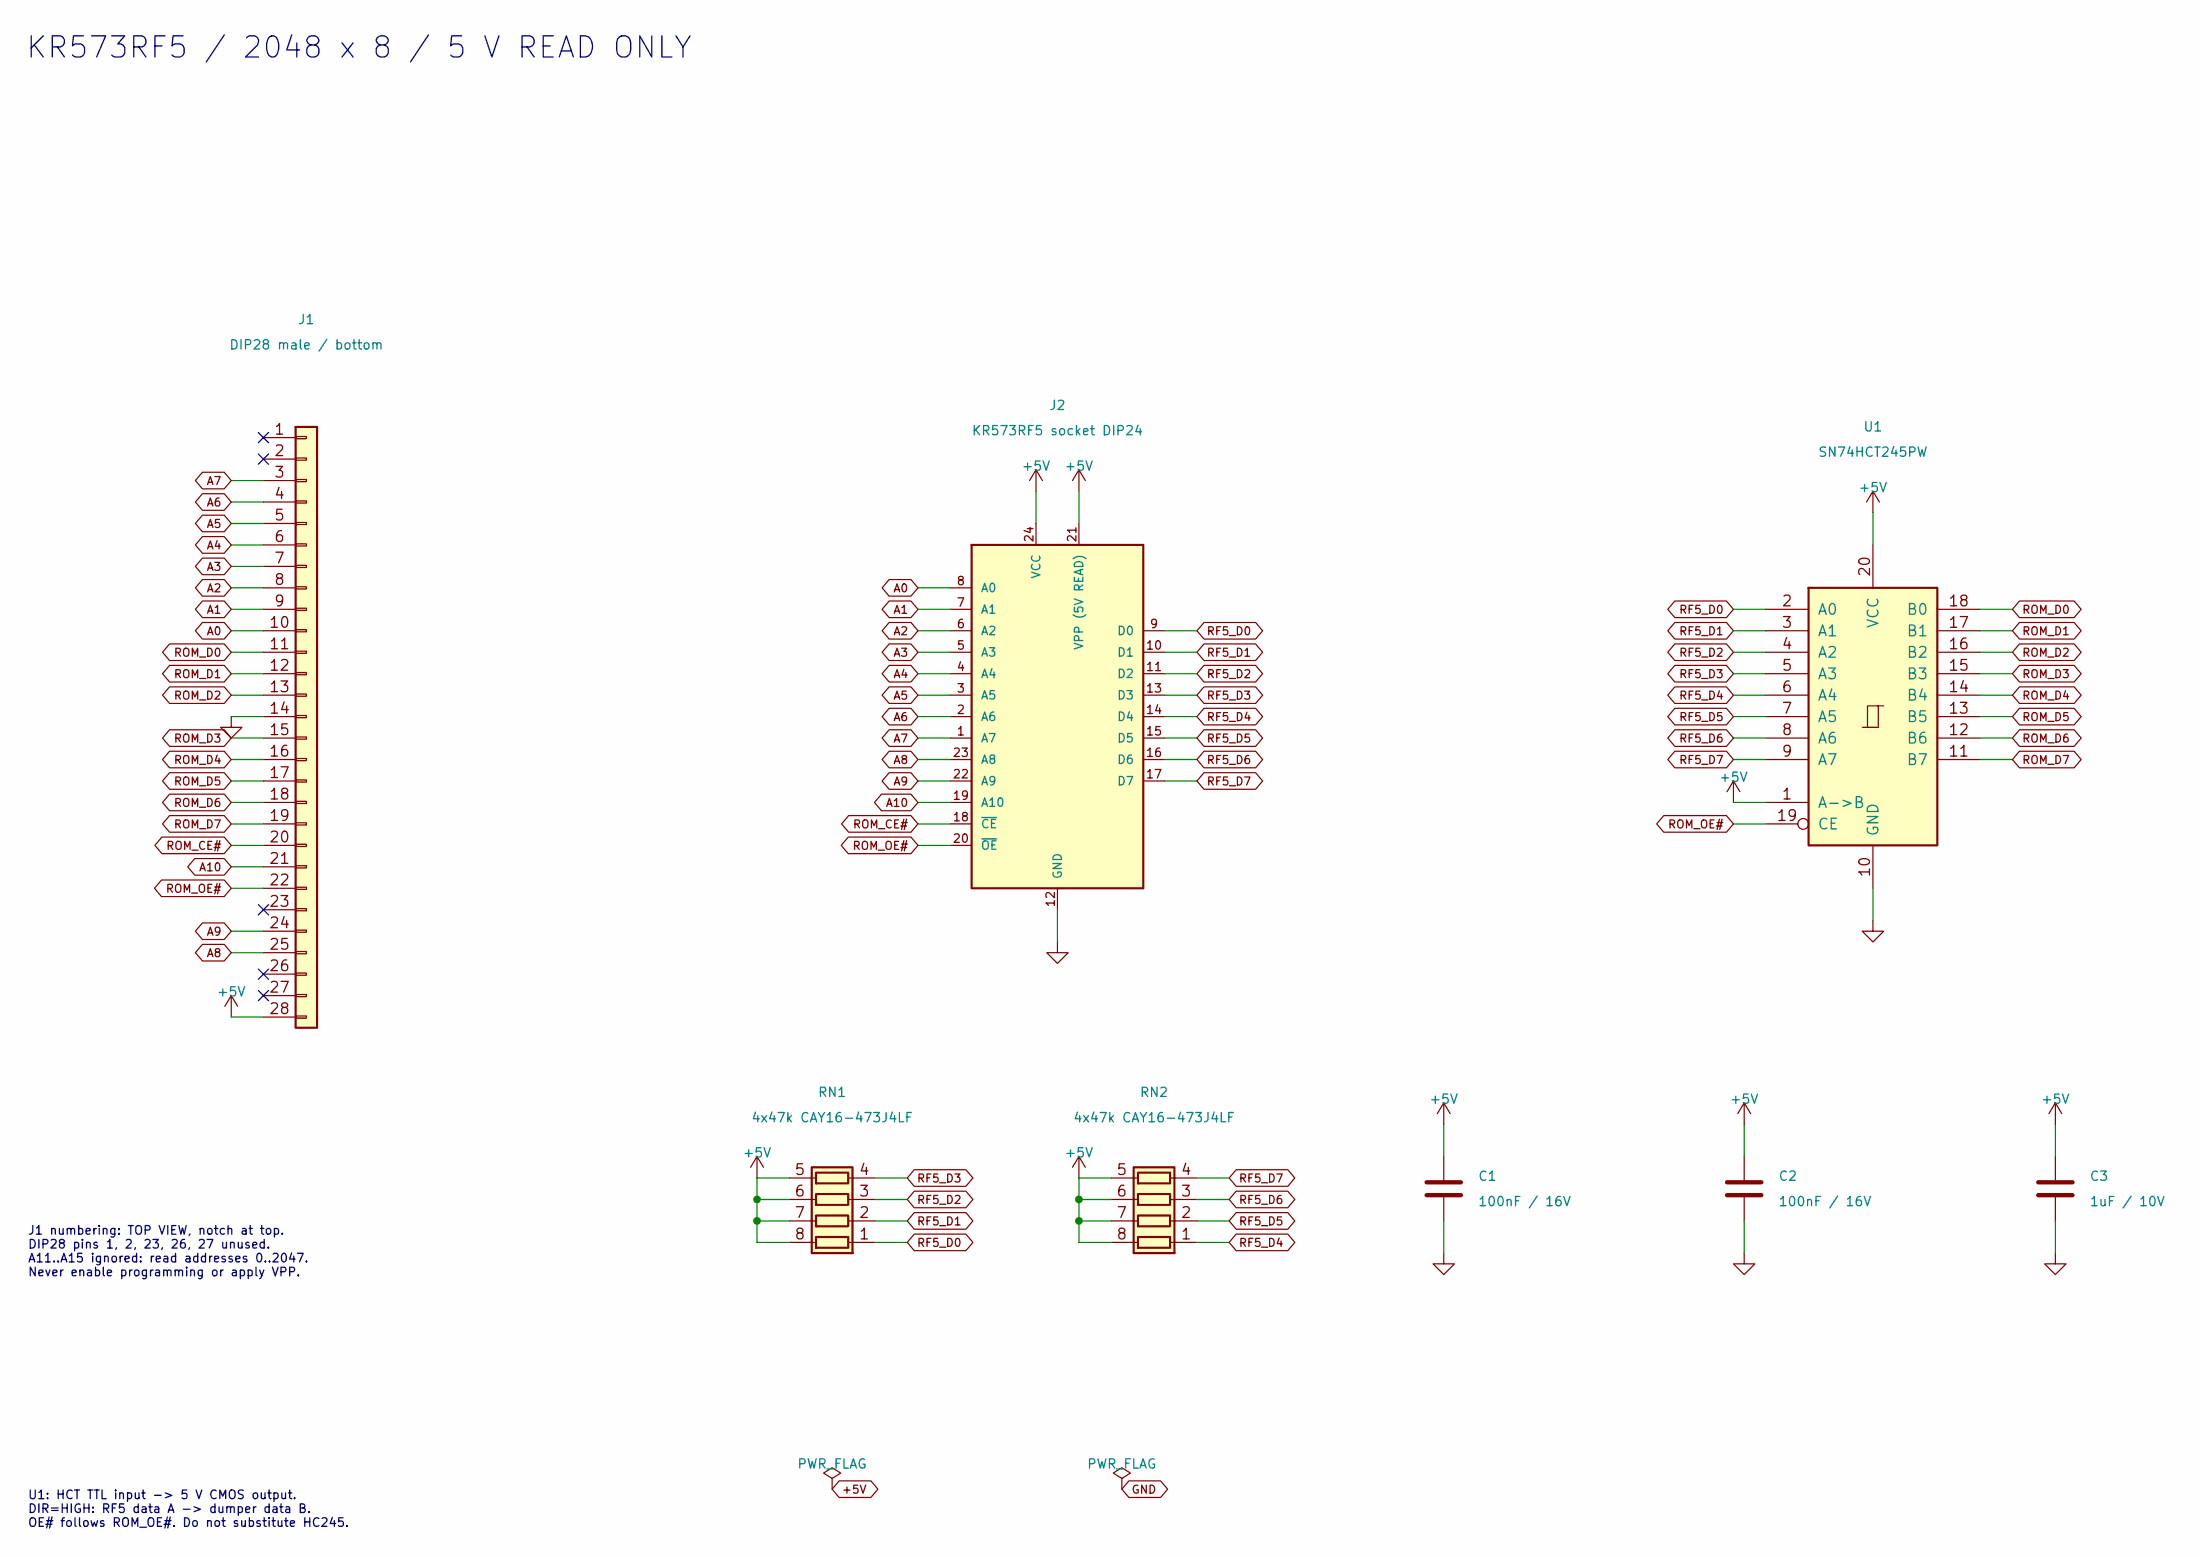
[picture p60: schematic KR573RF5_Adapter.kicad_sch, KR573RF5 compact read-only adapter]

Parts:
C1, C2: 100nF / 16V; C_0603_1608Metric
C3: 1uF / 10V; C_0603_1608Metric
J1: DIP28 male / bottom; DIP28_Male_RoundPins_Bottom
J2: KR573RF5 socket DIP24; DIP-24_W15.24mm_Socket_LongPads
RN1, RN2: 4x47k CAY16-473J4LF; R_Array_Convex_4x0603
U1: SN74HCT245PW; TSSOP-20_4.4x6.5mm_P0.65mm

Connections:
+5V: C1.1, C2.1, C3.1, J1.28, J2.21 (VPP (5V READ)), J2.24 (VCC), RN1.5 (R4.2), RN1.6 (R3.2), RN1.7 (R2.2), RN1.8 (R1.2), RN2.5 (R4.2), RN2.6 (R3.2), RN2.7 (R2.2), RN2.8 (R1.2), U1.1 (A->B), U1.20 (VCC)
A0: J1.10, J2.8 (A0)
A1: J1.9, J2.7 (A1)
A2: J1.8, J2.6 (A2)
A3: J1.7, J2.5 (A3)
A4: J1.6, J2.4 (A4)
A5: J1.5, J2.3 (A5)
A6: J1.4, J2.2 (A6)
A7: J1.3, J2.1 (A7)
A8: J1.25, J2.23 (A8)
A9: J1.24, J2.22 (A9)
A10: J1.21, J2.19 (A10)
GND: C1.2, C2.2, C3.2, J1.14, J2.12 (GND), U1.10 (GND)
RF5_D0: J2.9 (D0), RN1.1 (R1.1), U1.2 (A0)
RF5_D1: J2.10 (D1), RN1.2 (R2.1), U1.3 (A1)
RF5_D2: J2.11 (D2), RN1.3 (R3.1), U1.4 (A2)
RF5_D3: J2.13 (D3), RN1.4 (R4.1), U1.5 (A3)
RF5_D4: J2.14 (D4), RN2.1 (R1.1), U1.6 (A4)
RF5_D5: J2.15 (D5), RN2.2 (R2.1), U1.7 (A5)
RF5_D6: J2.16 (D6), RN2.3 (R3.1), U1.8 (A6)
RF5_D7: J2.17 (D7), RN2.4 (R4.1), U1.9 (A7)
ROM_CE#: J1.20, J2.18 (~CE)
ROM_D0: J1.11, U1.18 (B0)
ROM_D1: J1.12, U1.17 (B1)
ROM_D2: J1.13, U1.16 (B2)
ROM_D3: J1.15, U1.15 (B3)
ROM_D4: J1.16, U1.14 (B4)
ROM_D5: J1.17, U1.13 (B5)
ROM_D6: J1.18, U1.12 (B6)
ROM_D7: J1.19, U1.11 (B7)
ROM_OE#: J1.22, J2.20 (~OE), U1.19 (CE)

Notes on the sheet:
KR573RF5 / 2048 x 8 / 5 V READ ONLY
J1 numbering: TOP VIEW, notch at top. DIP28 pins 1, 2, 23, 26, 27 unused. A11..A15 ignored: read addresses 0..2047. Never enable programming or apply VPP.
U1: HCT TTL input -> 5 V CMOS output. DIR=HIGH: RF5 data A -> dumper data B. OE# follows ROM_OE#. Do not substitute HC245.

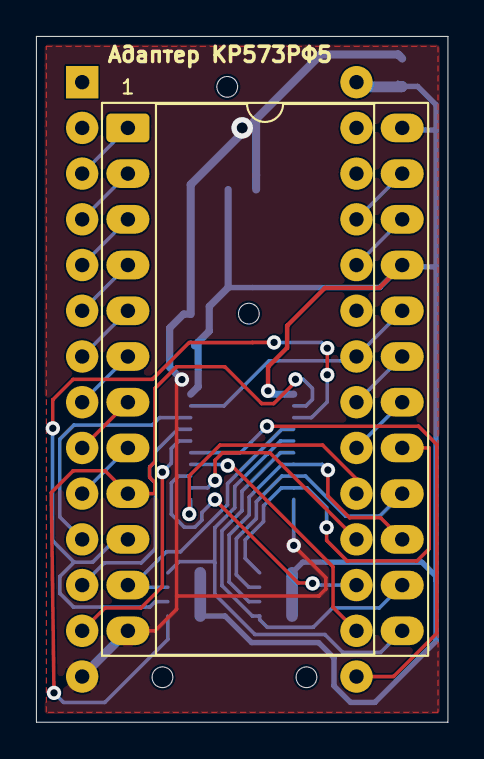
[picture p61: board KR573RF5_Adapter.kicad_pcb from above]

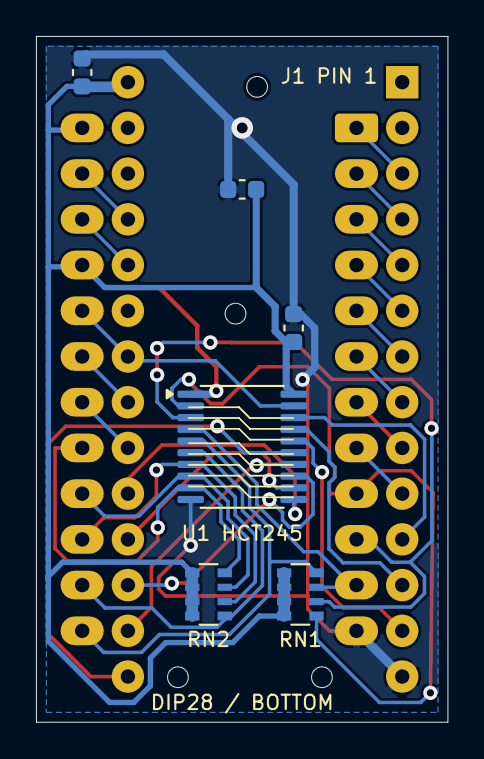
[picture p62: board KR573RF5_Adapter.kicad_pcb from below]

Board: 2 copper layers, 22.9 x 38.1 mm, 8 parts (7 on the bottom side), 31 nets.
