IlyaBOT/LunarView3/NM27C512_Dumper.kicad_pcb

## KiCad design NM27C512_Dumper.kicad_pcb (2026-10-16)

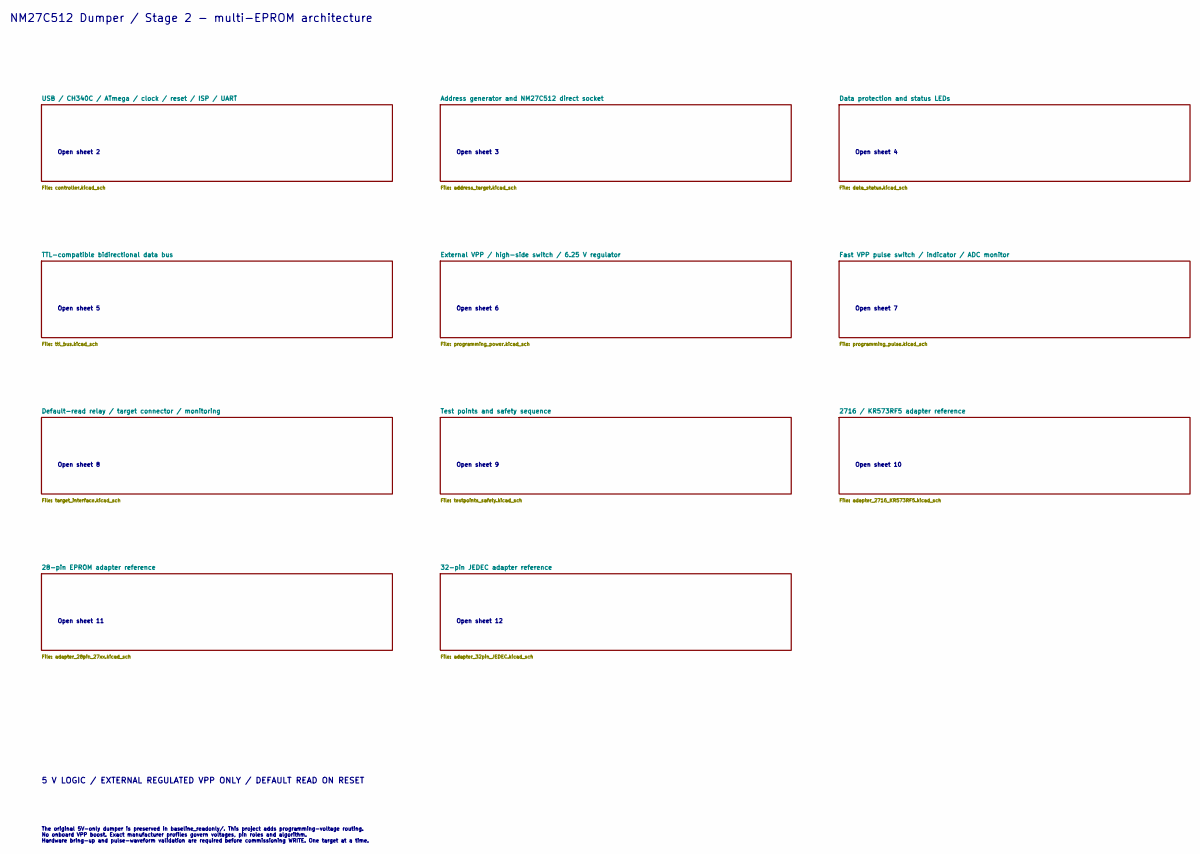
[picture p63: schematic NM27C512_Dumper.kicad_sch, NM27C512 Dumper - Stage 2 Rev A]

Notes on the sheet:
Open sheet 8
Open sheet 5
5 V LOGIC / EXTERNAL REGULATED VPP ONLY / DEFAULT READ ON RESET
Open sheet 12
Open sheet 9
Open sheet 7
Open sheet 3
Open sheet 4
Open sheet 2
Open sheet 10
Open sheet 11
The original 5V-only dumper is preserved in baseline_readonly/. This project adds programming-voltage routing. No onboard VPP boost. Exact manufacturer profiles govern voltages, pin roles and algorithm. Hardware bring-up and pulse-waveform validation are required before commissioning WRITE. One tar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
NM27C512 Dumper / Stage 2 - multi-EPROM architecture
Open sheet 6

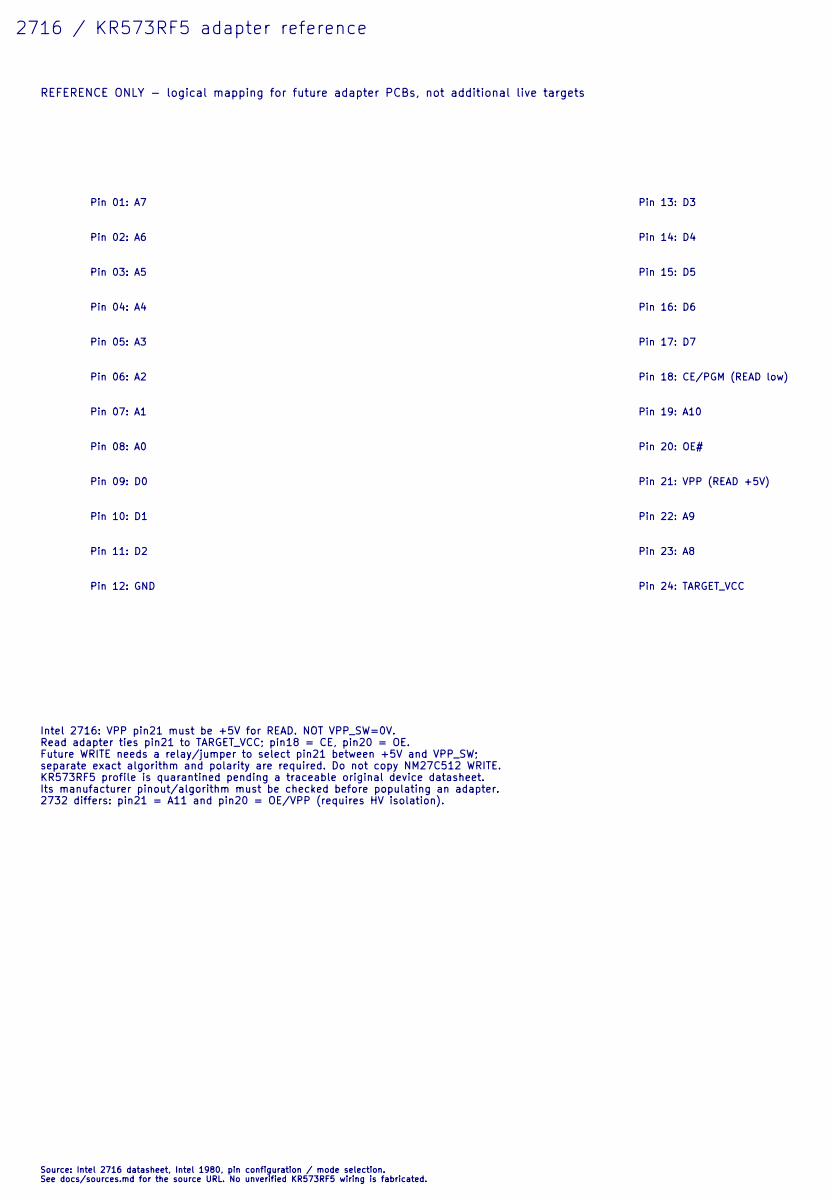
[picture p64: schematic adapter_2716_KR573RF5.kicad_sch, NM27C512 Dumper - Stage 2 Rev A]

Notes on the sheet:
Pin 16: D6
Pin 01: A7
Pin 06: A2
Pin 20: OE#
Pin 07: A1
Pin 21: VPP (READ +5V)
Pin 10: D1
Pin 14: D4
Pin 19: A10
Source: Intel 2716 datasheet, Intel 1980, pin configuration / mode selection. See docs/sources.md for the source URL. No unverified KR573RF5 wiring is fabricated.
Pin 08: A0
Pin 22: A9
Pin 24: TARGET_VCC
Pin 23: A8
Pin 13: D3
Pin 11: D2
Pin 15: D5
Pin 04: A4
Pin 03: A5
Pin 05: A3
Pin 17: D7
Pin 12: GND
REFERENCE ONLY - logical mapping for future adapter PCBs, not additional live targets
Intel 2716: VPP pin21 must be +5V for READ. NOT VPP_SW=0V. Read adapter ties pin21 to TARGET_VCC; pin18 = CE, pin20 = OE. Future WRITE needs a relay/jumper to select pin21 between +5V and VPP_SW; separate exact algorithm and polarity are required. Do not copy NM27C512 WRITE. KR573RF5 profile is qua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
Pin 09: D0
2716 / KR573RF5 adapter reference
Pin 18: CE/PGM (READ low)
Pin 02: A6
