IlyaBOT/LunarView3/NM27C512_Dumper.kicad_pcb

## KiCad design NM27C512_Dumper.kicad_pcb (continued)

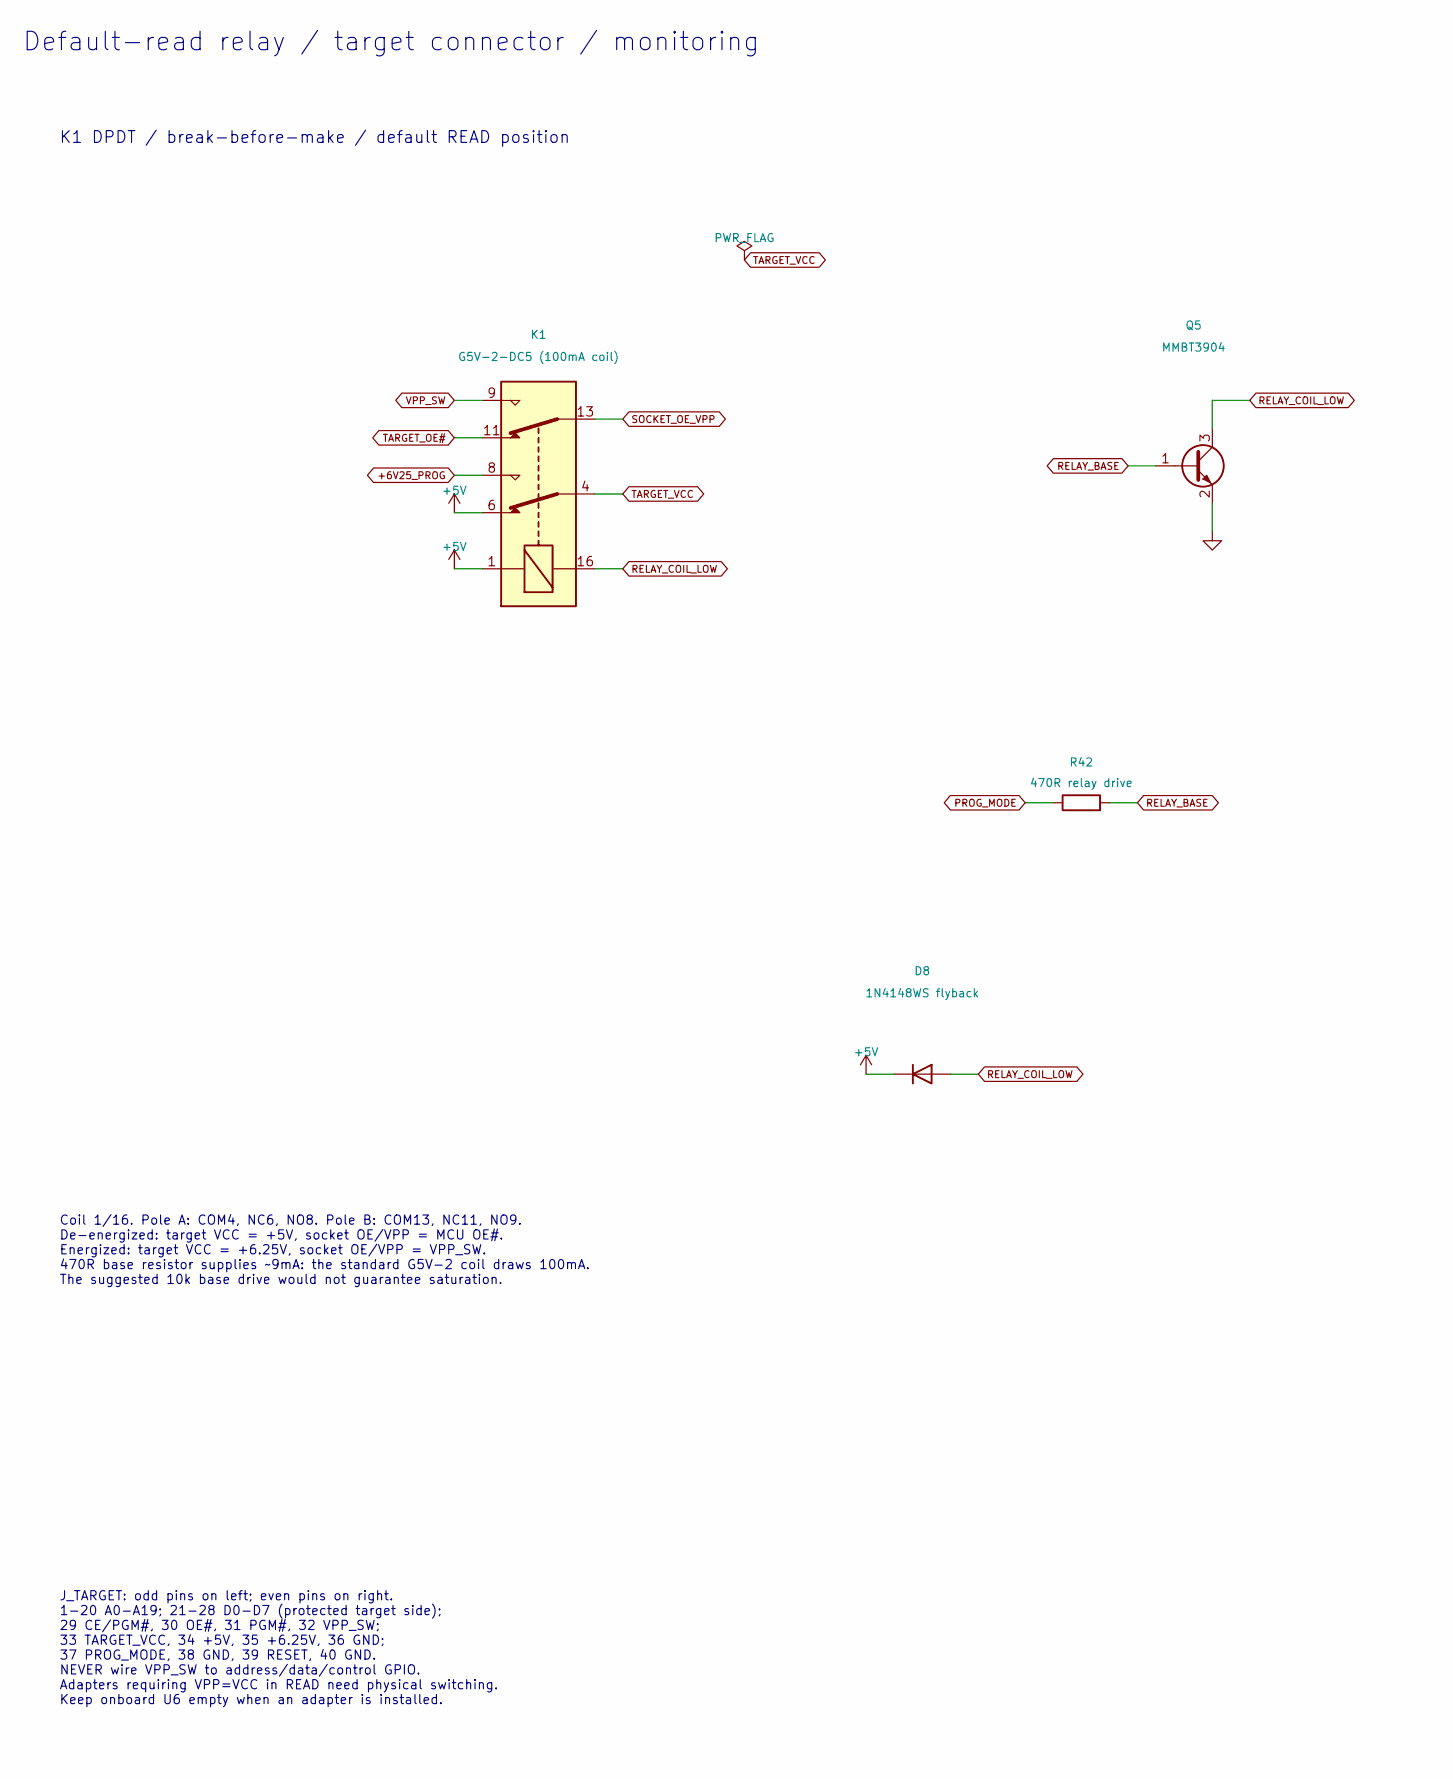
[picture p65: schematic target_interface.kicad_sch, NM27C512 Dumper - Stage 2 Rev A, part in row 1, column 1]

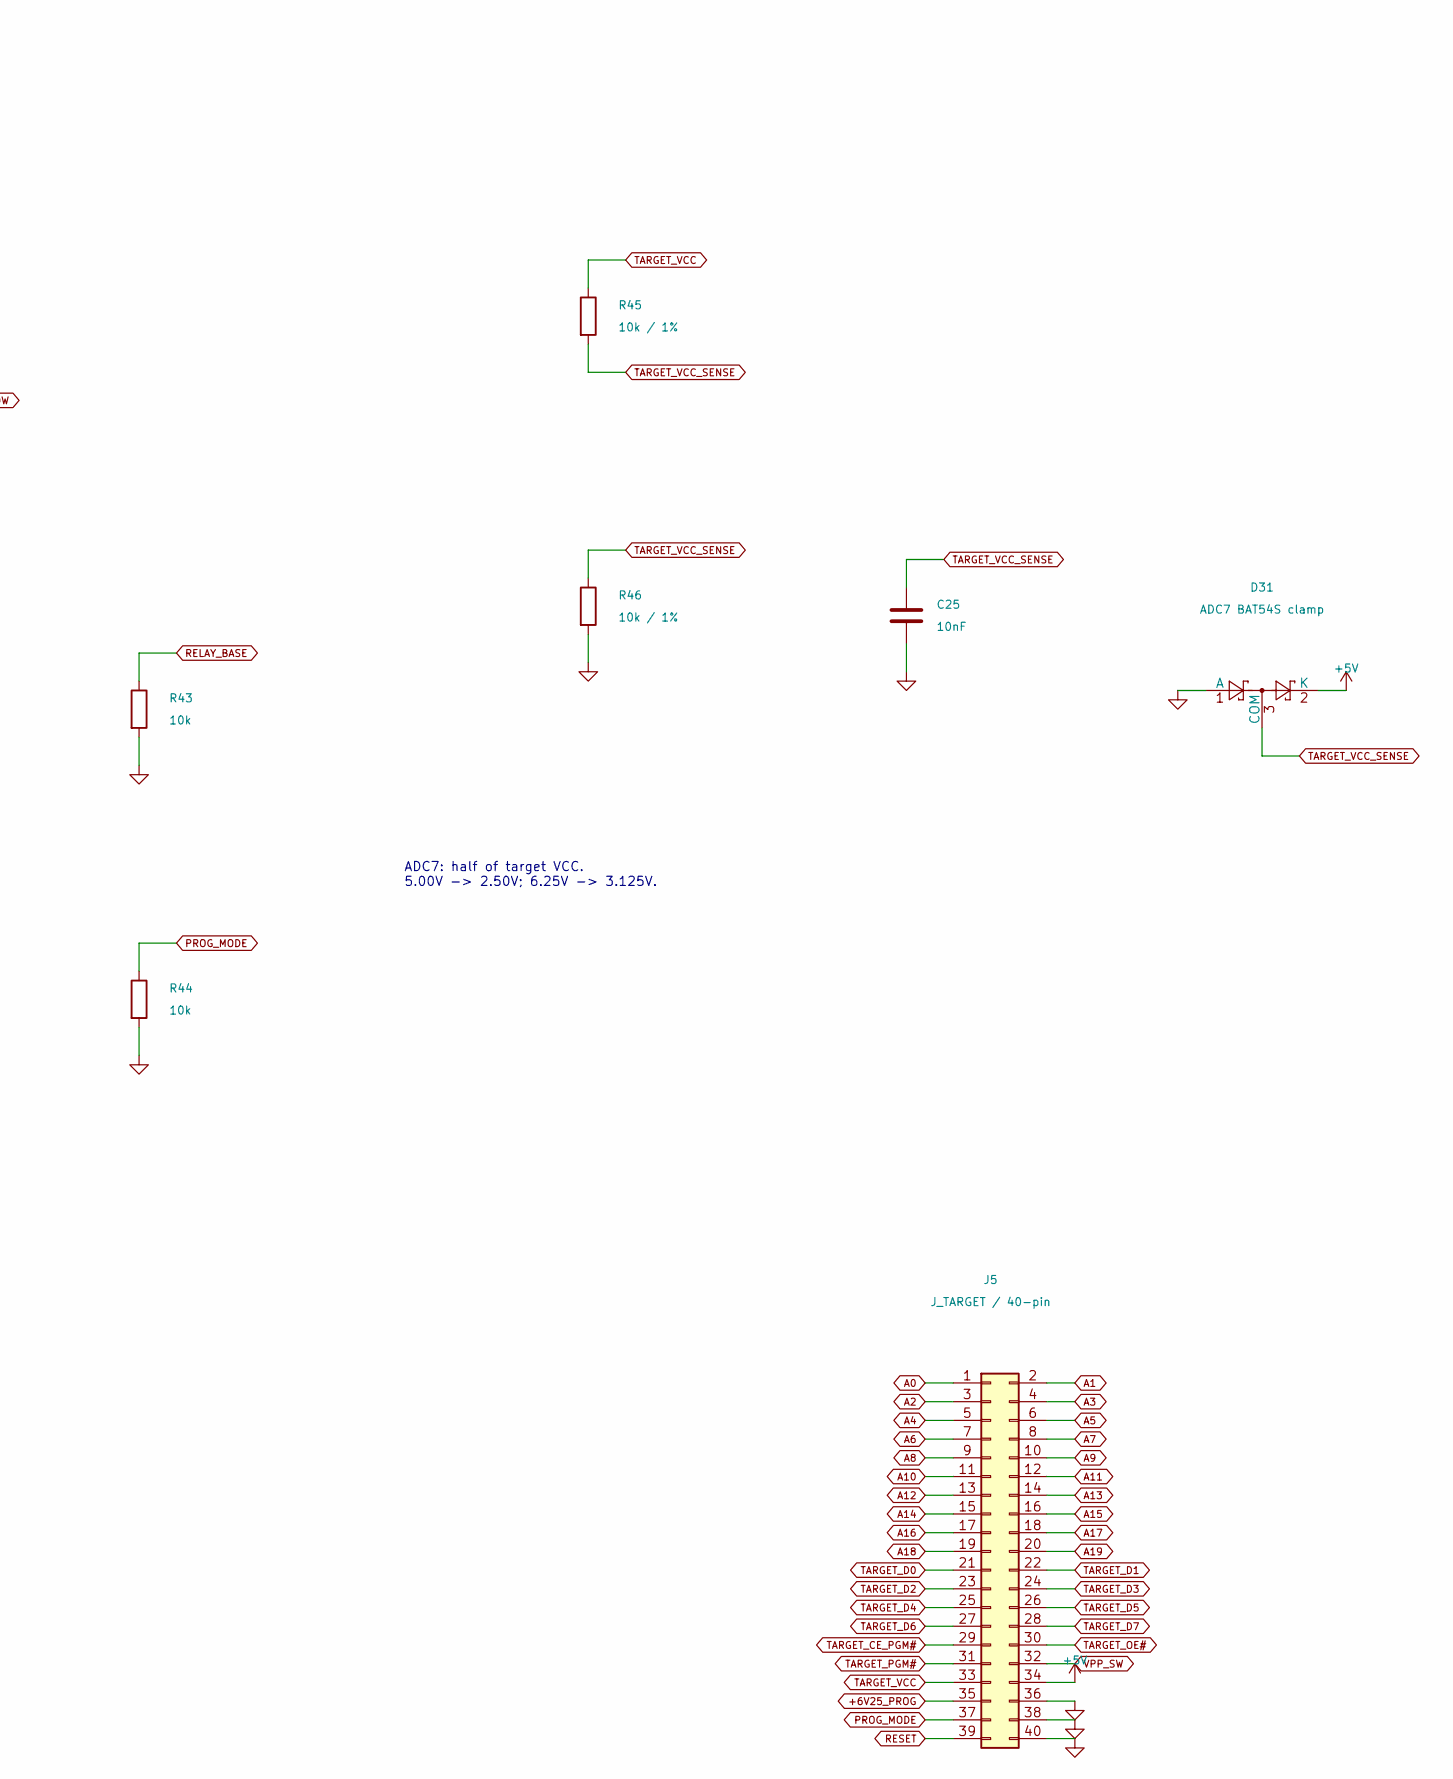
[picture p66: schematic target_interface.kicad_sch, NM27C512 Dumper - Stage 2 Rev A, part in row 1, column 2]

Parts:
C25: 10nF; C_0603_1608Metric
D8: 1N4148WS flyback; D_SOD-323
D31: ADC7 BAT54S clamp; SOT-23
J5: J_TARGET / 40-pin; PinHeader_2x20_P2.54mm_Vertical
K1: G5V-2-DC5 (100mA coil); Relay_DPDT_Omron_G5V-2
Q5: MMBT3904; SOT-23
R42: 470R relay drive; R_0603_1608Metric
R43, R44: 10k; R_0603_1608Metric
R45, R46: 10k / 1%; R_0603_1608Metric

Connections:
+5V: D8.1 (K), D31.2 (K), J5.34, K1.1, K1.6; also elsewhere on the board
+6V25_PROG: J5.35, K1.8; also elsewhere on the board
A0: J5.1; also elsewhere on the board
A1: J5.2; also elsewhere on the board
A2: J5.3; also elsewhere on the board
A3: J5.4; also elsewhere on the board
A4: J5.5; also elsewhere on the board
A5: J5.6; also elsewhere on the board
A6: J5.7; also elsewhere on the board
A7: J5.8; also elsewhere on the board
A8: J5.9; also elsewhere on the board
A9: J5.10; also elsewhere on the board
A10: J5.11; also elsewhere on the board
A11: J5.12; also elsewhere on the board
A12: J5.13; also elsewhere on the board
A13: J5.14; also elsewhere on the board
A14: J5.15; also elsewhere on the board
A15: J5.16; also elsewhere on the board
A16: J5.17; also elsewhere on the board
A17: J5.18; also elsewhere on the board
A18: J5.19; also elsewhere on the board
A19: J5.20; also elsewhere on the board
GND: C25.2, D31.1 (A), J5.36, J5.38, J5.40, Q5.2 (E), R43.2, R44.2, R46.2; also elsewhere on the board
PROG_MODE: J5.37, R42.1, R44.1; also elsewhere on the board
RELAY_BASE: Q5.1 (B), R42.2, R43.1
RELAY_COIL_LOW: D8.2 (A), K1.16, Q5.3 (C)
RESET: J5.39; also elsewhere on the board
SOCKET_OE_VPP: K1.13; also elsewhere on the board
TARGET_CE_PGM#: J5.29; also elsewhere on the board
TARGET_D0: J5.21; also elsewhere on the board
TARGET_D1: J5.22; also elsewhere on the board
TARGET_D2: J5.23; also elsewhere on the board
TARGET_D3: J5.24; also elsewhere on the board
TARGET_D4: J5.25; also elsewhere on the board
TARGET_D5: J5.26; also elsewhere on the board
TARGET_D6: J5.27; also elsewhere on the board
TARGET_D7: J5.28; also elsewhere on the board
TARGET_OE#: J5.30, K1.11; also elsewhere on the board
TARGET_PGM#: J5.31; also elsewhere on the board
TARGET_VCC: J5.33, K1.4, R45.1; also elsewhere on the board
TARGET_VCC_SENSE: C25.1, D31.3 (COM), R45.2, R46.1; also elsewhere on the board
VPP_SW: J5.32, K1.9; also elsewhere on the board

Notes on the sheet:
Coil 1/16. Pole A: COM4, NC6, NO8. Pole B: COM13, NC11, NO9. De-energized: target VCC = +5V, socket OE/VPP = MCU OE#. Energized: target VCC = +6.25V, socket OE/VPP = VPP_SW. 470R base resistor supplies ~9mA: the standard G5V-2 coil draws 100mA. The suggested 10k base drive would not guarantee satur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
K1 DPDT / break-before-make / default READ position
Default-read relay / target connector / monitoring
J_TARGET: odd pins on left; even pins on right. 1-20 A0-A19; 21-28 D0-D7 (protected target side); 29 CE/PGM#, 30 OE#, 31 PGM#, 32 VPP_SW; 33 TARGET_VCC, 34 +5V, 35 +6.25V, 36 GND; 37 PROG_MODE, 38 GND, 39 RESET, 40 GND. NEVER wire VPP_SW to address/data/control GPIO. Adapters requiring VPP=VCC in R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
ADC7: half of target VCC. 5.00V -> 2.50V; 6.25V -> 3.125V.

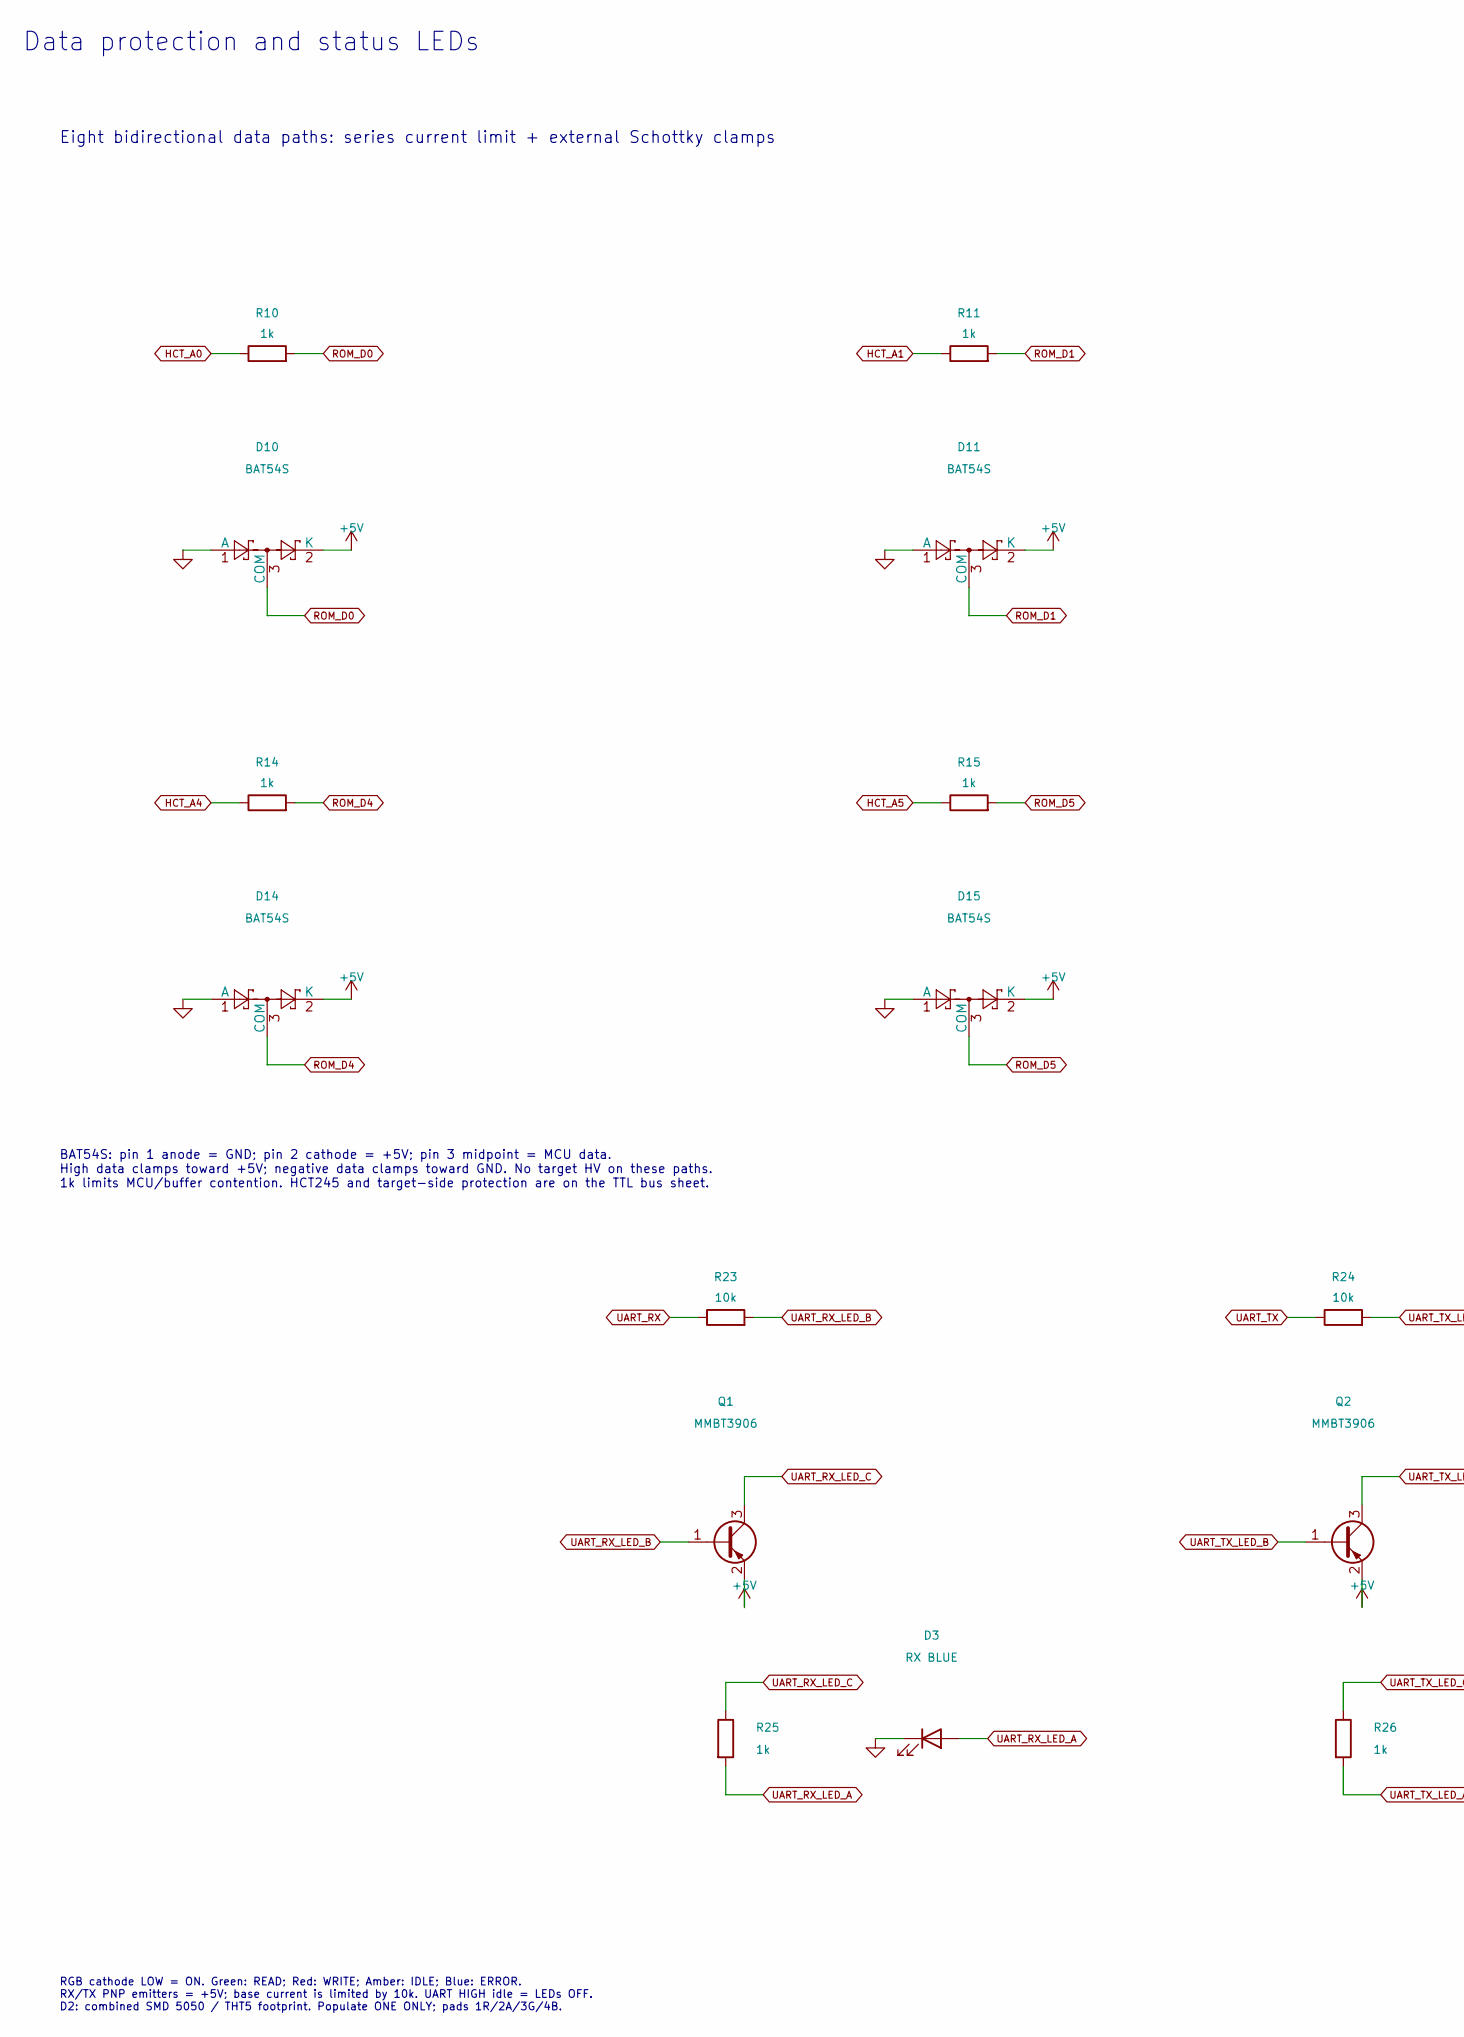
[picture p67: schematic data_status.kicad_sch, NM27C512 Dumper - Stage 2 Rev A, part in row 1, column 1]

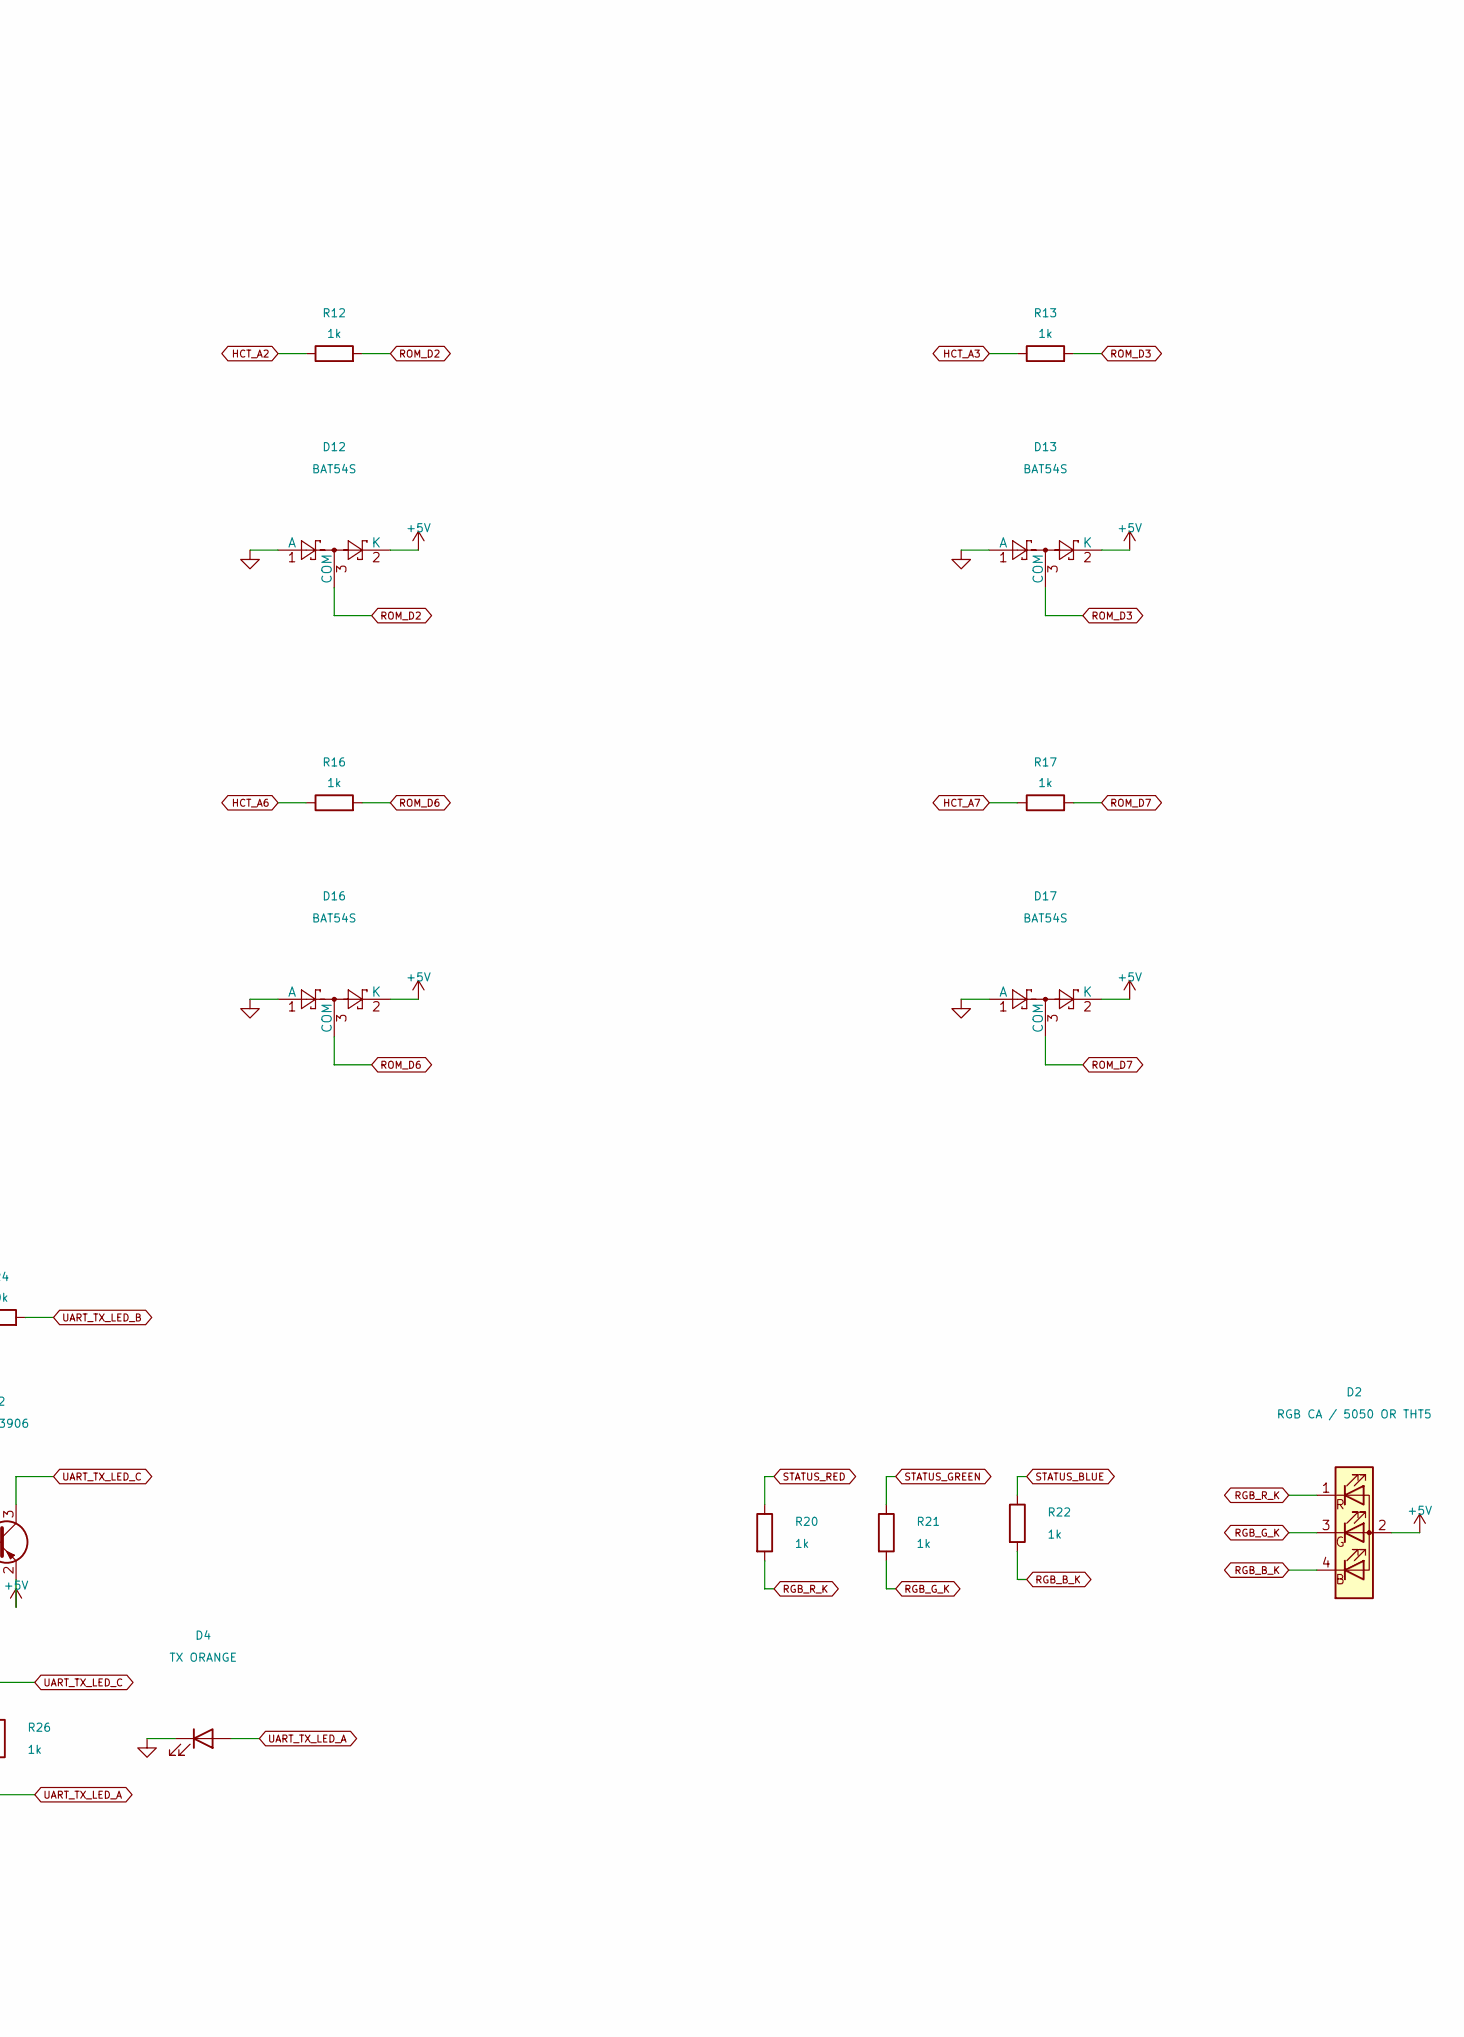
[picture p68: schematic data_status.kicad_sch, NM27C512 Dumper - Stage 2 Rev A, part in row 1, column 2]

Parts:
D2: RGB CA / 5050 OR THT5; RGB_CA_5050_or_THT5
D3: RX BLUE; LED_0603_1608Metric
D4: TX ORANGE; LED_0603_1608Metric
D10, D11, D12, D13, D14, D15, D16, D17: BAT54S; SOT-23
Q1, Q2: MMBT3906; SOT-23
R10, R11, R12, R13, R14, R15, R16, R17, R20, R21, R22, R25, R26: 1k; R_0603_1608Metric
R23, R24: 10k; R_0603_1608Metric

Connections:
+5V: D2.2 (A), D10.2 (K), D11.2 (K), D12.2 (K), D13.2 (K), D14.2 (K), D15.2 (K), D16.2 (K), D17.2 (K), Q1.2 (E), Q2.2 (E); also elsewhere on the board
GND: D3.1 (K), D4.1 (K), D10.1 (A), D11.1 (A), D12.1 (A), D13.1 (A), D14.1 (A), D15.1 (A), D16.1 (A), D17.1 (A); also elsewhere on the board
HCT_A0: R10.1; also elsewhere on the board
HCT_A1: R11.1; also elsewhere on the board
HCT_A2: R12.1; also elsewhere on the board
HCT_A3: R13.1; also elsewhere on the board
HCT_A4: R14.1; also elsewhere on the board
HCT_A5: R15.1; also elsewhere on the board
HCT_A6: R16.1; also elsewhere on the board
HCT_A7: R17.1; also elsewhere on the board
RGB_B_K: D2.4 (B), R22.2
RGB_G_K: D2.3 (G), R21.2
RGB_R_K: D2.1 (R), R20.2
ROM_D0: D10.3 (COM), R10.2; also elsewhere on the board
ROM_D1: D11.3 (COM), R11.2; also elsewhere on the board
ROM_D2: D12.3 (COM), R12.2; also elsewhere on the board
ROM_D3: D13.3 (COM), R13.2; also elsewhere on the board
ROM_D4: D14.3 (COM), R14.2; also elsewhere on the board
ROM_D5: D15.3 (COM), R15.2; also elsewhere on the board
ROM_D6: D16.3 (COM), R16.2; also elsewhere on the board
ROM_D7: D17.3 (COM), R17.2; also elsewhere on the board
STATUS_BLUE: R22.1; also elsewhere on the board
STATUS_GREEN: R21.1; also elsewhere on the board
STATUS_RED: R20.1; also elsewhere on the board
UART_RX: R23.1; also elsewhere on the board
UART_RX_LED_A: D3.2 (A), R25.2
UART_RX_LED_B: Q1.1 (B), R23.2
UART_RX_LED_C: Q1.3 (C), R25.1
UART_TX: R24.1; also elsewhere on the board
UART_TX_LED_A: D4.2 (A), R26.2
UART_TX_LED_B: Q2.1 (B), R24.2
UART_TX_LED_C: Q2.3 (C), R26.1

Notes on the sheet:
BAT54S: pin 1 anode = GND; pin 2 cathode = +5V; pin 3 midpoint = MCU data. High data clamps toward +5V; negative data clamps toward GND. No target HV on these paths. 1k limits MCU/buffer contention. HCT245 and target-side protection are on the TTL bus sheet.
Data protection and status LEDs
RGB cathode LOW = ON. Green: READ; Red: WRITE; Amber: IDLE; Blue: ERROR. RX/TX PNP emitters = +5V; base current is limited by 10k. UART HIGH idle = LEDs OFF. D2: combined SMD 5050 / THT5 footprint. Populate ONE ONLY; pads 1R/2A/3G/4B.
Eight bidirectional data paths: series current limit + external Schottky clamps

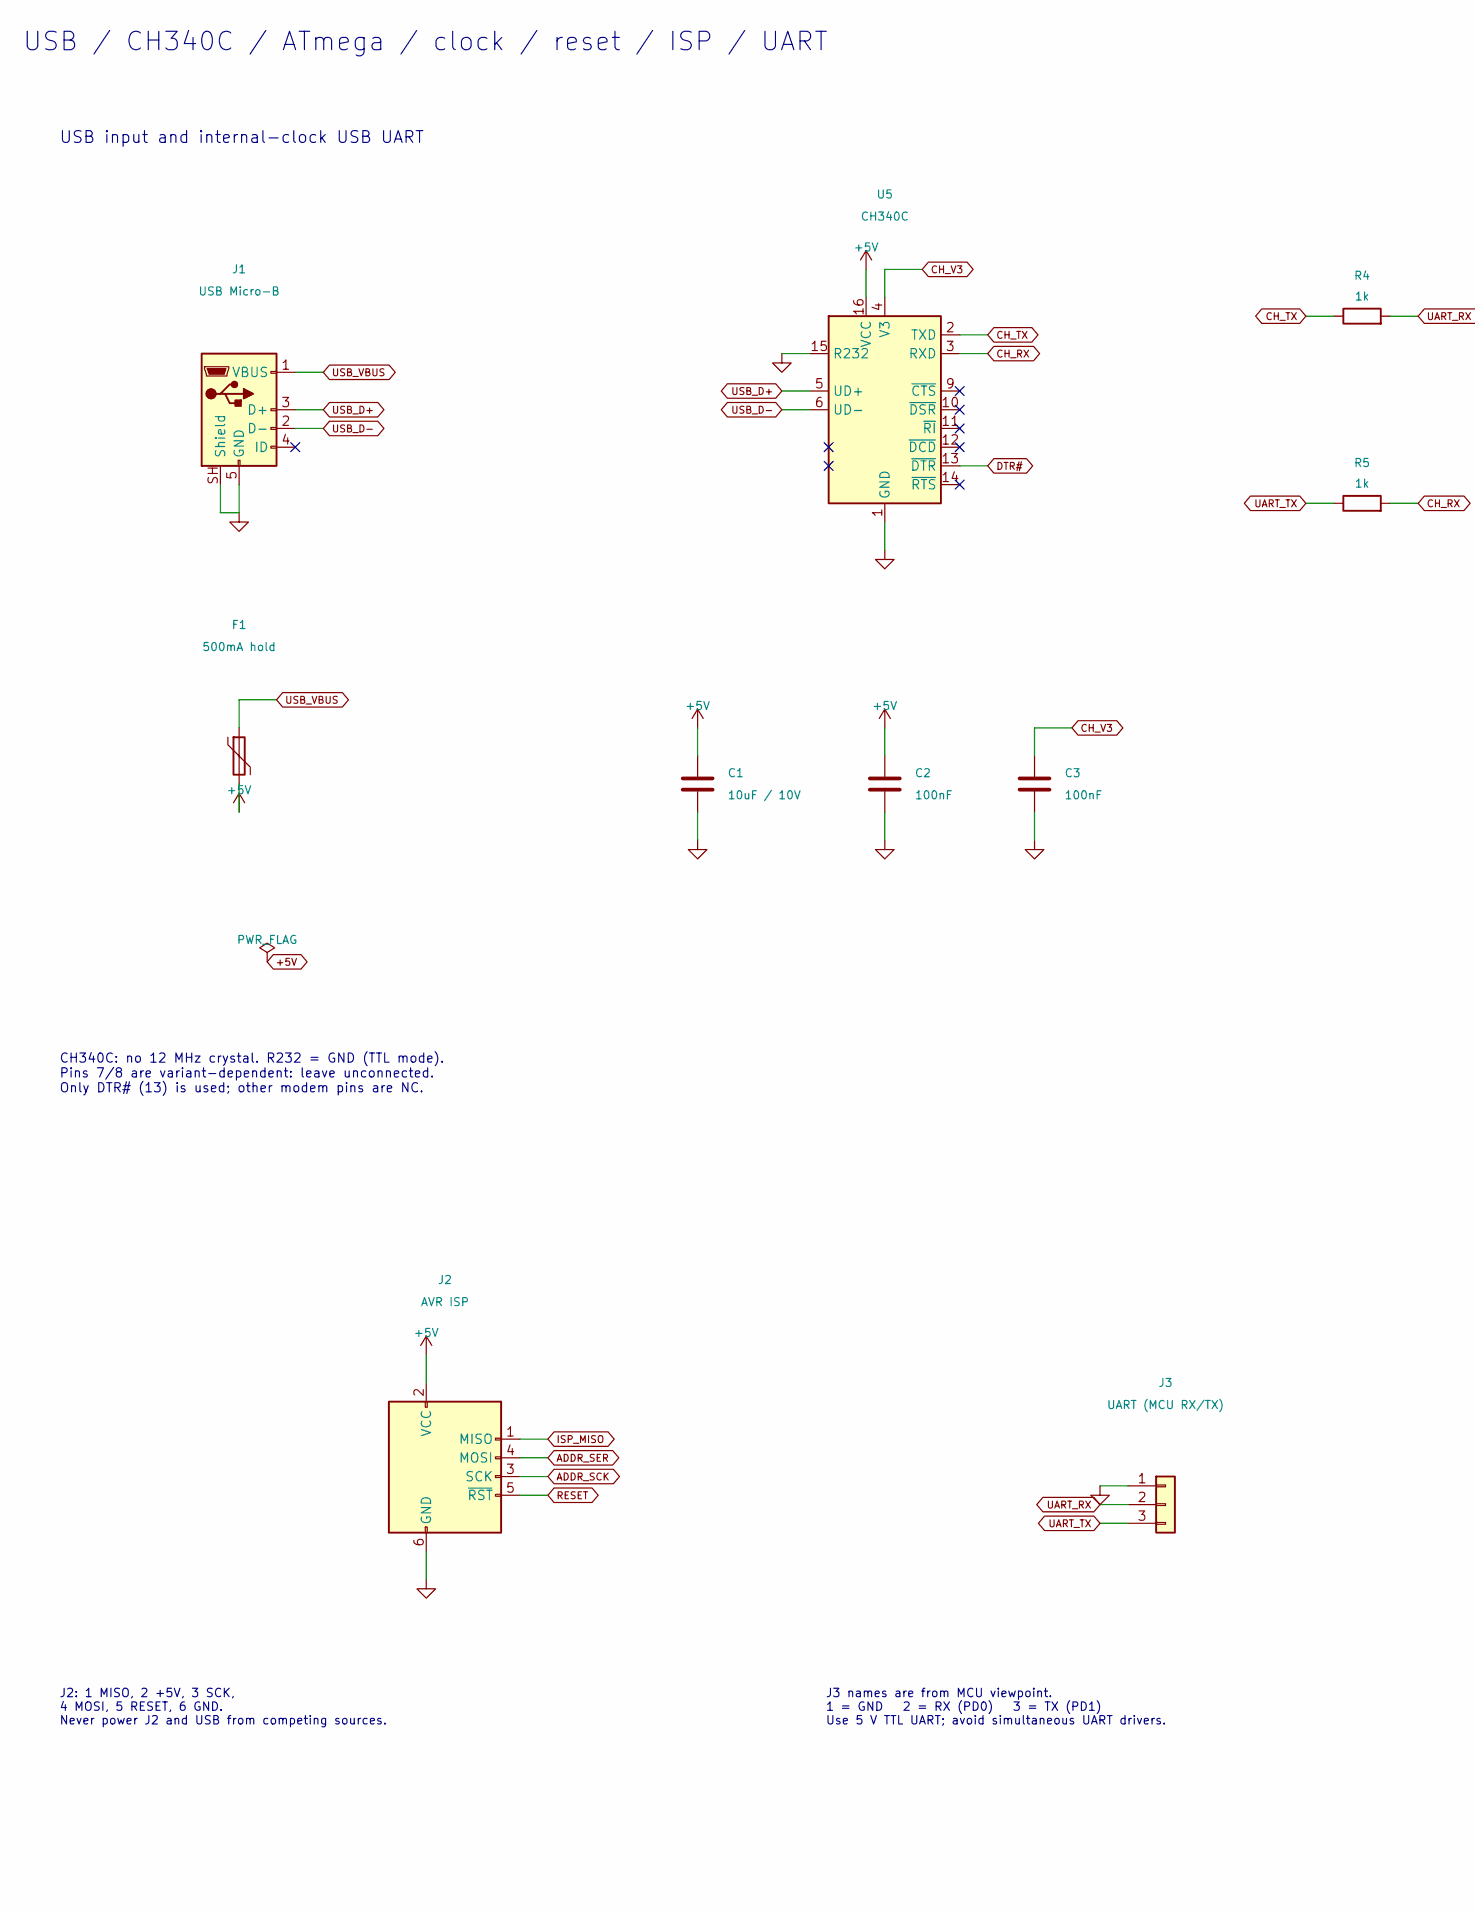
[picture p69: schematic controller.kicad_sch, NM27C512 Dumper - Stage 2 Rev A, part in row 1, column 1]

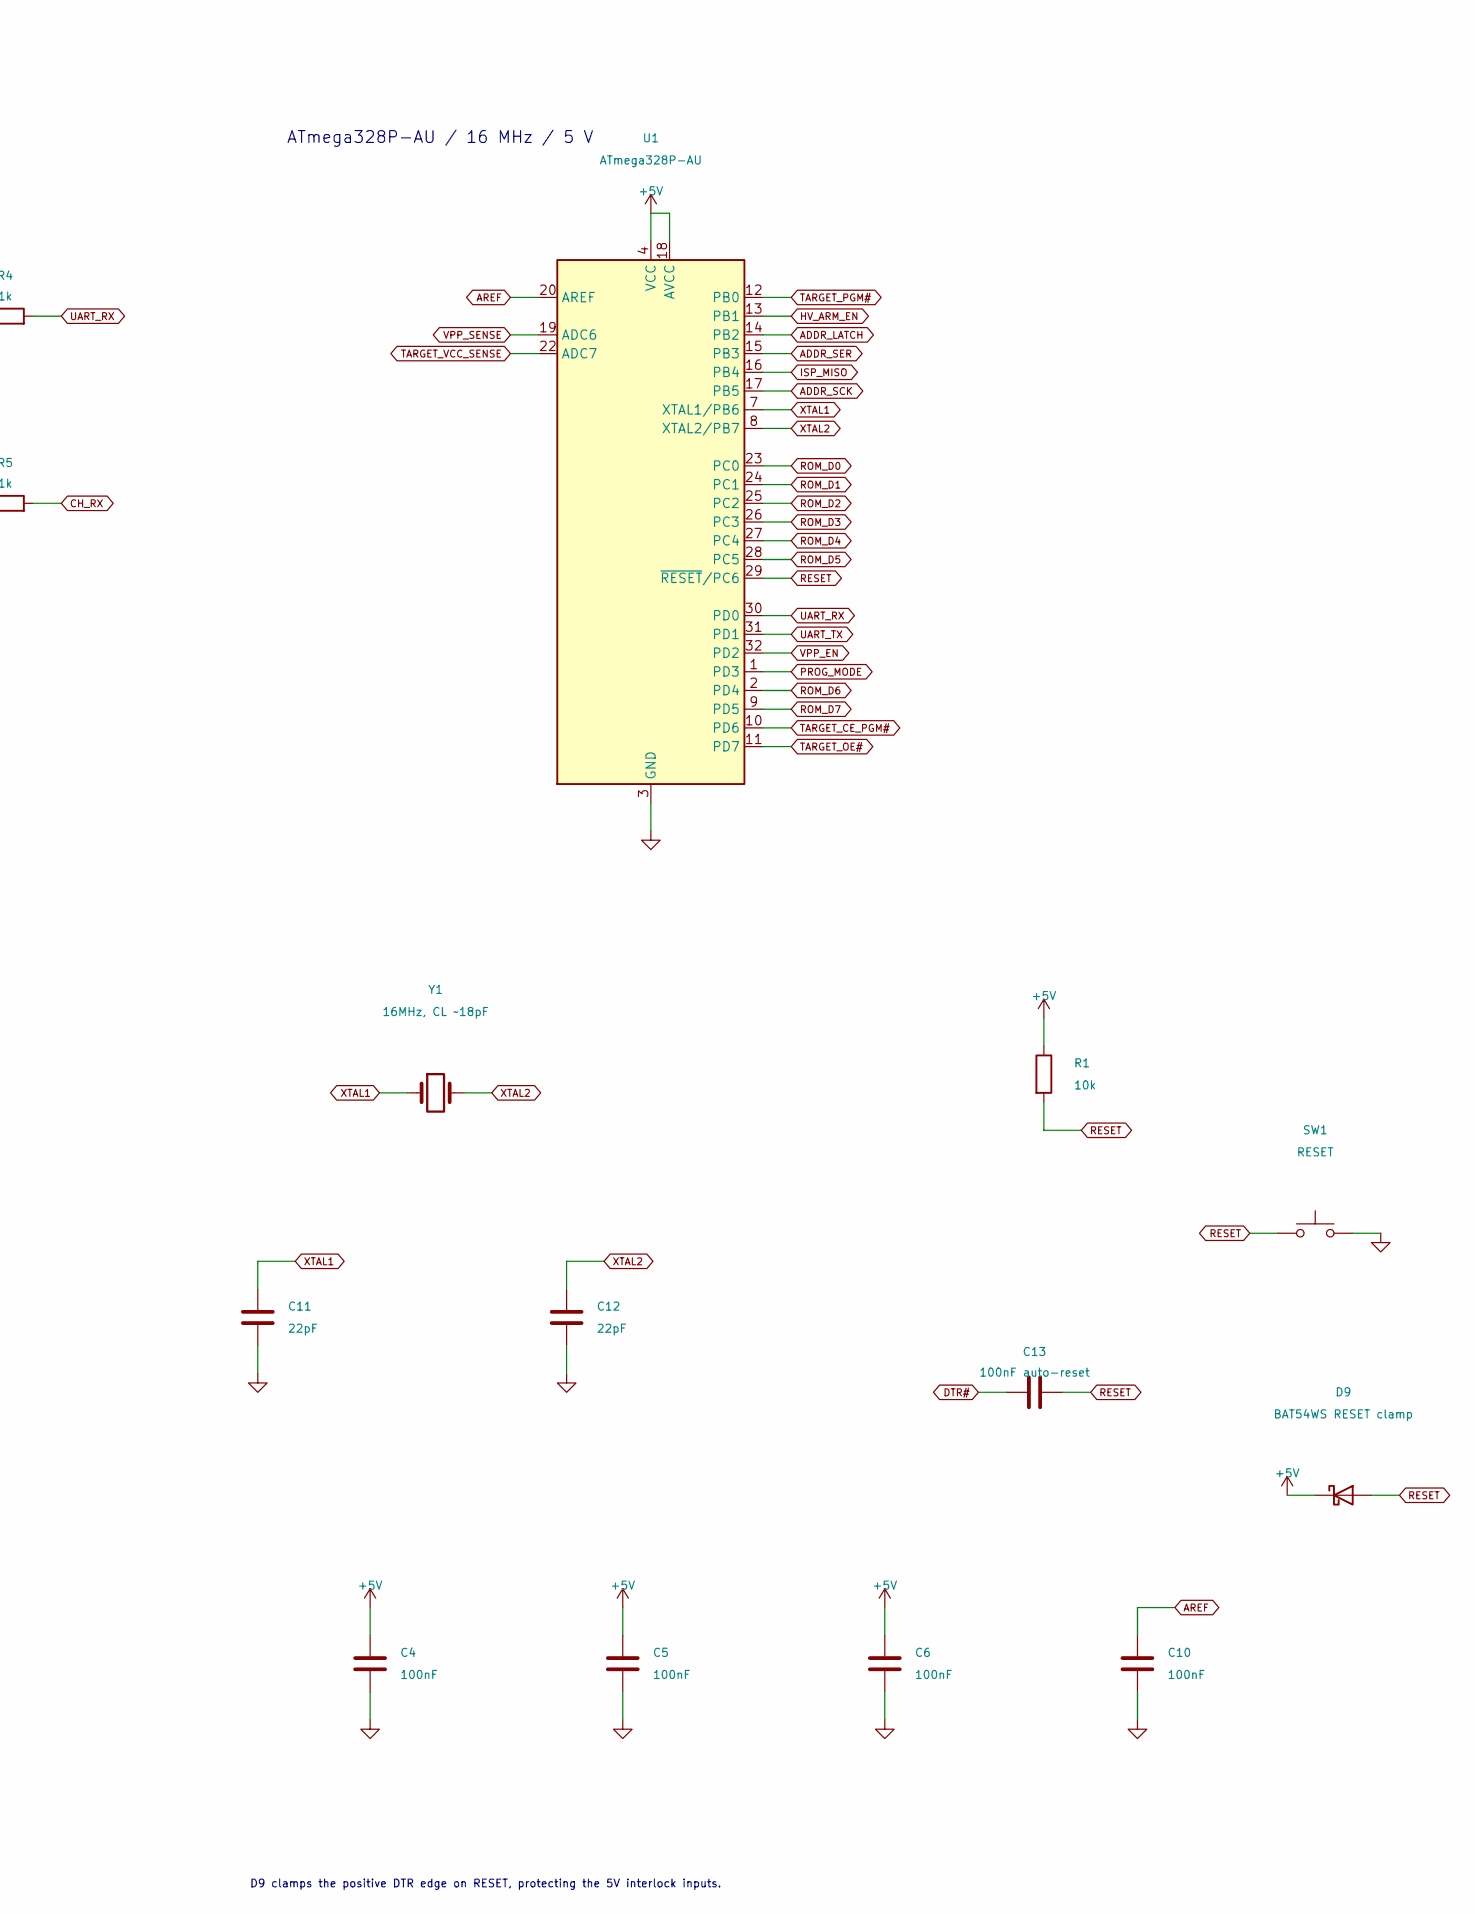
[picture p70: schematic controller.kicad_sch, NM27C512 Dumper - Stage 2 Rev A, part in row 1, column 2]

Parts:
C1: 10uF / 10V; C_0805_2012Metric
C2, C3, C4, C5, C6, C10: 100nF; C_0603_1608Metric
C11, C12: 22pF; C_0603_1608Metric
C13: 100nF auto-reset; C_0603_1608Metric
D9: BAT54WS RESET clamp; D_SOD-323
F1: 500mA hold; Fuse_1812_4532Metric
J1: USB Micro-B; USB_Micro-B_Molex-105017-0001
J2: AVR ISP; PinHeader_2x03_P2.54mm_Vertical
J3: UART (MCU RX/TX); PinHeader_1x03_P2.54mm_Vertical
R1: 10k; R_0603_1608Metric
R4, R5: 1k; R_0603_1608Metric
SW1: RESET; SW_PUSH_6mm
U1: ATmega328P-AU; TQFP-32_7x7mm_P0.8mm
U5: CH340C; SOIC-16_3.9x9.9mm_P1.27mm
Y1: 16MHz, CL ~18pF; Crystal_HC49-4H_Vertical

Connections:
+5V: C1.1, C2.1, C4.1, C5.1, C6.1, D9.1 (K), F1.2, J2.2 (VCC), R1.1, U1.4 (VCC), U1.6 (VCC), U1.18 (AVCC), U5.16 (VCC); also elsewhere on the board
ADDR_LATCH: U1.14 (PB2); also elsewhere on the board
ADDR_SCK: J2.3 (SCK), U1.17 (PB5); also elsewhere on the board
ADDR_SER: J2.4 (MOSI), U1.15 (PB3); also elsewhere on the board
AREF: C10.1, U1.20 (AREF)
CH_RX: R5.2, U5.3 (RXD)
CH_TX: R4.1, U5.2 (TXD)
CH_V3: C3.1, U5.4 (V3)
DTR#: C13.1, U5.13 (~DTR)
GND: C1.2, C2.2, C3.2, C4.2, C5.2, C6.2, C10.2, C11.2, C12.2, J1.5 (GND), J1.SH (Shield), J2.6 (GND), J3.1, SW1.2, U1.3 (GND), U1.5 (GND), U1.21 (GND), U5.1 (GND), U5.15 (R232); also elsewhere on the board
HV_ARM_EN: U1.13 (PB1); also elsewhere on the board
ISP_MISO: J2.1 (MISO), U1.16 (PB4)
PROG_MODE: U1.1 (PD3); also elsewhere on the board
RESET: C13.2, D9.2 (A), J2.5 (~RST), R1.2, SW1.1, U1.29 (~RESET/PC6); also elsewhere on the board
ROM_D0: U1.23 (PC0); also elsewhere on the board
ROM_D1: U1.24 (PC1); also elsewhere on the board
ROM_D2: U1.25 (PC2); also elsewhere on the board
ROM_D3: U1.26 (PC3); also elsewhere on the board
ROM_D4: U1.27 (PC4); also elsewhere on the board
ROM_D5: U1.28 (PC5); also elsewhere on the board
ROM_D6: U1.2 (PD4); also elsewhere on the board
ROM_D7: U1.9 (PD5); also elsewhere on the board
TARGET_CE_PGM#: U1.10 (PD6); also elsewhere on the board
TARGET_OE#: U1.11 (PD7); also elsewhere on the board
TARGET_PGM#: U1.12 (PB0); also elsewhere on the board
TARGET_VCC_SENSE: U1.22 (ADC7); also elsewhere on the board
UART_RX: J3.2, R4.2, U1.30 (PD0); also elsewhere on the board
UART_TX: J3.3, R5.1, U1.31 (PD1); also elsewhere on the board
USB_D+: J1.3 (D+), U5.5 (UD+)
USB_D-: J1.2 (D-), U5.6 (UD-)
USB_VBUS: F1.1, J1.1 (VBUS)
VPP_EN: U1.32 (PD2); also elsewhere on the board
VPP_SENSE: U1.19 (ADC6); also elsewhere on the board
XTAL1: C11.1, U1.7 (XTAL1/PB6), Y1.1
XTAL2: C12.1, U1.8 (XTAL2/PB7), Y1.2

Notes on the sheet:
J3 names are from MCU viewpoint. 1 = GND 2 = RX (PD0) 3 = TX (PD1) Use 5 V TTL UART; avoid simultaneous UART drivers.
J2: 1 MISO, 2 +5V, 3 SCK, 4 MOSI, 5 RESET, 6 GND. Never power J2 and USB from competing sources.
USB / CH340C / ATmega / clock / reset / ISP / UART
CH340C: no 12 MHz crystal. R232 = GND (TTL mode). Pins 7/8 are variant-dependent: leave unconnected. Only DTR# (13) is used; other modem pins are NC.
D9 clamps the positive DTR edge on RESET, protecting the 5V interlock inputs.
ATmega328P-AU / 16 MHz / 5 V
USB input and internal-clock USB UART
