IlyaBOT/LunarView3/NM27C512_Dumper.kicad_pcb

## KiCad design NM27C512_Dumper.kicad_pcb (continued)

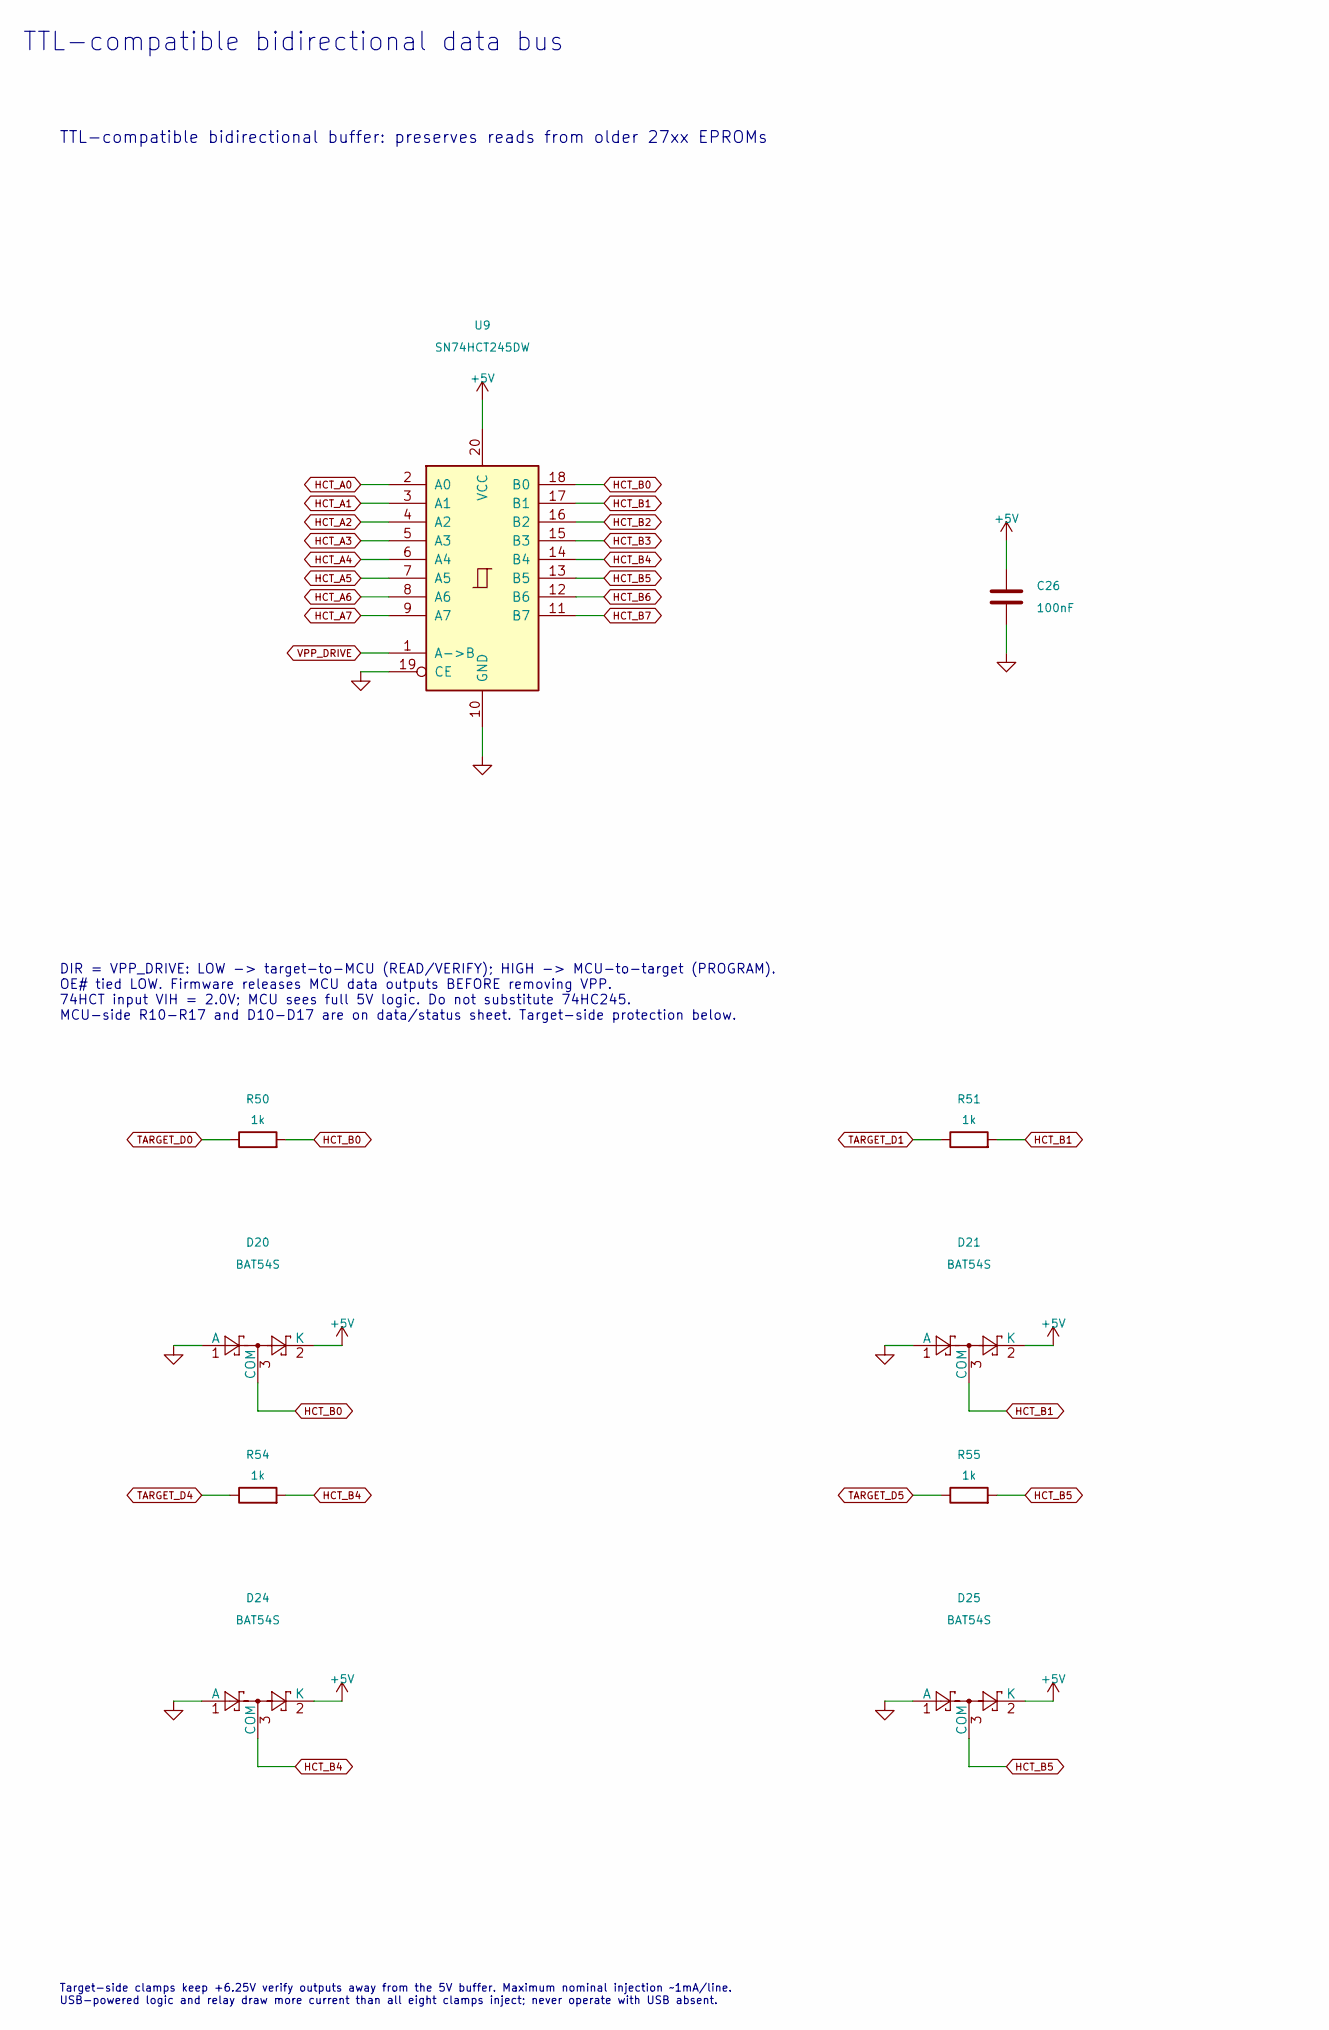
[picture p71: schematic ttl_bus.kicad_sch, NM27C512 Dumper - Stage 2 Rev A, part in row 1, column 1]

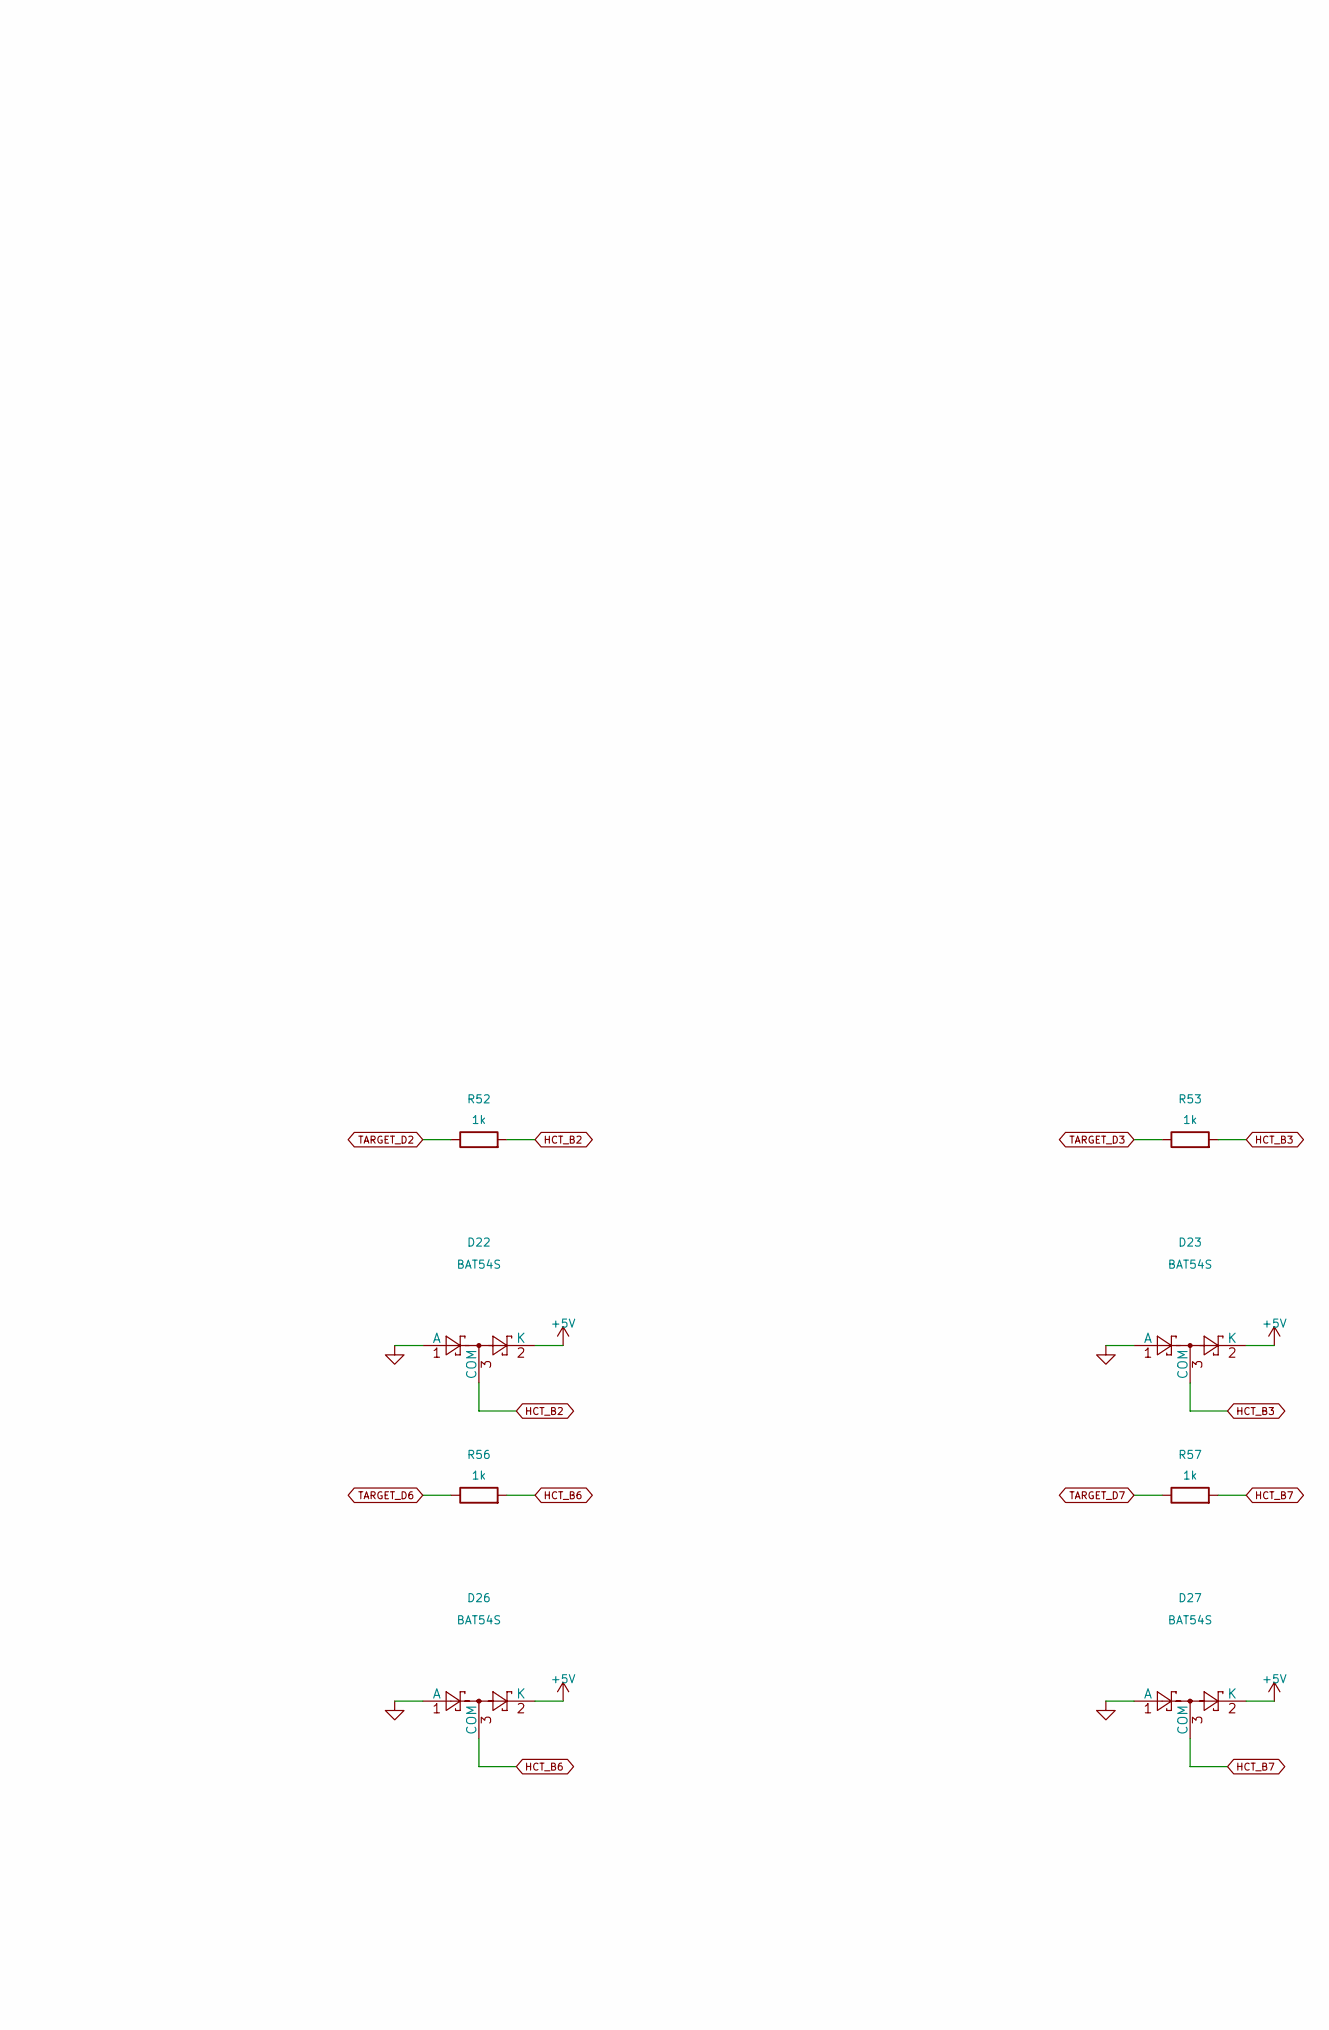
[picture p72: schematic ttl_bus.kicad_sch, NM27C512 Dumper - Stage 2 Rev A, part in row 1, column 2]

Parts:
C26: 100nF; C_0603_1608Metric
D20, D21, D22, D23, D24, D25, D26, D27: BAT54S; SOT-23
R50, R51, R52, R53, R54, R55, R56, R57: 1k; R_0603_1608Metric
U9: SN74HCT245DW; SOIC-20W_7.5x12.8mm_P1.27mm

Connections:
+5V: C26.1, D20.2 (K), D21.2 (K), D22.2 (K), D23.2 (K), D24.2 (K), D25.2 (K), D26.2 (K), D27.2 (K), U9.20 (VCC); also elsewhere on the board
GND: C26.2, D20.1 (A), D21.1 (A), D22.1 (A), D23.1 (A), D24.1 (A), D25.1 (A), D26.1 (A), D27.1 (A), U9.10 (GND), U9.19 (CE); also elsewhere on the board
HCT_A0: U9.2 (A0); also elsewhere on the board
HCT_A1: U9.3 (A1); also elsewhere on the board
HCT_A2: U9.4 (A2); also elsewhere on the board
HCT_A3: U9.5 (A3); also elsewhere on the board
HCT_A4: U9.6 (A4); also elsewhere on the board
HCT_A5: U9.7 (A5); also elsewhere on the board
HCT_A6: U9.8 (A6); also elsewhere on the board
HCT_A7: U9.9 (A7); also elsewhere on the board
HCT_B0: D20.3 (COM), R50.2, U9.18 (B0)
HCT_B1: D21.3 (COM), R51.2, U9.17 (B1)
HCT_B2: D22.3 (COM), R52.2, U9.16 (B2)
HCT_B3: D23.3 (COM), R53.2, U9.15 (B3)
HCT_B4: D24.3 (COM), R54.2, U9.14 (B4)
HCT_B5: D25.3 (COM), R55.2, U9.13 (B5)
HCT_B6: D26.3 (COM), R56.2, U9.12 (B6)
HCT_B7: D27.3 (COM), R57.2, U9.11 (B7)
TARGET_D0: R50.1; also elsewhere on the board
TARGET_D1: R51.1; also elsewhere on the board
TARGET_D2: R52.1; also elsewhere on the board
TARGET_D3: R53.1; also elsewhere on the board
TARGET_D4: R54.1; also elsewhere on the board
TARGET_D5: R55.1; also elsewhere on the board
TARGET_D6: R56.1; also elsewhere on the board
TARGET_D7: R57.1; also elsewhere on the board
VPP_DRIVE: U9.1 (A->B); also elsewhere on the board

Notes on the sheet:
TTL-compatible bidirectional data bus
TTL-compatible bidirectional buffer: preserves reads from older 27xx EPROMs
DIR = VPP_DRIVE: LOW -> target-to-MCU (READ/VERIFY); HIGH -> MCU-to-target (PROGRAM). OE# tied LOW. Firmware releases MCU data outputs BEFORE removing VPP. 74HCT input VIH = 2.0V; MCU sees full 5V logic. Do not substitute 74HC245. MCU-side R10-R17 and D10-D17 are on data/status sheet. Target-side p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
Target-side clamps keep +6.25V verify outputs away from the 5V buffer. Maximum nominal injection ~1mA/line. USB-powered logic and relay draw more current than all eight clamps inject; never operate with USB absent.

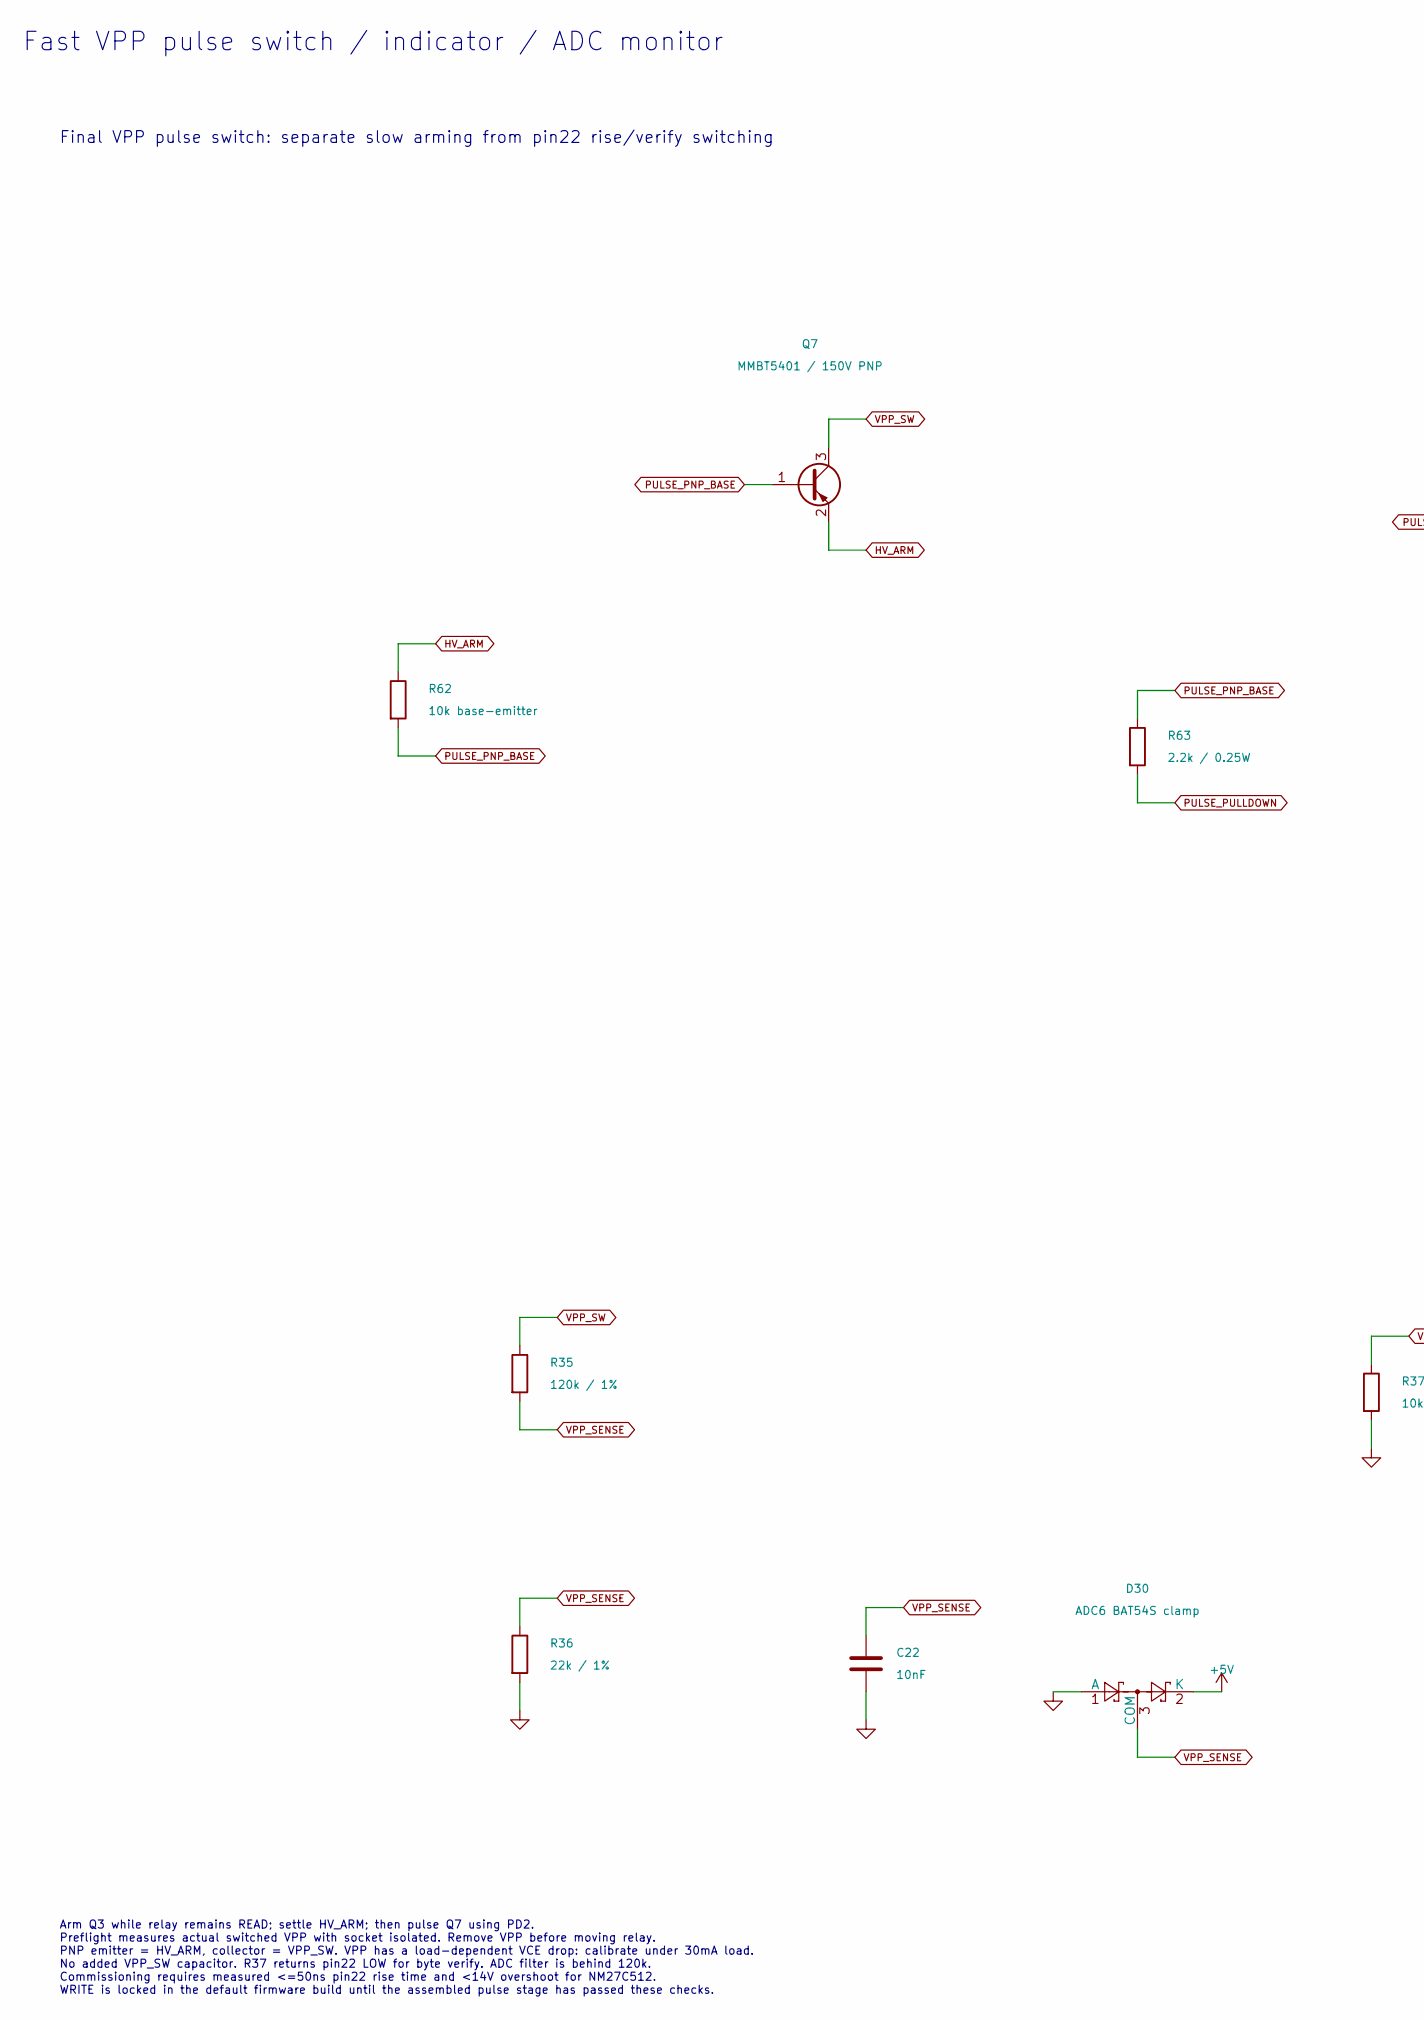
[picture p73: schematic programming_pulse.kicad_sch, NM27C512 Dumper - Stage 2 Rev A, part in row 1, column 1]

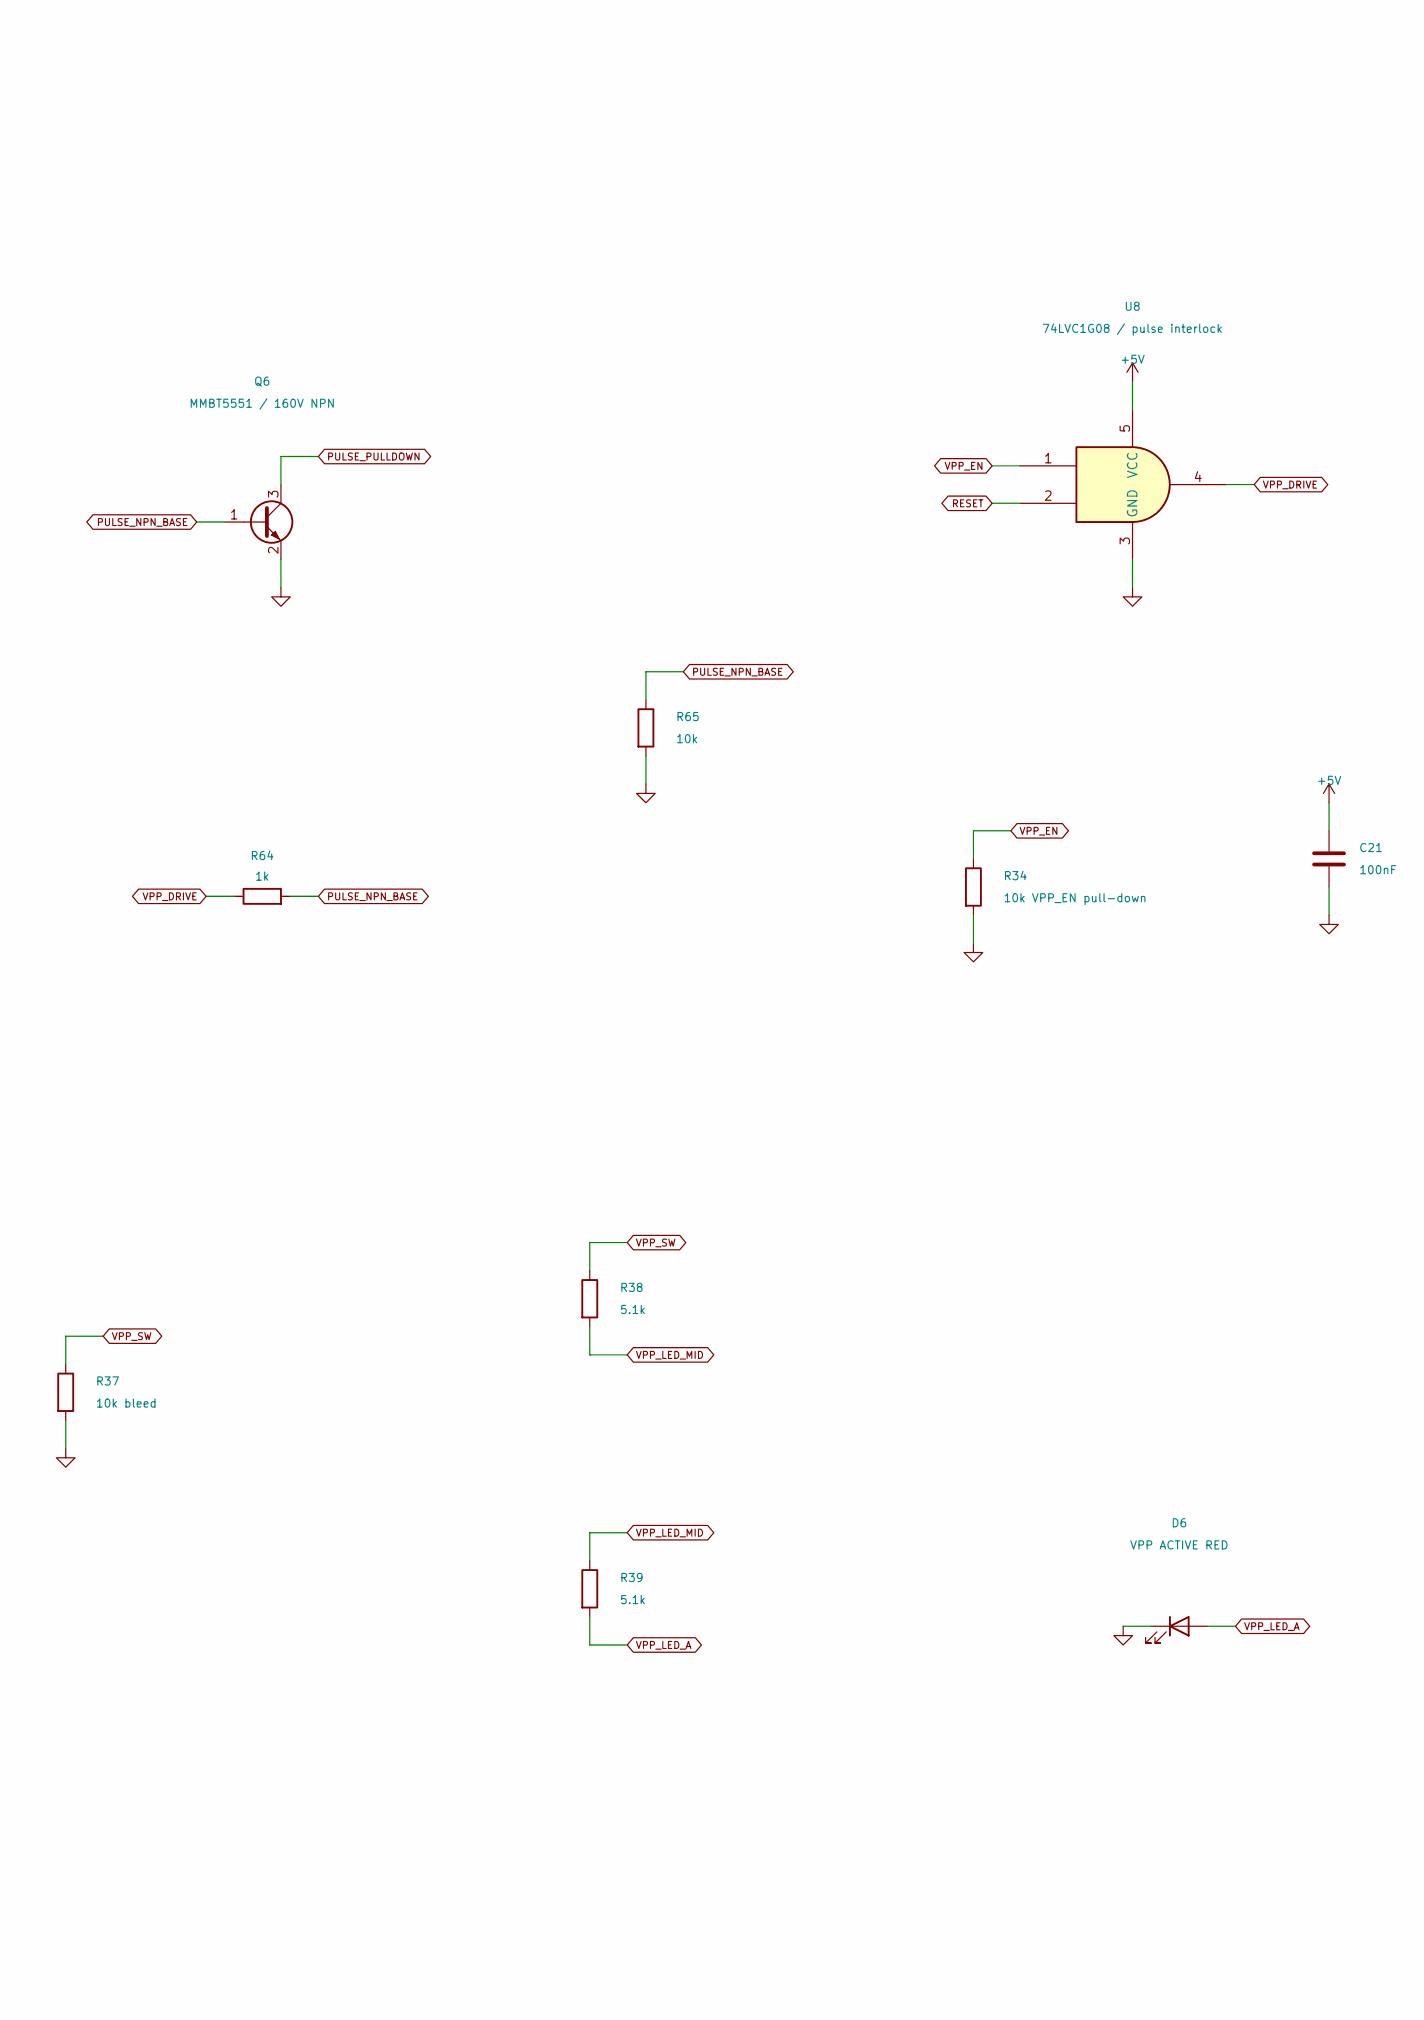
[picture p74: schematic programming_pulse.kicad_sch, NM27C512 Dumper - Stage 2 Rev A, part in row 1, column 2]

Parts:
C21: 100nF; C_0603_1608Metric
C22: 10nF; C_0603_1608Metric
D6: VPP ACTIVE RED; LED_0603_1608Metric
D30: ADC6 BAT54S clamp; SOT-23
Q6: MMBT5551 / 160V NPN; SOT-23
Q7: MMBT5401 / 150V PNP; SOT-23
R34: 10k VPP_EN pull-down; R_0603_1608Metric
R35: 120k / 1%; R_0603_1608Metric
R36: 22k / 1%; R_0603_1608Metric
R37: 10k bleed; R_0603_1608Metric
R38, R39: 5.1k; R_0603_1608Metric
R62: 10k base-emitter; R_0603_1608Metric
R63: 2.2k / 0.25W; R_1206_3216Metric
R64: 1k; R_0603_1608Metric
R65: 10k; R_0603_1608Metric
U8: 74LVC1G08 / pulse interlock; SOT-23-5

Connections:
+5V: C21.1, D30.2 (K), U8.5 (VCC); also elsewhere on the board
GND: C21.2, C22.2, D6.1 (K), D30.1 (A), Q6.2 (E), R34.2, R36.2, R37.2, R65.2, U8.3 (GND); also elsewhere on the board
HV_ARM: Q7.2 (E), R62.1; also elsewhere on the board
PULSE_NPN_BASE: Q6.1 (B), R64.2, R65.1
PULSE_PNP_BASE: Q7.1 (B), R62.2, R63.1
PULSE_PULLDOWN: Q6.3 (C), R63.2
RESET: U8.2; also elsewhere on the board
VPP_DRIVE: R64.1, U8.4; also elsewhere on the board
VPP_EN: R34.1, U8.1; also elsewhere on the board
VPP_LED_A: D6.2 (A), R39.2
VPP_LED_MID: R38.2, R39.1
VPP_SENSE: C22.1, D30.3 (COM), R35.2, R36.1; also elsewhere on the board
VPP_SW: Q7.3 (C), R35.1, R37.1, R38.1; also elsewhere on the board

Notes on the sheet:
Final VPP pulse switch: separate slow arming from pin22 rise/verify switching
Fast VPP pulse switch / indicator / ADC monitor
Arm Q3 while relay remains READ; settle HV_ARM; then pulse Q7 using PD2. Preflight measures actual switched VPP with socket isolated. Remove VPP before moving relay. PNP emitter = HV_ARM, collector = VPP_SW. VPP has a load-dependent VCE drop: calibrate under 30mA load. No added VPP_SW capacitor. R3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

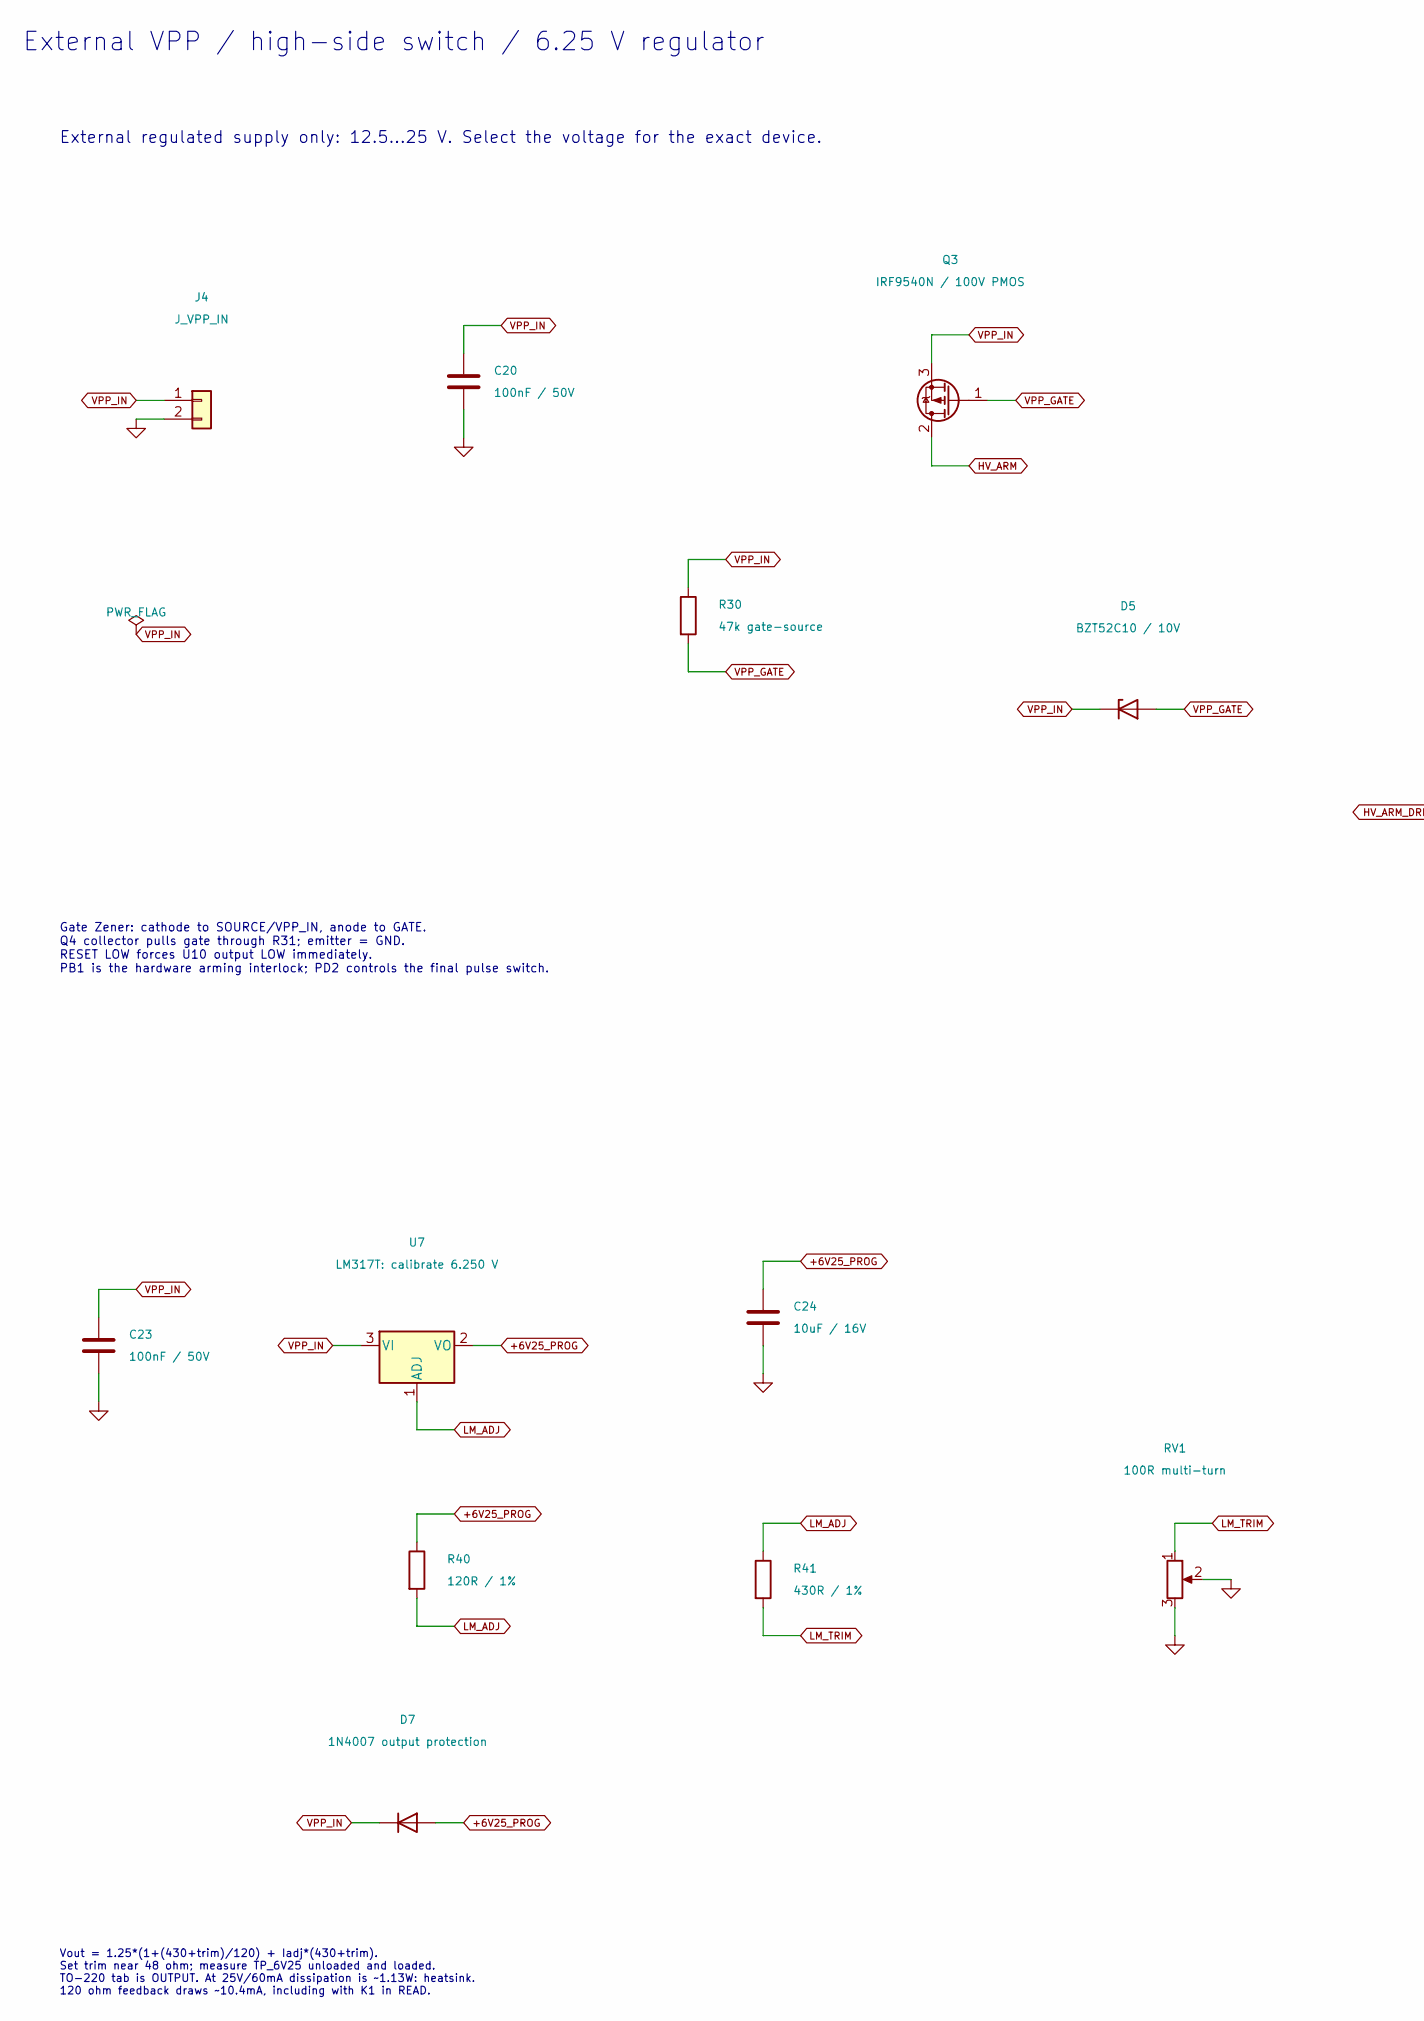
[picture p75: schematic programming_power.kicad_sch, NM27C512 Dumper - Stage 2 Rev A, part in row 1, column 1]

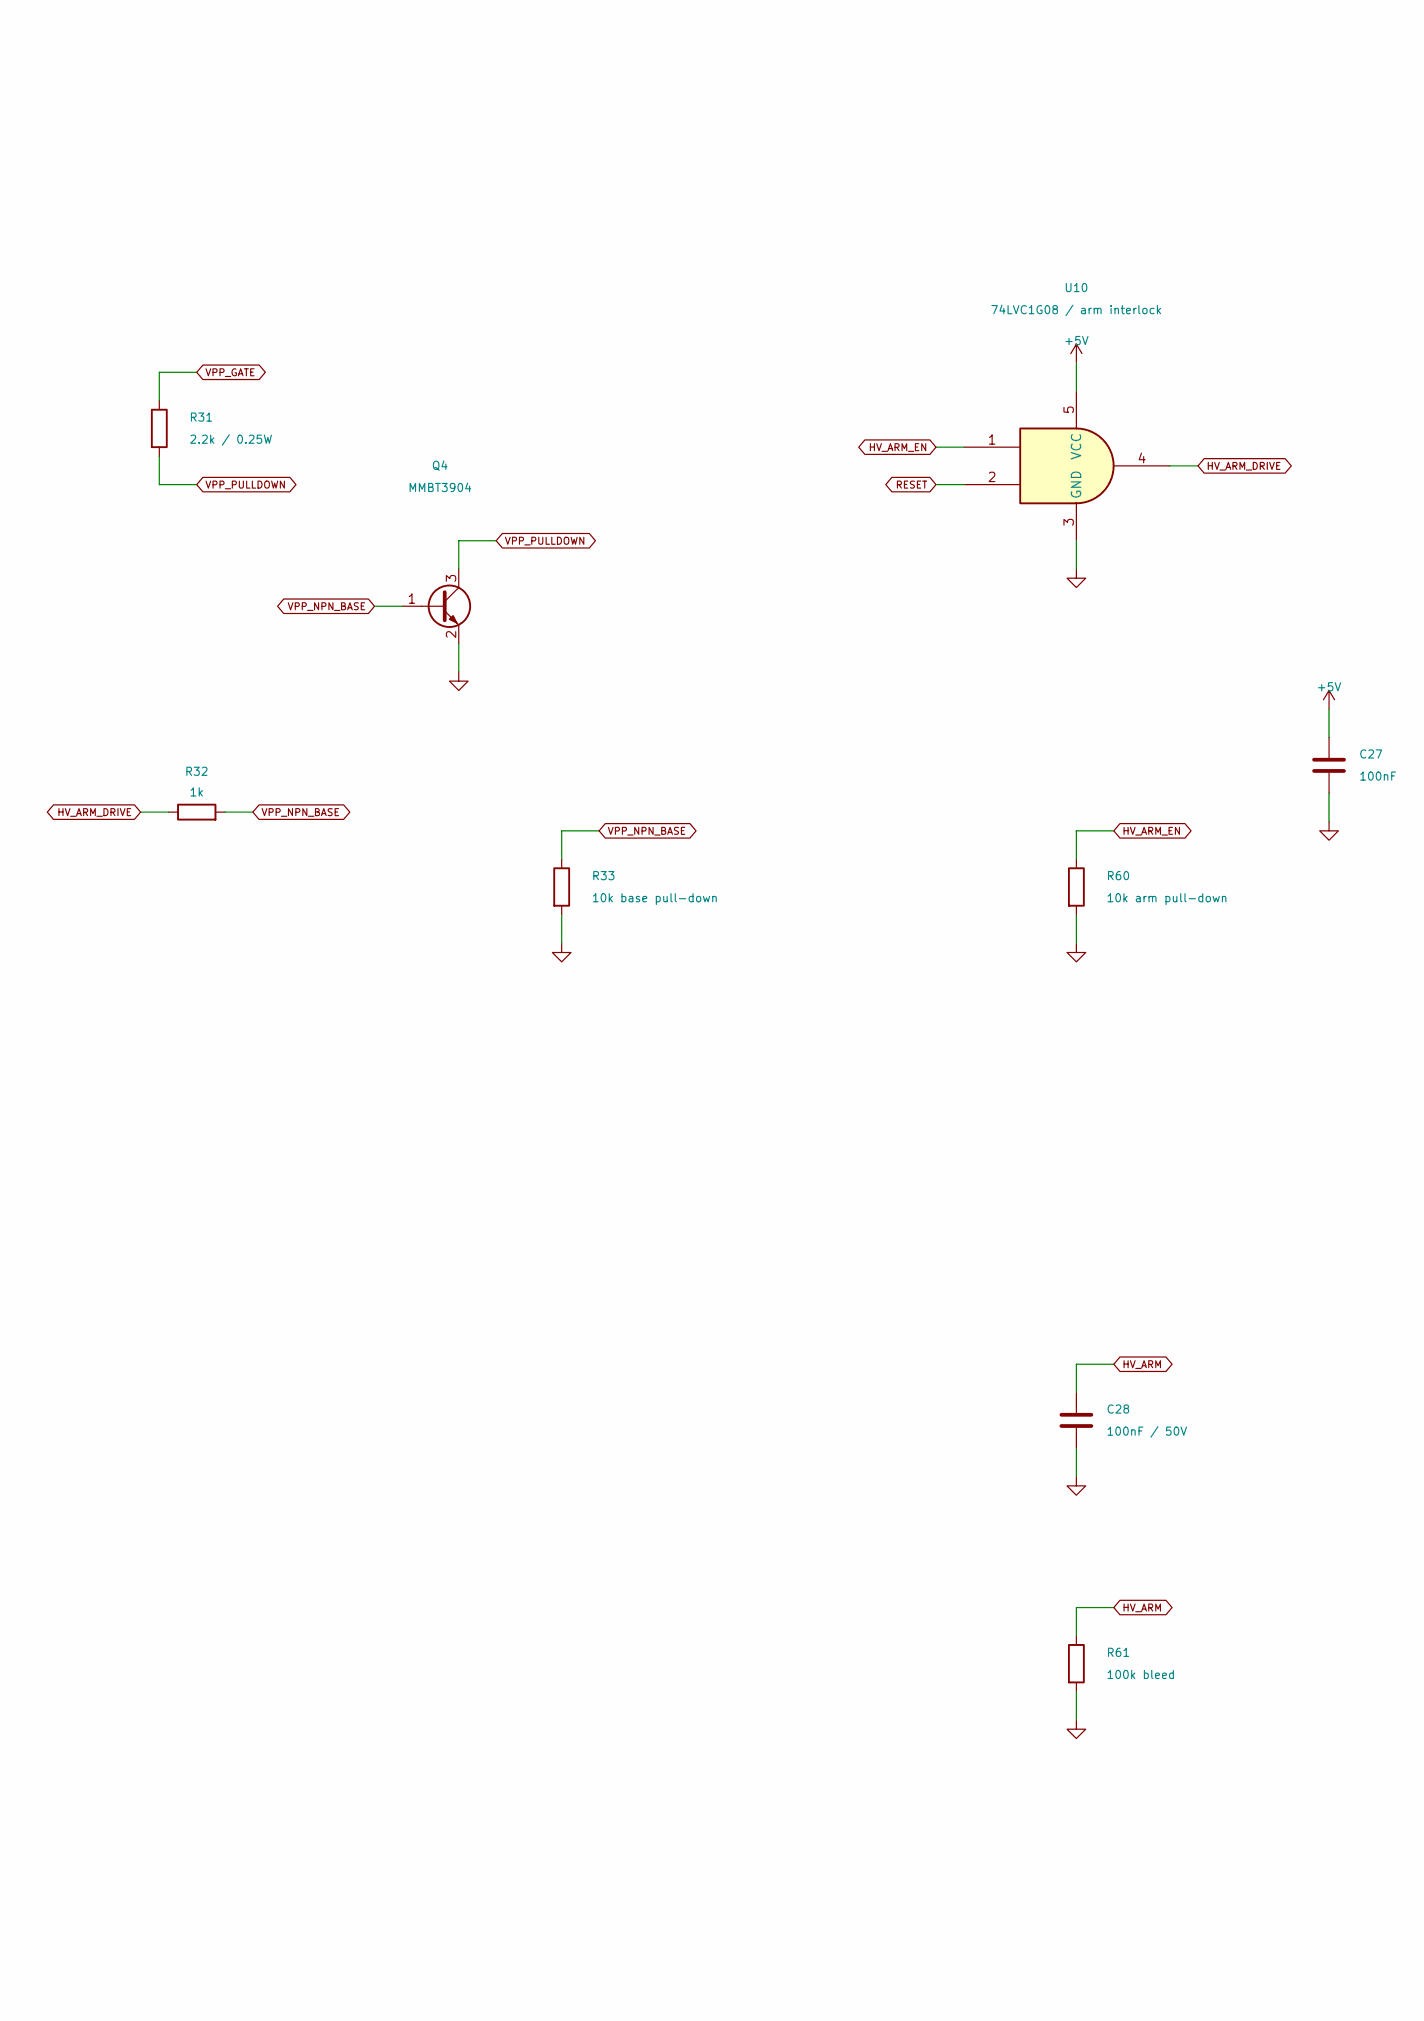
[picture p76: schematic programming_power.kicad_sch, NM27C512 Dumper - Stage 2 Rev A, part in row 1, column 2]

Parts:
C20, C23, C28: 100nF / 50V; C_0603_1608Metric
C24: 10uF / 16V; C_1206_3216Metric
C27: 100nF; C_0603_1608Metric
D5: BZT52C10 / 10V; D_SOD-123
D7: 1N4007 output protection; D_DO-41_SOD81_P10.16mm_Horizontal
J4: J_VPP_IN; TerminalBlock_Phoenix_MKDS-1,5-2_1x02_P5.00mm_Horizontal
Q3: IRF9540N / 100V PMOS; TO-220-3_Vertical
Q4: MMBT3904; SOT-23
R30: 47k gate-source; R_0603_1608Metric
R31: 2.2k / 0.25W; R_1206_3216Metric
R32: 1k; R_0603_1608Metric
R33: 10k base pull-down; R_0603_1608Metric
R40: 120R / 1%; R_0603_1608Metric
R41: 430R / 1%; R_0603_1608Metric
R60: 10k arm pull-down; R_0603_1608Metric
R61: 100k bleed; R_0603_1608Metric
RV1: 100R multi-turn; Potentiometer_Bourns_3296W_Vertical
U7: LM317T: calibrate 6.250 V; TO-220-3_Vertical
U10: 74LVC1G08 / arm interlock; SOT-23-5

Connections:
+5V: C27.1, U10.5 (VCC); also elsewhere on the board
+6V25_PROG: C24.1, D7.2 (A), R40.1, U7.2 (VO); also elsewhere on the board
GND: C20.2, C23.2, C24.2, C27.2, C28.2, J4.2, Q4.2 (E), R33.2, R60.2, R61.2, RV1.2, RV1.3, U10.3 (GND); also elsewhere on the board
HV_ARM: C28.1, Q3.2 (D), R61.1; also elsewhere on the board
HV_ARM_DRIVE: R32.1, U10.4
HV_ARM_EN: R60.1, U10.1; also elsewhere on the board
LM_ADJ: R40.2, R41.1, U7.1 (ADJ)
LM_TRIM: R41.2, RV1.1
RESET: U10.2; also elsewhere on the board
VPP_GATE: D5.2 (A), Q3.1 (G), R30.2, R31.1
VPP_IN: C20.1, C23.1, D5.1 (K), D7.1 (K), J4.1, Q3.3 (S), R30.1, U7.3 (VI); also elsewhere on the board
VPP_NPN_BASE: Q4.1 (B), R32.2, R33.1
VPP_PULLDOWN: Q4.3 (C), R31.2

Notes on the sheet:
Vout = 1.25*(1+(430+trim)/120) + Iadj*(430+trim). Set trim near 48 ohm; measure TP_6V25 unloaded and loaded. TO-220 tab is OUTPUT. At 25V/60mA dissipation is ~1.13W: heatsink. 120 ohm feedback draws ~10.4mA, including with K1 in READ.
External regulated supply only: 12.5...25 V. Select the voltage for the exact device.
External VPP / high-side switch / 6.25 V regulator
Gate Zener: cathode to SOURCE/VPP_IN, anode to GATE. Q4 collector pulls gate through R31; emitter = GND. RESET LOW forces U10 output LOW immediately. PB1 is the hardware arming interlock; PD2 controls the final pulse switch.

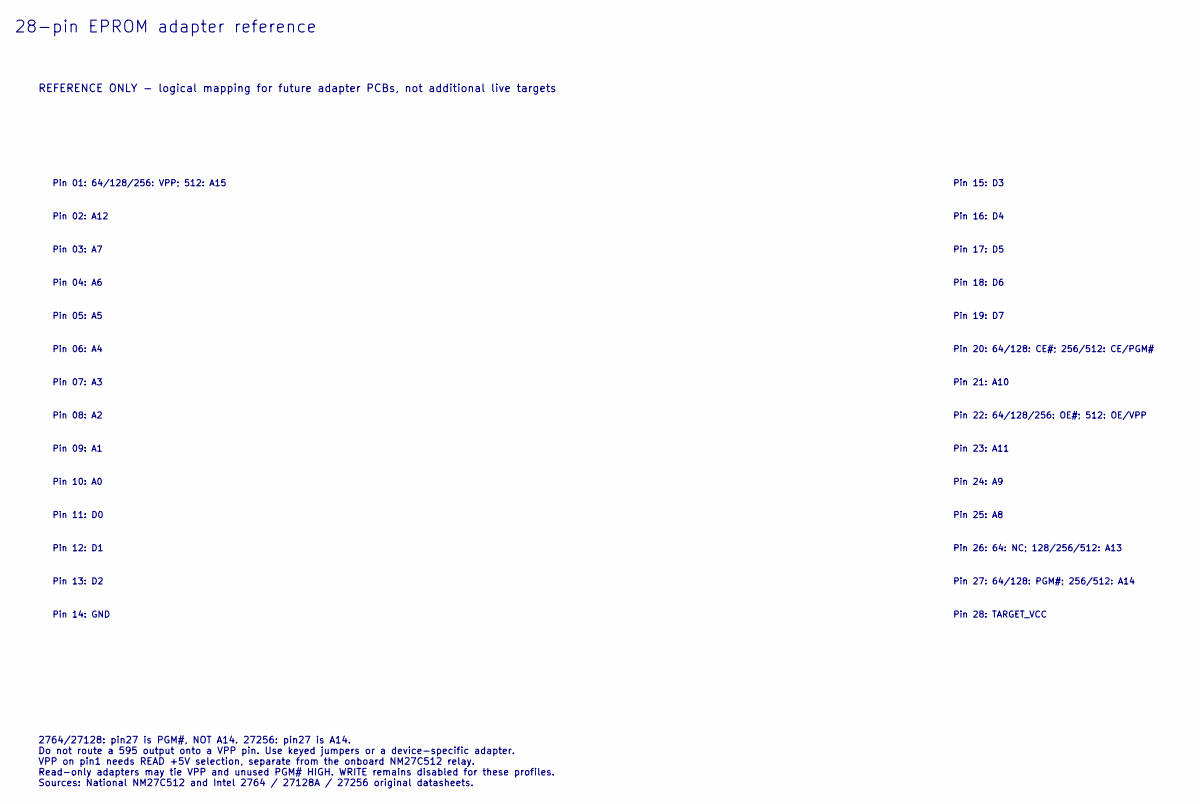
[picture p77: schematic adapter_28pin_27xx.kicad_sch, NM27C512 Dumper - Stage 2 Rev A]

Notes on the sheet:
Pin 01: 64/128/256: VPP; 512: A15
Pin 13: D2
Pin 08: A2
Pin 17: D5
Pin 05: A5
Pin 21: A10
Pin 14: GND
Pin 18: D6
2764/27128: pin27 is PGM#, NOT A14. 27256: pin27 is A14. Do not route a 595 output onto a VPP pin. Use keyed jumpers or a device-specific adapter. VPP on pin1 needs READ +5V selection, separate from the onboard NM27C512 relay. Read-only adapters may tie VPP and unused PGM# HIGH. WRITE remains disab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
Pin 03: A7
28-pin EPROM adapter reference
Pin 15: D3
Pin 27: 64/128: PGM#; 256/512: A14
Pin 16: D4
Pin 07: A3
Pin 04: A6
Pin 24: A9
Pin 02: A12
Pin 20: 64/128: CE#; 256/512: CE/PGM#
Pin 22: 64/128/256: OE#; 512: OE/VPP
REFERENCE ONLY - logical mapping for future adapter PCBs, not additional live targets
Pin 09: A1
Pin 06: A4
Pin 11: D0
Pin 12: D1
Pin 25: A8
Pin 23: A11
Pin 19: D7
Pin 10: A0
Pin 26: 64: NC; 128/256/512: A13
Pin 28: TARGET_VCC
