IlyaBOT/LunarView3/NM27C512_Dumper.kicad_pcb

## KiCad design NM27C512_Dumper.kicad_pcb (continued)

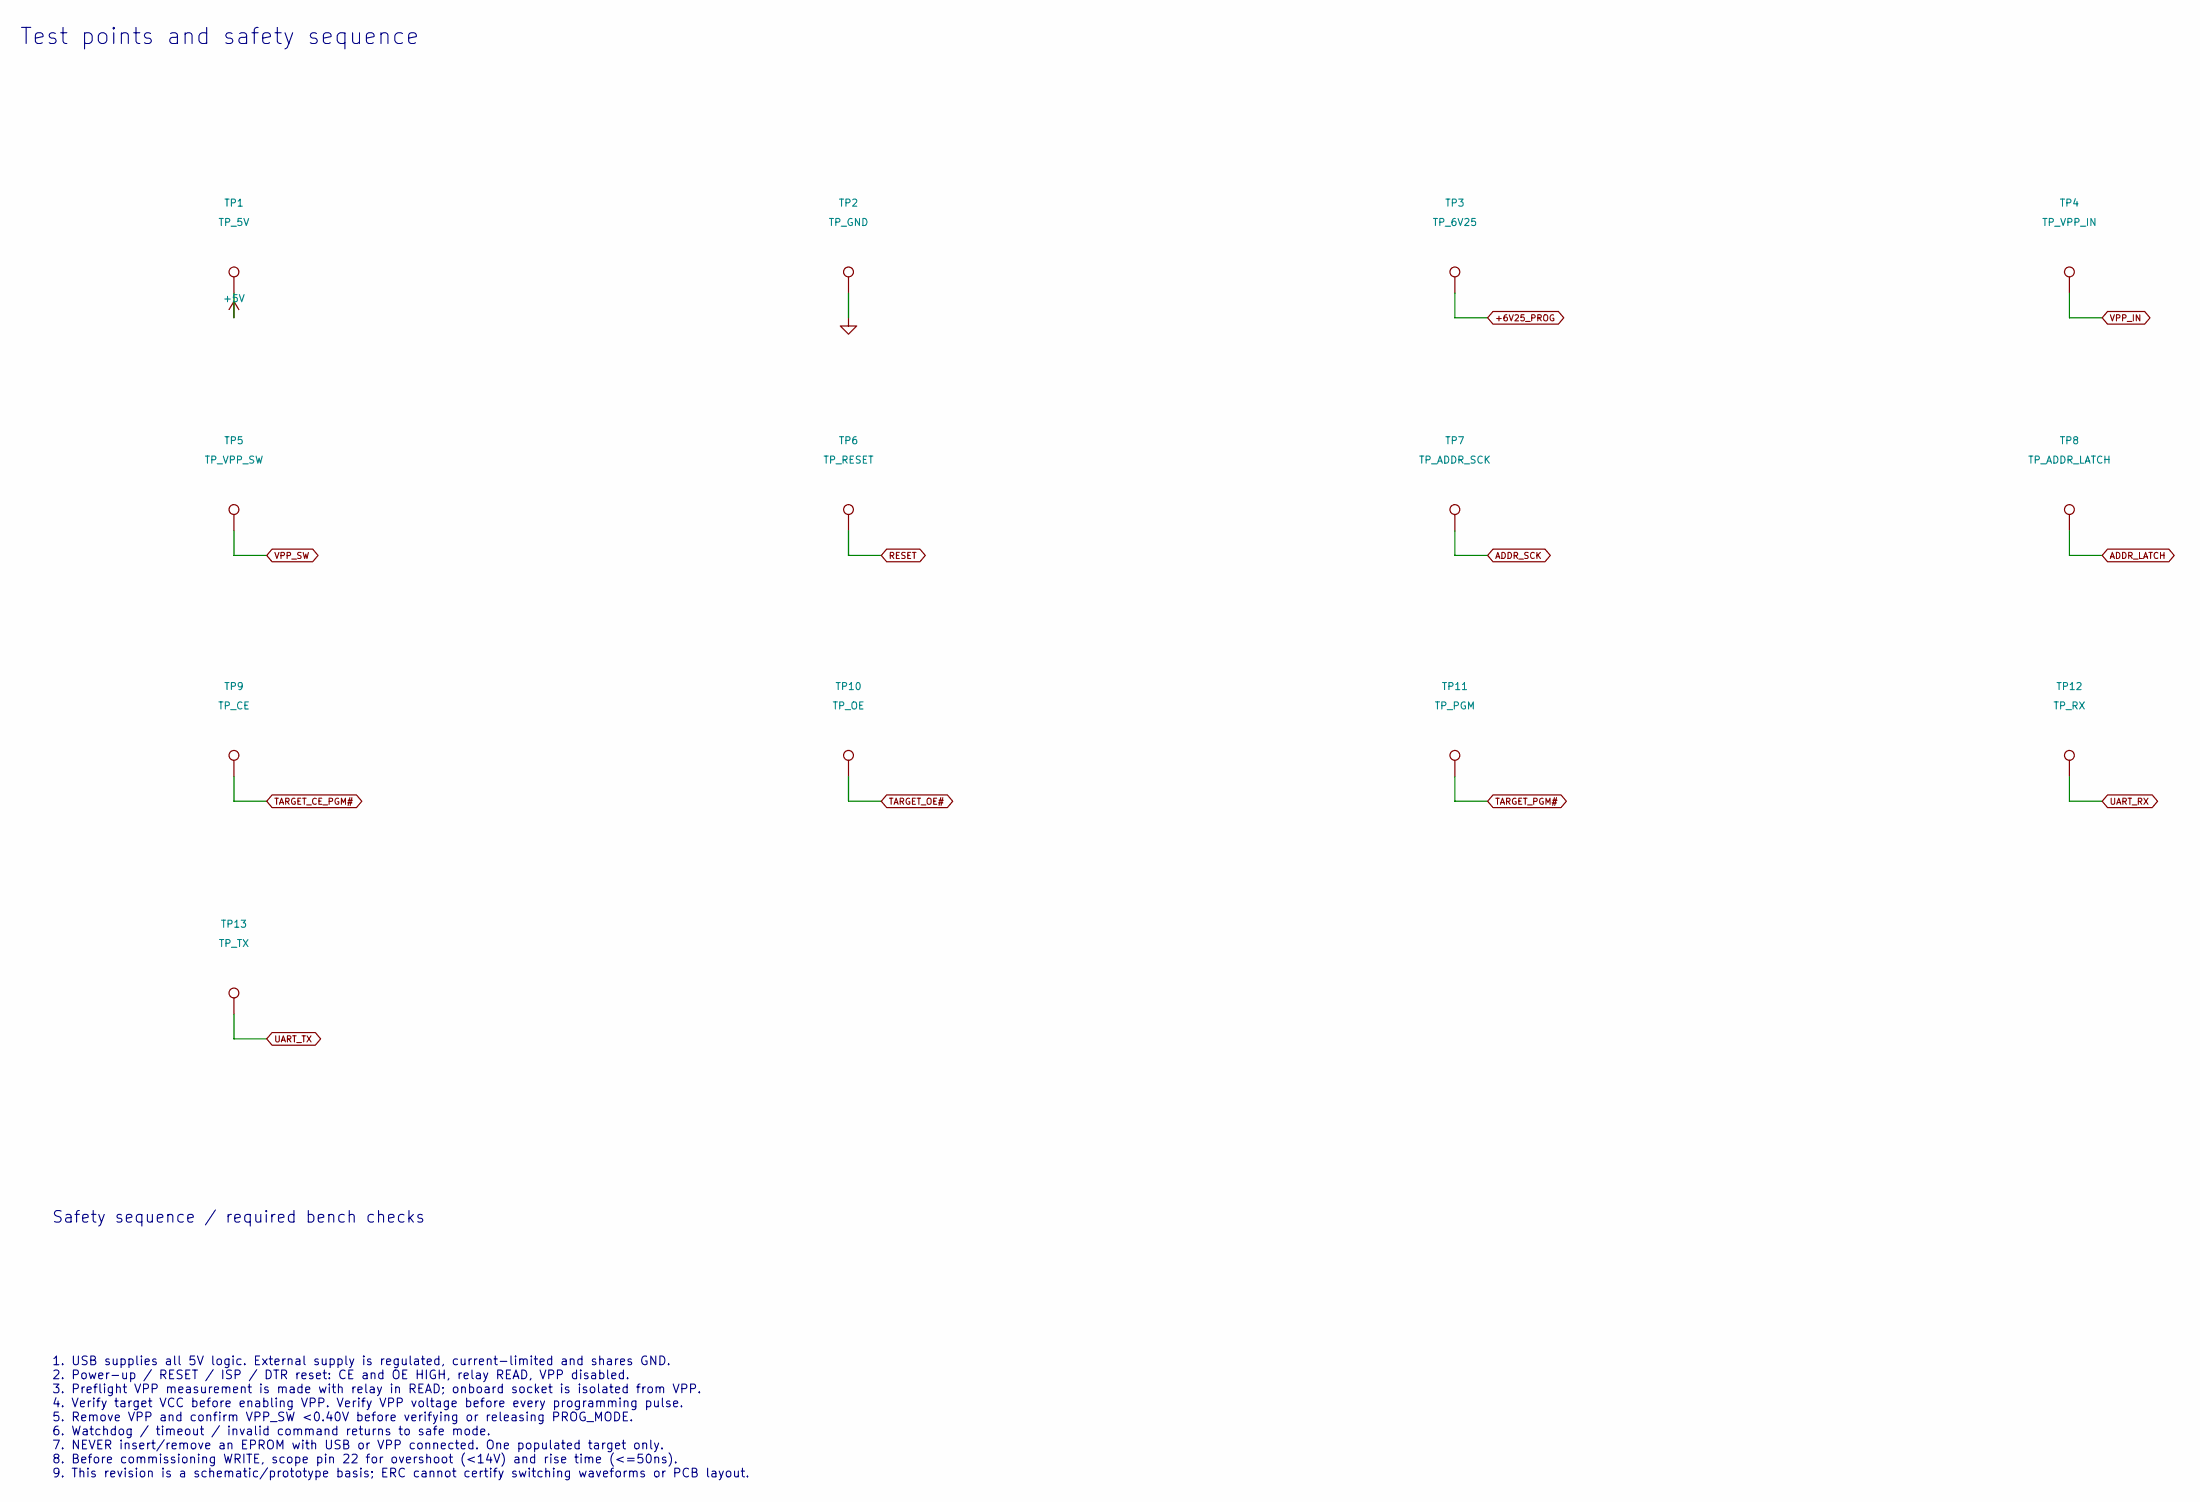
[picture p78: schematic testpoints_safety.kicad_sch, NM27C512 Dumper - Stage 2 Rev A]

Parts:
TP1: TP_5V; TestPoint_Pad_D1.5mm
TP2: TP_GND; TestPoint_Pad_D1.5mm
TP3: TP_6V25; TestPoint_Pad_D1.5mm
TP4: TP_VPP_IN; TestPoint_Pad_D1.5mm
TP5: TP_VPP_SW; TestPoint_Pad_D1.5mm
TP6: TP_RESET; TestPoint_Pad_D1.5mm
TP7: TP_ADDR_SCK; TestPoint_Pad_D1.5mm
TP8: TP_ADDR_LATCH; TestPoint_Pad_D1.5mm
TP9: TP_CE; TestPoint_Pad_D1.5mm
TP10: TP_OE; TestPoint_Pad_D1.5mm
TP11: TP_PGM; TestPoint_Pad_D1.5mm
TP12: TP_RX; TestPoint_Pad_D1.5mm
TP13: TP_TX; TestPoint_Pad_D1.5mm

Connections:
+5V: TP1.1 (1_1); also elsewhere on the board
+6V25_PROG: TP3.1 (1_1); also elsewhere on the board
ADDR_LATCH: TP8.1 (1_1); also elsewhere on the board
ADDR_SCK: TP7.1 (1_1); also elsewhere on the board
GND: TP2.1 (1_1); also elsewhere on the board
RESET: TP6.1 (1_1); also elsewhere on the board
TARGET_CE_PGM#: TP9.1 (1_1); also elsewhere on the board
TARGET_OE#: TP10.1 (1_1); also elsewhere on the board
TARGET_PGM#: TP11.1 (1_1); also elsewhere on the board
UART_RX: TP12.1 (1_1); also elsewhere on the board
UART_TX: TP13.1 (1_1); also elsewhere on the board
VPP_IN: TP4.1 (1_1); also elsewhere on the board
VPP_SW: TP5.1 (1_1); also elsewhere on the board

Notes on the sheet:
Test points and safety sequence
Safety sequence / required bench checks
1. USB supplies all 5V logic. External supply is regulated, current-limited and shares GND. 2. Power-up / RESET / ISP / DTR reset: CE and OE HIGH, relay READ, VPP disabled. 3. Preflight VPP measurement is made with relay in READ; onboard socket is isolated from VPP. 4. Verify target VCC before enab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

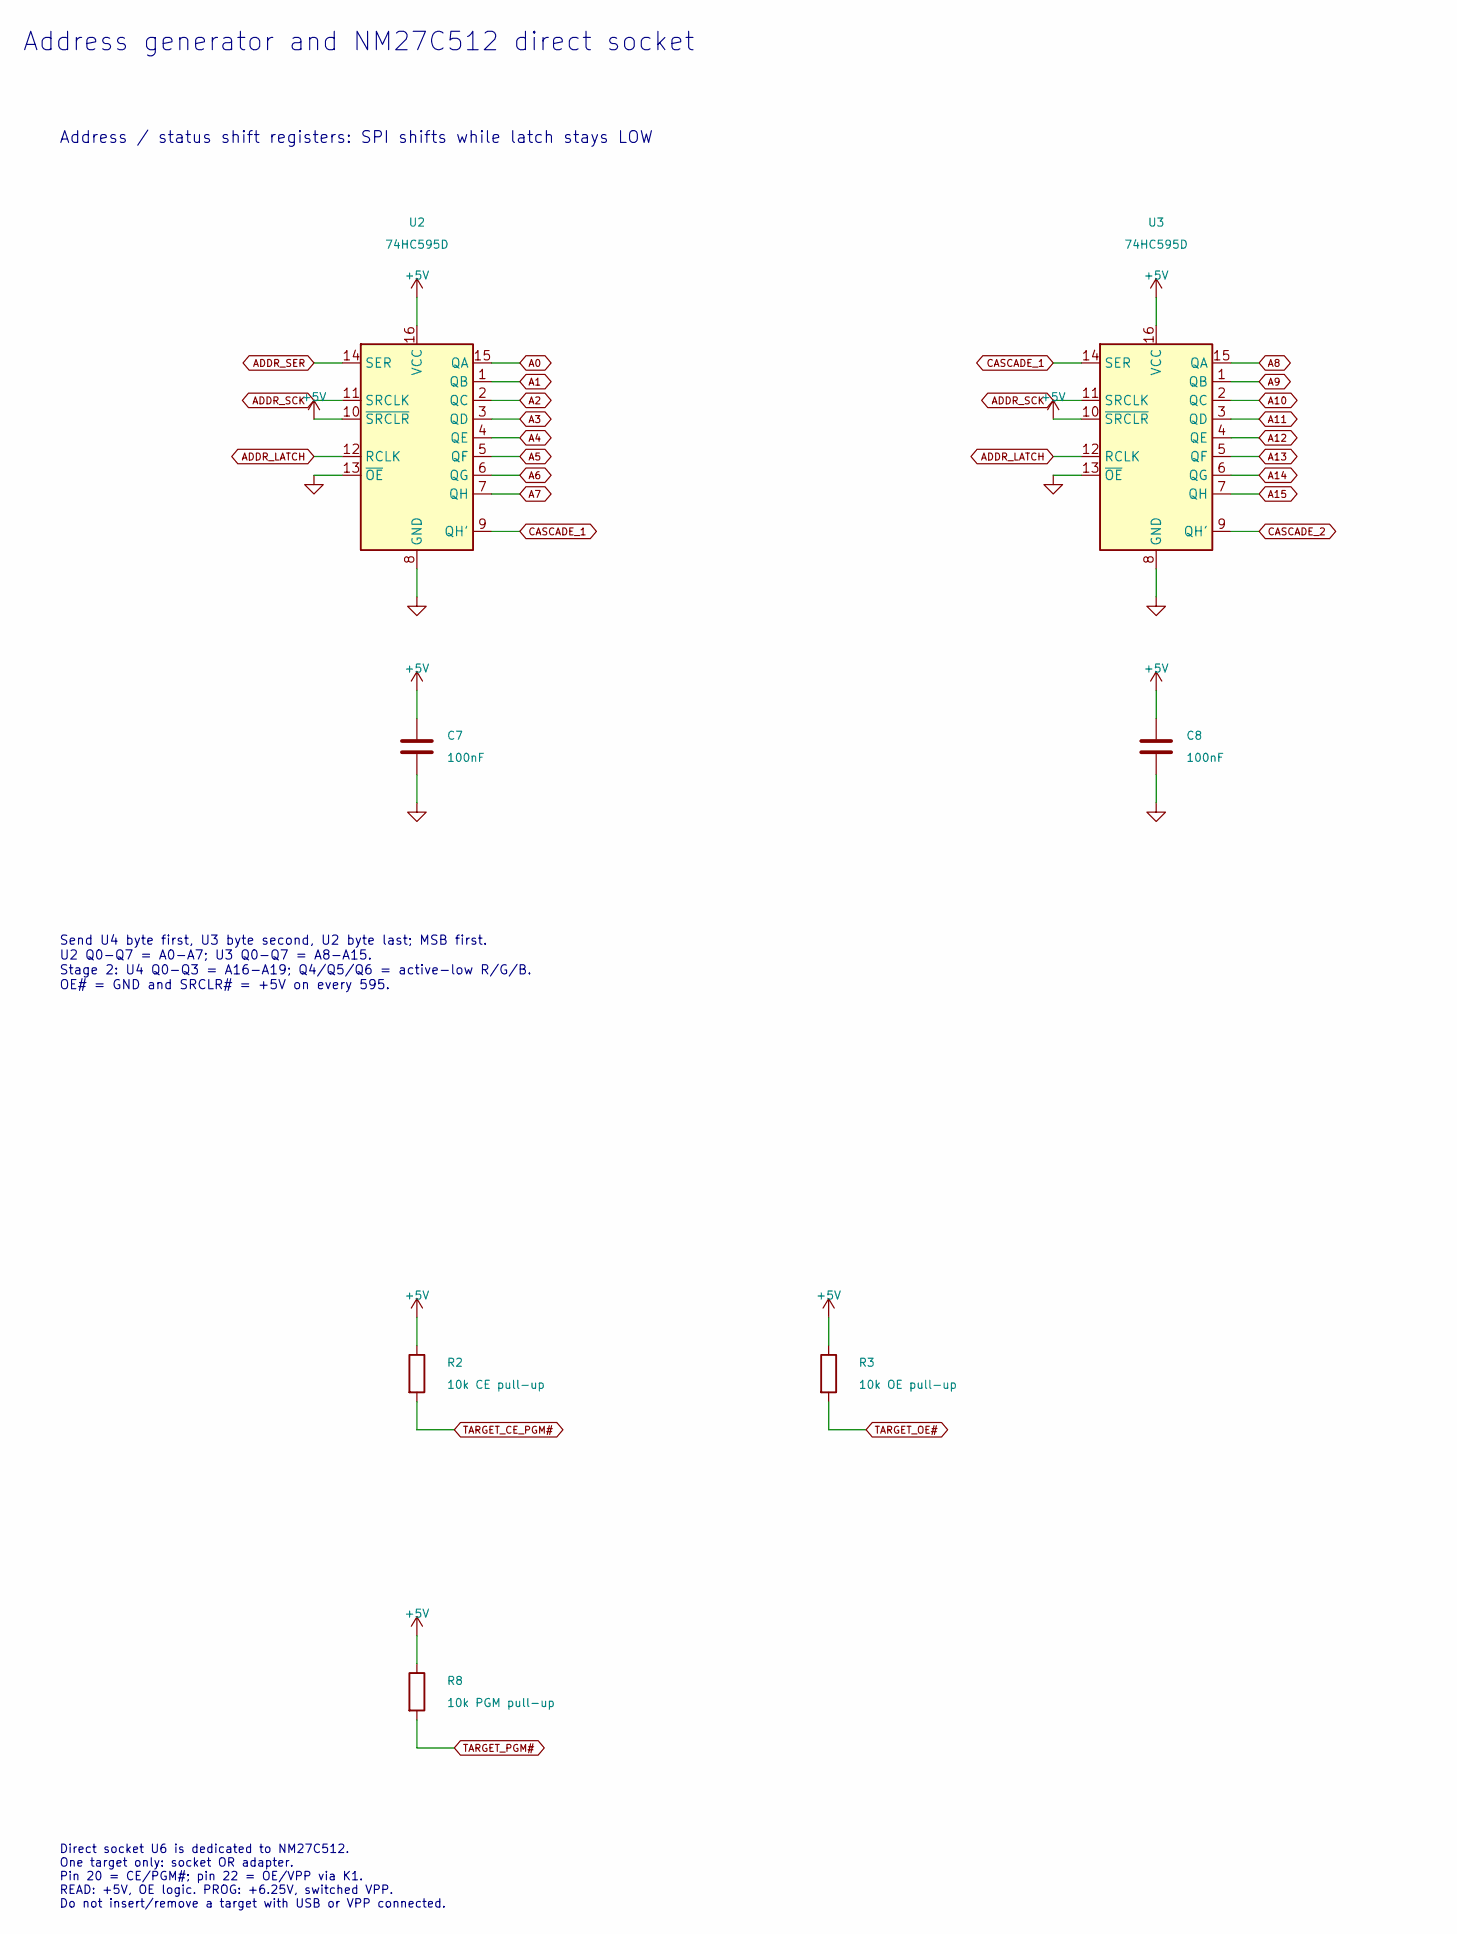
[picture p79: schematic address_target.kicad_sch, NM27C512 Dumper - Stage 2 Rev A, part in row 1, column 1]

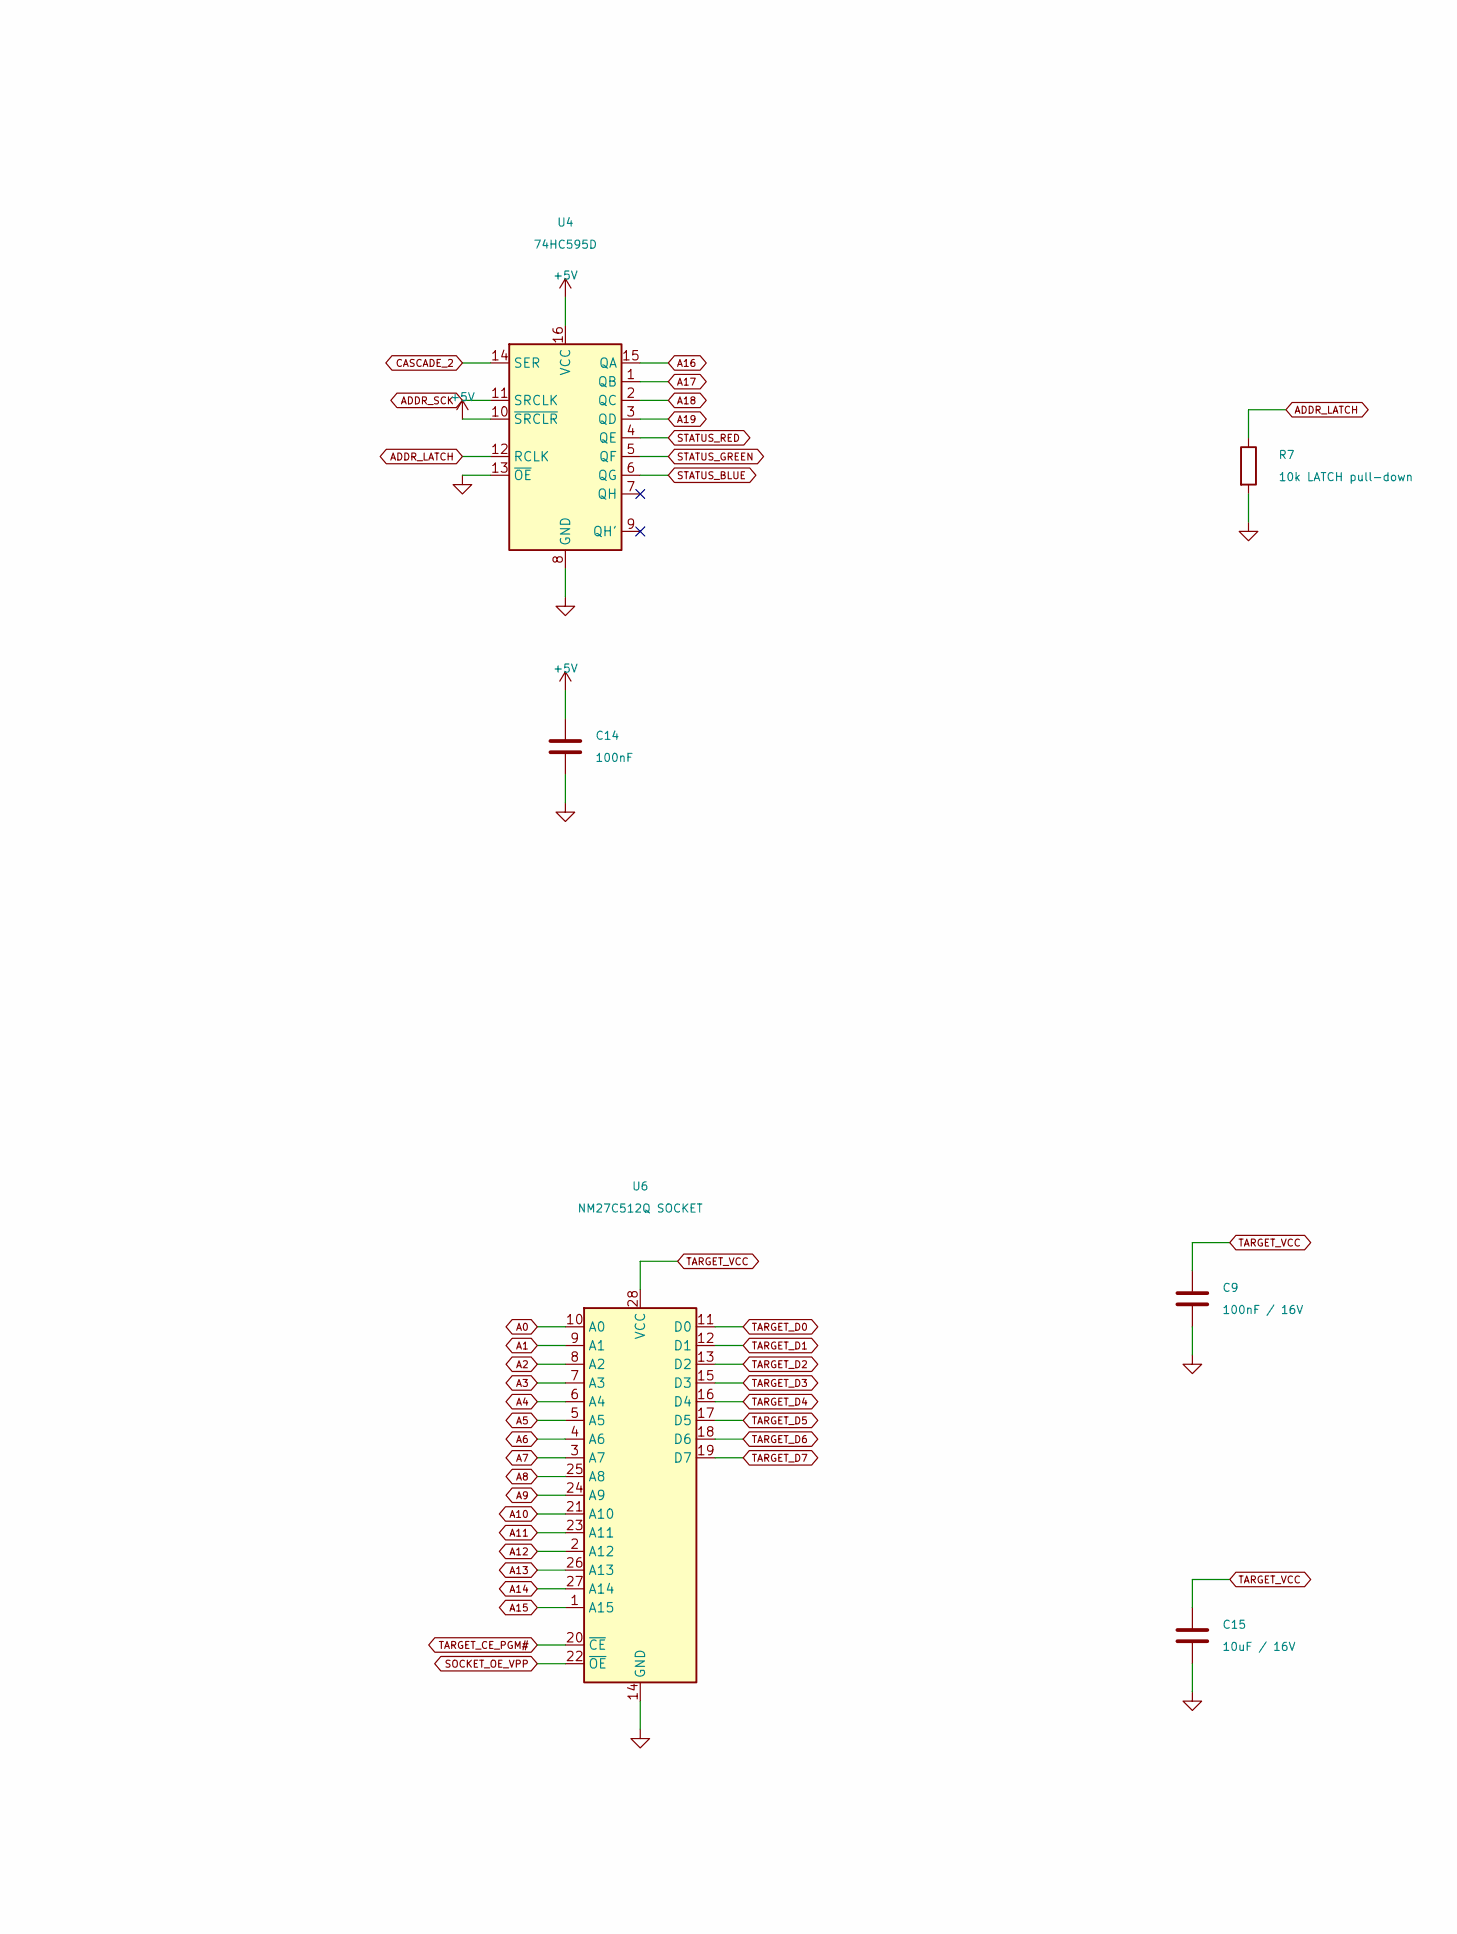
[picture p80: schematic address_target.kicad_sch, NM27C512 Dumper - Stage 2 Rev A, part in row 1, column 2]

Parts:
C7, C8, C14: 100nF; C_0603_1608Metric
C9: 100nF / 16V; C_0603_1608Metric
C15: 10uF / 16V; C_0805_2012Metric
R2: 10k CE pull-up; R_0603_1608Metric
R3: 10k OE pull-up; R_0603_1608Metric
R7: 10k LATCH pull-down; R_0603_1608Metric
R8: 10k PGM pull-up; R_0603_1608Metric
U2, U3, U4: 74HC595D; SOIC-16_3.9x9.9mm_P1.27mm
U6: NM27C512Q SOCKET; DIP-28_W15.24mm_Socket_LongPads

Connections:
+5V: C7.1, C8.1, C14.1, R2.1, R3.1, R8.1, U2.10 (~SRCLR), U2.16 (VCC), U3.10 (~SRCLR), U3.16 (VCC), U4.10 (~SRCLR), U4.16 (VCC); also elsewhere on the board
A0: U2.15 (QA), U6.10 (A0); also elsewhere on the board
A1: U2.1 (QB), U6.9 (A1); also elsewhere on the board
A2: U2.2 (QC), U6.8 (A2); also elsewhere on the board
A3: U2.3 (QD), U6.7 (A3); also elsewhere on the board
A4: U2.4 (QE), U6.6 (A4); also elsewhere on the board
A5: U2.5 (QF), U6.5 (A5); also elsewhere on the board
A6: U2.6 (QG), U6.4 (A6); also elsewhere on the board
A7: U2.7 (QH), U6.3 (A7); also elsewhere on the board
A8: U3.15 (QA), U6.25 (A8); also elsewhere on the board
A9: U3.1 (QB), U6.24 (A9); also elsewhere on the board
A10: U3.2 (QC), U6.21 (A10); also elsewhere on the board
A11: U3.3 (QD), U6.23 (A11); also elsewhere on the board
A12: U3.4 (QE), U6.2 (A12); also elsewhere on the board
A13: U3.5 (QF), U6.26 (A13); also elsewhere on the board
A14: U3.6 (QG), U6.27 (A14); also elsewhere on the board
A15: U3.7 (QH), U6.1 (A15); also elsewhere on the board
A16: U4.15 (QA); also elsewhere on the board
A17: U4.1 (QB); also elsewhere on the board
A18: U4.2 (QC); also elsewhere on the board
A19: U4.3 (QD); also elsewhere on the board
ADDR_LATCH: R7.1, U2.12 (RCLK), U3.12 (RCLK), U4.12 (RCLK); also elsewhere on the board
ADDR_SCK: U2.11 (SRCLK), U3.11 (SRCLK), U4.11 (SRCLK); also elsewhere on the board
ADDR_SER: U2.14 (SER); also elsewhere on the board
CASCADE_1: U2.9 (QH'), U3.14 (SER)
CASCADE_2: U3.9 (QH'), U4.14 (SER)
GND: C7.2, C8.2, C9.2, C14.2, C15.2, R7.2, U2.8 (GND), U2.13 (~OE), U3.8 (GND), U3.13 (~OE), U4.8 (GND), U4.13 (~OE), U6.14 (GND); also elsewhere on the board
SOCKET_OE_VPP: U6.22 (~OE); also elsewhere on the board
STATUS_BLUE: U4.6 (QG); also elsewhere on the board
STATUS_GREEN: U4.5 (QF); also elsewhere on the board
STATUS_RED: U4.4 (QE); also elsewhere on the board
TARGET_CE_PGM#: R2.2, U6.20 (~CE); also elsewhere on the board
TARGET_D0: U6.11 (D0); also elsewhere on the board
TARGET_D1: U6.12 (D1); also elsewhere on the board
TARGET_D2: U6.13 (D2); also elsewhere on the board
TARGET_D3: U6.15 (D3); also elsewhere on the board
TARGET_D4: U6.16 (D4); also elsewhere on the board
TARGET_D5: U6.17 (D5); also elsewhere on the board
TARGET_D6: U6.18 (D6); also elsewhere on the board
TARGET_D7: U6.19 (D7); also elsewhere on the board
TARGET_OE#: R3.2; also elsewhere on the board
TARGET_PGM#: R8.2; also elsewhere on the board
TARGET_VCC: C9.1, C15.1, U6.28 (VCC); also elsewhere on the board

Notes on the sheet:
Address / status shift registers: SPI shifts while latch stays LOW
Send U4 byte first, U3 byte second, U2 byte last; MSB first. U2 Q0-Q7 = A0-A7; U3 Q0-Q7 = A8-A15. Stage 2: U4 Q0-Q3 = A16-A19; Q4/Q5/Q6 = active-low R/G/B. OE# = GND and SRCLR# = +5V on every 595.
Direct socket U6 is dedicated to NM27C512. One target only: socket OR adapter. Pin 20 = CE/PGM#; pin 22 = OE/VPP via K1. READ: +5V, OE logic. PROG: +6.25V, switched VPP. Do not insert/remove a target with USB or VPP connected.
Address generator and NM27C512 direct socket

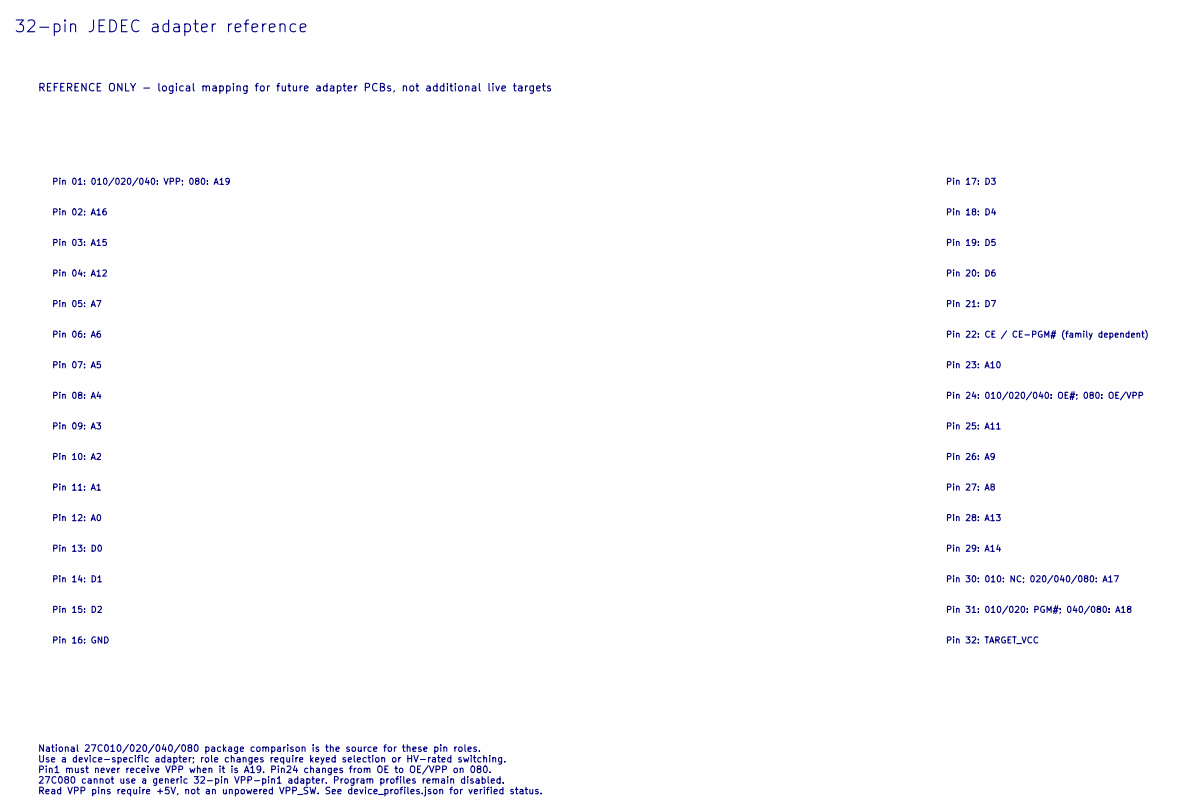
[picture p81: schematic adapter_32pin_JEDEC.kicad_sch, NM27C512 Dumper - Stage 2 Rev A]

Notes on the sheet:
Pin 23: A10
Pin 14: D1
Pin 22: CE / CE-PGM# (family dependent)
Pin 18: D4
Pin 08: A4
Pin 09: A3
Pin 10: A2
Pin 27: A8
Pin 07: A5
32-pin JEDEC adapter reference
Pin 19: D5
Pin 11: A1
Pin 17: D3
Pin 05: A7
Pin 25: A11
National 27C010/020/040/080 package comparison is the source for these pin roles. Use a device-specific adapter; role changes require keyed selection or HV-rated switching. Pin1 must never receive VPP when it is A19. Pin24 changes from OE to OE/VPP on 080. 27C080 cannot use a generic 32-pin VPP-pin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
Pin 02: A16
Pin 01: 010/020/040: VPP; 080: A19
Pin 06: A6
Pin 15: D2
Pin 29: A14
Pin 32: TARGET_VCC
Pin 28: A13
Pin 20: D6
Pin 31: 010/020: PGM#; 040/080: A18
Pin 03: A15
Pin 04: A12
Pin 13: D0
REFERENCE ONLY - logical mapping for future adapter PCBs, not additional live targets
Pin 12: A0
Pin 21: D7
Pin 26: A9
Pin 30: 010: NC; 020/040/080: A17
Pin 24: 010/020/040: OE#; 080: OE/VPP
Pin 16: GND

Board: 2 copper layers, 143 parts (0 on the bottom side), 113 nets, no tracks yet.
